wakimizufu/MC2/debugVCFSeparate/VCF_CV_antilog_1.png

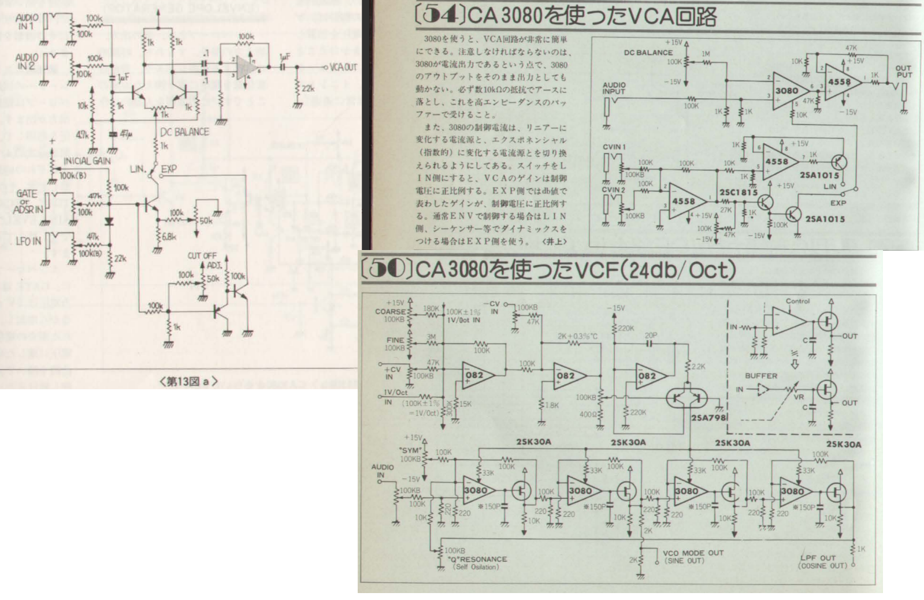
debugVCFSeparate/VCF_CV_antilog_1.png
