wakimizufu/MC2/EG_MC2.X/pinout.png

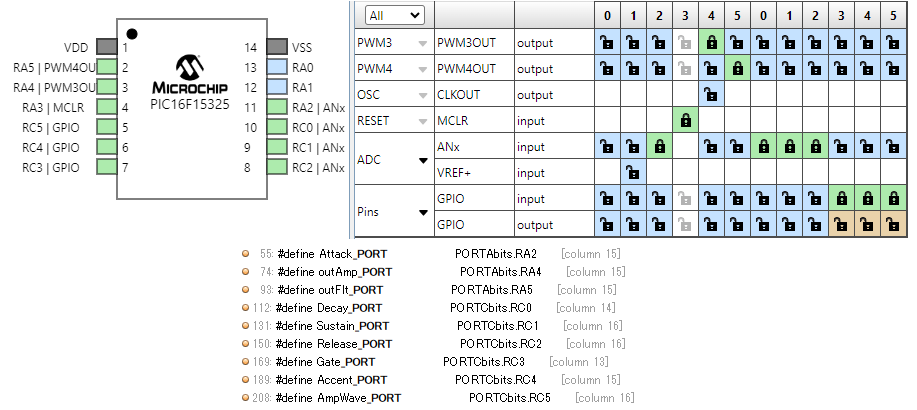
EG_MC2.X/pinout.png
