wakimizufu/MC2/LFO_MC2.X/pinout.png

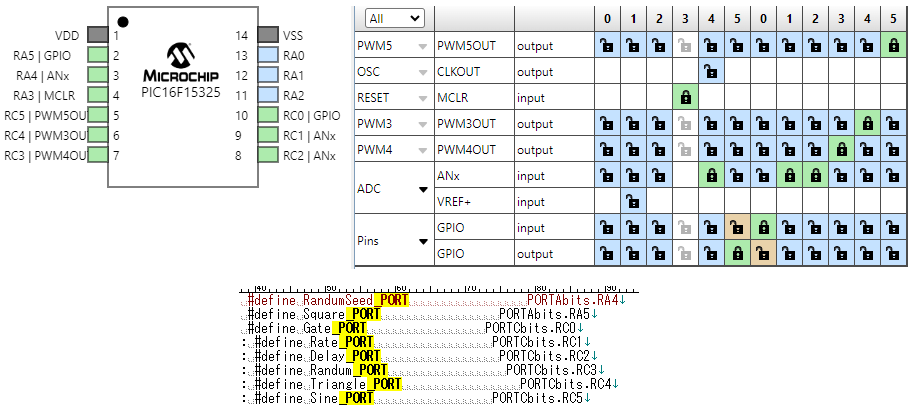
LFO_MC2.X/pinout.png
