wakimizufu/MC2/SynthBoard_Left/production/PCBAList.png

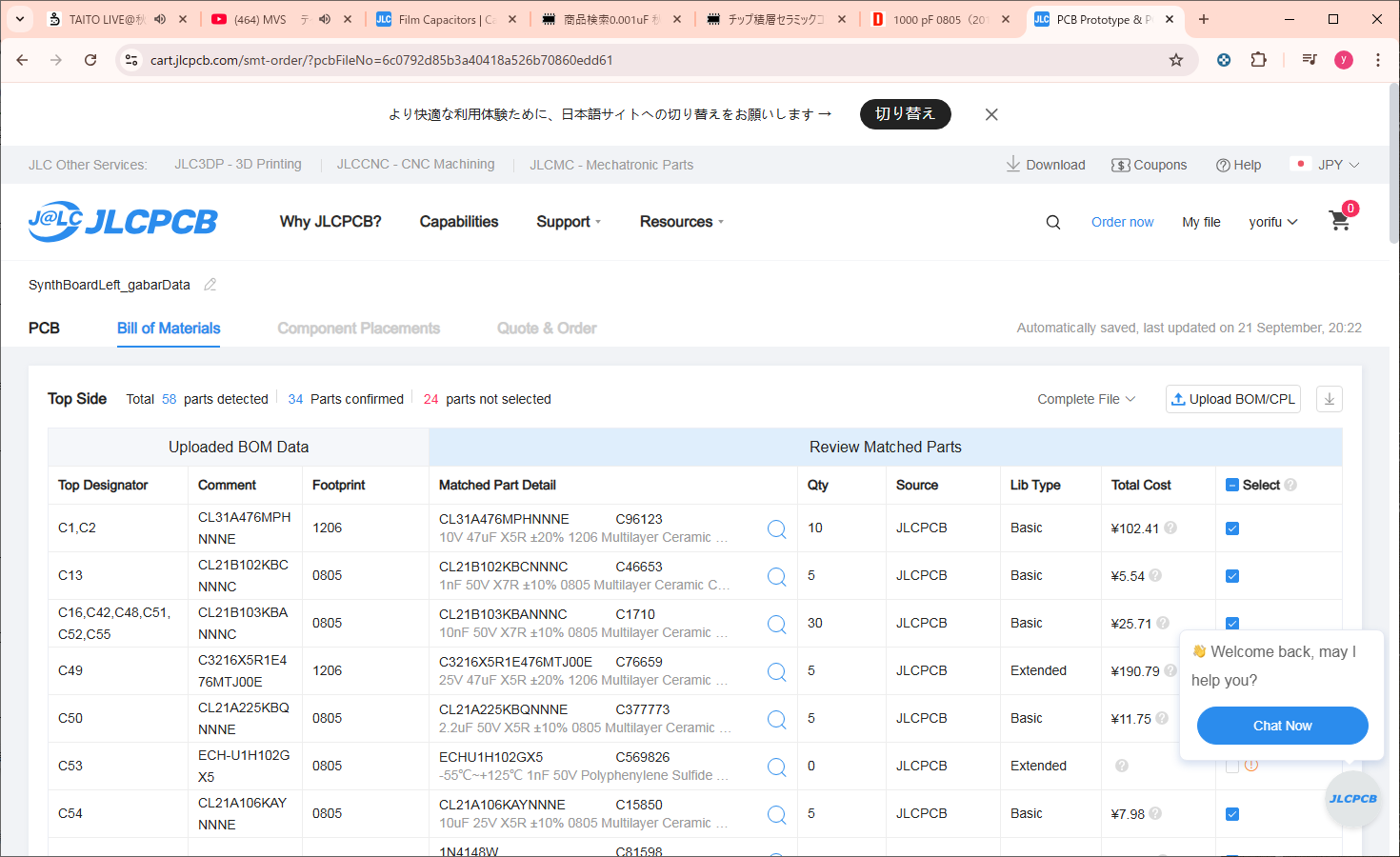
SynthBoard_Left/production/PCBAList.png
