wakimizufu/MC2/SynthBoard_Left/production/拡張部品リストアップ_20250921.txt

----------------------------------------------------------------------------
C49
C3216X5R1E476MTJ00E
1206
C3216X5R1E476MTJ00E
C76659
25V 47uF X5R ±20% 1206 Multilayer Ceramic Capacitors MLCC - SMD/SMT ROHS
5
JLCPCB
Extended
¥190.79 

----------------------------------------------------------------------------
C53
ECH-U1H102GX5
0805
ECHU1H102GX5
C569826
-55℃~+125℃ 1nF 50V Polyphenylene Sulfide (PPS) ±2% 0805 Film Capacitors ROHS
0
JLCPCB
Extended

----------------------------------------------------------------------------
C17,C18,C19
GRM21B5C2E103FWAA
0805
No Part Selected
Search 
Pre-order

----------------------------------------------------------------------------
IC4,IC6
AS321KTR-G1
SOT95P282X145-5N
AS321KTR-G1
C144156
-18V~-1.5V -40℃~+85℃ 1 20nA 2mV 30nA 350uA 36V 3V~36V 40mA 70dB 7uV/℃ SOT-23-5 Operational Amplifier ROHS
14
JLCPCB
拡張
$0.9268 

----------------------------------------------------------------------------
IC7
HEF4013BT,653
SOIC-14_3.9x8.7mm_P1.27mm
HEF4013BT,653
C6726
-40℃~+125℃ 1 2 3.4mA 3.4mA 3V~15V 4000B Series 40MHz 4uA 60ns@15V,50pF 7.5pF Asynchronous Complementary D-Type Rising Edge Set and Reset SOIC-14 Flip Flops ROHS
5
JLCPCB
拡張
$0.6625 

----------------------------------------------------------------------------
U1
TJM4558CDT
SOIC-8_3.9x4.9mm_P1.27mm
TJM4558CDT
C6955
-15V~15V 0℃~+70℃ 12nV/√Hz@1kHz 1mV 2 2.2V/us 2.3mA 20mA 20nA 30V 5.5MHz 50nA 90dB SOIC-8 Operational Amplifier ROHS
5
JLCPCB
拡張
¥53.65 

----------------------------------------------------------------------------
VR20,VR21
3362P-1-503LF
3362P_1
3362P-1-503LF
C81264
1 500mW 50kΩ ±10% ±100ppm/℃ Plugin-3P,7x6.6mm Potentiometers, Variable Resistors ROHS
10
JLCPCB
拡張
¥492.12 

----------------------------------------------------------------------------
VR27
3362P-1-501LF
3362P_1
3362P-1-501LF
C81262
1 500mW 500Ω ±10% ±100ppm/℃ Plugin-3P,7x6.6mm Potentiometers, Variable Resistors ROHS
5
JLCPCB
拡張
¥297.04 

----------------------------------------------------------------------------
D2
LED
LED_D5.0mm_FlatTop
部品選択なし
検索 
予約発注

----------------------------------------------------------------------------
IC5
V3340M
SOP-16_3.9x9.9mm_P1.27mm
部品選択なし
検索 
予約発注
J1
DigiInput
PinSocket_1x05_P2.54mm_Vertical
部品選択なし
検索 
予約発注

----------------------------------------------------------------------------
J2
ICSPLFO
PinHeader_1x05_P2.54mm_Vertical
部品選択なし
検索 
予約発注

----------------------------------------------------------------------------
J3
D_Power
PinSocket_1x02_P2.54mm_Vertical
部品選択なし
検索 
予約発注

----------------------------------------------------------------------------
J4
VCOOut
PinSocket_2x07_P2.54mm_Vertical
部品選択なし
検索 
予約発注

----------------------------------------------------------------------------
J6
A_Power
PinHeader_1x06_P2.54mm_Vertical
部品選択なし
検索 
予約発注

----------------------------------------------------------------------------
J7
LFO
PinSocket_2x03_P2.54mm_Vertical
部品選択なし
検索 
予約発注

----------------------------------------------------------------------------
R25
390K
R_Axial_DIN0207_L6.3mm_D2.5mm_P7.62mm_Horizontal
部品選択なし
検索 
予約発注

----------------------------------------------------------------------------
R186,R187
470K
R_Axial_DIN0207_L6.3mm_D2.5mm_P7.62mm_Horizontal
部品選択なし
検索 
予約発注

----------------------------------------------------------------------------
R188
1M
R_Axial_DIN0207_L6.3mm_D2.5mm_P7.62mm_Horizontal
部品選択なし
検索 
予約発注

----------------------------------------------------------------------------
S1,S2
MS2301L6
MS2301L6
部品選択なし
検索 
予約発注

----------------------------------------------------------------------------
SW1
MFP_2424
MFP2424
部品選択なし
検索 
予約発注

----------------------------------------------------------------------------
U7
MCP6234T-E/SL
SOIC-14_3.9x8.7mm_P1.27mm
部品選択なし
検索 
予約発注

----------------------------------------------------------------------------
VR1
Tune10KB
RK09D117000B
部品選択なし
検索 
予約発注

----------------------------------------------------------------------------
VR2
PWMDuty10KB
PTA20432010CIB104
部品選択なし
検索 
予約発注

----------------------------------------------------------------------------
VR3
Triangle100KB
PTA20432010CIB104
部品選択なし
検索 
予約発注

----------------------------------------------------------------------------
VR4
Rate100KB
PTA20432010CIB104
部品選択なし
検索 
予約発注

----------------------------------------------------------------------------
VR5
Delay100KB
PTA20432010CIB104
部品選択なし
検索 
予約発注

----------------------------------------------------------------------------
VR6
Saw100KB
PTA20432010CIB104
部品選択なし
検索 
予約発注

----------------------------------------------------------------------------
VR7
Mod100KA
PTA20432010CIB104
部品選択なし
検索 
予約発注

----------------------------------------------------------------------------
VR8
SubSquare10KB
PTA20432010CIB104
部品選択なし
検索 
予約発注

----------------------------------------------------------------------------
VR9
Square10KB
PTA20432010CIB104
部品選択なし
検索 
予約発注
