wakimizufu/MC2/SynthBoard_Right/production/拡張部品リストアップ_20250921.txt

--------------------------------------------------------------------------------
C10,C11,C4,C8
ECH-U1H221JX5
0805
ECHU1H221JX5
C178426
-55℃~+125℃ 220pF 50V Metallized PPS ±5% 0805 Film Capacitors ROHS
0
JLCPCB
拡張

--------------------------------------------------------------------------------
IC1,IC2
AS321KTR-G1
SOT95P282X145-5N
AS321KTR-G1
C144156
-18V~-1.5V -40℃~+85℃ 1 20nA 2mV 30nA 350uA 36V 3V~36V 40mA 70dB 7uV/℃ SOT-23-5 Operational Amplifier ROHS
14
JLCPCB
拡張
¥137.12

--------------------------------------------------------------------------------
U2,U5,U8
LM13700
SOIC-16_3.9x9.9mm_P1.27mm
LM13700MX/NOPB
C174050
0℃~+70℃ 100nA 110dB 2 20mA 300uA 36V 4.75V~16V 400nA 400uV 50V/us 9.5V~32V SOIC-16 Operational Amplifier ROHS
0
JLCPCB
拡張

--------------------------------------------------------------------------------
VR10
3362P-1-503LF
3362P_1
3362P-1-503LF
C81264
1 500mW 50kΩ ±10% ±100ppm/℃ Plugin-3P,7x6.6mm Potentiometers, Variable Resistors ROHS
5
JLCPCB
拡張
¥299.60 

--------------------------------------------------------------------------------
VR16,VR17
3362P-1-103LF
3362P_1
3362P-1-103LF
C58159
1 10kΩ 500mW ±10% ±100ppm/℃ Plugin-3P,7x6.6mm Potentiometers, Variable Resistors ROHS
10
JLCPCB
拡張
¥395.03 

--------------------------------------------------------------------------------
VR19
3362P-1-104LF
3362P_1
3362P-1-104LF
C81266
1 100kΩ 500mW ±10% ±100ppm/℃ Plugin-3P,7x6.6mm Potentiometers, Variable Resistors ROHS
5
JLCPCB
拡張
¥291.83 

--------------------------------------------------------------------------------
U9
MCP6232-E_P
SOIC-8_3.9x4.9mm_P1.27mm
MCP6232-E/P
C640423
-40℃~+125℃ 1.8V~6V 150V/ms 1pA 2 3uV/℃ 52nV/√Hz@1kHz 5mV 75dB 7V PDIP-8 Operational Amplifier ROHS
5
拡張

--------------------------------------------------------------------------------
Q2,Q3,Q4,Q5
2SA1162-GR_F_
1SS294LFT
部品選択なし
検索 
予約発注

--------------------------------------------------------------------------------
S3
MS2201L6
MS2201L6
部品選択なし
検索 
予約発注

--------------------------------------------------------------------------------
VR11
Mod100KA
PTA20432010CIB104
部品選択なし
検索 
予約発注

--------------------------------------------------------------------------------
VR12
KYBD100KB
PTA20432010CIB104
部品選択なし
検索 
予約発注

--------------------------------------------------------------------------------
VR13
Env100KB
PTA20432010CIB104
部品選択なし
検索 
予約発注

--------------------------------------------------------------------------------
VR14
Volume100KA
RK09D117000B
部品選択なし
検索 
予約発注

--------------------------------------------------------------------------------
VR15
Freq100KB
PTA20432010CIB104
部品選択なし
検索 
予約発注

--------------------------------------------------------------------------------
VR18
Resonance100KB
PTA20432010CIB104
部品選択なし
検索 
予約発注

--------------------------------------------------------------------------------
VR22
AccLevel10KB
RK09D117000B
部品選択なし
検索 
予約発注

--------------------------------------------------------------------------------
VR23
Attack100KA
PTA20432010CIB104
部品選択なし
検索 
予約発注

--------------------------------------------------------------------------------
VR24
Decay100KA
PTA20432010CIB104
部品選択なし
検索 
予約発注

--------------------------------------------------------------------------------
VR25
Sustain100KB
PTA20432010CIB104
部品選択なし
検索 
予約発注

--------------------------------------------------------------------------------
VR26
Release100KA
PTA20432010CIB104
部品選択なし
検索 
予約発注
