wakimizufu/MC2/SynthBoard_Left/production/拡張部品リストアップ_20250920.txt

----------------------------------------------------------------------------
C1,C2
EMK316BBJ476ML-T
1206
EMK316BBJ476ML-T
C385907
16V 47uF X5R �}20% 1206 Multilayer Ceramic Capacitors MLCC - SMD/SMT ROHS
12
JLCPCB
Šg’£
$1.5684 

----------------------------------------------------------------------------
C13,C53
CL21C102JBCNNNC
0805
CL21C102JBCNNNC
C1791
1nF 50V C0G �}5% 0805 Multilayer Ceramic Capacitors MLCC - SMD/SMT ROHS
20
JLCPCB
Šg’£
$0.1600 

----------------------------------------------------------------------------
C16,C17,C18,C19,C42,C48,C51,C52,C55
0805B103J500NT
0805
0805B103J500NT
C24666
10nF 50V X7R �}5% 0805 Multilayer Ceramic Capacitors MLCC - SMD/SMT ROHS
55
JLCPCB
Šg’£
$0.4235 
C49
C3216X5R1E476MTJ00E
1206
C3216X5R1E476MTJ00E
C76659
25V 47uF X5R �}20% 1206 Multilayer Ceramic Capacitors MLCC - SMD/SMT ROHS
5
JLCPCB
Šg’£
$1.2910 

----------------------------------------------------------------------------
C50
CL21B225KAFNNNE
0805
CL21B225KAFNNNE
C19110
2.2uF 25V X7R �}10% 0805 Multilayer Ceramic Capacitors MLCC - SMD/SMT ROHS
20
JLCPCB
Šg’£
$0.2440

----------------------------------------------------------------------------
IC4,IC6
AS321KTR-G1
SOT95P282X145-5N
AS321KTR-G1
C144156
-18V~-1.5V -40�Ž~+85�Ž 1 20nA 2mV 30nA 350uA 36V 3V~36V 40mA 70dB 7uV/�Ž SOT-23-5 Operational Amplifier ROHS
14
JLCPCB
Šg’£
$0.9268 

----------------------------------------------------------------------------
IC7
HEF4013BT,653
SOIC-14_3.9x8.7mm_P1.27mm
HEF4013BT,653
C6726
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
U1
TJM4558CDT
SOIC-8_3.9x4.9mm_P1.27mm
TJM4558CDT
C6955
-15V~15V 0�Ž~+70�Ž 12nV/�ãHz@1kHz 1mV 2 2.2V/us 2.3mA 20mA 20nA 30V 5.5MHz 50nA 90dB SOIC-8 Operational Amplifier ROHS
5
JLCPCB
Šg’£
$0.3630 
----------------------------------------------------------------------------
