wakimizufu/MC2/SynthBoard_Left/production/cart.jlcpcb.com_smt-order__pcbFileNo=6c0792d85b3a40418a526b70860edd61.png

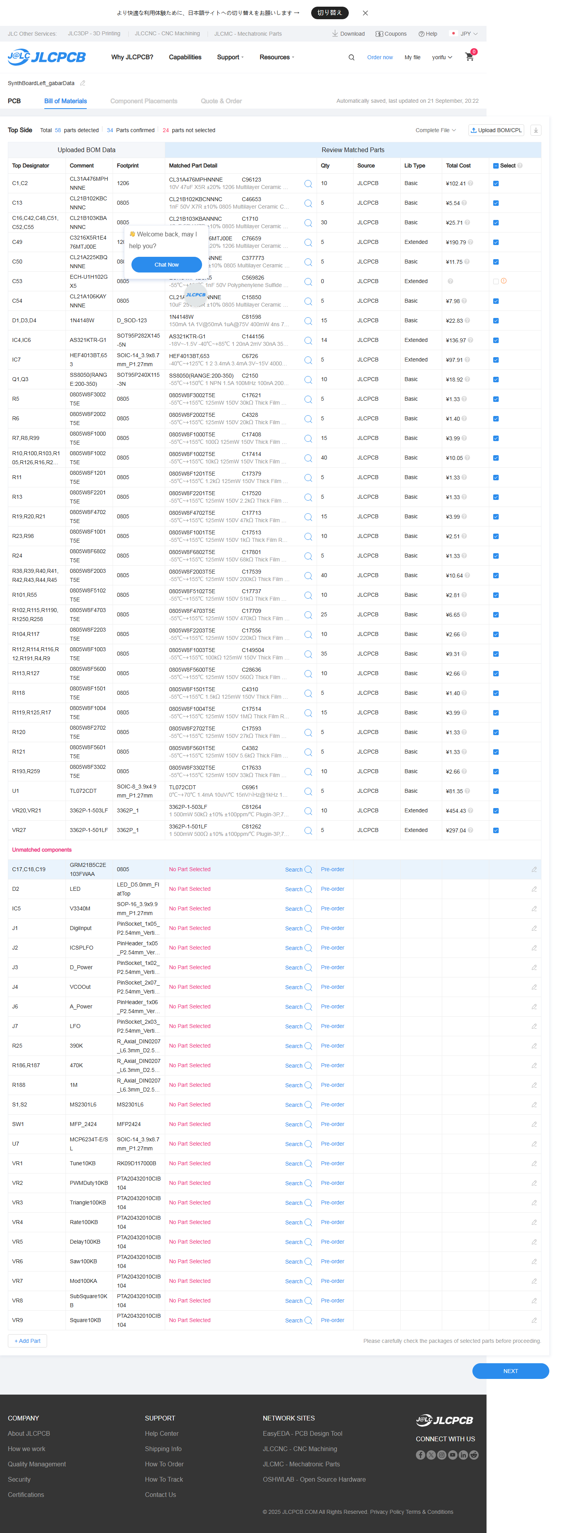
SynthBoard_Left/production/cart.jlcpcb.com_smt-order__pcbFileNo=6c0792d85b3a40418a526b70860edd61.png
