wakimizufu/MC2/SynthBoard_Right/production/cart.jlcpcb.com_jp_smt-order__pcbFileNo=1719c2208b6c4ed196fbf762d8c76614.png

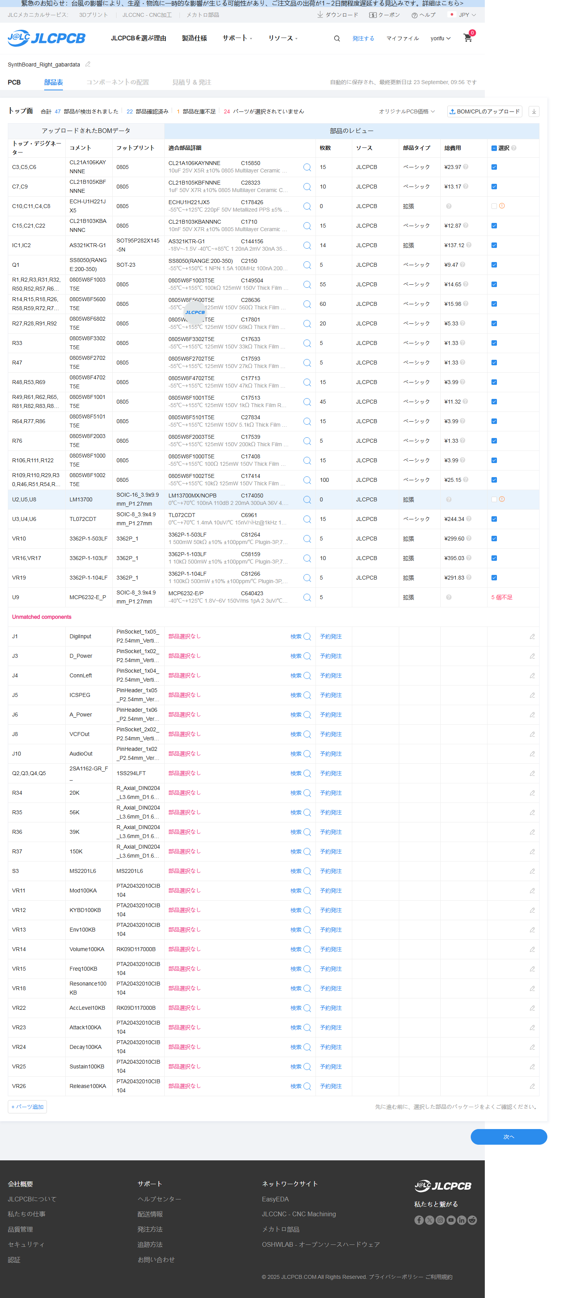
SynthBoard_Right/production/cart.jlcpcb.com_jp_smt-order__pcbFileNo=1719c2208b6c4ed196fbf762d8c76614.png
