wakimizufu/MC2/EGACC_MC2.X/queuelogs/debugtool.txt

2156 1759402637052 XXXX 1759402637052, Thread 2156: XXXX 1759402637052, Exiting Thread 2156: Commands::runScriptBasic  
2156 1759402637153 XXXX 1759402637153, Thread 2156: XXXX 1759402637153, Entering Thread 2156: Commands::runScriptBasic, script name = GetHaltStatus, timeOut = -1 ms  
2156 1759402637153 XXXX 1759402637153, Thread 2156: XXXX 1759402637153, Exiting Thread 2156: Commands::runScriptBasic  
2156 1759402637254 XXXX 1759402637254, Thread 2156: XXXX 1759402637254, Entering Thread 2156: Commands::runScriptBasic, script name = GetHaltStatus, timeOut = -1 ms  
2156 1759402637255 XXXX 1759402637255, Thread 2156: XXXX 1759402637255, Exiting Thread 2156: Commands::runScriptBasic  
2156 1759402637355 XXXX 1759402637355, Thread 2156: XXXX 1759402637355, Entering Thread 2156: Commands::runScriptBasic, script name = GetHaltStatus, timeOut = -1 ms  
2156 1759402637356 XXXX 1759402637356, Thread 2156: XXXX 1759402637356, Exiting Thread 2156: Commands::runScriptBasic  
2156 1759402637456 XXXX 1759402637456, Thread 2156: XXXX 1759402637456, Entering Thread 2156: Commands::runScriptBasic, script name = GetHaltStatus, timeOut = -1 ms  
2156 1759402637458 XXXX 1759402637458, Thread 2156: XXXX 1759402637458, Exiting Thread 2156: Commands::runScriptBasic  
2156 1759402637556 XXXX 1759402637556, Thread 2156: XXXX 1759402637556, Entering Thread 2156: Commands::runScriptBasic, script name = GetHaltStatus, timeOut = -1 ms  
2156 1759402637557 XXXX 1759402637557, Thread 2156: XXXX 1759402637557, Exiting Thread 2156: Commands::runScriptBasic  
2156 1759402637657 XXXX 1759402637657, Thread 2156: XXXX 1759402637657, Entering Thread 2156: Commands::runScriptBasic, script name = GetHaltStatus, timeOut = -1 ms  
2156 1759402637658 XXXX 1759402637658, Thread 2156: XXXX 1759402637658, Exiting Thread 2156: Commands::runScriptBasic  
2156 1759402637758 XXXX 1759402637758, Thread 2156: XXXX 1759402637758, Entering Thread 2156: Commands::runScriptBasic, script name = GetHaltStatus, timeOut = -1 ms  
2156 1759402637759 XXXX 1759402637759, Thread 2156: XXXX 1759402637759, Exiting Thread 2156: Commands::runScriptBasic  

2156 1759402637797 GEN4_TO_CONTROLLER_LOG:GEN4_DEBUG_INT_LOG_PIC16F13145 Pre:HaltTarget
2156 1759402637797 GEN4_TO_CONTROLLER_LOG:GEN4_DEBUG_INT_LOG_PIC16F13145 Payload
2156 1759402637797 GEN4_TO_CONTROLLER_LOG:GEN4_DEBUG_INT_LOG_PIC16F13145 null
2156 1759402637797 GEN4_TO_CONTROLLER_LOG:GEN4_DEBUG_INT_LOG_PIC16F13145 Payload End
2156 1759402637797 XXXX 1759402637797, Thread 2156: XXXX 1759402637797, Entering Thread 2156: Commands::runScriptBasic, script name = Halt, timeOut = -1 ms  
2156 1759402637898 XXXX 1759402637898, Thread 2156: XXXX 1759402637898, Exiting Thread 2156: Commands::runScriptBasic  
2156 1759402637898 GEN4_TO_CONTROLLER_LOG:GEN4_DEBUG_INT_LOG_PIC16F13145 Post:HaltTarget
2156 1759402637898 GEN4_TO_CONTROLLER_LOG:GEN4_DEBUG_INT_LOG_PIC16F13145 Return Value
2156 1759402637898 GEN4_TO_CONTROLLER_LOG:GEN4_DEBUG_INT_LOG_PIC16F13145 true
2156 1759402637898 GEN4_TO_CONTROLLER_LOG:GEN4_DEBUG_INT_LOG_PIC16F13145 Return End
2156 1759402637898 XXXX 1759402637898, Thread 2156: XXXX 1759402637898, Entering Thread 2156: Commands::runScriptBasic, script name = GetHaltStatus, timeOut = -1 ms  
2156 1759402637900 XXXX 1759402637900, Thread 2156: XXXX 1759402637900, Exiting Thread 2156: Commands::runScriptBasic  

2156 1759402637901 GEN4_TO_CONTROLLER_LOG:GEN4_DEBUG_INT_LOG_PIC16F13145 Pre:DebugReadTargetMemory
2156 1759402637901 GEN4_TO_CONTROLLER_LOG:GEN4_DEBUG_INT_LOG_PIC16F13145 Payload
2156 1759402637901 GEN4_TO_CONTROLLER_LOG:GEN4_DEBUG_INT_LOG_PIC16F13145 Emulation
2156 1759402637901 GEN4_TO_CONTROLLER_LOG:GEN4_DEBUG_INT_LOG_PIC16F13145 1f91
2156 1759402637901 GEN4_TO_CONTROLLER_LOG:GEN4_DEBUG_INT_LOG_PIC16F13145 1f91
2156 1759402637901 GEN4_TO_CONTROLLER_LOG:GEN4_DEBUG_INT_LOG_PIC16F13145 Length = 4
2156 1759402637901 GEN4_TO_CONTROLLER_LOG:GEN4_DEBUG_INT_LOG_PIC16F13145 Payload End
2156 1759402637902 XXXX 1759402637902, Thread 2156: XXXX 1759402637902, Entering Thread 2156: Commands::runScriptWithUpload, script name = ReadRAM  
2156 1759402637902 XXXX 1759402637902, Thread 2156: XXXX 1759402637902, Entering Thread 2156: ToolCommUsb::readTransfer, sideData is 0x25 bytes long, transferDataLength is 0x4 bytes long  
2156 1759402637905 XXXX 1759402637905, Thread 2156: XXXX 1759402637905, Exiting Thread 2156: ToolCommUsb::readTransfer,  cr.status = 0x0  
2156 1759402637905 XXXX 1759402637905, Thread 2156: XXXX 1759402637905, Exiting Thread 2156: Commands::runScriptWithUpload  
2156 1759402637905 GEN4_TO_CONTROLLER_LOG:GEN4_DEBUG_INT_LOG_PIC16F13145 Post:DebugReadTargetMemory
2156 1759402637905 GEN4_TO_CONTROLLER_LOG:GEN4_DEBUG_INT_LOG_PIC16F13145 Return Value
2156 1759402637905 GEN4_TO_CONTROLLER_LOG:GEN4_DEBUG_INT_LOG_PIC16F13145 true
2156 1759402637905 GEN4_TO_CONTROLLER_LOG:GEN4_DEBUG_INT_LOG_PIC16F13145 Return End

2156 1759402637906 GEN4_TO_CONTROLLER_LOG:GEN4_DEBUG_INT_LOG_PIC16F13145 Pre:GetPC
2156 1759402637906 GEN4_TO_CONTROLLER_LOG:GEN4_DEBUG_INT_LOG_PIC16F13145 Payload
2156 1759402637906 GEN4_TO_CONTROLLER_LOG:GEN4_DEBUG_INT_LOG_PIC16F13145 null
2156 1759402637906 GEN4_TO_CONTROLLER_LOG:GEN4_DEBUG_INT_LOG_PIC16F13145 Payload End
2156 1759402637906 XXXX 1759402637906, Thread 2156: XXXX 1759402637906, Entering Thread 2156: Commands::runScriptBasic, script name = GetPC, timeOut = -1 ms  
2156 1759402637907 XXXX 1759402637907, Thread 2156: XXXX 1759402637907, Exiting Thread 2156: Commands::runScriptBasic  
2156 1759402637907 GEN4_TO_CONTROLLER_LOG:GEN4_DEBUG_INT_LOG_PIC16F13145 Post:GetPC
2156 1759402637907 GEN4_TO_CONTROLLER_LOG:GEN4_DEBUG_INT_LOG_PIC16F13145 Return Value
2156 1759402637907 GEN4_TO_CONTROLLER_LOG:GEN4_DEBUG_INT_LOG_PIC16F13145 a8f
2156 1759402637907 GEN4_TO_CONTROLLER_LOG:GEN4_DEBUG_INT_LOG_PIC16F13145 Return End

3295 1759402637910 GEN4_TO_CONTROLLER_LOG:GEN4_DEBUG_INT_LOG_PIC16F13145 Pre:GetPC
3295 1759402637910 GEN4_TO_CONTROLLER_LOG:GEN4_DEBUG_INT_LOG_PIC16F13145 Payload
3295 1759402637910 GEN4_TO_CONTROLLER_LOG:GEN4_DEBUG_INT_LOG_PIC16F13145 null
3295 1759402637910 GEN4_TO_CONTROLLER_LOG:GEN4_DEBUG_INT_LOG_PIC16F13145 Payload End
3295 1759402637910 XXXX 1759402637910, Thread 3295: XXXX 1759402637910, Entering Thread 3295: Commands::runScriptBasic, script name = GetPC, timeOut = -1 ms  
3295 1759402637912 XXXX 1759402637912, Thread 3295: XXXX 1759402637912, Exiting Thread 3295: Commands::runScriptBasic  
3295 1759402637912 GEN4_TO_CONTROLLER_LOG:GEN4_DEBUG_INT_LOG_PIC16F13145 Post:GetPC
3295 1759402637912 GEN4_TO_CONTROLLER_LOG:GEN4_DEBUG_INT_LOG_PIC16F13145 Return Value
3295 1759402637912 GEN4_TO_CONTROLLER_LOG:GEN4_DEBUG_INT_LOG_PIC16F13145 a8f
3295 1759402637912 GEN4_TO_CONTROLLER_LOG:GEN4_DEBUG_INT_LOG_PIC16F13145 Return End

3295 1759402637928 GEN4_TO_CONTROLLER_LOG:GEN4_DEBUG_INT_LOG_PIC16F13145 Pre:DebugReadTargetMemory
3295 1759402637928 GEN4_TO_CONTROLLER_LOG:GEN4_DEBUG_INT_LOG_PIC16F13145 Payload
3295 1759402637928 GEN4_TO_CONTROLLER_LOG:GEN4_DEBUG_INT_LOG_PIC16F13145 FileRegs
3295 1759402637928 GEN4_TO_CONTROLLER_LOG:GEN4_DEBUG_INT_LOG_PIC16F13145 1fcb
3295 1759402637928 GEN4_TO_CONTROLLER_LOG:GEN4_DEBUG_INT_LOG_PIC16F13145 1fcb
3295 1759402637928 GEN4_TO_CONTROLLER_LOG:GEN4_DEBUG_INT_LOG_PIC16F13145 Length = 1
3295 1759402637928 GEN4_TO_CONTROLLER_LOG:GEN4_DEBUG_INT_LOG_PIC16F13145 Payload End
3295 1759402637928 XXXX 1759402637928, Thread 3295: XXXX 1759402637928, Entering Thread 3295: Commands::runScriptWithUpload, script name = ReadRAM  
3295 1759402637928 XXXX 1759402637928, Thread 3295: XXXX 1759402637928, Entering Thread 3295: ToolCommUsb::readTransfer, sideData is 0x25 bytes long, transferDataLength is 0x1 bytes long  
3295 1759402637933 XXXX 1759402637933, Thread 3295: XXXX 1759402637933, Exiting Thread 3295: ToolCommUsb::readTransfer,  cr.status = 0x0  
3295 1759402637933 XXXX 1759402637933, Thread 3295: XXXX 1759402637933, Exiting Thread 3295: Commands::runScriptWithUpload  
3295 1759402637933 GEN4_TO_CONTROLLER_LOG:GEN4_DEBUG_INT_LOG_PIC16F13145 Post:DebugReadTargetMemory
3295 1759402637933 GEN4_TO_CONTROLLER_LOG:GEN4_DEBUG_INT_LOG_PIC16F13145 Return Value
3295 1759402637933 GEN4_TO_CONTROLLER_LOG:GEN4_DEBUG_INT_LOG_PIC16F13145 true
3295 1759402637933 GEN4_TO_CONTROLLER_LOG:GEN4_DEBUG_INT_LOG_PIC16F13145 Return End

3295 1759402638001 GEN4_TO_CONTROLLER_LOG:GEN4_DEBUG_INT_LOG_PIC16F13145 Pre:DebugReadTargetMemory
3295 1759402638001 GEN4_TO_CONTROLLER_LOG:GEN4_DEBUG_INT_LOG_PIC16F13145 Payload
3295 1759402638001 GEN4_TO_CONTROLLER_LOG:GEN4_DEBUG_INT_LOG_PIC16F13145 FileRegs
3295 1759402638001 GEN4_TO_CONTROLLER_LOG:GEN4_DEBUG_INT_LOG_PIC16F13145 e6
3295 1759402638001 GEN4_TO_CONTROLLER_LOG:GEN4_DEBUG_INT_LOG_PIC16F13145 e7
3295 1759402638001 GEN4_TO_CONTROLLER_LOG:GEN4_DEBUG_INT_LOG_PIC16F13145 Length = 2
3295 1759402638001 GEN4_TO_CONTROLLER_LOG:GEN4_DEBUG_INT_LOG_PIC16F13145 Payload End
3295 1759402638001 XXXX 1759402638001, Thread 3295: XXXX 1759402638001, Entering Thread 3295: Commands::runScriptWithUpload, script name = ReadRAM  
3295 1759402638001 XXXX 1759402638001, Thread 3295: XXXX 1759402638001, Entering Thread 3295: ToolCommUsb::readTransfer, sideData is 0x25 bytes long, transferDataLength is 0x2 bytes long  
3295 1759402638004 XXXX 1759402638004, Thread 3295: XXXX 1759402638004, Exiting Thread 3295: ToolCommUsb::readTransfer,  cr.status = 0x0  
3295 1759402638004 XXXX 1759402638004, Thread 3295: XXXX 1759402638004, Exiting Thread 3295: Commands::runScriptWithUpload  
3295 1759402638004 GEN4_TO_CONTROLLER_LOG:GEN4_DEBUG_INT_LOG_PIC16F13145 Post:DebugReadTargetMemory
3295 1759402638004 GEN4_TO_CONTROLLER_LOG:GEN4_DEBUG_INT_LOG_PIC16F13145 Return Value
3295 1759402638004 GEN4_TO_CONTROLLER_LOG:GEN4_DEBUG_INT_LOG_PIC16F13145 true
3295 1759402638004 GEN4_TO_CONTROLLER_LOG:GEN4_DEBUG_INT_LOG_PIC16F13145 Return End

3295 1759402638005 GEN4_TO_CONTROLLER_LOG:GEN4_DEBUG_INT_LOG_PIC16F13145 Pre:DebugReadTargetMemory
3295 1759402638005 GEN4_TO_CONTROLLER_LOG:GEN4_DEBUG_INT_LOG_PIC16F13145 Payload
3295 1759402638005 GEN4_TO_CONTROLLER_LOG:GEN4_DEBUG_INT_LOG_PIC16F13145 FileRegs
3295 1759402638005 GEN4_TO_CONTROLLER_LOG:GEN4_DEBUG_INT_LOG_PIC16F13145 2096
3295 1759402638005 GEN4_TO_CONTROLLER_LOG:GEN4_DEBUG_INT_LOG_PIC16F13145 2097
3295 1759402638005 GEN4_TO_CONTROLLER_LOG:GEN4_DEBUG_INT_LOG_PIC16F13145 Length = 2
3295 1759402638005 GEN4_TO_CONTROLLER_LOG:GEN4_DEBUG_INT_LOG_PIC16F13145 Payload End
3295 1759402638005 XXXX 1759402638005, Thread 3295: XXXX 1759402638005, Entering Thread 3295: Commands::runScriptWithUpload, script name = ReadRAM  
3295 1759402638005 XXXX 1759402638005, Thread 3295: XXXX 1759402638005, Entering Thread 3295: ToolCommUsb::readTransfer, sideData is 0x25 bytes long, transferDataLength is 0x2 bytes long  
3295 1759402638008 XXXX 1759402638008, Thread 3295: XXXX 1759402638008, Exiting Thread 3295: ToolCommUsb::readTransfer,  cr.status = 0x0  
3295 1759402638008 XXXX 1759402638008, Thread 3295: XXXX 1759402638008, Exiting Thread 3295: Commands::runScriptWithUpload  
3295 1759402638008 GEN4_TO_CONTROLLER_LOG:GEN4_DEBUG_INT_LOG_PIC16F13145 Post:DebugReadTargetMemory
3295 1759402638008 GEN4_TO_CONTROLLER_LOG:GEN4_DEBUG_INT_LOG_PIC16F13145 Return Value
3295 1759402638008 GEN4_TO_CONTROLLER_LOG:GEN4_DEBUG_INT_LOG_PIC16F13145 true
3295 1759402638008 GEN4_TO_CONTROLLER_LOG:GEN4_DEBUG_INT_LOG_PIC16F13145 Return End

2888 1759402638913 GEN4_TO_CONTROLLER_LOG:GEN4_DEBUG_INT_LOG_PIC16F13145 Pre:DebugReadTargetMemory
2888 1759402638913 GEN4_TO_CONTROLLER_LOG:GEN4_DEBUG_INT_LOG_PIC16F13145 Payload
2888 1759402638913 GEN4_TO_CONTROLLER_LOG:GEN4_DEBUG_INT_LOG_PIC16F13145 FileRegs
2888 1759402638913 GEN4_TO_CONTROLLER_LOG:GEN4_DEBUG_INT_LOG_PIC16F13145 1fcf
2888 1759402638913 GEN4_TO_CONTROLLER_LOG:GEN4_DEBUG_INT_LOG_PIC16F13145 1fcf
2888 1759402638913 GEN4_TO_CONTROLLER_LOG:GEN4_DEBUG_INT_LOG_PIC16F13145 Length = 1
2888 1759402638913 GEN4_TO_CONTROLLER_LOG:GEN4_DEBUG_INT_LOG_PIC16F13145 Payload End
2888 1759402638913 XXXX 1759402638913, Thread 2888: XXXX 1759402638913, Entering Thread 2888: Commands::runScriptWithUpload, script name = ReadRAM  
2888 1759402638913 XXXX 1759402638913, Thread 2888: XXXX 1759402638913, Entering Thread 2888: ToolCommUsb::readTransfer, sideData is 0x25 bytes long, transferDataLength is 0x1 bytes long  
2888 1759402638915 XXXX 1759402638915, Thread 2888: XXXX 1759402638915, Exiting Thread 2888: ToolCommUsb::readTransfer,  cr.status = 0x0  
2888 1759402638915 XXXX 1759402638915, Thread 2888: XXXX 1759402638915, Exiting Thread 2888: Commands::runScriptWithUpload  
2888 1759402638915 GEN4_TO_CONTROLLER_LOG:GEN4_DEBUG_INT_LOG_PIC16F13145 Post:DebugReadTargetMemory
2888 1759402638915 GEN4_TO_CONTROLLER_LOG:GEN4_DEBUG_INT_LOG_PIC16F13145 Return Value
2888 1759402638915 GEN4_TO_CONTROLLER_LOG:GEN4_DEBUG_INT_LOG_PIC16F13145 true
2888 1759402638915 GEN4_TO_CONTROLLER_LOG:GEN4_DEBUG_INT_LOG_PIC16F13145 Return End

2888 1759402638916 GEN4_TO_CONTROLLER_LOG:GEN4_DEBUG_INT_LOG_PIC16F13145 Pre:DebugReadTargetMemory
2888 1759402638916 GEN4_TO_CONTROLLER_LOG:GEN4_DEBUG_INT_LOG_PIC16F13145 Payload
2888 1759402638916 GEN4_TO_CONTROLLER_LOG:GEN4_DEBUG_INT_LOG_PIC16F13145 FileRegs
2888 1759402638916 GEN4_TO_CONTROLLER_LOG:GEN4_DEBUG_INT_LOG_PIC16F13145 1fcf
2888 1759402638916 GEN4_TO_CONTROLLER_LOG:GEN4_DEBUG_INT_LOG_PIC16F13145 1fcf
2888 1759402638916 GEN4_TO_CONTROLLER_LOG:GEN4_DEBUG_INT_LOG_PIC16F13145 Length = 1
2888 1759402638916 GEN4_TO_CONTROLLER_LOG:GEN4_DEBUG_INT_LOG_PIC16F13145 Payload End
2888 1759402638916 XXXX 1759402638916, Thread 2888: XXXX 1759402638916, Entering Thread 2888: Commands::runScriptWithUpload, script name = ReadRAM  
2888 1759402638916 XXXX 1759402638916, Thread 2888: XXXX 1759402638916, Entering Thread 2888: ToolCommUsb::readTransfer, sideData is 0x25 bytes long, transferDataLength is 0x1 bytes long  
2888 1759402638918 XXXX 1759402638918, Thread 2888: XXXX 1759402638918, Exiting Thread 2888: ToolCommUsb::readTransfer,  cr.status = 0x0  
2888 1759402638918 XXXX 1759402638918, Thread 2888: XXXX 1759402638918, Exiting Thread 2888: Commands::runScriptWithUpload  
2888 1759402638918 GEN4_TO_CONTROLLER_LOG:GEN4_DEBUG_INT_LOG_PIC16F13145 Post:DebugReadTargetMemory
2888 1759402638918 GEN4_TO_CONTROLLER_LOG:GEN4_DEBUG_INT_LOG_PIC16F13145 Return Value
2888 1759402638918 GEN4_TO_CONTROLLER_LOG:GEN4_DEBUG_INT_LOG_PIC16F13145 true
2888 1759402638918 GEN4_TO_CONTROLLER_LOG:GEN4_DEBUG_INT_LOG_PIC16F13145 Return End

2888 1759402638918 GEN4_TO_CONTROLLER_LOG:GEN4_DEBUG_INT_LOG_PIC16F13145 Pre:DebugReadTargetMemory
2888 1759402638918 GEN4_TO_CONTROLLER_LOG:GEN4_DEBUG_INT_LOG_PIC16F13145 Payload
2888 1759402638918 GEN4_TO_CONTROLLER_LOG:GEN4_DEBUG_INT_LOG_PIC16F13145 FileRegs
2888 1759402638918 GEN4_TO_CONTROLLER_LOG:GEN4_DEBUG_INT_LOG_PIC16F13145 1fcb
2888 1759402638918 GEN4_TO_CONTROLLER_LOG:GEN4_DEBUG_INT_LOG_PIC16F13145 1fcb
2888 1759402638918 GEN4_TO_CONTROLLER_LOG:GEN4_DEBUG_INT_LOG_PIC16F13145 Length = 1
2888 1759402638918 GEN4_TO_CONTROLLER_LOG:GEN4_DEBUG_INT_LOG_PIC16F13145 Payload End
2888 1759402638918 XXXX 1759402638918, Thread 2888: XXXX 1759402638918, Entering Thread 2888: Commands::runScriptWithUpload, script name = ReadRAM  
2888 1759402638918 XXXX 1759402638918, Thread 2888: XXXX 1759402638918, Entering Thread 2888: ToolCommUsb::readTransfer, sideData is 0x25 bytes long, transferDataLength is 0x1 bytes long  
2888 1759402638920 XXXX 1759402638920, Thread 2888: XXXX 1759402638920, Exiting Thread 2888: ToolCommUsb::readTransfer,  cr.status = 0x0  
2888 1759402638920 XXXX 1759402638920, Thread 2888: XXXX 1759402638920, Exiting Thread 2888: Commands::runScriptWithUpload  
2888 1759402638920 GEN4_TO_CONTROLLER_LOG:GEN4_DEBUG_INT_LOG_PIC16F13145 Post:DebugReadTargetMemory
2888 1759402638920 GEN4_TO_CONTROLLER_LOG:GEN4_DEBUG_INT_LOG_PIC16F13145 Return Value
2888 1759402638920 GEN4_TO_CONTROLLER_LOG:GEN4_DEBUG_INT_LOG_PIC16F13145 true
2888 1759402638920 GEN4_TO_CONTROLLER_LOG:GEN4_DEBUG_INT_LOG_PIC16F13145 Return End

2888 1759402638920 GEN4_TO_CONTROLLER_LOG:GEN4_DEBUG_INT_LOG_PIC16F13145 Pre:DebugReadTargetMemory
2888 1759402638920 GEN4_TO_CONTROLLER_LOG:GEN4_DEBUG_INT_LOG_PIC16F13145 Payload
2888 1759402638920 GEN4_TO_CONTROLLER_LOG:GEN4_DEBUG_INT_LOG_PIC16F13145 FileRegs
2888 1759402638920 GEN4_TO_CONTROLLER_LOG:GEN4_DEBUG_INT_LOG_PIC16F13145 1fcb
2888 1759402638920 GEN4_TO_CONTROLLER_LOG:GEN4_DEBUG_INT_LOG_PIC16F13145 1fcb
2888 1759402638920 GEN4_TO_CONTROLLER_LOG:GEN4_DEBUG_INT_LOG_PIC16F13145 Length = 1
2888 1759402638920 GEN4_TO_CONTROLLER_LOG:GEN4_DEBUG_INT_LOG_PIC16F13145 Payload End
2888 1759402638921 XXXX 1759402638921, Thread 2888: XXXX 1759402638921, Entering Thread 2888: Commands::runScriptWithUpload, script name = ReadRAM  
2888 1759402638921 XXXX 1759402638921, Thread 2888: XXXX 1759402638921, Entering Thread 2888: ToolCommUsb::readTransfer, sideData is 0x25 bytes long, transferDataLength is 0x1 bytes long  
2888 1759402638924 XXXX 1759402638924, Thread 2888: XXXX 1759402638924, Exiting Thread 2888: ToolCommUsb::readTransfer,  cr.status = 0x0  
2888 1759402638924 XXXX 1759402638924, Thread 2888: XXXX 1759402638924, Exiting Thread 2888: Commands::runScriptWithUpload  
2888 1759402638924 GEN4_TO_CONTROLLER_LOG:GEN4_DEBUG_INT_LOG_PIC16F13145 Post:DebugReadTargetMemory
2888 1759402638924 GEN4_TO_CONTROLLER_LOG:GEN4_DEBUG_INT_LOG_PIC16F13145 Return Value
2888 1759402638924 GEN4_TO_CONTROLLER_LOG:GEN4_DEBUG_INT_LOG_PIC16F13145 true
2888 1759402638924 GEN4_TO_CONTROLLER_LOG:GEN4_DEBUG_INT_LOG_PIC16F13145 Return End

2888 1759402638925 GEN4_TO_CONTROLLER_LOG:GEN4_DEBUG_INT_LOG_PIC16F13145 Pre:DebugReadTargetMemory
2888 1759402638925 GEN4_TO_CONTROLLER_LOG:GEN4_DEBUG_INT_LOG_PIC16F13145 Payload
2888 1759402638925 GEN4_TO_CONTROLLER_LOG:GEN4_DEBUG_INT_LOG_PIC16F13145 FileRegs
2888 1759402638925 GEN4_TO_CONTROLLER_LOG:GEN4_DEBUG_INT_LOG_PIC16F13145 1fe3
2888 1759402638925 GEN4_TO_CONTROLLER_LOG:GEN4_DEBUG_INT_LOG_PIC16F13145 1fe3
2888 1759402638925 GEN4_TO_CONTROLLER_LOG:GEN4_DEBUG_INT_LOG_PIC16F13145 Length = 1
2888 1759402638925 GEN4_TO_CONTROLLER_LOG:GEN4_DEBUG_INT_LOG_PIC16F13145 Payload End
2888 1759402638925 XXXX 1759402638925, Thread 2888: XXXX 1759402638925, Entering Thread 2888: Commands::runScriptWithUpload, script name = ReadRAM  
2888 1759402638925 XXXX 1759402638925, Thread 2888: XXXX 1759402638925, Entering Thread 2888: ToolCommUsb::readTransfer, sideData is 0x25 bytes long, transferDataLength is 0x1 bytes long  
2888 1759402638927 XXXX 1759402638927, Thread 2888: XXXX 1759402638927, Exiting Thread 2888: ToolCommUsb::readTransfer,  cr.status = 0x0  
2888 1759402638927 XXXX 1759402638927, Thread 2888: XXXX 1759402638927, Exiting Thread 2888: Commands::runScriptWithUpload  
2888 1759402638927 GEN4_TO_CONTROLLER_LOG:GEN4_DEBUG_INT_LOG_PIC16F13145 Post:DebugReadTargetMemory
2888 1759402638927 GEN4_TO_CONTROLLER_LOG:GEN4_DEBUG_INT_LOG_PIC16F13145 Return Value
2888 1759402638927 GEN4_TO_CONTROLLER_LOG:GEN4_DEBUG_INT_LOG_PIC16F13145 true
2888 1759402638927 GEN4_TO_CONTROLLER_LOG:GEN4_DEBUG_INT_LOG_PIC16F13145 Return End

2888 1759402638928 GEN4_TO_CONTROLLER_LOG:GEN4_DEBUG_INT_LOG_PIC16F13145 Pre:DebugReadTargetMemory
2888 1759402638928 GEN4_TO_CONTROLLER_LOG:GEN4_DEBUG_INT_LOG_PIC16F13145 Payload
2888 1759402638928 GEN4_TO_CONTROLLER_LOG:GEN4_DEBUG_INT_LOG_PIC16F13145 FileRegs
2888 1759402638928 GEN4_TO_CONTROLLER_LOG:GEN4_DEBUG_INT_LOG_PIC16F13145 1fcb
2888 1759402638928 GEN4_TO_CONTROLLER_LOG:GEN4_DEBUG_INT_LOG_PIC16F13145 1fcb
2888 1759402638928 GEN4_TO_CONTROLLER_LOG:GEN4_DEBUG_INT_LOG_PIC16F13145 Length = 1
2888 1759402638928 GEN4_TO_CONTROLLER_LOG:GEN4_DEBUG_INT_LOG_PIC16F13145 Payload End
2888 1759402638928 XXXX 1759402638928, Thread 2888: XXXX 1759402638928, Entering Thread 2888: Commands::runScriptWithUpload, script name = ReadRAM  
2888 1759402638928 XXXX 1759402638928, Thread 2888: XXXX 1759402638928, Entering Thread 2888: ToolCommUsb::readTransfer, sideData is 0x25 bytes long, transferDataLength is 0x1 bytes long  
2888 1759402638930 XXXX 1759402638930, Thread 2888: XXXX 1759402638930, Exiting Thread 2888: ToolCommUsb::readTransfer,  cr.status = 0x0  
2888 1759402638930 XXXX 1759402638930, Thread 2888: XXXX 1759402638930, Exiting Thread 2888: Commands::runScriptWithUpload  
2888 1759402638930 GEN4_TO_CONTROLLER_LOG:GEN4_DEBUG_INT_LOG_PIC16F13145 Post:DebugReadTargetMemory
2888 1759402638930 GEN4_TO_CONTROLLER_LOG:GEN4_DEBUG_INT_LOG_PIC16F13145 Return Value
2888 1759402638930 GEN4_TO_CONTROLLER_LOG:GEN4_DEBUG_INT_LOG_PIC16F13145 true
2888 1759402638930 GEN4_TO_CONTROLLER_LOG:GEN4_DEBUG_INT_LOG_PIC16F13145 Return End

3531 1759402642491 GEN4_TO_CONTROLLER_LOG:GEN4_DEBUG_INT_LOG_PIC16F13145 Pre:setTraceDescriptor
3531 1759402642491 GEN4_TO_CONTROLLER_LOG:GEN4_DEBUG_INT_LOG_PIC16F13145 Payload
3531 1759402642491 GEN4_TO_CONTROLLER_LOG:GEN4_DEBUG_INT_LOG_PIC16F13145 com.microchip.mplab.libs.RI4ToolsController.DataClasses.TraceDescriptor@ad1423d
3531 1759402642491 GEN4_TO_CONTROLLER_LOG:GEN4_DEBUG_INT_LOG_PIC16F13145 Payload End
3531 1759402642491 GEN4_TO_CONTROLLER_LOG:GEN4_DEBUG_INT_LOG_PIC16F13145 Post:setTraceDescriptor
3531 1759402642491 GEN4_TO_CONTROLLER_LOG:GEN4_DEBUG_INT_LOG_PIC16F13145 Return Value
3531 1759402642491 GEN4_TO_CONTROLLER_LOG:GEN4_DEBUG_INT_LOG_PIC16F13145 none
3531 1759402642491 GEN4_TO_CONTROLLER_LOG:GEN4_DEBUG_INT_LOG_PIC16F13145 Return End

3531 1759402642491 GEN4_TO_CONTROLLER_LOG:GEN4_DEBUG_INT_LOG_PIC16F13145 Pre:DebugWriteTargetMemory
3531 1759402642491 GEN4_TO_CONTROLLER_LOG:GEN4_DEBUG_INT_LOG_PIC16F13145 Payload
3531 1759402642491 GEN4_TO_CONTROLLER_LOG:GEN4_DEBUG_INT_LOG_PIC16F13145 Emulation
3531 1759402642491 GEN4_TO_CONTROLLER_LOG:GEN4_DEBUG_INT_LOG_PIC16F13145 1f8c
3531 1759402642491 GEN4_TO_CONTROLLER_LOG:GEN4_DEBUG_INT_LOG_PIC16F13145 1fa9
3531 1759402642491 GEN4_TO_CONTROLLER_LOG:GEN4_DEBUG_INT_LOG_PIC16F13145 Length = 30
3531 1759402642491 GEN4_TO_CONTROLLER_LOG:GEN4_DEBUG_INT_LOG_PIC16F13145 Payload End
3531 1759402642491 XXXX 1759402642491, Thread 3531: XXXX 1759402642491, Entering Thread 3531: Commands::runScriptWithDownload, script name = WriteRAM  
3531 1759402642495 XXXX 1759402642495, Thread 3531: XXXX 1759402642495, Exiting Thread 3531: Commands::runScriptWithDownload(WriteRAM)  
3531 1759402642495 GEN4_TO_CONTROLLER_LOG:GEN4_DEBUG_INT_LOG_PIC16F13145 Post:DebugWriteTargetMemory
3531 1759402642495 GEN4_TO_CONTROLLER_LOG:GEN4_DEBUG_INT_LOG_PIC16F13145 Return Value
3531 1759402642495 GEN4_TO_CONTROLLER_LOG:GEN4_DEBUG_INT_LOG_PIC16F13145 true
3531 1759402642495 GEN4_TO_CONTROLLER_LOG:GEN4_DEBUG_INT_LOG_PIC16F13145 Return End

3531 1759402642495 GEN4_TO_CONTROLLER_LOG:GEN4_DEBUG_INT_LOG_PIC16F13145 Pre:SetFreezePerihperalInfo
3531 1759402642495 GEN4_TO_CONTROLLER_LOG:GEN4_DEBUG_INT_LOG_PIC16F13145 Payload
3531 1759402642495 GEN4_TO_CONTROLLER_LOG:GEN4_DEBUG_INT_LOG_PIC16F13145 BitSetInfo: Values:
3531 1759402642495 GEN4_TO_CONTROLLER_LOG:GEN4_DEBUG_INT_LOG_PIC16F13145 BitSetInfo: Address = 1f8d, Mask = 40, SetVal = 40, Type = Emulation
3531 1759402642495 GEN4_TO_CONTROLLER_LOG:GEN4_DEBUG_INT_LOG_PIC16F13145 Payload End
3531 1759402642495 XXXX 1759402642495, Thread 3531: XXXX 1759402642495, Entering Thread 3531: Commands::runScriptWithUpload, script name = ReadRAM  
3531 1759402642495 XXXX 1759402642495, Thread 3531: XXXX 1759402642495, Entering Thread 3531: ToolCommUsb::readTransfer, sideData is 0x25 bytes long, transferDataLength is 0x1 bytes long  
3531 1759402642498 XXXX 1759402642498, Thread 3531: XXXX 1759402642498, Exiting Thread 3531: ToolCommUsb::readTransfer,  cr.status = 0x0  
3531 1759402642498 XXXX 1759402642498, Thread 3531: XXXX 1759402642498, Exiting Thread 3531: Commands::runScriptWithUpload  
3531 1759402642498 XXXX 1759402642498, Thread 3531: XXXX 1759402642498, Entering Thread 3531: Commands::runScriptWithDownload, script name = WriteRAM  
3531 1759402642501 XXXX 1759402642501, Thread 3531: XXXX 1759402642501, Exiting Thread 3531: Commands::runScriptWithDownload(WriteRAM)  
3531 1759402642501 GEN4_TO_CONTROLLER_LOG:GEN4_DEBUG_INT_LOG_PIC16F13145 Post:SetFreezePerihperalInfo
3531 1759402642501 GEN4_TO_CONTROLLER_LOG:GEN4_DEBUG_INT_LOG_PIC16F13145 Return Value
3531 1759402642501 GEN4_TO_CONTROLLER_LOG:GEN4_DEBUG_INT_LOG_PIC16F13145 none
3531 1759402642501 GEN4_TO_CONTROLLER_LOG:GEN4_DEBUG_INT_LOG_PIC16F13145 Return End

3531 1759402642501 GEN4_TO_CONTROLLER_LOG:GEN4_DEBUG_INT_LOG_PIC16F13145 Pre:GetPC
3531 1759402642501 GEN4_TO_CONTROLLER_LOG:GEN4_DEBUG_INT_LOG_PIC16F13145 Payload
3531 1759402642501 GEN4_TO_CONTROLLER_LOG:GEN4_DEBUG_INT_LOG_PIC16F13145 null
3531 1759402642501 GEN4_TO_CONTROLLER_LOG:GEN4_DEBUG_INT_LOG_PIC16F13145 Payload End
3531 1759402642501 XXXX 1759402642501, Thread 3531: XXXX 1759402642501, Entering Thread 3531: Commands::runScriptBasic, script name = GetPC, timeOut = -1 ms  
3531 1759402642502 XXXX 1759402642502, Thread 3531: XXXX 1759402642502, Exiting Thread 3531: Commands::runScriptBasic  
3531 1759402642502 GEN4_TO_CONTROLLER_LOG:GEN4_DEBUG_INT_LOG_PIC16F13145 Post:GetPC
3531 1759402642502 GEN4_TO_CONTROLLER_LOG:GEN4_DEBUG_INT_LOG_PIC16F13145 Return Value
3531 1759402642502 GEN4_TO_CONTROLLER_LOG:GEN4_DEBUG_INT_LOG_PIC16F13145 a8f
3531 1759402642502 GEN4_TO_CONTROLLER_LOG:GEN4_DEBUG_INT_LOG_PIC16F13145 Return End

3531 1759402642503 GEN4_TO_CONTROLLER_LOG:GEN4_DEBUG_INT_LOG_PIC16F13145 Pre:RunTarget
3531 1759402642503 GEN4_TO_CONTROLLER_LOG:GEN4_DEBUG_INT_LOG_PIC16F13145 Payload
3531 1759402642503 GEN4_TO_CONTROLLER_LOG:GEN4_DEBUG_INT_LOG_PIC16F13145 com.microchip.mplab.mdbcore.RI4Tool.DebugHandler@7b980544
3531 1759402642503 GEN4_TO_CONTROLLER_LOG:GEN4_DEBUG_INT_LOG_PIC16F13145 Payload End
3531 1759402642503 XXXX 1759402642503, Thread 3531: XXXX 1759402642503, Entering Thread 3531: Commands::runScriptBasic, script name = Run, timeOut = -1 ms  
3531 1759402642504 XXXX 1759402642504, Thread 3531: XXXX 1759402642504, Exiting Thread 3531: Commands::runScriptBasic  
3531 1759402642504 GEN4_TO_CONTROLLER_LOG:GEN4_DEBUG_INT_LOG_PIC16F13145 Post:RunTarget
3531 1759402642504 GEN4_TO_CONTROLLER_LOG:GEN4_DEBUG_INT_LOG_PIC16F13145 Return Value
3531 1759402642504 GEN4_TO_CONTROLLER_LOG:GEN4_DEBUG_INT_LOG_PIC16F13145 true
3531 1759402642504 GEN4_TO_CONTROLLER_LOG:GEN4_DEBUG_INT_LOG_PIC16F13145 Return End
3531 1759402642760 XXXX 1759402642760, Thread 3531: XXXX 1759402642760, Entering Thread 3531: Commands::runScriptBasic, script name = GetHaltStatus, timeOut = -1 ms  
3531 1759402642760 XXXX 1759402642760, Thread 3531: XXXX 1759402642760, Exiting Thread 3531: Commands::runScriptBasic  
3531 1759402642860 XXXX 1759402642860, Thread 3531: XXXX 1759402642860, Entering Thread 3531: Commands::runScriptBasic, script name = GetHaltStatus, timeOut = -1 ms  
3531 1759402642860 XXXX 1759402642860, Thread 3531: XXXX 1759402642860, Exiting Thread 3531: Commands::runScriptBasic  
3531 1759402642961 XXXX 1759402642961, Thread 3531: XXXX 1759402642961, Entering Thread 3531: Commands::runScriptBasic, script name = GetHaltStatus, timeOut = -1 ms  
3531 1759402642961 XXXX 1759402642961, Thread 3531: XXXX 1759402642961, Exiting Thread 3531: Commands::runScriptBasic  
3531 1759402643061 XXXX 1759402643061, Thread 3531: XXXX 1759402643061, Entering Thread 3531: Commands::runScriptBasic, script name = GetHaltStatus, timeOut = -1 ms  
3531 1759402643062 XXXX 1759402643062, Thread 3531: XXXX 1759402643062, Exiting Thread 3531: Commands::runScriptBasic  
3531 1759402643163 XXXX 1759402643163, Thread 3531: XXXX 1759402643163, Entering Thread 3531: Commands::runScriptBasic, script name = GetHaltStatus, timeOut = -1 ms  
3531 1759402643164 XXXX 1759402643164, Thread 3531: XXXX 1759402643164, Exiting Thread 3531: Commands::runScriptBasic  
3531 1759402643263 XXXX 1759402643263, Thread 3531: XXXX 1759402643263, Entering Thread 3531: Commands::runScriptBasic, script name = GetHaltStatus, timeOut = -1 ms  
3531 1759402643265 XXXX 1759402643265, Thread 3531: XXXX 1759402643265, Exiting Thread 3531: Commands::runScriptBasic  
3531 1759402643363 XXXX 1759402643363, Thread 3531: XXXX 1759402643363, Entering Thread 3531: Commands::runScriptBasic, script name = GetHaltStatus, timeOut = -1 ms  
3531 1759402643364 XXXX 1759402643364, Thread 3531: XXXX 1759402643364, Exiting Thread 3531: Commands::runScriptBasic  
3531 1759402643463 XXXX 1759402643463, Thread 3531: XXXX 1759402643463, Entering Thread 3531: Commands::runScriptBasic, script name = GetHaltStatus, timeOut = -1 ms  
3531 1759402643464 XXXX 1759402643464, Thread 3531: XXXX 1759402643464, Exiting Thread 3531: Commands::runScriptBasic  
3531 1759402643563 XXXX 1759402643563, Thread 3531: XXXX 1759402643563, Entering Thread 3531: Commands::runScriptBasic, script name = GetHaltStatus, timeOut = -1 ms  
3531 1759402643565 XXXX 1759402643565, Thread 3531: XXXX 1759402643565, Exiting Thread 3531: Commands::runScriptBasic  
3531 1759402643663 XXXX 1759402643663, Thread 3531: XXXX 1759402643663, Entering Thread 3531: Commands::runScriptBasic, script name = GetHaltStatus, timeOut = -1 ms  
3531 1759402643664 XXXX 1759402643664, Thread 3531: XXXX 1759402643664, Exiting Thread 3531: Commands::runScriptBasic  
3531 1759402643764 XXXX 1759402643764, Thread 3531: XXXX 1759402643764, Entering Thread 3531: Commands::runScriptBasic, script name = GetHaltStatus, timeOut = -1 ms  
3531 1759402643766 XXXX 1759402643766, Thread 3531: XXXX 1759402643766, Exiting Thread 3531: Commands::runScriptBasic  
3531 1759402643864 XXXX 1759402643864, Thread 3531: XXXX 1759402643864, Entering Thread 3531: Commands::runScriptBasic, script name = GetHaltStatus, timeOut = -1 ms  
3531 1759402643865 XXXX 1759402643865, Thread 3531: XXXX 1759402643865, Exiting Thread 3531: Commands::runScriptBasic  
3531 1759402643964 XXXX 1759402643964, Thread 3531: XXXX 1759402643964, Entering Thread 3531: Commands::runScriptBasic, script name = GetHaltStatus, timeOut = -1 ms  
3531 1759402643965 XXXX 1759402643965, Thread 3531: XXXX 1759402643965, Exiting Thread 3531: Commands::runScriptBasic  
3531 1759402644065 XXXX 1759402644065, Thread 3531: XXXX 1759402644065, Entering Thread 3531: Commands::runScriptBasic, script name = GetHaltStatus, timeOut = -1 ms  
3531 1759402644067 XXXX 1759402644067, Thread 3531: XXXX 1759402644067, Exiting Thread 3531: Commands::runScriptBasic  
3531 1759402644165 XXXX 1759402644165, Thread 3531: XXXX 1759402644165, Entering Thread 3531: Commands::runScriptBasic, script name = GetHaltStatus, timeOut = -1 ms  
3531 1759402644166 XXXX 1759402644166, Thread 3531: XXXX 1759402644166, Exiting Thread 3531: Commands::runScriptBasic  
3531 1759402644266 XXXX 1759402644266, Thread 3531: XXXX 1759402644266, Entering Thread 3531: Commands::runScriptBasic, script name = GetHaltStatus, timeOut = -1 ms  
3531 1759402644266 XXXX 1759402644266, Thread 3531: XXXX 1759402644266, Exiting Thread 3531: Commands::runScriptBasic  

3531 1759402644278 GEN4_TO_CONTROLLER_LOG:GEN4_DEBUG_INT_LOG_PIC16F13145 Pre:HaltTarget
3531 1759402644278 GEN4_TO_CONTROLLER_LOG:GEN4_DEBUG_INT_LOG_PIC16F13145 Payload
3531 1759402644278 GEN4_TO_CONTROLLER_LOG:GEN4_DEBUG_INT_LOG_PIC16F13145 null
3531 1759402644278 GEN4_TO_CONTROLLER_LOG:GEN4_DEBUG_INT_LOG_PIC16F13145 Payload End
3531 1759402644278 XXXX 1759402644278, Thread 3531: XXXX 1759402644278, Entering Thread 3531: Commands::runScriptBasic, script name = Halt, timeOut = -1 ms  
3531 1759402644379 XXXX 1759402644379, Thread 3531: XXXX 1759402644379, Exiting Thread 3531: Commands::runScriptBasic  
3531 1759402644379 GEN4_TO_CONTROLLER_LOG:GEN4_DEBUG_INT_LOG_PIC16F13145 Post:HaltTarget
3531 1759402644379 GEN4_TO_CONTROLLER_LOG:GEN4_DEBUG_INT_LOG_PIC16F13145 Return Value
3531 1759402644379 GEN4_TO_CONTROLLER_LOG:GEN4_DEBUG_INT_LOG_PIC16F13145 true
3531 1759402644379 GEN4_TO_CONTROLLER_LOG:GEN4_DEBUG_INT_LOG_PIC16F13145 Return End
3531 1759402644379 XXXX 1759402644379, Thread 3531: XXXX 1759402644379, Entering Thread 3531: Commands::runScriptBasic, script name = GetHaltStatus, timeOut = -1 ms  
3531 1759402644379 XXXX 1759402644379, Thread 3531: XXXX 1759402644379, Exiting Thread 3531: Commands::runScriptBasic  

3531 1759402644381 GEN4_TO_CONTROLLER_LOG:GEN4_DEBUG_INT_LOG_PIC16F13145 Pre:DebugReadTargetMemory
3531 1759402644381 GEN4_TO_CONTROLLER_LOG:GEN4_DEBUG_INT_LOG_PIC16F13145 Payload
3531 1759402644381 GEN4_TO_CONTROLLER_LOG:GEN4_DEBUG_INT_LOG_PIC16F13145 Emulation
3531 1759402644381 GEN4_TO_CONTROLLER_LOG:GEN4_DEBUG_INT_LOG_PIC16F13145 1f91
3531 1759402644381 GEN4_TO_CONTROLLER_LOG:GEN4_DEBUG_INT_LOG_PIC16F13145 1f91
3531 1759402644381 GEN4_TO_CONTROLLER_LOG:GEN4_DEBUG_INT_LOG_PIC16F13145 Length = 4
3531 1759402644381 GEN4_TO_CONTROLLER_LOG:GEN4_DEBUG_INT_LOG_PIC16F13145 Payload End
3531 1759402644381 XXXX 1759402644381, Thread 3531: XXXX 1759402644381, Entering Thread 3531: Commands::runScriptWithUpload, script name = ReadRAM  
3531 1759402644381 XXXX 1759402644381, Thread 3531: XXXX 1759402644381, Entering Thread 3531: ToolCommUsb::readTransfer, sideData is 0x25 bytes long, transferDataLength is 0x4 bytes long  
3531 1759402644384 XXXX 1759402644384, Thread 3531: XXXX 1759402644384, Exiting Thread 3531: ToolCommUsb::readTransfer,  cr.status = 0x0  
3531 1759402644384 XXXX 1759402644384, Thread 3531: XXXX 1759402644384, Exiting Thread 3531: Commands::runScriptWithUpload  
3531 1759402644384 GEN4_TO_CONTROLLER_LOG:GEN4_DEBUG_INT_LOG_PIC16F13145 Post:DebugReadTargetMemory
3531 1759402644384 GEN4_TO_CONTROLLER_LOG:GEN4_DEBUG_INT_LOG_PIC16F13145 Return Value
3531 1759402644384 GEN4_TO_CONTROLLER_LOG:GEN4_DEBUG_INT_LOG_PIC16F13145 true
3531 1759402644384 GEN4_TO_CONTROLLER_LOG:GEN4_DEBUG_INT_LOG_PIC16F13145 Return End

3531 1759402644386 GEN4_TO_CONTROLLER_LOG:GEN4_DEBUG_INT_LOG_PIC16F13145 Pre:GetPC
3531 1759402644386 GEN4_TO_CONTROLLER_LOG:GEN4_DEBUG_INT_LOG_PIC16F13145 Payload
3531 1759402644386 GEN4_TO_CONTROLLER_LOG:GEN4_DEBUG_INT_LOG_PIC16F13145 null
3531 1759402644386 GEN4_TO_CONTROLLER_LOG:GEN4_DEBUG_INT_LOG_PIC16F13145 Payload End
3531 1759402644386 XXXX 1759402644386, Thread 3531: XXXX 1759402644386, Entering Thread 3531: Commands::runScriptBasic, script name = GetPC, timeOut = -1 ms  
3531 1759402644386 XXXX 1759402644386, Thread 3531: XXXX 1759402644386, Exiting Thread 3531: Commands::runScriptBasic  
3531 1759402644387 GEN4_TO_CONTROLLER_LOG:GEN4_DEBUG_INT_LOG_PIC16F13145 Post:GetPC
3531 1759402644387 GEN4_TO_CONTROLLER_LOG:GEN4_DEBUG_INT_LOG_PIC16F13145 Return Value
3531 1759402644387 GEN4_TO_CONTROLLER_LOG:GEN4_DEBUG_INT_LOG_PIC16F13145 a8f
3531 1759402644387 GEN4_TO_CONTROLLER_LOG:GEN4_DEBUG_INT_LOG_PIC16F13145 Return End

3295 1759402644387 GEN4_TO_CONTROLLER_LOG:GEN4_DEBUG_INT_LOG_PIC16F13145 Pre:GetPC
3295 1759402644387 GEN4_TO_CONTROLLER_LOG:GEN4_DEBUG_INT_LOG_PIC16F13145 Payload
3295 1759402644387 GEN4_TO_CONTROLLER_LOG:GEN4_DEBUG_INT_LOG_PIC16F13145 null
3295 1759402644387 GEN4_TO_CONTROLLER_LOG:GEN4_DEBUG_INT_LOG_PIC16F13145 Payload End
3295 1759402644387 XXXX 1759402644387, Thread 3295: XXXX 1759402644387, Entering Thread 3295: Commands::runScriptBasic, script name = GetPC, timeOut = -1 ms  
3295 1759402644388 XXXX 1759402644388, Thread 3295: XXXX 1759402644387, Exiting Thread 3295: Commands::runScriptBasic  
3295 1759402644388 GEN4_TO_CONTROLLER_LOG:GEN4_DEBUG_INT_LOG_PIC16F13145 Post:GetPC
3295 1759402644388 GEN4_TO_CONTROLLER_LOG:GEN4_DEBUG_INT_LOG_PIC16F13145 Return Value
3295 1759402644388 GEN4_TO_CONTROLLER_LOG:GEN4_DEBUG_INT_LOG_PIC16F13145 a8f
3295 1759402644388 GEN4_TO_CONTROLLER_LOG:GEN4_DEBUG_INT_LOG_PIC16F13145 Return End

2888 1759402644469 GEN4_TO_CONTROLLER_LOG:GEN4_DEBUG_INT_LOG_PIC16F13145 Pre:DebugReadTargetMemory
2888 1759402644469 GEN4_TO_CONTROLLER_LOG:GEN4_DEBUG_INT_LOG_PIC16F13145 Payload
2888 1759402644469 GEN4_TO_CONTROLLER_LOG:GEN4_DEBUG_INT_LOG_PIC16F13145 FileRegs
2888 1759402644469 GEN4_TO_CONTROLLER_LOG:GEN4_DEBUG_INT_LOG_PIC16F13145 e6
2888 1759402644469 GEN4_TO_CONTROLLER_LOG:GEN4_DEBUG_INT_LOG_PIC16F13145 e7
2888 1759402644469 GEN4_TO_CONTROLLER_LOG:GEN4_DEBUG_INT_LOG_PIC16F13145 Length = 2
2888 1759402644469 GEN4_TO_CONTROLLER_LOG:GEN4_DEBUG_INT_LOG_PIC16F13145 Payload End
2888 1759402644469 XXXX 1759402644469, Thread 2888: XXXX 1759402644469, Entering Thread 2888: Commands::runScriptWithUpload, script name = ReadRAM  
2888 1759402644469 XXXX 1759402644469, Thread 2888: XXXX 1759402644469, Entering Thread 2888: ToolCommUsb::readTransfer, sideData is 0x25 bytes long, transferDataLength is 0x2 bytes long  
2888 1759402644471 XXXX 1759402644471, Thread 2888: XXXX 1759402644471, Exiting Thread 2888: ToolCommUsb::readTransfer,  cr.status = 0x0  
2888 1759402644471 XXXX 1759402644471, Thread 2888: XXXX 1759402644471, Exiting Thread 2888: Commands::runScriptWithUpload  
2888 1759402644471 GEN4_TO_CONTROLLER_LOG:GEN4_DEBUG_INT_LOG_PIC16F13145 Post:DebugReadTargetMemory
2888 1759402644471 GEN4_TO_CONTROLLER_LOG:GEN4_DEBUG_INT_LOG_PIC16F13145 Return Value
2888 1759402644471 GEN4_TO_CONTROLLER_LOG:GEN4_DEBUG_INT_LOG_PIC16F13145 true
2888 1759402644471 GEN4_TO_CONTROLLER_LOG:GEN4_DEBUG_INT_LOG_PIC16F13145 Return End

2888 1759402644472 GEN4_TO_CONTROLLER_LOG:GEN4_DEBUG_INT_LOG_PIC16F13145 Pre:DebugReadTargetMemory
2888 1759402644472 GEN4_TO_CONTROLLER_LOG:GEN4_DEBUG_INT_LOG_PIC16F13145 Payload
2888 1759402644472 GEN4_TO_CONTROLLER_LOG:GEN4_DEBUG_INT_LOG_PIC16F13145 FileRegs
2888 1759402644472 GEN4_TO_CONTROLLER_LOG:GEN4_DEBUG_INT_LOG_PIC16F13145 2096
2888 1759402644472 GEN4_TO_CONTROLLER_LOG:GEN4_DEBUG_INT_LOG_PIC16F13145 2097
2888 1759402644472 GEN4_TO_CONTROLLER_LOG:GEN4_DEBUG_INT_LOG_PIC16F13145 Length = 2
2888 1759402644472 GEN4_TO_CONTROLLER_LOG:GEN4_DEBUG_INT_LOG_PIC16F13145 Payload End
2888 1759402644472 XXXX 1759402644472, Thread 2888: XXXX 1759402644472, Entering Thread 2888: Commands::runScriptWithUpload, script name = ReadRAM  
2888 1759402644472 XXXX 1759402644472, Thread 2888: XXXX 1759402644472, Entering Thread 2888: ToolCommUsb::readTransfer, sideData is 0x25 bytes long, transferDataLength is 0x2 bytes long  
2888 1759402644473 XXXX 1759402644473, Thread 2888: XXXX 1759402644473, Exiting Thread 2888: ToolCommUsb::readTransfer,  cr.status = 0x0  
2888 1759402644473 XXXX 1759402644473, Thread 2888: XXXX 1759402644473, Exiting Thread 2888: Commands::runScriptWithUpload  
2888 1759402644473 GEN4_TO_CONTROLLER_LOG:GEN4_DEBUG_INT_LOG_PIC16F13145 Post:DebugReadTargetMemory
2888 1759402644473 GEN4_TO_CONTROLLER_LOG:GEN4_DEBUG_INT_LOG_PIC16F13145 Return Value
2888 1759402644473 GEN4_TO_CONTROLLER_LOG:GEN4_DEBUG_INT_LOG_PIC16F13145 true
2888 1759402644473 GEN4_TO_CONTROLLER_LOG:GEN4_DEBUG_INT_LOG_PIC16F13145 Return End

2888 1759402645389 GEN4_TO_CONTROLLER_LOG:GEN4_DEBUG_INT_LOG_PIC16F13145 Pre:DebugReadTargetMemory
2888 1759402645389 GEN4_TO_CONTROLLER_LOG:GEN4_DEBUG_INT_LOG_PIC16F13145 Payload
2888 1759402645389 GEN4_TO_CONTROLLER_LOG:GEN4_DEBUG_INT_LOG_PIC16F13145 FileRegs
2888 1759402645389 GEN4_TO_CONTROLLER_LOG:GEN4_DEBUG_INT_LOG_PIC16F13145 1fcf
2888 1759402645389 GEN4_TO_CONTROLLER_LOG:GEN4_DEBUG_INT_LOG_PIC16F13145 1fcf
2888 1759402645389 GEN4_TO_CONTROLLER_LOG:GEN4_DEBUG_INT_LOG_PIC16F13145 Length = 1
2888 1759402645389 GEN4_TO_CONTROLLER_LOG:GEN4_DEBUG_INT_LOG_PIC16F13145 Payload End
2888 1759402645389 XXXX 1759402645389, Thread 2888: XXXX 1759402645389, Entering Thread 2888: Commands::runScriptWithUpload, script name = ReadRAM  
2888 1759402645389 XXXX 1759402645389, Thread 2888: XXXX 1759402645389, Entering Thread 2888: ToolCommUsb::readTransfer, sideData is 0x25 bytes long, transferDataLength is 0x1 bytes long  
2888 1759402645392 XXXX 1759402645392, Thread 2888: XXXX 1759402645392, Exiting Thread 2888: ToolCommUsb::readTransfer,  cr.status = 0x0  
2888 1759402645392 XXXX 1759402645392, Thread 2888: XXXX 1759402645392, Exiting Thread 2888: Commands::runScriptWithUpload  
2888 1759402645392 GEN4_TO_CONTROLLER_LOG:GEN4_DEBUG_INT_LOG_PIC16F13145 Post:DebugReadTargetMemory
2888 1759402645392 GEN4_TO_CONTROLLER_LOG:GEN4_DEBUG_INT_LOG_PIC16F13145 Return Value
2888 1759402645392 GEN4_TO_CONTROLLER_LOG:GEN4_DEBUG_INT_LOG_PIC16F13145 true
2888 1759402645392 GEN4_TO_CONTROLLER_LOG:GEN4_DEBUG_INT_LOG_PIC16F13145 Return End

2888 1759402645393 GEN4_TO_CONTROLLER_LOG:GEN4_DEBUG_INT_LOG_PIC16F13145 Pre:DebugReadTargetMemory
2888 1759402645393 GEN4_TO_CONTROLLER_LOG:GEN4_DEBUG_INT_LOG_PIC16F13145 Payload
2888 1759402645393 GEN4_TO_CONTROLLER_LOG:GEN4_DEBUG_INT_LOG_PIC16F13145 FileRegs
2888 1759402645393 GEN4_TO_CONTROLLER_LOG:GEN4_DEBUG_INT_LOG_PIC16F13145 1fcf
2888 1759402645393 GEN4_TO_CONTROLLER_LOG:GEN4_DEBUG_INT_LOG_PIC16F13145 1fcf
2888 1759402645393 GEN4_TO_CONTROLLER_LOG:GEN4_DEBUG_INT_LOG_PIC16F13145 Length = 1
2888 1759402645393 GEN4_TO_CONTROLLER_LOG:GEN4_DEBUG_INT_LOG_PIC16F13145 Payload End
2888 1759402645393 XXXX 1759402645393, Thread 2888: XXXX 1759402645393, Entering Thread 2888: Commands::runScriptWithUpload, script name = ReadRAM  
2888 1759402645393 XXXX 1759402645393, Thread 2888: XXXX 1759402645393, Entering Thread 2888: ToolCommUsb::readTransfer, sideData is 0x25 bytes long, transferDataLength is 0x1 bytes long  
2888 1759402645394 XXXX 1759402645394, Thread 2888: XXXX 1759402645394, Exiting Thread 2888: ToolCommUsb::readTransfer,  cr.status = 0x0  
2888 1759402645394 XXXX 1759402645394, Thread 2888: XXXX 1759402645394, Exiting Thread 2888: Commands::runScriptWithUpload  
2888 1759402645394 GEN4_TO_CONTROLLER_LOG:GEN4_DEBUG_INT_LOG_PIC16F13145 Post:DebugReadTargetMemory
2888 1759402645394 GEN4_TO_CONTROLLER_LOG:GEN4_DEBUG_INT_LOG_PIC16F13145 Return Value
2888 1759402645394 GEN4_TO_CONTROLLER_LOG:GEN4_DEBUG_INT_LOG_PIC16F13145 true
2888 1759402645394 GEN4_TO_CONTROLLER_LOG:GEN4_DEBUG_INT_LOG_PIC16F13145 Return End

2888 1759402645395 GEN4_TO_CONTROLLER_LOG:GEN4_DEBUG_INT_LOG_PIC16F13145 Pre:DebugReadTargetMemory
2888 1759402645395 GEN4_TO_CONTROLLER_LOG:GEN4_DEBUG_INT_LOG_PIC16F13145 Payload
2888 1759402645395 GEN4_TO_CONTROLLER_LOG:GEN4_DEBUG_INT_LOG_PIC16F13145 FileRegs
2888 1759402645395 GEN4_TO_CONTROLLER_LOG:GEN4_DEBUG_INT_LOG_PIC16F13145 1fcb
2888 1759402645395 GEN4_TO_CONTROLLER_LOG:GEN4_DEBUG_INT_LOG_PIC16F13145 1fcb
2888 1759402645395 GEN4_TO_CONTROLLER_LOG:GEN4_DEBUG_INT_LOG_PIC16F13145 Length = 1
2888 1759402645395 GEN4_TO_CONTROLLER_LOG:GEN4_DEBUG_INT_LOG_PIC16F13145 Payload End
2888 1759402645395 XXXX 1759402645395, Thread 2888: XXXX 1759402645395, Entering Thread 2888: Commands::runScriptWithUpload, script name = ReadRAM  
2888 1759402645395 XXXX 1759402645395, Thread 2888: XXXX 1759402645395, Entering Thread 2888: ToolCommUsb::readTransfer, sideData is 0x25 bytes long, transferDataLength is 0x1 bytes long  
2888 1759402645396 XXXX 1759402645396, Thread 2888: XXXX 1759402645396, Exiting Thread 2888: ToolCommUsb::readTransfer,  cr.status = 0x0  
2888 1759402645396 XXXX 1759402645396, Thread 2888: XXXX 1759402645396, Exiting Thread 2888: Commands::runScriptWithUpload  
2888 1759402645396 GEN4_TO_CONTROLLER_LOG:GEN4_DEBUG_INT_LOG_PIC16F13145 Post:DebugReadTargetMemory
2888 1759402645396 GEN4_TO_CONTROLLER_LOG:GEN4_DEBUG_INT_LOG_PIC16F13145 Return Value
2888 1759402645396 GEN4_TO_CONTROLLER_LOG:GEN4_DEBUG_INT_LOG_PIC16F13145 true
2888 1759402645396 GEN4_TO_CONTROLLER_LOG:GEN4_DEBUG_INT_LOG_PIC16F13145 Return End

2888 1759402645397 GEN4_TO_CONTROLLER_LOG:GEN4_DEBUG_INT_LOG_PIC16F13145 Pre:DebugReadTargetMemory
2888 1759402645397 GEN4_TO_CONTROLLER_LOG:GEN4_DEBUG_INT_LOG_PIC16F13145 Payload
2888 1759402645397 GEN4_TO_CONTROLLER_LOG:GEN4_DEBUG_INT_LOG_PIC16F13145 FileRegs
2888 1759402645397 GEN4_TO_CONTROLLER_LOG:GEN4_DEBUG_INT_LOG_PIC16F13145 1fcb
2888 1759402645397 GEN4_TO_CONTROLLER_LOG:GEN4_DEBUG_INT_LOG_PIC16F13145 1fcb
2888 1759402645397 GEN4_TO_CONTROLLER_LOG:GEN4_DEBUG_INT_LOG_PIC16F13145 Length = 1
2888 1759402645397 GEN4_TO_CONTROLLER_LOG:GEN4_DEBUG_INT_LOG_PIC16F13145 Payload End
2888 1759402645397 XXXX 1759402645397, Thread 2888: XXXX 1759402645397, Entering Thread 2888: Commands::runScriptWithUpload, script name = ReadRAM  
2888 1759402645397 XXXX 1759402645397, Thread 2888: XXXX 1759402645397, Entering Thread 2888: ToolCommUsb::readTransfer, sideData is 0x25 bytes long, transferDataLength is 0x1 bytes long  
2888 1759402645398 XXXX 1759402645398, Thread 2888: XXXX 1759402645398, Exiting Thread 2888: ToolCommUsb::readTransfer,  cr.status = 0x0  
2888 1759402645398 XXXX 1759402645398, Thread 2888: XXXX 1759402645398, Exiting Thread 2888: Commands::runScriptWithUpload  
2888 1759402645398 GEN4_TO_CONTROLLER_LOG:GEN4_DEBUG_INT_LOG_PIC16F13145 Post:DebugReadTargetMemory
2888 1759402645398 GEN4_TO_CONTROLLER_LOG:GEN4_DEBUG_INT_LOG_PIC16F13145 Return Value
2888 1759402645398 GEN4_TO_CONTROLLER_LOG:GEN4_DEBUG_INT_LOG_PIC16F13145 true
2888 1759402645398 GEN4_TO_CONTROLLER_LOG:GEN4_DEBUG_INT_LOG_PIC16F13145 Return End

2888 1759402645399 GEN4_TO_CONTROLLER_LOG:GEN4_DEBUG_INT_LOG_PIC16F13145 Pre:DebugReadTargetMemory
2888 1759402645399 GEN4_TO_CONTROLLER_LOG:GEN4_DEBUG_INT_LOG_PIC16F13145 Payload
2888 1759402645399 GEN4_TO_CONTROLLER_LOG:GEN4_DEBUG_INT_LOG_PIC16F13145 FileRegs
2888 1759402645399 GEN4_TO_CONTROLLER_LOG:GEN4_DEBUG_INT_LOG_PIC16F13145 1fe3
2888 1759402645399 GEN4_TO_CONTROLLER_LOG:GEN4_DEBUG_INT_LOG_PIC16F13145 1fe3
2888 1759402645399 GEN4_TO_CONTROLLER_LOG:GEN4_DEBUG_INT_LOG_PIC16F13145 Length = 1
2888 1759402645399 GEN4_TO_CONTROLLER_LOG:GEN4_DEBUG_INT_LOG_PIC16F13145 Payload End
2888 1759402645399 XXXX 1759402645399, Thread 2888: XXXX 1759402645399, Entering Thread 2888: Commands::runScriptWithUpload, script name = ReadRAM  
2888 1759402645399 XXXX 1759402645399, Thread 2888: XXXX 1759402645399, Entering Thread 2888: ToolCommUsb::readTransfer, sideData is 0x25 bytes long, transferDataLength is 0x1 bytes long  
2888 1759402645401 XXXX 1759402645401, Thread 2888: XXXX 1759402645401, Exiting Thread 2888: ToolCommUsb::readTransfer,  cr.status = 0x0  
2888 1759402645401 XXXX 1759402645401, Thread 2888: XXXX 1759402645401, Exiting Thread 2888: Commands::runScriptWithUpload  
2888 1759402645401 GEN4_TO_CONTROLLER_LOG:GEN4_DEBUG_INT_LOG_PIC16F13145 Post:DebugReadTargetMemory
2888 1759402645401 GEN4_TO_CONTROLLER_LOG:GEN4_DEBUG_INT_LOG_PIC16F13145 Return Value
2888 1759402645401 GEN4_TO_CONTROLLER_LOG:GEN4_DEBUG_INT_LOG_PIC16F13145 true
2888 1759402645401 GEN4_TO_CONTROLLER_LOG:GEN4_DEBUG_INT_LOG_PIC16F13145 Return End

2888 1759402645402 GEN4_TO_CONTROLLER_LOG:GEN4_DEBUG_INT_LOG_PIC16F13145 Pre:DebugReadTargetMemory
2888 1759402645402 GEN4_TO_CONTROLLER_LOG:GEN4_DEBUG_INT_LOG_PIC16F13145 Payload
2888 1759402645402 GEN4_TO_CONTROLLER_LOG:GEN4_DEBUG_INT_LOG_PIC16F13145 FileRegs
2888 1759402645402 GEN4_TO_CONTROLLER_LOG:GEN4_DEBUG_INT_LOG_PIC16F13145 1fcb
2888 1759402645402 GEN4_TO_CONTROLLER_LOG:GEN4_DEBUG_INT_LOG_PIC16F13145 1fcb
2888 1759402645402 GEN4_TO_CONTROLLER_LOG:GEN4_DEBUG_INT_LOG_PIC16F13145 Length = 1
2888 1759402645402 GEN4_TO_CONTROLLER_LOG:GEN4_DEBUG_INT_LOG_PIC16F13145 Payload End
2888 1759402645402 XXXX 1759402645402, Thread 2888: XXXX 1759402645402, Entering Thread 2888: Commands::runScriptWithUpload, script name = ReadRAM  
2888 1759402645402 XXXX 1759402645402, Thread 2888: XXXX 1759402645402, Entering Thread 2888: ToolCommUsb::readTransfer, sideData is 0x25 bytes long, transferDataLength is 0x1 bytes long  
2888 1759402645404 XXXX 1759402645404, Thread 2888: XXXX 1759402645404, Exiting Thread 2888: ToolCommUsb::readTransfer,  cr.status = 0x0  
2888 1759402645404 XXXX 1759402645404, Thread 2888: XXXX 1759402645404, Exiting Thread 2888: Commands::runScriptWithUpload  
2888 1759402645404 GEN4_TO_CONTROLLER_LOG:GEN4_DEBUG_INT_LOG_PIC16F13145 Post:DebugReadTargetMemory
2888 1759402645404 GEN4_TO_CONTROLLER_LOG:GEN4_DEBUG_INT_LOG_PIC16F13145 Return Value
2888 1759402645404 GEN4_TO_CONTROLLER_LOG:GEN4_DEBUG_INT_LOG_PIC16F13145 true
2888 1759402645404 GEN4_TO_CONTROLLER_LOG:GEN4_DEBUG_INT_LOG_PIC16F13145 Return End

3562 1759402645689 GEN4_TO_CONTROLLER_LOG:GEN4_DEBUG_INT_LOG_PIC16F13145 Pre:setTraceDescriptor
3562 1759402645689 GEN4_TO_CONTROLLER_LOG:GEN4_DEBUG_INT_LOG_PIC16F13145 Payload
3562 1759402645689 GEN4_TO_CONTROLLER_LOG:GEN4_DEBUG_INT_LOG_PIC16F13145 com.microchip.mplab.libs.RI4ToolsController.DataClasses.TraceDescriptor@35828786
3562 1759402645689 GEN4_TO_CONTROLLER_LOG:GEN4_DEBUG_INT_LOG_PIC16F13145 Payload End
3562 1759402645689 GEN4_TO_CONTROLLER_LOG:GEN4_DEBUG_INT_LOG_PIC16F13145 Post:setTraceDescriptor
3562 1759402645689 GEN4_TO_CONTROLLER_LOG:GEN4_DEBUG_INT_LOG_PIC16F13145 Return Value
3562 1759402645689 GEN4_TO_CONTROLLER_LOG:GEN4_DEBUG_INT_LOG_PIC16F13145 none
3562 1759402645689 GEN4_TO_CONTROLLER_LOG:GEN4_DEBUG_INT_LOG_PIC16F13145 Return End

3562 1759402645689 GEN4_TO_CONTROLLER_LOG:GEN4_DEBUG_INT_LOG_PIC16F13145 Pre:DebugWriteTargetMemory
3562 1759402645689 GEN4_TO_CONTROLLER_LOG:GEN4_DEBUG_INT_LOG_PIC16F13145 Payload
3562 1759402645689 GEN4_TO_CONTROLLER_LOG:GEN4_DEBUG_INT_LOG_PIC16F13145 Emulation
3562 1759402645689 GEN4_TO_CONTROLLER_LOG:GEN4_DEBUG_INT_LOG_PIC16F13145 1f8c
3562 1759402645689 GEN4_TO_CONTROLLER_LOG:GEN4_DEBUG_INT_LOG_PIC16F13145 1fa9
3562 1759402645689 GEN4_TO_CONTROLLER_LOG:GEN4_DEBUG_INT_LOG_PIC16F13145 Length = 30
3562 1759402645689 GEN4_TO_CONTROLLER_LOG:GEN4_DEBUG_INT_LOG_PIC16F13145 Payload End
3562 1759402645690 XXXX 1759402645690, Thread 3562: XXXX 1759402645690, Entering Thread 3562: Commands::runScriptWithDownload, script name = WriteRAM  
3562 1759402645694 XXXX 1759402645694, Thread 3562: XXXX 1759402645694, Exiting Thread 3562: Commands::runScriptWithDownload(WriteRAM)  
3562 1759402645694 GEN4_TO_CONTROLLER_LOG:GEN4_DEBUG_INT_LOG_PIC16F13145 Post:DebugWriteTargetMemory
3562 1759402645694 GEN4_TO_CONTROLLER_LOG:GEN4_DEBUG_INT_LOG_PIC16F13145 Return Value
3562 1759402645694 GEN4_TO_CONTROLLER_LOG:GEN4_DEBUG_INT_LOG_PIC16F13145 true
3562 1759402645694 GEN4_TO_CONTROLLER_LOG:GEN4_DEBUG_INT_LOG_PIC16F13145 Return End

3562 1759402645694 GEN4_TO_CONTROLLER_LOG:GEN4_DEBUG_INT_LOG_PIC16F13145 Pre:SetFreezePerihperalInfo
3562 1759402645694 GEN4_TO_CONTROLLER_LOG:GEN4_DEBUG_INT_LOG_PIC16F13145 Payload
3562 1759402645694 GEN4_TO_CONTROLLER_LOG:GEN4_DEBUG_INT_LOG_PIC16F13145 BitSetInfo: Values:
3562 1759402645694 GEN4_TO_CONTROLLER_LOG:GEN4_DEBUG_INT_LOG_PIC16F13145 BitSetInfo: Address = 1f8d, Mask = 40, SetVal = 40, Type = Emulation
3562 1759402645694 GEN4_TO_CONTROLLER_LOG:GEN4_DEBUG_INT_LOG_PIC16F13145 Payload End
3562 1759402645694 XXXX 1759402645694, Thread 3562: XXXX 1759402645694, Entering Thread 3562: Commands::runScriptWithUpload, script name = ReadRAM  
3562 1759402645694 XXXX 1759402645694, Thread 3562: XXXX 1759402645694, Entering Thread 3562: ToolCommUsb::readTransfer, sideData is 0x25 bytes long, transferDataLength is 0x1 bytes long  
3562 1759402645696 XXXX 1759402645696, Thread 3562: XXXX 1759402645696, Exiting Thread 3562: ToolCommUsb::readTransfer,  cr.status = 0x0  
3562 1759402645696 XXXX 1759402645696, Thread 3562: XXXX 1759402645696, Exiting Thread 3562: Commands::runScriptWithUpload  
3562 1759402645696 XXXX 1759402645696, Thread 3562: XXXX 1759402645696, Entering Thread 3562: Commands::runScriptWithDownload, script name = WriteRAM  
3562 1759402645699 XXXX 1759402645699, Thread 3562: XXXX 1759402645699, Exiting Thread 3562: Commands::runScriptWithDownload(WriteRAM)  
3562 1759402645699 GEN4_TO_CONTROLLER_LOG:GEN4_DEBUG_INT_LOG_PIC16F13145 Post:SetFreezePerihperalInfo
3562 1759402645699 GEN4_TO_CONTROLLER_LOG:GEN4_DEBUG_INT_LOG_PIC16F13145 Return Value
3562 1759402645699 GEN4_TO_CONTROLLER_LOG:GEN4_DEBUG_INT_LOG_PIC16F13145 none
3562 1759402645699 GEN4_TO_CONTROLLER_LOG:GEN4_DEBUG_INT_LOG_PIC16F13145 Return End

3562 1759402645699 GEN4_TO_CONTROLLER_LOG:GEN4_DEBUG_INT_LOG_PIC16F13145 Pre:GetPC
3562 1759402645699 GEN4_TO_CONTROLLER_LOG:GEN4_DEBUG_INT_LOG_PIC16F13145 Payload
3562 1759402645699 GEN4_TO_CONTROLLER_LOG:GEN4_DEBUG_INT_LOG_PIC16F13145 null
3562 1759402645699 GEN4_TO_CONTROLLER_LOG:GEN4_DEBUG_INT_LOG_PIC16F13145 Payload End
3562 1759402645699 XXXX 1759402645699, Thread 3562: XXXX 1759402645699, Entering Thread 3562: Commands::runScriptBasic, script name = GetPC, timeOut = -1 ms  
3562 1759402645700 XXXX 1759402645700, Thread 3562: XXXX 1759402645700, Exiting Thread 3562: Commands::runScriptBasic  
3562 1759402645700 GEN4_TO_CONTROLLER_LOG:GEN4_DEBUG_INT_LOG_PIC16F13145 Post:GetPC
3562 1759402645700 GEN4_TO_CONTROLLER_LOG:GEN4_DEBUG_INT_LOG_PIC16F13145 Return Value
3562 1759402645700 GEN4_TO_CONTROLLER_LOG:GEN4_DEBUG_INT_LOG_PIC16F13145 a8f
3562 1759402645700 GEN4_TO_CONTROLLER_LOG:GEN4_DEBUG_INT_LOG_PIC16F13145 Return End

3562 1759402645701 GEN4_TO_CONTROLLER_LOG:GEN4_DEBUG_INT_LOG_PIC16F13145 Pre:RunTarget
3562 1759402645701 GEN4_TO_CONTROLLER_LOG:GEN4_DEBUG_INT_LOG_PIC16F13145 Payload
3562 1759402645701 GEN4_TO_CONTROLLER_LOG:GEN4_DEBUG_INT_LOG_PIC16F13145 com.microchip.mplab.mdbcore.RI4Tool.DebugHandler@7b980544
3562 1759402645701 GEN4_TO_CONTROLLER_LOG:GEN4_DEBUG_INT_LOG_PIC16F13145 Payload End
3562 1759402645701 XXXX 1759402645701, Thread 3562: XXXX 1759402645701, Entering Thread 3562: Commands::runScriptBasic, script name = Run, timeOut = -1 ms  
3562 1759402645702 XXXX 1759402645702, Thread 3562: XXXX 1759402645702, Exiting Thread 3562: Commands::runScriptBasic  
3562 1759402645702 GEN4_TO_CONTROLLER_LOG:GEN4_DEBUG_INT_LOG_PIC16F13145 Post:RunTarget
3562 1759402645702 GEN4_TO_CONTROLLER_LOG:GEN4_DEBUG_INT_LOG_PIC16F13145 Return Value
3562 1759402645702 GEN4_TO_CONTROLLER_LOG:GEN4_DEBUG_INT_LOG_PIC16F13145 true
3562 1759402645702 GEN4_TO_CONTROLLER_LOG:GEN4_DEBUG_INT_LOG_PIC16F13145 Return End
3562 1759402645959 XXXX 1759402645959, Thread 3562: XXXX 1759402645959, Entering Thread 3562: Commands::runScriptBasic, script name = GetHaltStatus, timeOut = -1 ms  
3562 1759402645960 XXXX 1759402645960, Thread 3562: XXXX 1759402645960, Exiting Thread 3562: Commands::runScriptBasic  
3562 1759402646060 XXXX 1759402646060, Thread 3562: XXXX 1759402646060, Entering Thread 3562: Commands::runScriptBasic, script name = GetHaltStatus, timeOut = -1 ms  
3562 1759402646061 XXXX 1759402646061, Thread 3562: XXXX 1759402646061, Exiting Thread 3562: Commands::runScriptBasic  
3562 1759402646162 XXXX 1759402646162, Thread 3562: XXXX 1759402646162, Entering Thread 3562: Commands::runScriptBasic, script name = GetHaltStatus, timeOut = -1 ms  
3562 1759402646163 XXXX 1759402646163, Thread 3562: XXXX 1759402646163, Exiting Thread 3562: Commands::runScriptBasic  
3562 1759402646262 XXXX 1759402646262, Thread 3562: XXXX 1759402646262, Entering Thread 3562: Commands::runScriptBasic, script name = GetHaltStatus, timeOut = -1 ms  
3562 1759402646263 XXXX 1759402646263, Thread 3562: XXXX 1759402646263, Exiting Thread 3562: Commands::runScriptBasic  
3562 1759402646363 XXXX 1759402646363, Thread 3562: XXXX 1759402646363, Entering Thread 3562: Commands::runScriptBasic, script name = GetHaltStatus, timeOut = -1 ms  
3562 1759402646364 XXXX 1759402646364, Thread 3562: XXXX 1759402646364, Exiting Thread 3562: Commands::runScriptBasic  
3562 1759402646464 XXXX 1759402646464, Thread 3562: XXXX 1759402646464, Entering Thread 3562: Commands::runScriptBasic, script name = GetHaltStatus, timeOut = -1 ms  
3562 1759402646465 XXXX 1759402646465, Thread 3562: XXXX 1759402646465, Exiting Thread 3562: Commands::runScriptBasic  
3562 1759402646564 XXXX 1759402646564, Thread 3562: XXXX 1759402646564, Entering Thread 3562: Commands::runScriptBasic, script name = GetHaltStatus, timeOut = -1 ms  
3562 1759402646564 XXXX 1759402646564, Thread 3562: XXXX 1759402646564, Exiting Thread 3562: Commands::runScriptBasic  
3562 1759402646664 XXXX 1759402646664, Thread 3562: XXXX 1759402646664, Entering Thread 3562: Commands::runScriptBasic, script name = GetHaltStatus, timeOut = -1 ms  
3562 1759402646665 XXXX 1759402646665, Thread 3562: XXXX 1759402646665, Exiting Thread 3562: Commands::runScriptBasic  
3562 1759402646765 XXXX 1759402646765, Thread 3562: XXXX 1759402646765, Entering Thread 3562: Commands::runScriptBasic, script name = GetHaltStatus, timeOut = -1 ms  
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
3562 1759402651292 XXXX 1759402651292, Thread 3562: XXXX 1759402651292, Entering Thread 3562: Commands::runScriptBasic, script name = GetHaltStatus, timeOut = -1 ms  
3562 1759402651293 XXXX 1759402651293, Thread 3562: XXXX 1759402651293, Exiting Thread 3562: Commands::runScriptBasic  
3562 1759402651394 XXXX 1759402651394, Thread 3562: XXXX 1759402651394, Entering Thread 3562: Commands::runScriptBasic, script name = GetHaltStatus, timeOut = -1 ms  
3562 1759402651395 XXXX 1759402651395, Thread 3562: XXXX 1759402651395, Exiting Thread 3562: Commands::runScriptBasic  
3562 1759402651495 XXXX 1759402651495, Thread 3562: XXXX 1759402651495, Entering Thread 3562: Commands::runScriptBasic, script name = GetHaltStatus, timeOut = -1 ms  
3562 1759402651496 XXXX 1759402651496, Thread 3562: XXXX 1759402651496, Exiting Thread 3562: Commands::runScriptBasic  
3562 1759402651595 XXXX 1759402651595, Thread 3562: XXXX 1759402651595, Entering Thread 3562: Commands::runScriptBasic, script name = GetHaltStatus, timeOut = -1 ms  
3562 1759402651597 XXXX 1759402651597, Thread 3562: XXXX 1759402651597, Exiting Thread 3562: Commands::runScriptBasic  
3562 1759402651695 XXXX 1759402651695, Thread 3562: XXXX 1759402651695, Entering Thread 3562: Commands::runScriptBasic, script name = GetHaltStatus, timeOut = -1 ms  
3562 1759402651696 XXXX 1759402651696, Thread 3562: XXXX 1759402651696, Exiting Thread 3562: Commands::runScriptBasic  
3562 1759402651795 XXXX 1759402651795, Thread 3562: XXXX 1759402651795, Entering Thread 3562: Commands::runScriptBasic, script name = GetHaltStatus, timeOut = -1 ms  
3562 1759402651796 XXXX 1759402651796, Thread 3562: XXXX 1759402651796, Exiting Thread 3562: Commands::runScriptBasic  
3562 1759402651896 XXXX 1759402651896, Thread 3562: XXXX 1759402651896, Entering Thread 3562: Commands::runScriptBasic, script name = GetHaltStatus, timeOut = -1 ms  
3562 1759402651897 XXXX 1759402651897, Thread 3562: XXXX 1759402651897, Exiting Thread 3562: Commands::runScriptBasic  
3562 1759402651997 XXXX 1759402651997, Thread 3562: XXXX 1759402651997, Entering Thread 3562: Commands::runScriptBasic, script name = GetHaltStatus, timeOut = -1 ms  
3562 1759402651998 XXXX 1759402651998, Thread 3562: XXXX 1759402651998, Exiting Thread 3562: Commands::runScriptBasic  
3562 1759402652098 XXXX 1759402652098, Thread 3562: XXXX 1759402652098, Entering Thread 3562: Commands::runScriptBasic, script name = GetHaltStatus, timeOut = -1 ms  
3562 1759402652100 XXXX 1759402652100, Thread 3562: XXXX 1759402652100, Exiting Thread 3562: Commands::runScriptBasic  
3562 1759402652198 XXXX 1759402652198, Thread 3562: XXXX 1759402652198, Entering Thread 3562: Commands::runScriptBasic, script name = GetHaltStatus, timeOut = -1 ms  
3562 1759402652198 XXXX 1759402652198, Thread 3562: XXXX 1759402652198, Exiting Thread 3562: Commands::runScriptBasic  
3562 1759402652299 XXXX 1759402652299, Thread 3562: XXXX 1759402652299, Entering Thread 3562: Commands::runScriptBasic, script name = GetHaltStatus, timeOut = -1 ms  
3562 1759402652300 XXXX 1759402652300, Thread 3562: XXXX 1759402652300, Exiting Thread 3562: Commands::runScriptBasic  
3562 1759402652400 XXXX 1759402652400, Thread 3562: XXXX 1759402652400, Entering Thread 3562: Commands::runScriptBasic, script name = GetHaltStatus, timeOut = -1 ms  
3562 1759402652401 XXXX 1759402652401, Thread 3562: XXXX 1759402652401, Exiting Thread 3562: Commands::runScriptBasic  
3562 1759402652500 XXXX 1759402652500, Thread 3562: XXXX 1759402652500, Entering Thread 3562: Commands::runScriptBasic, script name = GetHaltStatus, timeOut = -1 ms  
3562 1759402652502 XXXX 1759402652502, Thread 3562: XXXX 1759402652502, Exiting Thread 3562: Commands::runScriptBasic  
3562 1759402652600 XXXX 1759402652600, Thread 3562: XXXX 1759402652600, Entering Thread 3562: Commands::runScriptBasic, script name = GetHaltStatus, timeOut = -1 ms  
3562 1759402652602 XXXX 1759402652602, Thread 3562: XXXX 1759402652602, Exiting Thread 3562: Commands::runScriptBasic  
3562 1759402652701 XXXX 1759402652701, Thread 3562: XXXX 1759402652701, Entering Thread 3562: Commands::runScriptBasic, script name = GetHaltStatus, timeOut = -1 ms  
3562 1759402652702 XXXX 1759402652702, Thread 3562: XXXX 1759402652702, Exiting Thread 3562: Commands::runScriptBasic  
3562 1759402652801 XXXX 1759402652801, Thread 3562: XXXX 1759402652801, Entering Thread 3562: Commands::runScriptBasic, script name = GetHaltStatus, timeOut = -1 ms  
3562 1759402652802 XXXX 1759402652802, Thread 3562: XXXX 1759402652802, Exiting Thread 3562: Commands::runScriptBasic  
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
3562 1759402655315 XXXX 1759402655315, Thread 3562: XXXX 1759402655315, Entering Thread 3562: Commands::runScriptBasic, script name = GetHaltStatus, timeOut = -1 ms  
3562 1759402655316 XXXX 1759402655316, Thread 3562: XXXX 1759402655316, Exiting Thread 3562: Commands::runScriptBasic  
3562 1759402655417 XXXX 1759402655417, Thread 3562: XXXX 1759402655417, Entering Thread 3562: Commands::runScriptBasic, script name = GetHaltStatus, timeOut = -1 ms  
3562 1759402655419 XXXX 1759402655419, Thread 3562: XXXX 1759402655419, Exiting Thread 3562: Commands::runScriptBasic  
3562 1759402655518 XXXX 1759402655518, Thread 3562: XXXX 1759402655518, Entering Thread 3562: Commands::runScriptBasic, script name = GetHaltStatus, timeOut = -1 ms  
3562 1759402655519 XXXX 1759402655519, Thread 3562: XXXX 1759402655519, Exiting Thread 3562: Commands::runScriptBasic  
3562 1759402655618 XXXX 1759402655618, Thread 3562: XXXX 1759402655618, Entering Thread 3562: Commands::runScriptBasic, script name = GetHaltStatus, timeOut = -1 ms  
3562 1759402655619 XXXX 1759402655619, Thread 3562: XXXX 1759402655619, Exiting Thread 3562: Commands::runScriptBasic  
3562 1759402655719 XXXX 1759402655719, Thread 3562: XXXX 1759402655719, Entering Thread 3562: Commands::runScriptBasic, script name = GetHaltStatus, timeOut = -1 ms  
3562 1759402655720 XXXX 1759402655720, Thread 3562: XXXX 1759402655720, Exiting Thread 3562: Commands::runScriptBasic  
3562 1759402655821 XXXX 1759402655821, Thread 3562: XXXX 1759402655821, Entering Thread 3562: Commands::runScriptBasic, script name = GetHaltStatus, timeOut = -1 ms  
3562 1759402655823 XXXX 1759402655823, Thread 3562: XXXX 1759402655823, Exiting Thread 3562: Commands::runScriptBasic  
3562 1759402655921 XXXX 1759402655921, Thread 3562: XXXX 1759402655921, Entering Thread 3562: Commands::runScriptBasic, script name = GetHaltStatus, timeOut = -1 ms  
3562 1759402655922 XXXX 1759402655922, Thread 3562: XXXX 1759402655922, Exiting Thread 3562: Commands::runScriptBasic  
3562 1759402656021 XXXX 1759402656021, Thread 3562: XXXX 1759402656021, Entering Thread 3562: Commands::runScriptBasic, script name = GetHaltStatus, timeOut = -1 ms  
3562 1759402656023 XXXX 1759402656023, Thread 3562: XXXX 1759402656023, Exiting Thread 3562: Commands::runScriptBasic  
3562 1759402656121 XXXX 1759402656121, Thread 3562: XXXX 1759402656121, Entering Thread 3562: Commands::runScriptBasic, script name = GetHaltStatus, timeOut = -1 ms  
3562 1759402656122 XXXX 1759402656122, Thread 3562: XXXX 1759402656122, Exiting Thread 3562: Commands::runScriptBasic  
3562 1759402656221 XXXX 1759402656221, Thread 3562: XXXX 1759402656221, Entering Thread 3562: Commands::runScriptBasic, script name = GetHaltStatus, timeOut = -1 ms  
3562 1759402656222 XXXX 1759402656222, Thread 3562: XXXX 1759402656222, Exiting Thread 3562: Commands::runScriptBasic  
3562 1759402656323 XXXX 1759402656323, Thread 3562: XXXX 1759402656323, Entering Thread 3562: Commands::runScriptBasic, script name = GetHaltStatus, timeOut = -1 ms  
3562 1759402656324 XXXX 1759402656324, Thread 3562: XXXX 1759402656324, Exiting Thread 3562: Commands::runScriptBasic  
3562 1759402656423 XXXX 1759402656423, Thread 3562: XXXX 1759402656423, Entering Thread 3562: Commands::runScriptBasic, script name = GetHaltStatus, timeOut = -1 ms  
3562 1759402656424 XXXX 1759402656424, Thread 3562: XXXX 1759402656424, Exiting Thread 3562: Commands::runScriptBasic  
3562 1759402656523 XXXX 1759402656523, Thread 3562: XXXX 1759402656523, Entering Thread 3562: Commands::runScriptBasic, script name = GetHaltStatus, timeOut = -1 ms  
3562 1759402656524 XXXX 1759402656524, Thread 3562: XXXX 1759402656524, Exiting Thread 3562: Commands::runScriptBasic  
3562 1759402656623 XXXX 1759402656623, Thread 3562: XXXX 1759402656623, Entering Thread 3562: Commands::runScriptBasic, script name = GetHaltStatus, timeOut = -1 ms  
3562 1759402656624 XXXX 1759402656624, Thread 3562: XXXX 1759402656624, Exiting Thread 3562: Commands::runScriptBasic  
3562 1759402656724 XXXX 1759402656724, Thread 3562: XXXX 1759402656724, Entering Thread 3562: Commands::runScriptBasic, script name = GetHaltStatus, timeOut = -1 ms  
3562 1759402656725 XXXX 1759402656725, Thread 3562: XXXX 1759402656725, Exiting Thread 3562: Commands::runScriptBasic  
3562 1759402656824 XXXX 1759402656824, Thread 3562: XXXX 1759402656824, Entering Thread 3562: Commands::runScriptBasic, script name = GetHaltStatus, timeOut = -1 ms  
3562 1759402656825 XXXX 1759402656825, Thread 3562: XXXX 1759402656825, Exiting Thread 3562: Commands::runScriptBasic  
3562 1759402656925 XXXX 1759402656925, Thread 3562: XXXX 1759402656925, Entering Thread 3562: Commands::runScriptBasic, script name = GetHaltStatus, timeOut = -1 ms  
3562 1759402656926 XXXX 1759402656926, Thread 3562: XXXX 1759402656926, Exiting Thread 3562: Commands::runScriptBasic  
3562 1759402657026 XXXX 1759402657026, Thread 3562: XXXX 1759402657026, Entering Thread 3562: Commands::runScriptBasic, script name = GetHaltStatus, timeOut = -1 ms  
3562 1759402657027 XXXX 1759402657027, Thread 3562: XXXX 1759402657027, Exiting Thread 3562: Commands::runScriptBasic  
3562 1759402657126 XXXX 1759402657126, Thread 3562: XXXX 1759402657126, Entering Thread 3562: Commands::runScriptBasic, script name = GetHaltStatus, timeOut = -1 ms  
3562 1759402657128 XXXX 1759402657128, Thread 3562: XXXX 1759402657128, Exiting Thread 3562: Commands::runScriptBasic  
3562 1759402657227 XXXX 1759402657227, Thread 3562: XXXX 1759402657227, Entering Thread 3562: Commands::runScriptBasic, script name = GetHaltStatus, timeOut = -1 ms  
3562 1759402657228 XXXX 1759402657228, Thread 3562: XXXX 1759402657228, Exiting Thread 3562: Commands::runScriptBasic  
3562 1759402657327 XXXX 1759402657327, Thread 3562: XXXX 1759402657327, Entering Thread 3562: Commands::runScriptBasic, script name = GetHaltStatus, timeOut = -1 ms  
3562 1759402657328 XXXX 1759402657328, Thread 3562: XXXX 1759402657328, Exiting Thread 3562: Commands::runScriptBasic  
3562 1759402657427 XXXX 1759402657427, Thread 3562: XXXX 1759402657427, Entering Thread 3562: Commands::runScriptBasic, script name = GetHaltStatus, timeOut = -1 ms  
3562 1759402657428 XXXX 1759402657428, Thread 3562: XXXX 1759402657428, Exiting Thread 3562: Commands::runScriptBasic  
3562 1759402657527 XXXX 1759402657527, Thread 3562: XXXX 1759402657527, Entering Thread 3562: Commands::runScriptBasic, script name = GetHaltStatus, timeOut = -1 ms  
3562 1759402657528 XXXX 1759402657528, Thread 3562: XXXX 1759402657528, Exiting Thread 3562: Commands::runScriptBasic  
3562 1759402657629 XXXX 1759402657629, Thread 3562: XXXX 1759402657629, Entering Thread 3562: Commands::runScriptBasic, script name = GetHaltStatus, timeOut = -1 ms  
3562 1759402657630 XXXX 1759402657630, Thread 3562: XXXX 1759402657630, Exiting Thread 3562: Commands::runScriptBasic  
3562 1759402657729 XXXX 1759402657729, Thread 3562: XXXX 1759402657729, Entering Thread 3562: Commands::runScriptBasic, script name = GetHaltStatus, timeOut = -1 ms  
3562 1759402657730 XXXX 1759402657730, Thread 3562: XXXX 1759402657730, Exiting Thread 3562: Commands::runScriptBasic  
3562 1759402657830 XXXX 1759402657830, Thread 3562: XXXX 1759402657830, Entering Thread 3562: Commands::runScriptBasic, script name = GetHaltStatus, timeOut = -1 ms  
3562 1759402657831 XXXX 1759402657831, Thread 3562: XXXX 1759402657831, Exiting Thread 3562: Commands::runScriptBasic  
3562 1759402657930 XXXX 1759402657930, Thread 3562: XXXX 1759402657930, Entering Thread 3562: Commands::runScriptBasic, script name = GetHaltStatus, timeOut = -1 ms  
3562 1759402657932 XXXX 1759402657932, Thread 3562: XXXX 1759402657932, Exiting Thread 3562: Commands::runScriptBasic  
3562 1759402658030 XXXX 1759402658030, Thread 3562: XXXX 1759402658030, Entering Thread 3562: Commands::runScriptBasic, script name = GetHaltStatus, timeOut = -1 ms  
3562 1759402658031 XXXX 1759402658031, Thread 3562: XXXX 1759402658031, Exiting Thread 3562: Commands::runScriptBasic  
3562 1759402658132 XXXX 1759402658132, Thread 3562: XXXX 1759402658132, Entering Thread 3562: Commands::runScriptBasic, script name = GetHaltStatus, timeOut = -1 ms  
3562 1759402658133 XXXX 1759402658133, Thread 3562: XXXX 1759402658133, Exiting Thread 3562: Commands::runScriptBasic  
3562 1759402658232 XXXX 1759402658232, Thread 3562: XXXX 1759402658232, Entering Thread 3562: Commands::runScriptBasic, script name = GetHaltStatus, timeOut = -1 ms  
3562 1759402658233 XXXX 1759402658233, Thread 3562: XXXX 1759402658233, Exiting Thread 3562: Commands::runScriptBasic  
3562 1759402658334 XXXX 1759402658334, Thread 3562: XXXX 1759402658334, Entering Thread 3562: Commands::runScriptBasic, script name = GetHaltStatus, timeOut = -1 ms  
3562 1759402658334 XXXX 1759402658334, Thread 3562: XXXX 1759402658334, Exiting Thread 3562: Commands::runScriptBasic  
3562 1759402658434 XXXX 1759402658434, Thread 3562: XXXX 1759402658434, Entering Thread 3562: Commands::runScriptBasic, script name = GetHaltStatus, timeOut = -1 ms  
3562 1759402658436 XXXX 1759402658436, Thread 3562: XXXX 1759402658436, Exiting Thread 3562: Commands::runScriptBasic  
3562 1759402658535 XXXX 1759402658535, Thread 3562: XXXX 1759402658535, Entering Thread 3562: Commands::runScriptBasic, script name = GetHaltStatus, timeOut = -1 ms  
3562 1759402658537 XXXX 1759402658537, Thread 3562: XXXX 1759402658537, Exiting Thread 3562: Commands::runScriptBasic  
3562 1759402658636 XXXX 1759402658636, Thread 3562: XXXX 1759402658636, Entering Thread 3562: Commands::runScriptBasic, script name = GetHaltStatus, timeOut = -1 ms  
3562 1759402658637 XXXX 1759402658637, Thread 3562: XXXX 1759402658637, Exiting Thread 3562: Commands::runScriptBasic  
3562 1759402658736 XXXX 1759402658736, Thread 3562: XXXX 1759402658736, Entering Thread 3562: Commands::runScriptBasic, script name = GetHaltStatus, timeOut = -1 ms  
3562 1759402658737 XXXX 1759402658737, Thread 3562: XXXX 1759402658737, Exiting Thread 3562: Commands::runScriptBasic  
3562 1759402658837 XXXX 1759402658837, Thread 3562: XXXX 1759402658837, Entering Thread 3562: Commands::runScriptBasic, script name = GetHaltStatus, timeOut = -1 ms  
3562 1759402658838 XXXX 1759402658838, Thread 3562: XXXX 1759402658838, Exiting Thread 3562: Commands::runScriptBasic  
3562 1759402658937 XXXX 1759402658937, Thread 3562: XXXX 1759402658937, Entering Thread 3562: Commands::runScriptBasic, script name = GetHaltStatus, timeOut = -1 ms  
3562 1759402658938 XXXX 1759402658938, Thread 3562: XXXX 1759402658938, Exiting Thread 3562: Commands::runScriptBasic  
3562 1759402659037 XXXX 1759402659037, Thread 3562: XXXX 1759402659037, Entering Thread 3562: Commands::runScriptBasic, script name = GetHaltStatus, timeOut = -1 ms  
3562 1759402659038 XXXX 1759402659038, Thread 3562: XXXX 1759402659038, Exiting Thread 3562: Commands::runScriptBasic  
3562 1759402659138 XXXX 1759402659138, Thread 3562: XXXX 1759402659138, Entering Thread 3562: Commands::runScriptBasic, script name = GetHaltStatus, timeOut = -1 ms  
3562 1759402659139 XXXX 1759402659139, Thread 3562: XXXX 1759402659139, Exiting Thread 3562: Commands::runScriptBasic  
3562 1759402659239 XXXX 1759402659239, Thread 3562: XXXX 1759402659239, Entering Thread 3562: Commands::runScriptBasic, script name = GetHaltStatus, timeOut = -1 ms  
3562 1759402659240 XXXX 1759402659240, Thread 3562: XXXX 1759402659240, Exiting Thread 3562: Commands::runScriptBasic  
3562 1759402659340 XXXX 1759402659340, Thread 3562: XXXX 1759402659340, Entering Thread 3562: Commands::runScriptBasic, script name = GetHaltStatus, timeOut = -1 ms  
3562 1759402659341 XXXX 1759402659341, Thread 3562: XXXX 1759402659341, Exiting Thread 3562: Commands::runScriptBasic  
3562 1759402659440 XXXX 1759402659440, Thread 3562: XXXX 1759402659440, Entering Thread 3562: Commands::runScriptBasic, script name = GetHaltStatus, timeOut = -1 ms  
3562 1759402659441 XXXX 1759402659441, Thread 3562: XXXX 1759402659441, Exiting Thread 3562: Commands::runScriptBasic  
3562 1759402659542 XXXX 1759402659542, Thread 3562: XXXX 1759402659542, Entering Thread 3562: Commands::runScriptBasic, script name = GetHaltStatus, timeOut = -1 ms  
3562 1759402659543 XXXX 1759402659543, Thread 3562: XXXX 1759402659543, Exiting Thread 3562: Commands::runScriptBasic  
3562 1759402659642 XXXX 1759402659642, Thread 3562: XXXX 1759402659642, Entering Thread 3562: Commands::runScriptBasic, script name = GetHaltStatus, timeOut = -1 ms  
3562 1759402659644 XXXX 1759402659644, Thread 3562: XXXX 1759402659644, Exiting Thread 3562: Commands::runScriptBasic  
3562 1759402659744 XXXX 1759402659744, Thread 3562: XXXX 1759402659744, Entering Thread 3562: Commands::runScriptBasic, script name = GetHaltStatus, timeOut = -1 ms  
3562 1759402659745 XXXX 1759402659745, Thread 3562: XXXX 1759402659745, Exiting Thread 3562: Commands::runScriptBasic  
3562 1759402659844 XXXX 1759402659844, Thread 3562: XXXX 1759402659844, Entering Thread 3562: Commands::runScriptBasic, script name = GetHaltStatus, timeOut = -1 ms  
3562 1759402659845 XXXX 1759402659845, Thread 3562: XXXX 1759402659845, Exiting Thread 3562: Commands::runScriptBasic  
3562 1759402659946 XXXX 1759402659946, Thread 3562: XXXX 1759402659946, Entering Thread 3562: Commands::runScriptBasic, script name = GetHaltStatus, timeOut = -1 ms  
3562 1759402659947 XXXX 1759402659947, Thread 3562: XXXX 1759402659947, Exiting Thread 3562: Commands::runScriptBasic  
3562 1759402660048 XXXX 1759402660048, Thread 3562: XXXX 1759402660048, Entering Thread 3562: Commands::runScriptBasic, script name = GetHaltStatus, timeOut = -1 ms  
3562 1759402660049 XXXX 1759402660049, Thread 3562: XXXX 1759402660049, Exiting Thread 3562: Commands::runScriptBasic  
3562 1759402660148 XXXX 1759402660148, Thread 3562: XXXX 1759402660148, Entering Thread 3562: Commands::runScriptBasic, script name = GetHaltStatus, timeOut = -1 ms  
3562 1759402660149 XXXX 1759402660149, Thread 3562: XXXX 1759402660149, Exiting Thread 3562: Commands::runScriptBasic  
3562 1759402660248 XXXX 1759402660248, Thread 3562: XXXX 1759402660248, Entering Thread 3562: Commands::runScriptBasic, script name = GetHaltStatus, timeOut = -1 ms  
3562 1759402660250 XXXX 1759402660250, Thread 3562: XXXX 1759402660250, Exiting Thread 3562: Commands::runScriptBasic  
3562 1759402660349 XXXX 1759402660349, Thread 3562: XXXX 1759402660349, Entering Thread 3562: Commands::runScriptBasic, script name = GetHaltStatus, timeOut = -1 ms  
3562 1759402660350 XXXX 1759402660350, Thread 3562: XXXX 1759402660350, Exiting Thread 3562: Commands::runScriptBasic  
3562 1759402660449 XXXX 1759402660449, Thread 3562: XXXX 1759402660449, Entering Thread 3562: Commands::runScriptBasic, script name = GetHaltStatus, timeOut = -1 ms  
3562 1759402660450 XXXX 1759402660450, Thread 3562: XXXX 1759402660450, Exiting Thread 3562: Commands::runScriptBasic  
3562 1759402660550 XXXX 1759402660550, Thread 3562: XXXX 1759402660550, Entering Thread 3562: Commands::runScriptBasic, script name = GetHaltStatus, timeOut = -1 ms  
3562 1759402660551 XXXX 1759402660551, Thread 3562: XXXX 1759402660551, Exiting Thread 3562: Commands::runScriptBasic  
3562 1759402660652 XXXX 1759402660652, Thread 3562: XXXX 1759402660652, Entering Thread 3562: Commands::runScriptBasic, script name = GetHaltStatus, timeOut = -1 ms  
3562 1759402660653 XXXX 1759402660653, Thread 3562: XXXX 1759402660653, Exiting Thread 3562: Commands::runScriptBasic  
3562 1759402660753 XXXX 1759402660753, Thread 3562: XXXX 1759402660753, Entering Thread 3562: Commands::runScriptBasic, script name = GetHaltStatus, timeOut = -1 ms  
3562 1759402660754 XXXX 1759402660754, Thread 3562: XXXX 1759402660754, Exiting Thread 3562: Commands::runScriptBasic  
3562 1759402660853 XXXX 1759402660853, Thread 3562: XXXX 1759402660853, Entering Thread 3562: Commands::runScriptBasic, script name = GetHaltStatus, timeOut = -1 ms  
3562 1759402660854 XXXX 1759402660854, Thread 3562: XXXX 1759402660854, Exiting Thread 3562: Commands::runScriptBasic  
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
3562 1759402663366 XXXX 1759402663366, Thread 3562: XXXX 1759402663366, Entering Thread 3562: Commands::runScriptBasic, script name = GetHaltStatus, timeOut = -1 ms  
3562 1759402663367 XXXX 1759402663367, Thread 3562: XXXX 1759402663367, Exiting Thread 3562: Commands::runScriptBasic  
3562 1759402663466 XXXX 1759402663466, Thread 3562: XXXX 1759402663466, Entering Thread 3562: Commands::runScriptBasic, script name = GetHaltStatus, timeOut = -1 ms  
3562 1759402663467 XXXX 1759402663467, Thread 3562: XXXX 1759402663467, Exiting Thread 3562: Commands::runScriptBasic  
3562 1759402663568 XXXX 1759402663568, Thread 3562: XXXX 1759402663568, Entering Thread 3562: Commands::runScriptBasic, script name = GetHaltStatus, timeOut = -1 ms  
3562 1759402663569 XXXX 1759402663569, Thread 3562: XXXX 1759402663569, Exiting Thread 3562: Commands::runScriptBasic  
3562 1759402663668 XXXX 1759402663668, Thread 3562: XXXX 1759402663668, Entering Thread 3562: Commands::runScriptBasic, script name = GetHaltStatus, timeOut = -1 ms  
3562 1759402663669 XXXX 1759402663669, Thread 3562: XXXX 1759402663669, Exiting Thread 3562: Commands::runScriptBasic  
3562 1759402663769 XXXX 1759402663769, Thread 3562: XXXX 1759402663769, Entering Thread 3562: Commands::runScriptBasic, script name = GetHaltStatus, timeOut = -1 ms  
3562 1759402663770 XXXX 1759402663770, Thread 3562: XXXX 1759402663770, Exiting Thread 3562: Commands::runScriptBasic  
3562 1759402663870 XXXX 1759402663870, Thread 3562: XXXX 1759402663870, Entering Thread 3562: Commands::runScriptBasic, script name = GetHaltStatus, timeOut = -1 ms  
3562 1759402663871 XXXX 1759402663871, Thread 3562: XXXX 1759402663871, Exiting Thread 3562: Commands::runScriptBasic  
3562 1759402663971 XXXX 1759402663971, Thread 3562: XXXX 1759402663971, Entering Thread 3562: Commands::runScriptBasic, script name = GetHaltStatus, timeOut = -1 ms  
3562 1759402663972 XXXX 1759402663972, Thread 3562: XXXX 1759402663972, Exiting Thread 3562: Commands::runScriptBasic  
3562 1759402664071 XXXX 1759402664071, Thread 3562: XXXX 1759402664071, Entering Thread 3562: Commands::runScriptBasic, script name = GetHaltStatus, timeOut = -1 ms  
3562 1759402664072 XXXX 1759402664072, Thread 3562: XXXX 1759402664072, Exiting Thread 3562: Commands::runScriptBasic  
3562 1759402664173 XXXX 1759402664173, Thread 3562: XXXX 1759402664173, Entering Thread 3562: Commands::runScriptBasic, script name = GetHaltStatus, timeOut = -1 ms  
3562 1759402664173 XXXX 1759402664173, Thread 3562: XXXX 1759402664173, Exiting Thread 3562: Commands::runScriptBasic  
3562 1759402664274 XXXX 1759402664274, Thread 3562: XXXX 1759402664274, Entering Thread 3562: Commands::runScriptBasic, script name = GetHaltStatus, timeOut = -1 ms  
3562 1759402664275 XXXX 1759402664275, Thread 3562: XXXX 1759402664275, Exiting Thread 3562: Commands::runScriptBasic  
3562 1759402664376 XXXX 1759402664376, Thread 3562: XXXX 1759402664376, Entering Thread 3562: Commands::runScriptBasic, script name = GetHaltStatus, timeOut = -1 ms  
3562 1759402664377 XXXX 1759402664377, Thread 3562: XXXX 1759402664377, Exiting Thread 3562: Commands::runScriptBasic  
3562 1759402664477 XXXX 1759402664477, Thread 3562: XXXX 1759402664477, Entering Thread 3562: Commands::runScriptBasic, script name = GetHaltStatus, timeOut = -1 ms  
3562 1759402664478 XXXX 1759402664478, Thread 3562: XXXX 1759402664478, Exiting Thread 3562: Commands::runScriptBasic  
3562 1759402664578 XXXX 1759402664578, Thread 3562: XXXX 1759402664578, Entering Thread 3562: Commands::runScriptBasic, script name = GetHaltStatus, timeOut = -1 ms  
3562 1759402664579 XXXX 1759402664579, Thread 3562: XXXX 1759402664579, Exiting Thread 3562: Commands::runScriptBasic  
3562 1759402664679 XXXX 1759402664679, Thread 3562: XXXX 1759402664679, Entering Thread 3562: Commands::runScriptBasic, script name = GetHaltStatus, timeOut = -1 ms  
3562 1759402664680 XXXX 1759402664680, Thread 3562: XXXX 1759402664680, Exiting Thread 3562: Commands::runScriptBasic  
3562 1759402664779 XXXX 1759402664779, Thread 3562: XXXX 1759402664779, Entering Thread 3562: Commands::runScriptBasic, script name = GetHaltStatus, timeOut = -1 ms  
3562 1759402664780 XXXX 1759402664780, Thread 3562: XXXX 1759402664780, Exiting Thread 3562: Commands::runScriptBasic  
3562 1759402664881 XXXX 1759402664881, Thread 3562: XXXX 1759402664881, Entering Thread 3562: Commands::runScriptBasic, script name = GetHaltStatus, timeOut = -1 ms  
3562 1759402664883 XXXX 1759402664883, Thread 3562: XXXX 1759402664883, Exiting Thread 3562: Commands::runScriptBasic  
3562 1759402664981 XXXX 1759402664981, Thread 3562: XXXX 1759402664981, Entering Thread 3562: Commands::runScriptBasic, script name = GetHaltStatus, timeOut = -1 ms  
3562 1759402664982 XXXX 1759402664982, Thread 3562: XXXX 1759402664982, Exiting Thread 3562: Commands::runScriptBasic  
3562 1759402665081 XXXX 1759402665081, Thread 3562: XXXX 1759402665081, Entering Thread 3562: Commands::runScriptBasic, script name = GetHaltStatus, timeOut = -1 ms  
3562 1759402665082 XXXX 1759402665082, Thread 3562: XXXX 1759402665082, Exiting Thread 3562: Commands::runScriptBasic  
3562 1759402665181 XXXX 1759402665181, Thread 3562: XXXX 1759402665181, Entering Thread 3562: Commands::runScriptBasic, script name = GetHaltStatus, timeOut = -1 ms  
3562 1759402665182 XXXX 1759402665182, Thread 3562: XXXX 1759402665182, Exiting Thread 3562: Commands::runScriptBasic  
3562 1759402665282 XXXX 1759402665282, Thread 3562: XXXX 1759402665282, Entering Thread 3562: Commands::runScriptBasic, script name = GetHaltStatus, timeOut = -1 ms  
3562 1759402665283 XXXX 1759402665283, Thread 3562: XXXX 1759402665283, Exiting Thread 3562: Commands::runScriptBasic  
3562 1759402665382 XXXX 1759402665382, Thread 3562: XXXX 1759402665382, Entering Thread 3562: Commands::runScriptBasic, script name = GetHaltStatus, timeOut = -1 ms  
3562 1759402665383 XXXX 1759402665383, Thread 3562: XXXX 1759402665383, Exiting Thread 3562: Commands::runScriptBasic  
3562 1759402665483 XXXX 1759402665483, Thread 3562: XXXX 1759402665483, Entering Thread 3562: Commands::runScriptBasic, script name = GetHaltStatus, timeOut = -1 ms  
3562 1759402665485 XXXX 1759402665485, Thread 3562: XXXX 1759402665485, Exiting Thread 3562: Commands::runScriptBasic  
3562 1759402665584 XXXX 1759402665584, Thread 3562: XXXX 1759402665584, Entering Thread 3562: Commands::runScriptBasic, script name = GetHaltStatus, timeOut = -1 ms  
3562 1759402665585 XXXX 1759402665585, Thread 3562: XXXX 1759402665585, Exiting Thread 3562: Commands::runScriptBasic  
3562 1759402665684 XXXX 1759402665684, Thread 3562: XXXX 1759402665684, Entering Thread 3562: Commands::runScriptBasic, script name = GetHaltStatus, timeOut = -1 ms  
3562 1759402665684 XXXX 1759402665684, Thread 3562: XXXX 1759402665684, Exiting Thread 3562: Commands::runScriptBasic  
3562 1759402665785 XXXX 1759402665785, Thread 3562: XXXX 1759402665785, Entering Thread 3562: Commands::runScriptBasic, script name = GetHaltStatus, timeOut = -1 ms  
3562 1759402665786 XXXX 1759402665786, Thread 3562: XXXX 1759402665786, Exiting Thread 3562: Commands::runScriptBasic  
3562 1759402665885 XXXX 1759402665885, Thread 3562: XXXX 1759402665885, Entering Thread 3562: Commands::runScriptBasic, script name = GetHaltStatus, timeOut = -1 ms  
3562 1759402665887 XXXX 1759402665887, Thread 3562: XXXX 1759402665887, Exiting Thread 3562: Commands::runScriptBasic  
3562 1759402665986 XXXX 1759402665986, Thread 3562: XXXX 1759402665986, Entering Thread 3562: Commands::runScriptBasic, script name = GetHaltStatus, timeOut = -1 ms  
3562 1759402665987 XXXX 1759402665987, Thread 3562: XXXX 1759402665987, Exiting Thread 3562: Commands::runScriptBasic  
3562 1759402666086 XXXX 1759402666086, Thread 3562: XXXX 1759402666086, Entering Thread 3562: Commands::runScriptBasic, script name = GetHaltStatus, timeOut = -1 ms  
3562 1759402666087 XXXX 1759402666087, Thread 3562: XXXX 1759402666087, Exiting Thread 3562: Commands::runScriptBasic  
3562 1759402666187 XXXX 1759402666187, Thread 3562: XXXX 1759402666187, Entering Thread 3562: Commands::runScriptBasic, script name = GetHaltStatus, timeOut = -1 ms  
3562 1759402666188 XXXX 1759402666188, Thread 3562: XXXX 1759402666188, Exiting Thread 3562: Commands::runScriptBasic  
3562 1759402666289 XXXX 1759402666289, Thread 3562: XXXX 1759402666289, Entering Thread 3562: Commands::runScriptBasic, script name = GetHaltStatus, timeOut = -1 ms  
3562 1759402666290 XXXX 1759402666290, Thread 3562: XXXX 1759402666290, Exiting Thread 3562: Commands::runScriptBasic  
3562 1759402666391 XXXX 1759402666391, Thread 3562: XXXX 1759402666391, Entering Thread 3562: Commands::runScriptBasic, script name = GetHaltStatus, timeOut = -1 ms  
3562 1759402666391 XXXX 1759402666391, Thread 3562: XXXX 1759402666391, Exiting Thread 3562: Commands::runScriptBasic  
3562 1759402666491 XXXX 1759402666491, Thread 3562: XXXX 1759402666491, Entering Thread 3562: Commands::runScriptBasic, script name = GetHaltStatus, timeOut = -1 ms  
3562 1759402666493 XXXX 1759402666493, Thread 3562: XXXX 1759402666493, Exiting Thread 3562: Commands::runScriptBasic  
3562 1759402666591 XXXX 1759402666591, Thread 3562: XXXX 1759402666591, Entering Thread 3562: Commands::runScriptBasic, script name = GetHaltStatus, timeOut = -1 ms  
3562 1759402666592 XXXX 1759402666592, Thread 3562: XXXX 1759402666592, Exiting Thread 3562: Commands::runScriptBasic  
3562 1759402666691 XXXX 1759402666691, Thread 3562: XXXX 1759402666691, Entering Thread 3562: Commands::runScriptBasic, script name = GetHaltStatus, timeOut = -1 ms  
3562 1759402666692 XXXX 1759402666692, Thread 3562: XXXX 1759402666692, Exiting Thread 3562: Commands::runScriptBasic  
3562 1759402666791 XXXX 1759402666791, Thread 3562: XXXX 1759402666791, Entering Thread 3562: Commands::runScriptBasic, script name = GetHaltStatus, timeOut = -1 ms  
3562 1759402666792 XXXX 1759402666792, Thread 3562: XXXX 1759402666792, Exiting Thread 3562: Commands::runScriptBasic  
3562 1759402666893 XXXX 1759402666893, Thread 3562: XXXX 1759402666893, Entering Thread 3562: Commands::runScriptBasic, script name = GetHaltStatus, timeOut = -1 ms  
3562 1759402666894 XXXX 1759402666894, Thread 3562: XXXX 1759402666894, Exiting Thread 3562: Commands::runScriptBasic  
3562 1759402666994 XXXX 1759402666994, Thread 3562: XXXX 1759402666994, Entering Thread 3562: Commands::runScriptBasic, script name = GetHaltStatus, timeOut = -1 ms  
3562 1759402666995 XXXX 1759402666995, Thread 3562: XXXX 1759402666995, Exiting Thread 3562: Commands::runScriptBasic  
3562 1759402667094 XXXX 1759402667094, Thread 3562: XXXX 1759402667094, Entering Thread 3562: Commands::runScriptBasic, script name = GetHaltStatus, timeOut = -1 ms  
3562 1759402667096 XXXX 1759402667096, Thread 3562: XXXX 1759402667096, Exiting Thread 3562: Commands::runScriptBasic  
3562 1759402667194 XXXX 1759402667194, Thread 3562: XXXX 1759402667194, Entering Thread 3562: Commands::runScriptBasic, script name = GetHaltStatus, timeOut = -1 ms  
3562 1759402667195 XXXX 1759402667195, Thread 3562: XXXX 1759402667195, Exiting Thread 3562: Commands::runScriptBasic  
3562 1759402667295 XXXX 1759402667295, Thread 3562: XXXX 1759402667295, Entering Thread 3562: Commands::runScriptBasic, script name = GetHaltStatus, timeOut = -1 ms  
3562 1759402667296 XXXX 1759402667296, Thread 3562: XXXX 1759402667296, Exiting Thread 3562: Commands::runScriptBasic  
3562 1759402667398 XXXX 1759402667398, Thread 3562: XXXX 1759402667397, Entering Thread 3562: Commands::runScriptBasic, script name = GetHaltStatus, timeOut = -1 ms  
3562 1759402667399 XXXX 1759402667399, Thread 3562: XXXX 1759402667399, Exiting Thread 3562: Commands::runScriptBasic  
3562 1759402667498 XXXX 1759402667498, Thread 3562: XXXX 1759402667498, Entering Thread 3562: Commands::runScriptBasic, script name = GetHaltStatus, timeOut = -1 ms  
3562 1759402667499 XXXX 1759402667499, Thread 3562: XXXX 1759402667499, Exiting Thread 3562: Commands::runScriptBasic  
3562 1759402667600 XXXX 1759402667600, Thread 3562: XXXX 1759402667600, Entering Thread 3562: Commands::runScriptBasic, script name = GetHaltStatus, timeOut = -1 ms  
3562 1759402667601 XXXX 1759402667601, Thread 3562: XXXX 1759402667601, Exiting Thread 3562: Commands::runScriptBasic  
3562 1759402667700 XXXX 1759402667700, Thread 3562: XXXX 1759402667700, Entering Thread 3562: Commands::runScriptBasic, script name = GetHaltStatus, timeOut = -1 ms  
3562 1759402667701 XXXX 1759402667701, Thread 3562: XXXX 1759402667701, Exiting Thread 3562: Commands::runScriptBasic  
3562 1759402667801 XXXX 1759402667801, Thread 3562: XXXX 1759402667801, Entering Thread 3562: Commands::runScriptBasic, script name = GetHaltStatus, timeOut = -1 ms  
3562 1759402667802 XXXX 1759402667802, Thread 3562: XXXX 1759402667802, Exiting Thread 3562: Commands::runScriptBasic  
3562 1759402667901 XXXX 1759402667901, Thread 3562: XXXX 1759402667901, Entering Thread 3562: Commands::runScriptBasic, script name = GetHaltStatus, timeOut = -1 ms  
3562 1759402667903 XXXX 1759402667903, Thread 3562: XXXX 1759402667903, Exiting Thread 3562: Commands::runScriptBasic  
3562 1759402668002 XXXX 1759402668002, Thread 3562: XXXX 1759402668002, Entering Thread 3562: Commands::runScriptBasic, script name = GetHaltStatus, timeOut = -1 ms  
3562 1759402668003 XXXX 1759402668003, Thread 3562: XXXX 1759402668003, Exiting Thread 3562: Commands::runScriptBasic  
3562 1759402668102 XXXX 1759402668102, Thread 3562: XXXX 1759402668102, Entering Thread 3562: Commands::runScriptBasic, script name = GetHaltStatus, timeOut = -1 ms  
3562 1759402668104 XXXX 1759402668104, Thread 3562: XXXX 1759402668104, Exiting Thread 3562: Commands::runScriptBasic  
3562 1759402668203 XXXX 1759402668203, Thread 3562: XXXX 1759402668203, Entering Thread 3562: Commands::runScriptBasic, script name = GetHaltStatus, timeOut = -1 ms  
3562 1759402668204 XXXX 1759402668204, Thread 3562: XXXX 1759402668204, Exiting Thread 3562: Commands::runScriptBasic  
3562 1759402668304 XXXX 1759402668304, Thread 3562: XXXX 1759402668304, Entering Thread 3562: Commands::runScriptBasic, script name = GetHaltStatus, timeOut = -1 ms  
3562 1759402668306 XXXX 1759402668306, Thread 3562: XXXX 1759402668306, Exiting Thread 3562: Commands::runScriptBasic  
3562 1759402668404 XXXX 1759402668404, Thread 3562: XXXX 1759402668404, Entering Thread 3562: Commands::runScriptBasic, script name = GetHaltStatus, timeOut = -1 ms  
3562 1759402668405 XXXX 1759402668405, Thread 3562: XXXX 1759402668405, Exiting Thread 3562: Commands::runScriptBasic  
3562 1759402668505 XXXX 1759402668505, Thread 3562: XXXX 1759402668505, Entering Thread 3562: Commands::runScriptBasic, script name = GetHaltStatus, timeOut = -1 ms  
3562 1759402668507 XXXX 1759402668507, Thread 3562: XXXX 1759402668507, Exiting Thread 3562: Commands::runScriptBasic  
3562 1759402668606 XXXX 1759402668606, Thread 3562: XXXX 1759402668606, Entering Thread 3562: Commands::runScriptBasic, script name = GetHaltStatus, timeOut = -1 ms  
3562 1759402668607 XXXX 1759402668607, Thread 3562: XXXX 1759402668607, Exiting Thread 3562: Commands::runScriptBasic  
3562 1759402668707 XXXX 1759402668707, Thread 3562: XXXX 1759402668707, Entering Thread 3562: Commands::runScriptBasic, script name = GetHaltStatus, timeOut = -1 ms  
3562 1759402668708 XXXX 1759402668708, Thread 3562: XXXX 1759402668708, Exiting Thread 3562: Commands::runScriptBasic  
3562 1759402668807 XXXX 1759402668807, Thread 3562: XXXX 1759402668807, Entering Thread 3562: Commands::runScriptBasic, script name = GetHaltStatus, timeOut = -1 ms  
3562 1759402668808 XXXX 1759402668808, Thread 3562: XXXX 1759402668808, Exiting Thread 3562: Commands::runScriptBasic  
3562 1759402668907 XXXX 1759402668907, Thread 3562: XXXX 1759402668907, Entering Thread 3562: Commands::runScriptBasic, script name = GetHaltStatus, timeOut = -1 ms  
3562 1759402668908 XXXX 1759402668908, Thread 3562: XXXX 1759402668908, Exiting Thread 3562: Commands::runScriptBasic  
3562 1759402669007 XXXX 1759402669007, Thread 3562: XXXX 1759402669007, Entering Thread 3562: Commands::runScriptBasic, script name = GetHaltStatus, timeOut = -1 ms  
3562 1759402669009 XXXX 1759402669009, Thread 3562: XXXX 1759402669009, Exiting Thread 3562: Commands::runScriptBasic  
3562 1759402669107 XXXX 1759402669107, Thread 3562: XXXX 1759402669107, Entering Thread 3562: Commands::runScriptBasic, script name = GetHaltStatus, timeOut = -1 ms  
3562 1759402669108 XXXX 1759402669108, Thread 3562: XXXX 1759402669108, Exiting Thread 3562: Commands::runScriptBasic  
3562 1759402669209 XXXX 1759402669209, Thread 3562: XXXX 1759402669209, Entering Thread 3562: Commands::runScriptBasic, script name = GetHaltStatus, timeOut = -1 ms  
3562 1759402669209 XXXX 1759402669209, Thread 3562: XXXX 1759402669209, Exiting Thread 3562: Commands::runScriptBasic  
3562 1759402669311 XXXX 1759402669311, Thread 3562: XXXX 1759402669311, Entering Thread 3562: Commands::runScriptBasic, script name = GetHaltStatus, timeOut = -1 ms  
3562 1759402669312 XXXX 1759402669312, Thread 3562: XXXX 1759402669312, Exiting Thread 3562: Commands::runScriptBasic  
3562 1759402669412 XXXX 1759402669412, Thread 3562: XXXX 1759402669412, Entering Thread 3562: Commands::runScriptBasic, script name = GetHaltStatus, timeOut = -1 ms  
3562 1759402669413 XXXX 1759402669413, Thread 3562: XXXX 1759402669413, Exiting Thread 3562: Commands::runScriptBasic  
3562 1759402669512 XXXX 1759402669512, Thread 3562: XXXX 1759402669512, Entering Thread 3562: Commands::runScriptBasic, script name = GetHaltStatus, timeOut = -1 ms  
3562 1759402669513 XXXX 1759402669513, Thread 3562: XXXX 1759402669513, Exiting Thread 3562: Commands::runScriptBasic  
3562 1759402669612 XXXX 1759402669612, Thread 3562: XXXX 1759402669612, Entering Thread 3562: Commands::runScriptBasic, script name = GetHaltStatus, timeOut = -1 ms  
3562 1759402669613 XXXX 1759402669613, Thread 3562: XXXX 1759402669613, Exiting Thread 3562: Commands::runScriptBasic  
3562 1759402669714 XXXX 1759402669714, Thread 3562: XXXX 1759402669714, Entering Thread 3562: Commands::runScriptBasic, script name = GetHaltStatus, timeOut = -1 ms  
3562 1759402669715 XXXX 1759402669715, Thread 3562: XXXX 1759402669715, Exiting Thread 3562: Commands::runScriptBasic  
3562 1759402669814 XXXX 1759402669814, Thread 3562: XXXX 1759402669814, Entering Thread 3562: Commands::runScriptBasic, script name = GetHaltStatus, timeOut = -1 ms  
3562 1759402669815 XXXX 1759402669815, Thread 3562: XXXX 1759402669815, Exiting Thread 3562: Commands::runScriptBasic  
3562 1759402669915 XXXX 1759402669915, Thread 3562: XXXX 1759402669915, Entering Thread 3562: Commands::runScriptBasic, script name = GetHaltStatus, timeOut = -1 ms  
3562 1759402669917 XXXX 1759402669917, Thread 3562: XXXX 1759402669917, Exiting Thread 3562: Commands::runScriptBasic  
3562 1759402670016 XXXX 1759402670016, Thread 3562: XXXX 1759402670016, Entering Thread 3562: Commands::runScriptBasic, script name = GetHaltStatus, timeOut = -1 ms  
3562 1759402670017 XXXX 1759402670017, Thread 3562: XXXX 1759402670017, Exiting Thread 3562: Commands::runScriptBasic  
3562 1759402670117 XXXX 1759402670117, Thread 3562: XXXX 1759402670117, Entering Thread 3562: Commands::runScriptBasic, script name = GetHaltStatus, timeOut = -1 ms  
3562 1759402670117 XXXX 1759402670117, Thread 3562: XXXX 1759402670117, Exiting Thread 3562: Commands::runScriptBasic  

3562 1759402670119 GEN4_TO_CONTROLLER_LOG:GEN4_DEBUG_INT_LOG_PIC16F13145 Pre:DebugReadTargetMemory
3562 1759402670119 GEN4_TO_CONTROLLER_LOG:GEN4_DEBUG_INT_LOG_PIC16F13145 Payload
3562 1759402670119 GEN4_TO_CONTROLLER_LOG:GEN4_DEBUG_INT_LOG_PIC16F13145 Emulation
3562 1759402670119 GEN4_TO_CONTROLLER_LOG:GEN4_DEBUG_INT_LOG_PIC16F13145 1f91
3562 1759402670119 GEN4_TO_CONTROLLER_LOG:GEN4_DEBUG_INT_LOG_PIC16F13145 1f91
3562 1759402670119 GEN4_TO_CONTROLLER_LOG:GEN4_DEBUG_INT_LOG_PIC16F13145 Length = 4
3562 1759402670119 GEN4_TO_CONTROLLER_LOG:GEN4_DEBUG_INT_LOG_PIC16F13145 Payload End
3562 1759402670119 XXXX 1759402670119, Thread 3562: XXXX 1759402670119, Entering Thread 3562: Commands::runScriptWithUpload, script name = ReadRAM  
3562 1759402670120 XXXX 1759402670120, Thread 3562: XXXX 1759402670120, Entering Thread 3562: ToolCommUsb::readTransfer, sideData is 0x25 bytes long, transferDataLength is 0x4 bytes long  
3562 1759402752156 XXXX 1759402752156, Thread 3562: com.Send returned false
