wakimizufu/MC2/debugVCFSeparate/VCF_CV_antilog_2.png

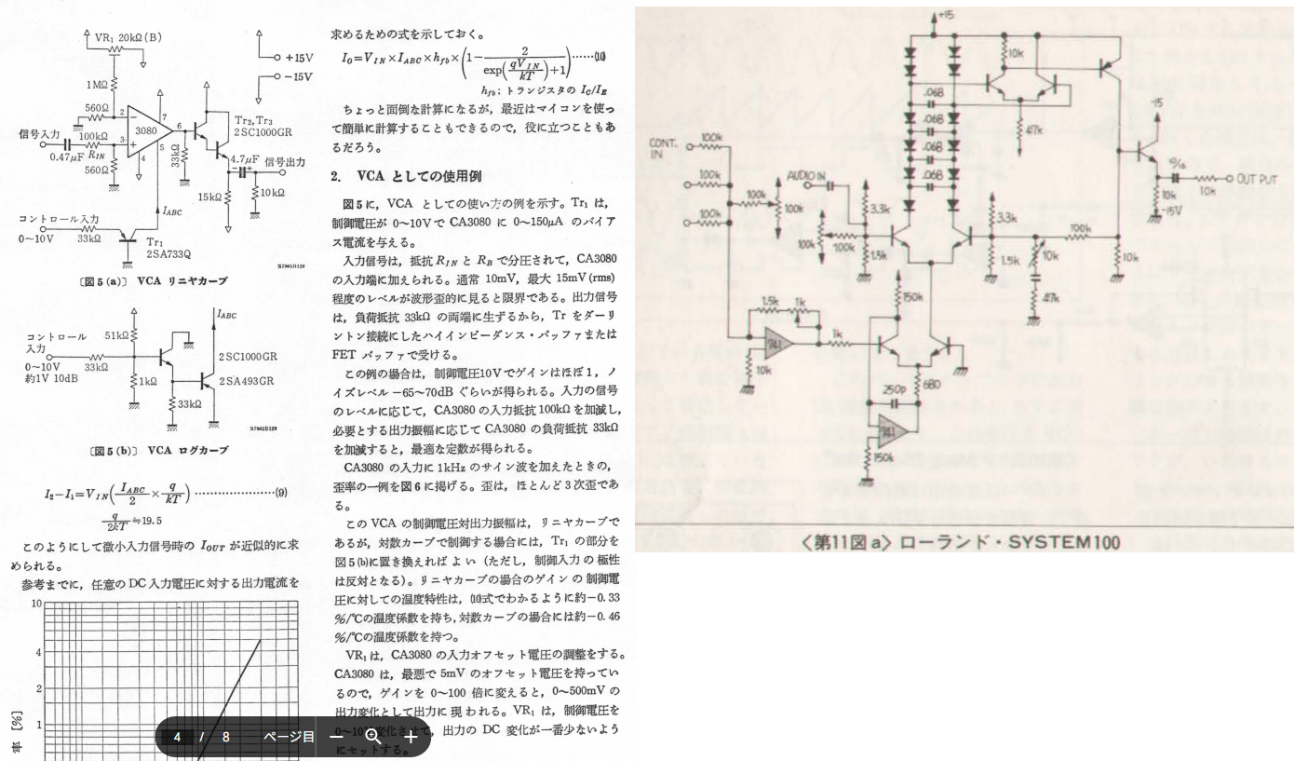
debugVCFSeparate/VCF_CV_antilog_2.png
