wakimizufu/MC2/debugVCFSeparate/debugVCFSeparateRev1.pdf

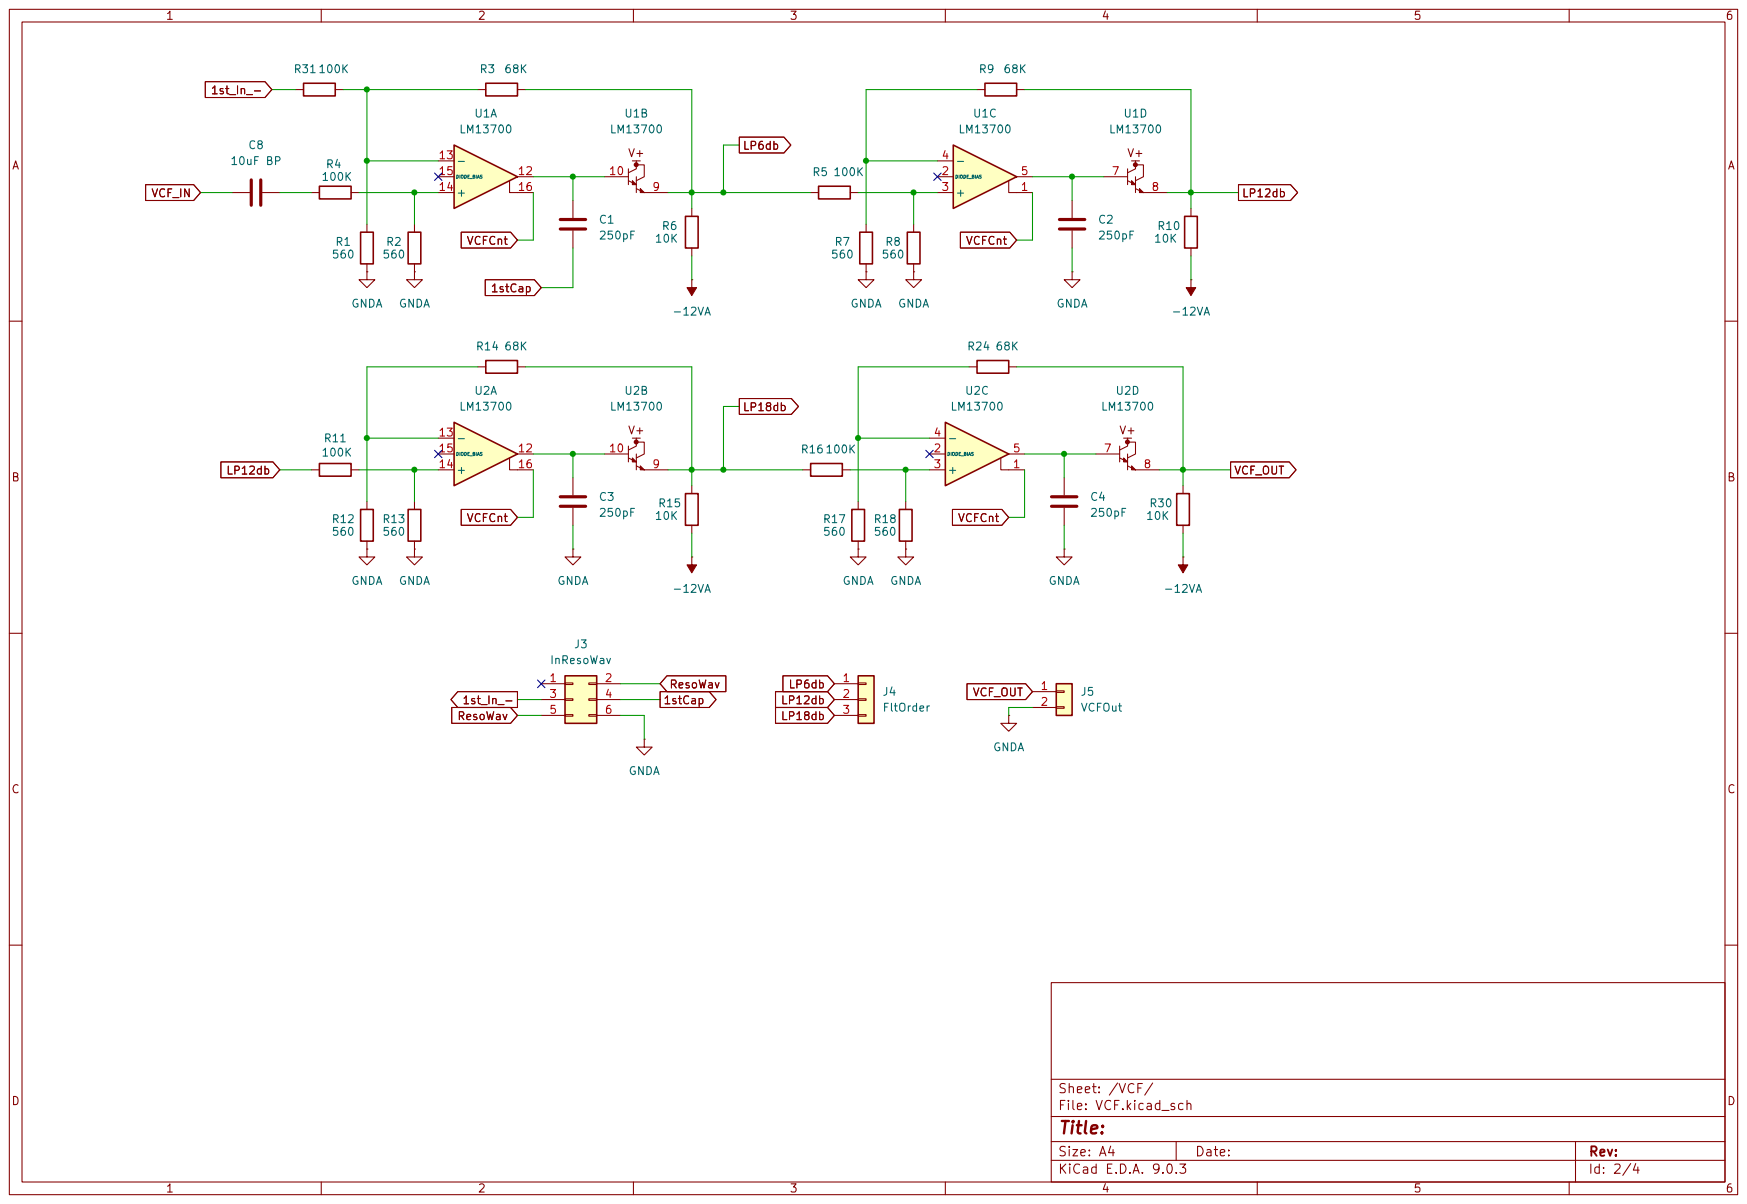
[picture p12: page 1]

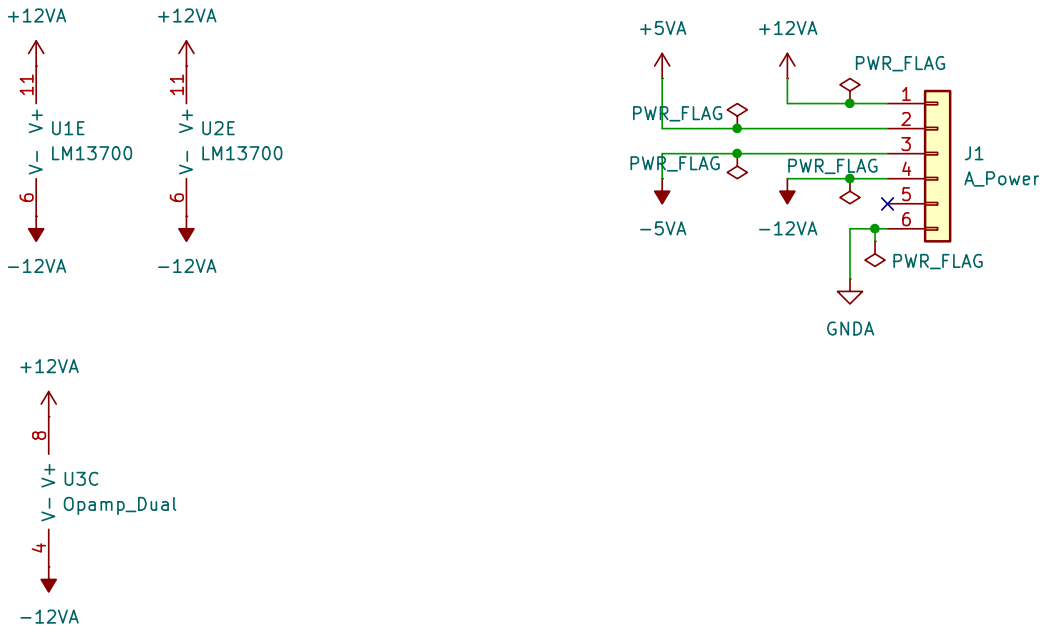
[picture p13: page 2]

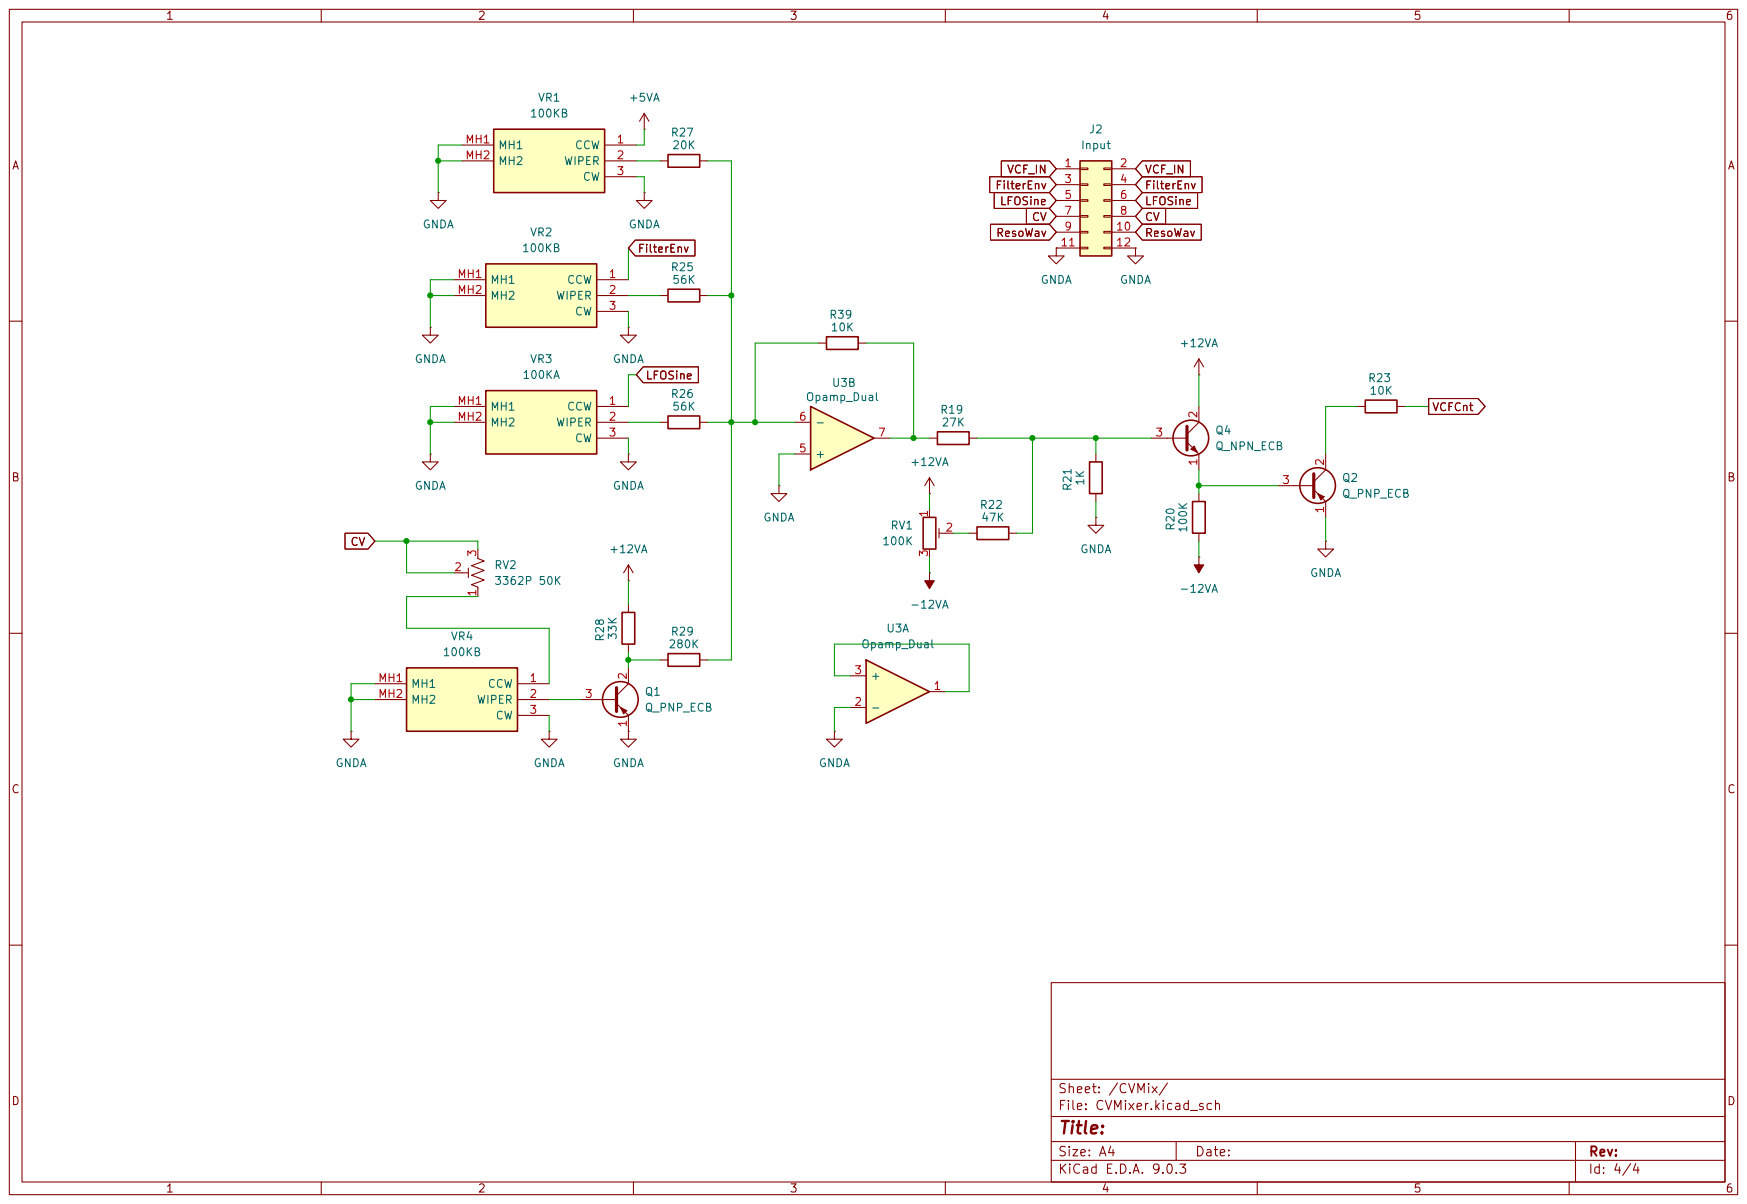
[picture p14: page 3]
