wakimizufu/MC2/SynthBoard_Rotary/SynthBoard_Rotary_部品配置アイデア_20251015.pdf

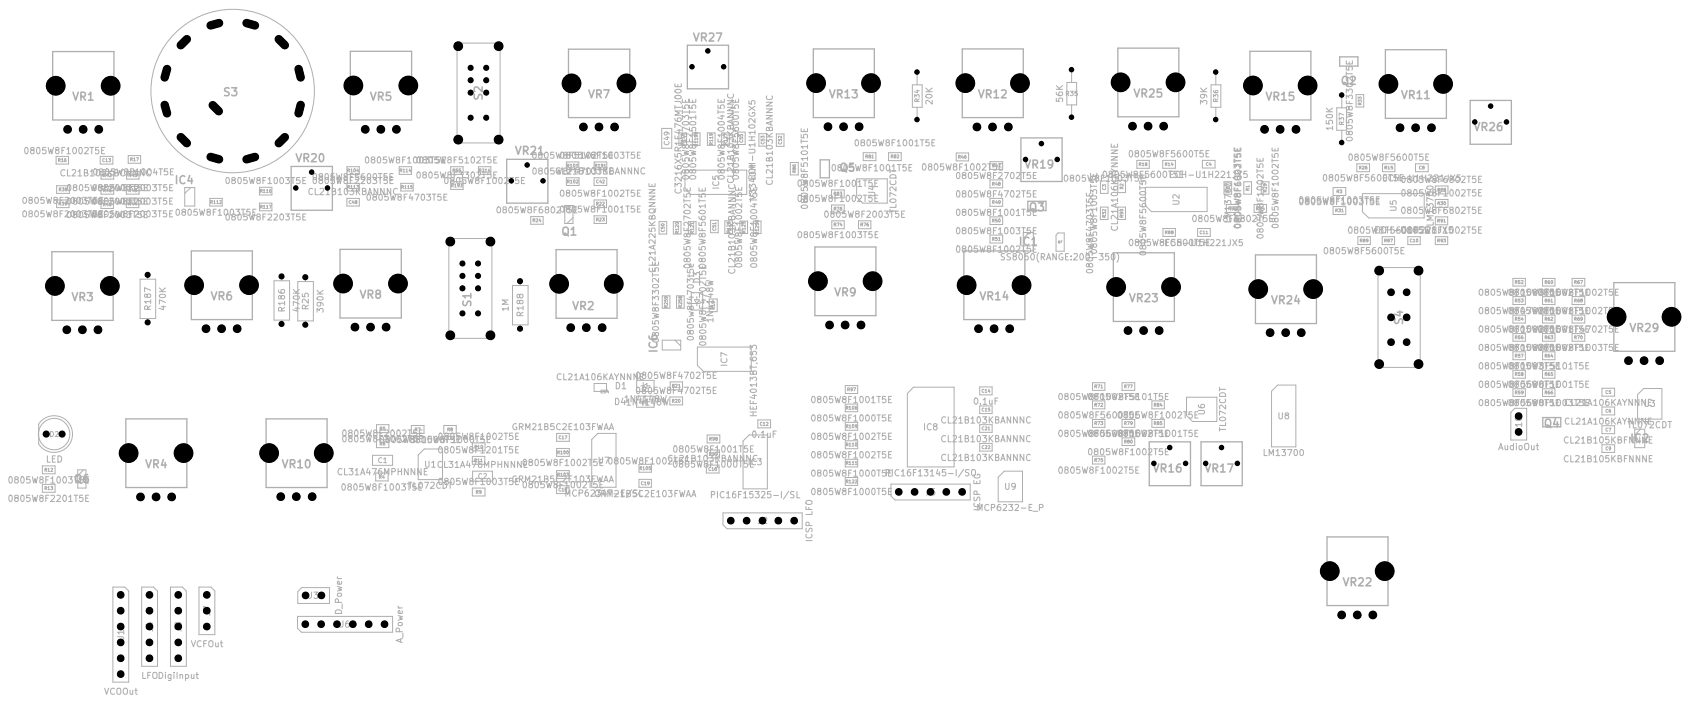
[picture p15: page 1]
