wakimizufu/MC2/VCFSeparate/VCFSeparate_schmatic_Rev1.pdf

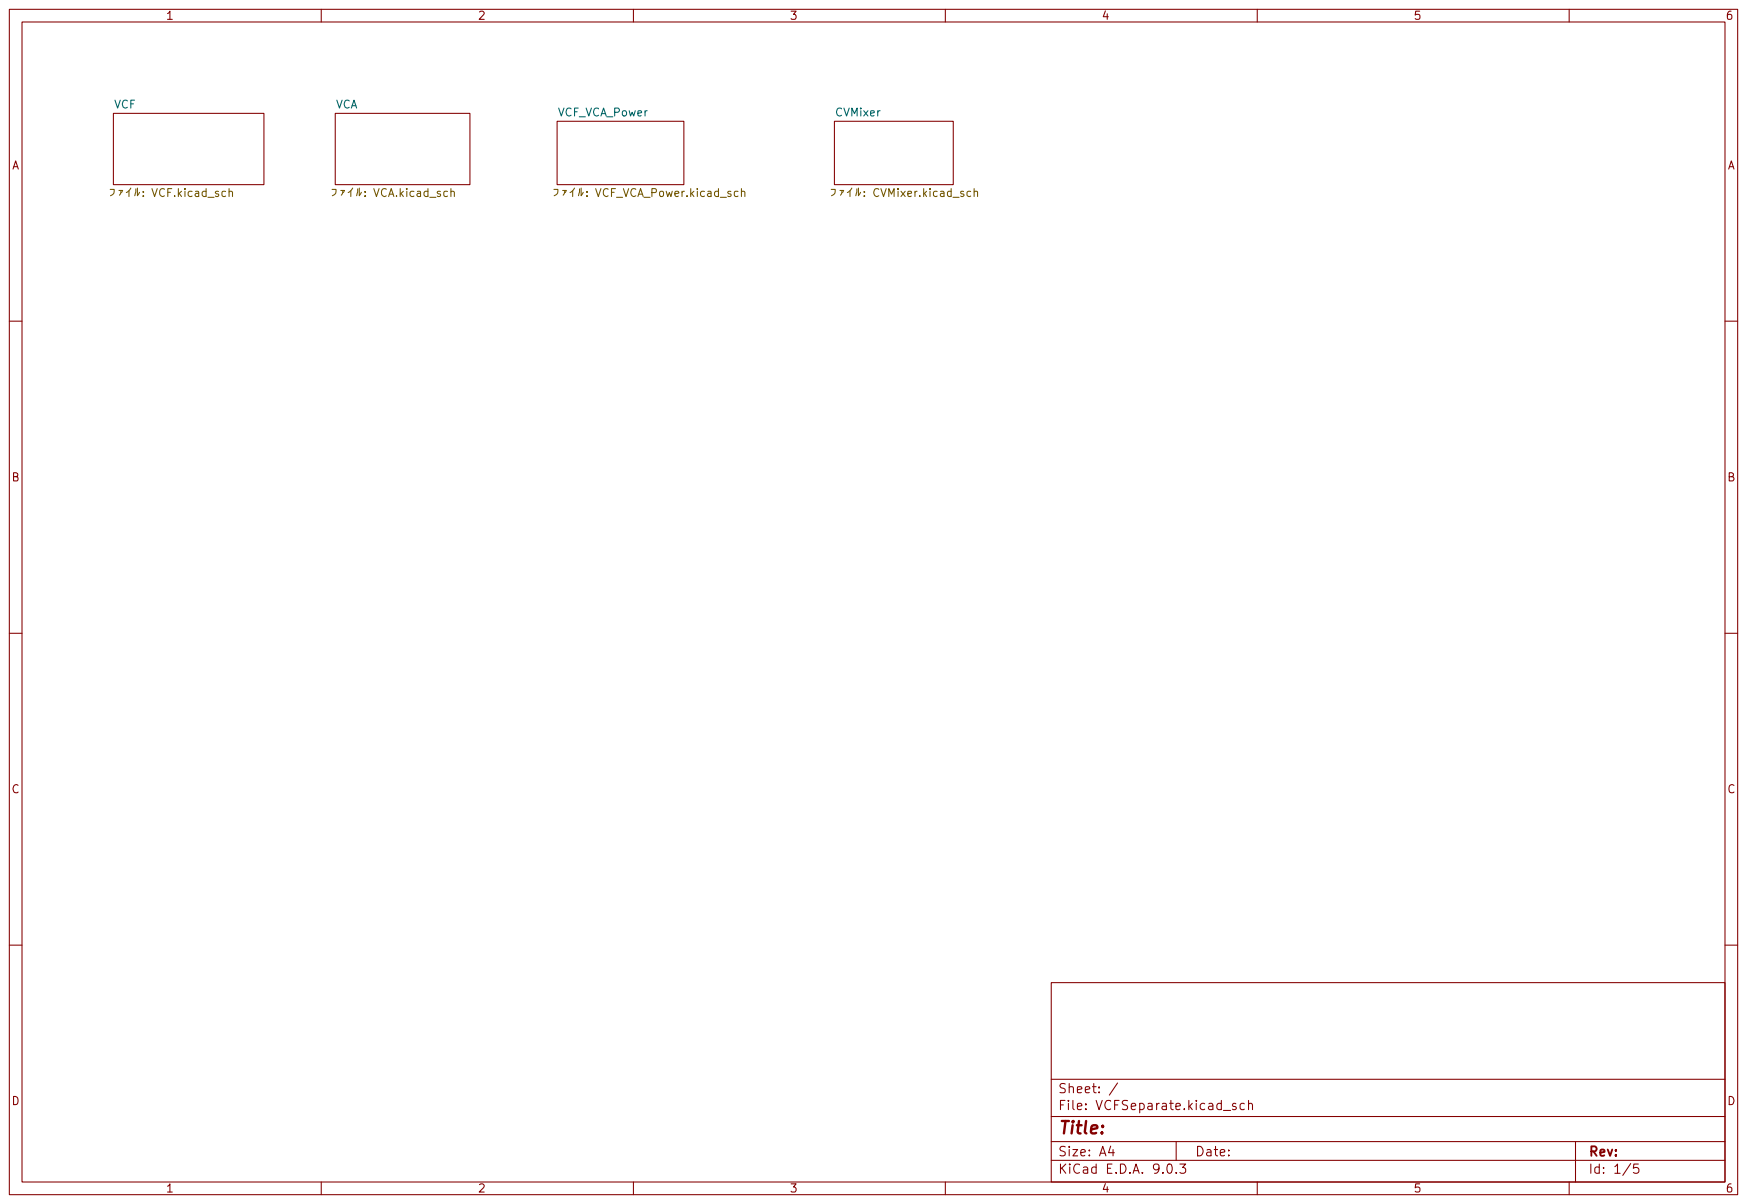
[picture p16: page 1]

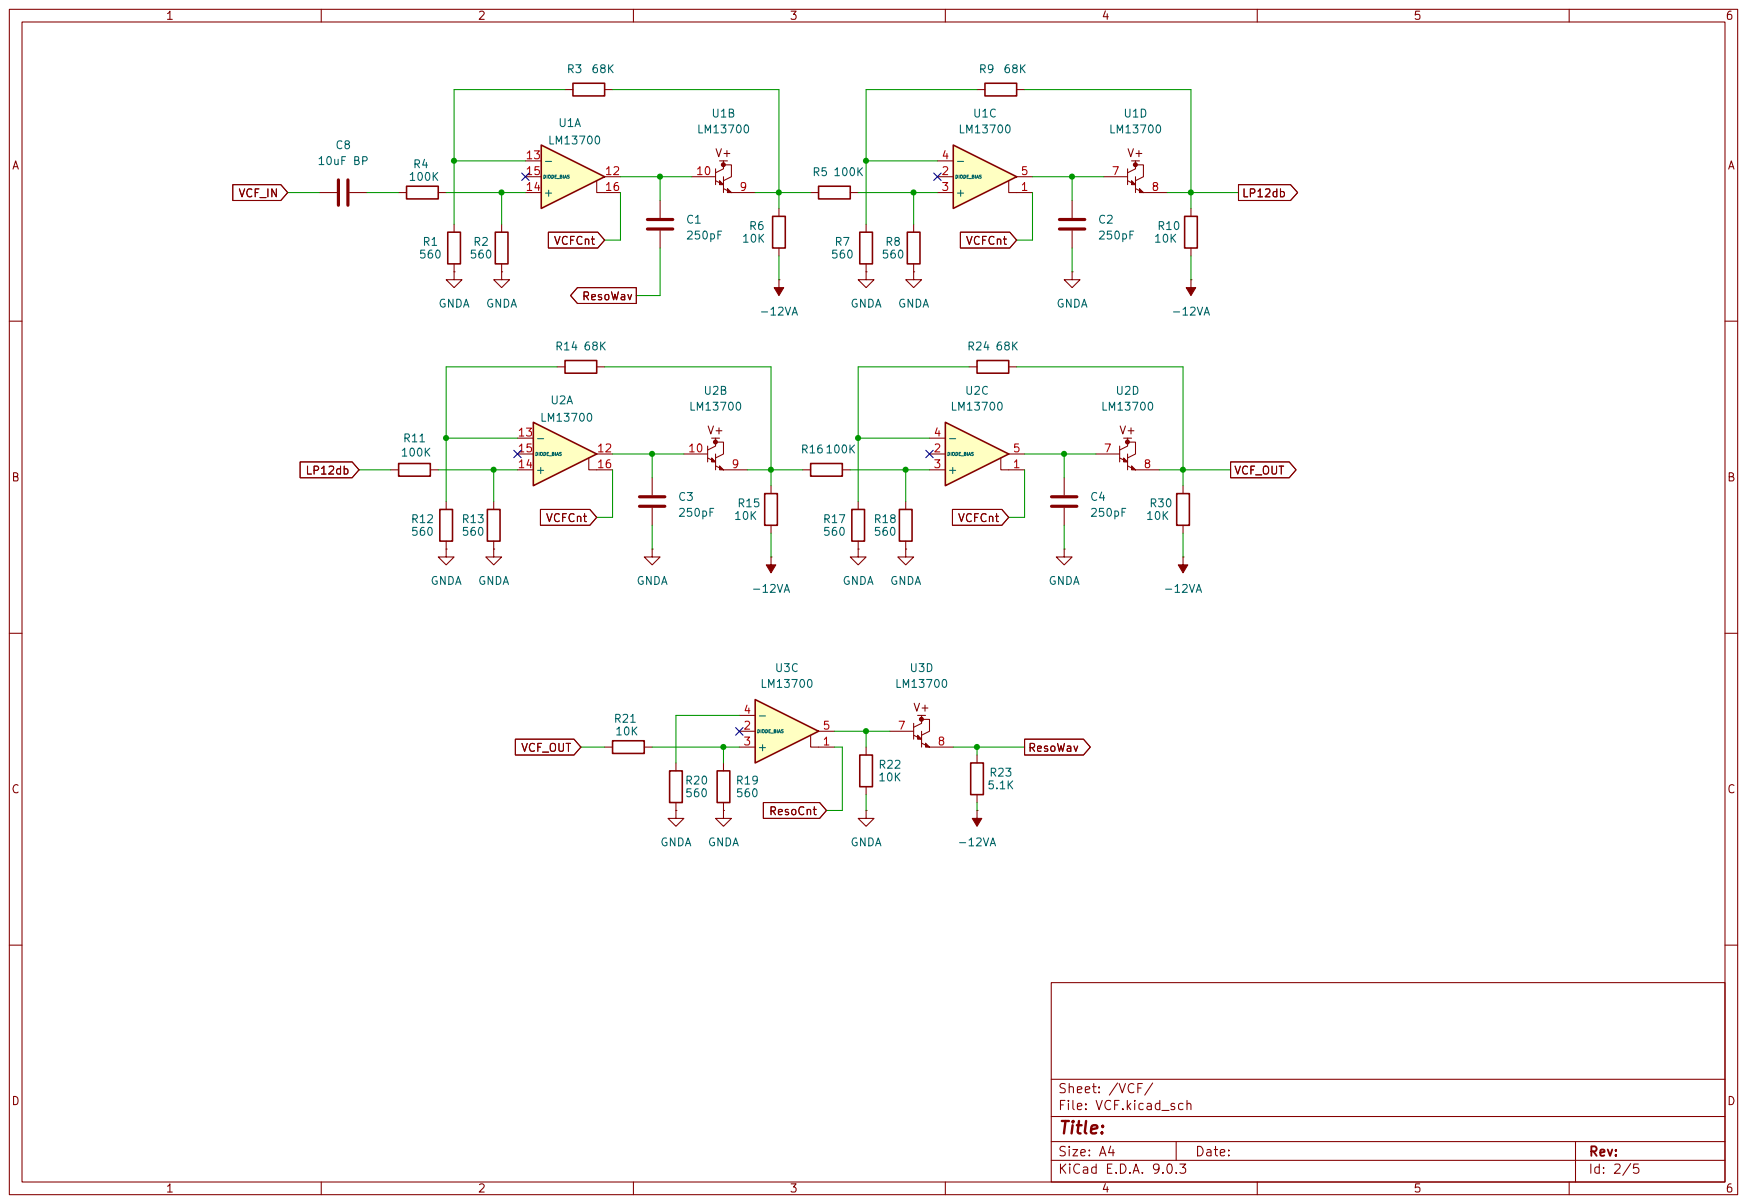
[picture p17: page 2]

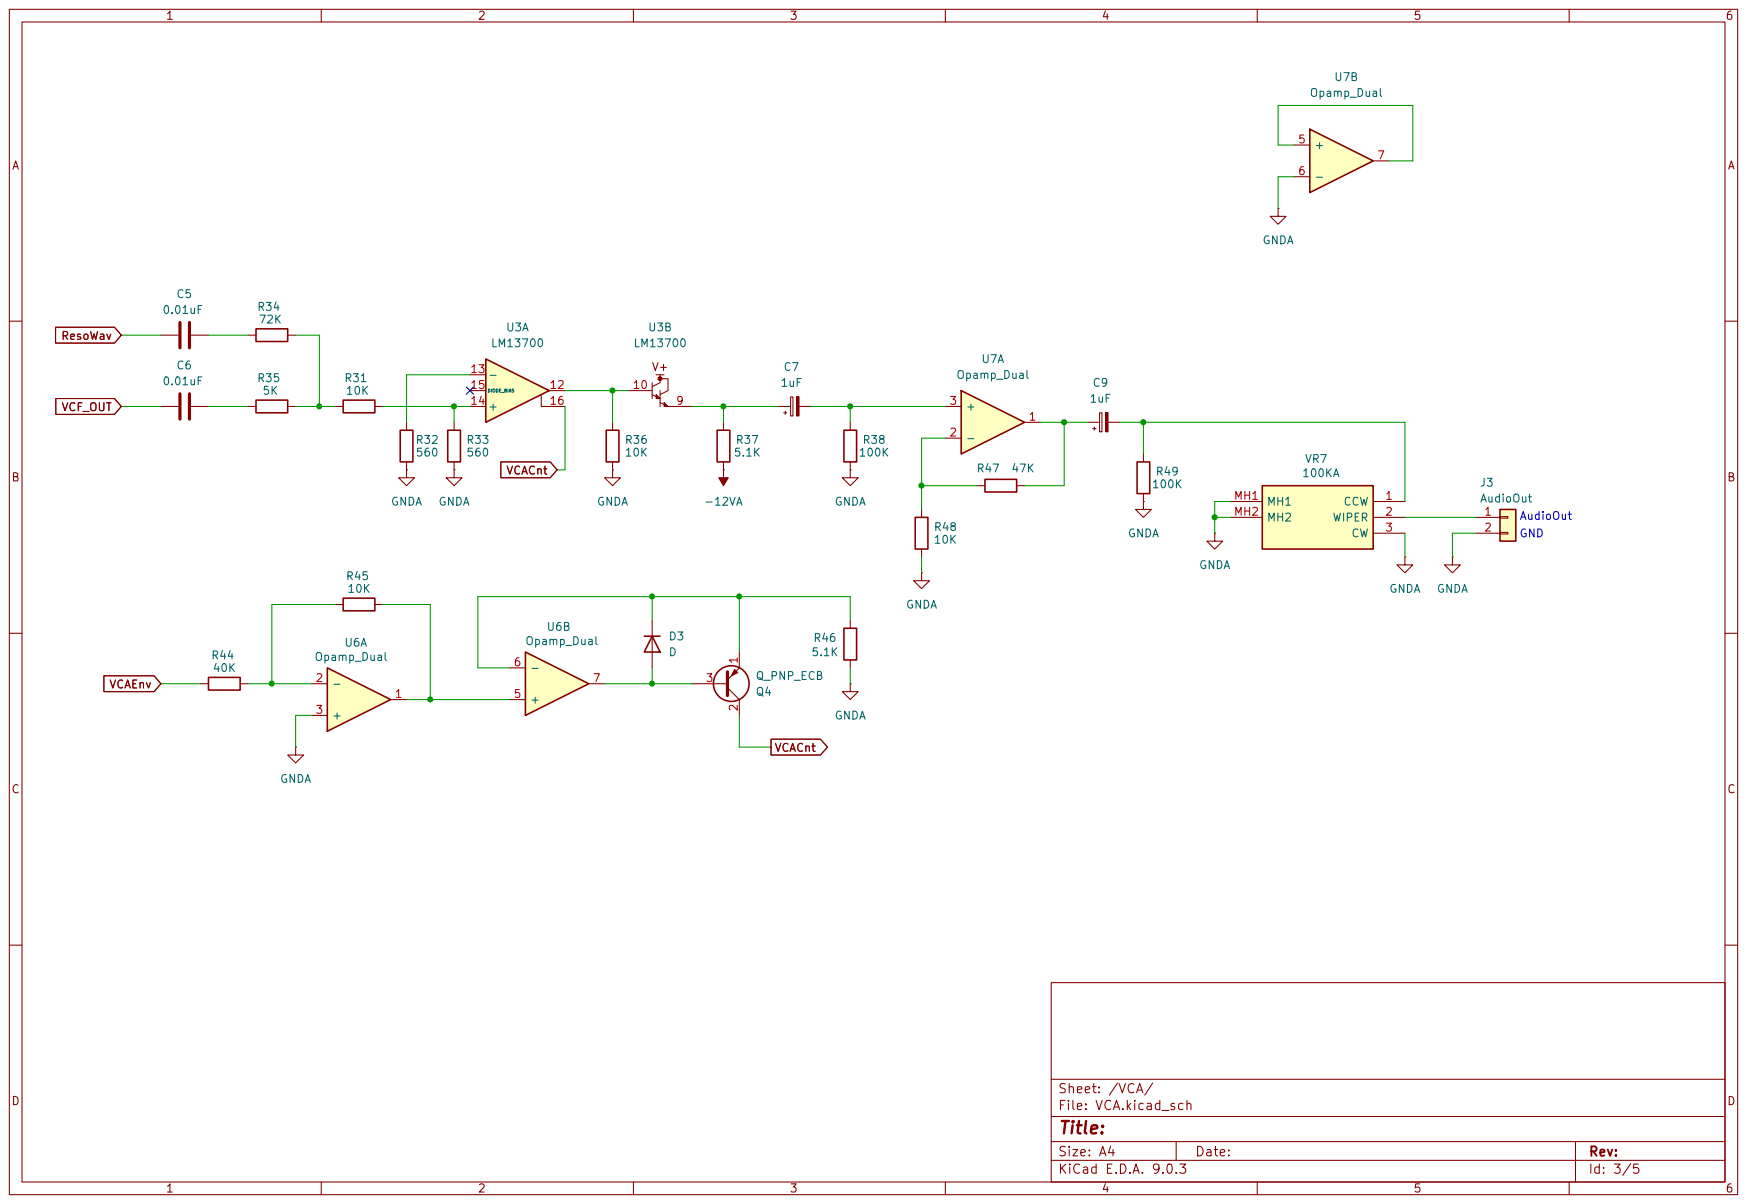
[picture p18: page 3]

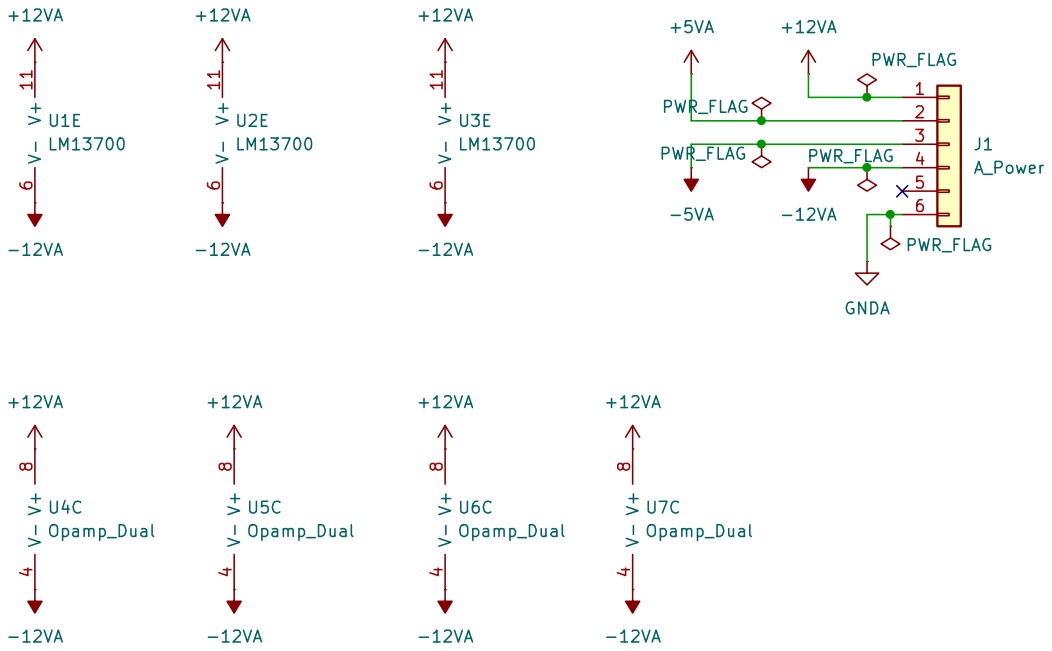
[picture p19: page 4]

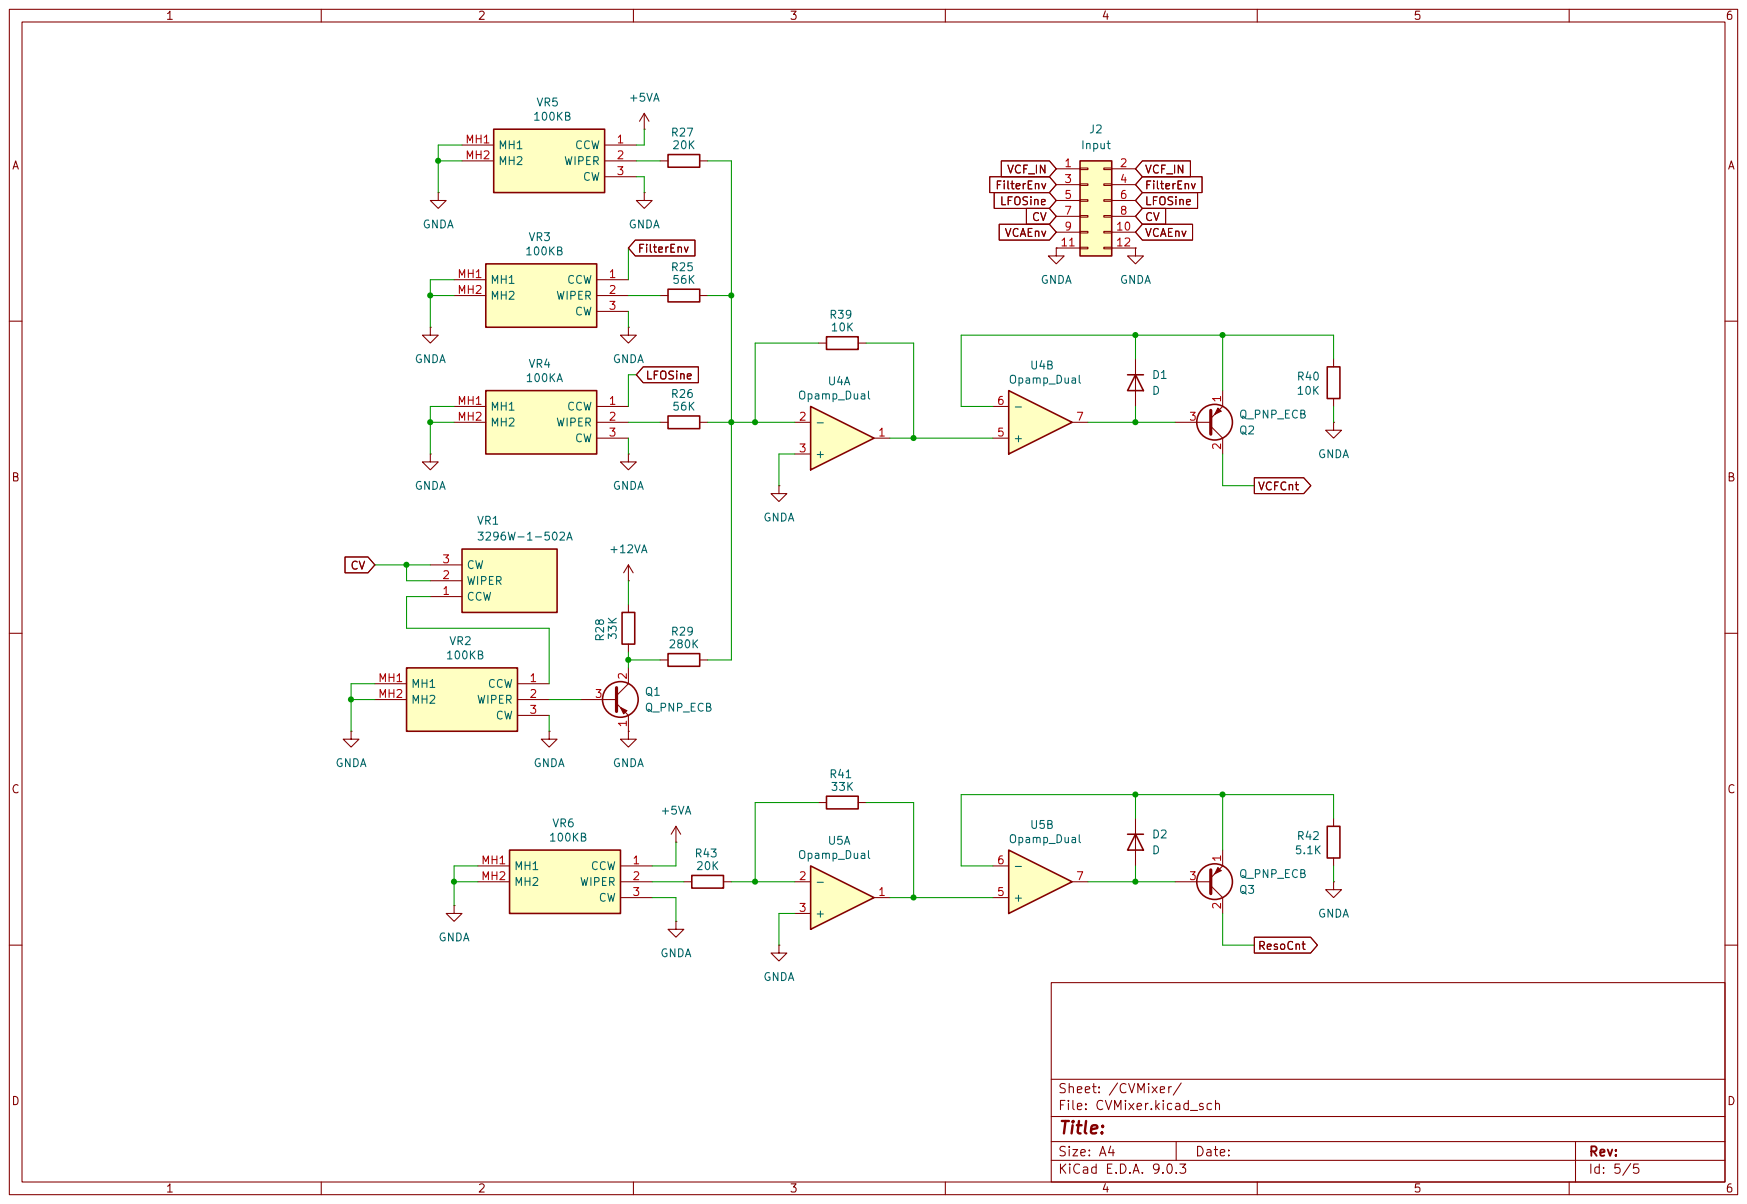
[picture p20: page 5]
