wakimizufu/MC2/SynthBoard_Rotary/VCOBoardRev2/VCOSeparate_shcimaticsRev1.pdf

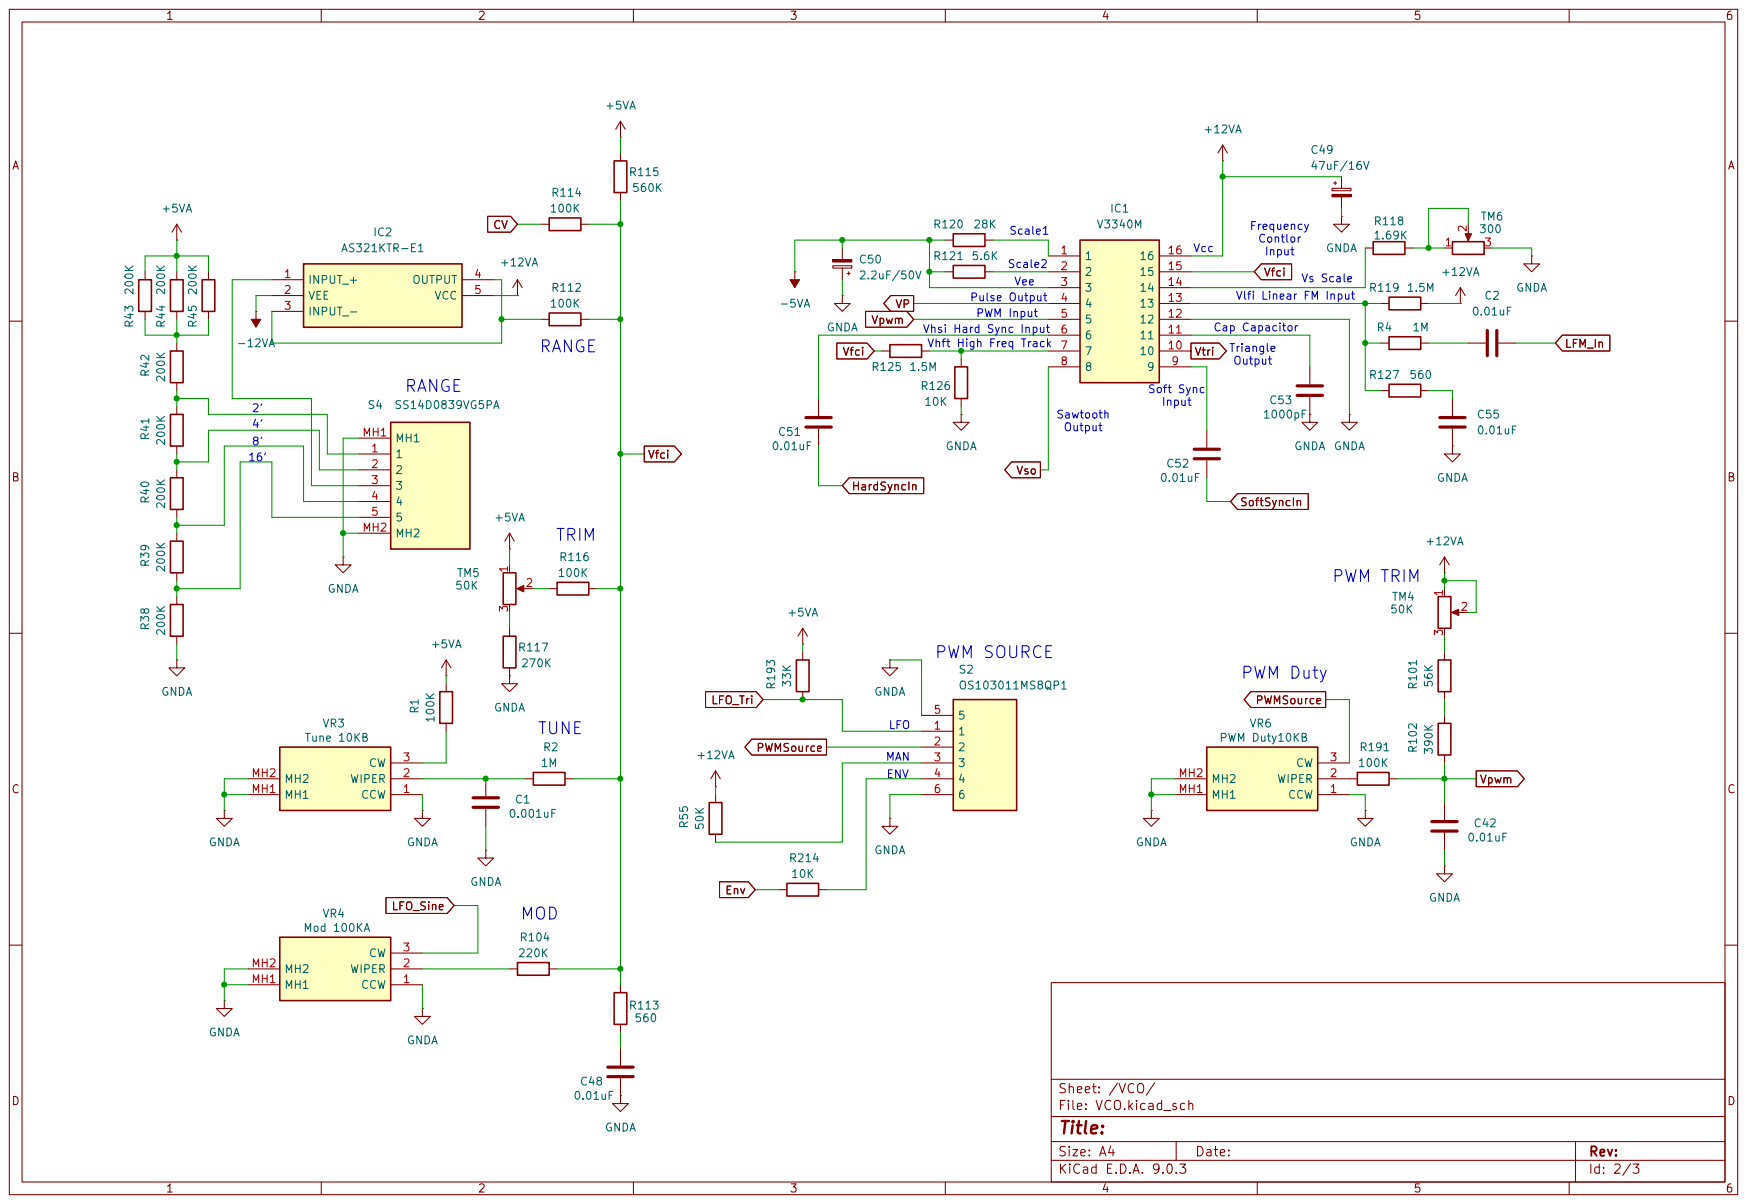
[picture p21: page 1]

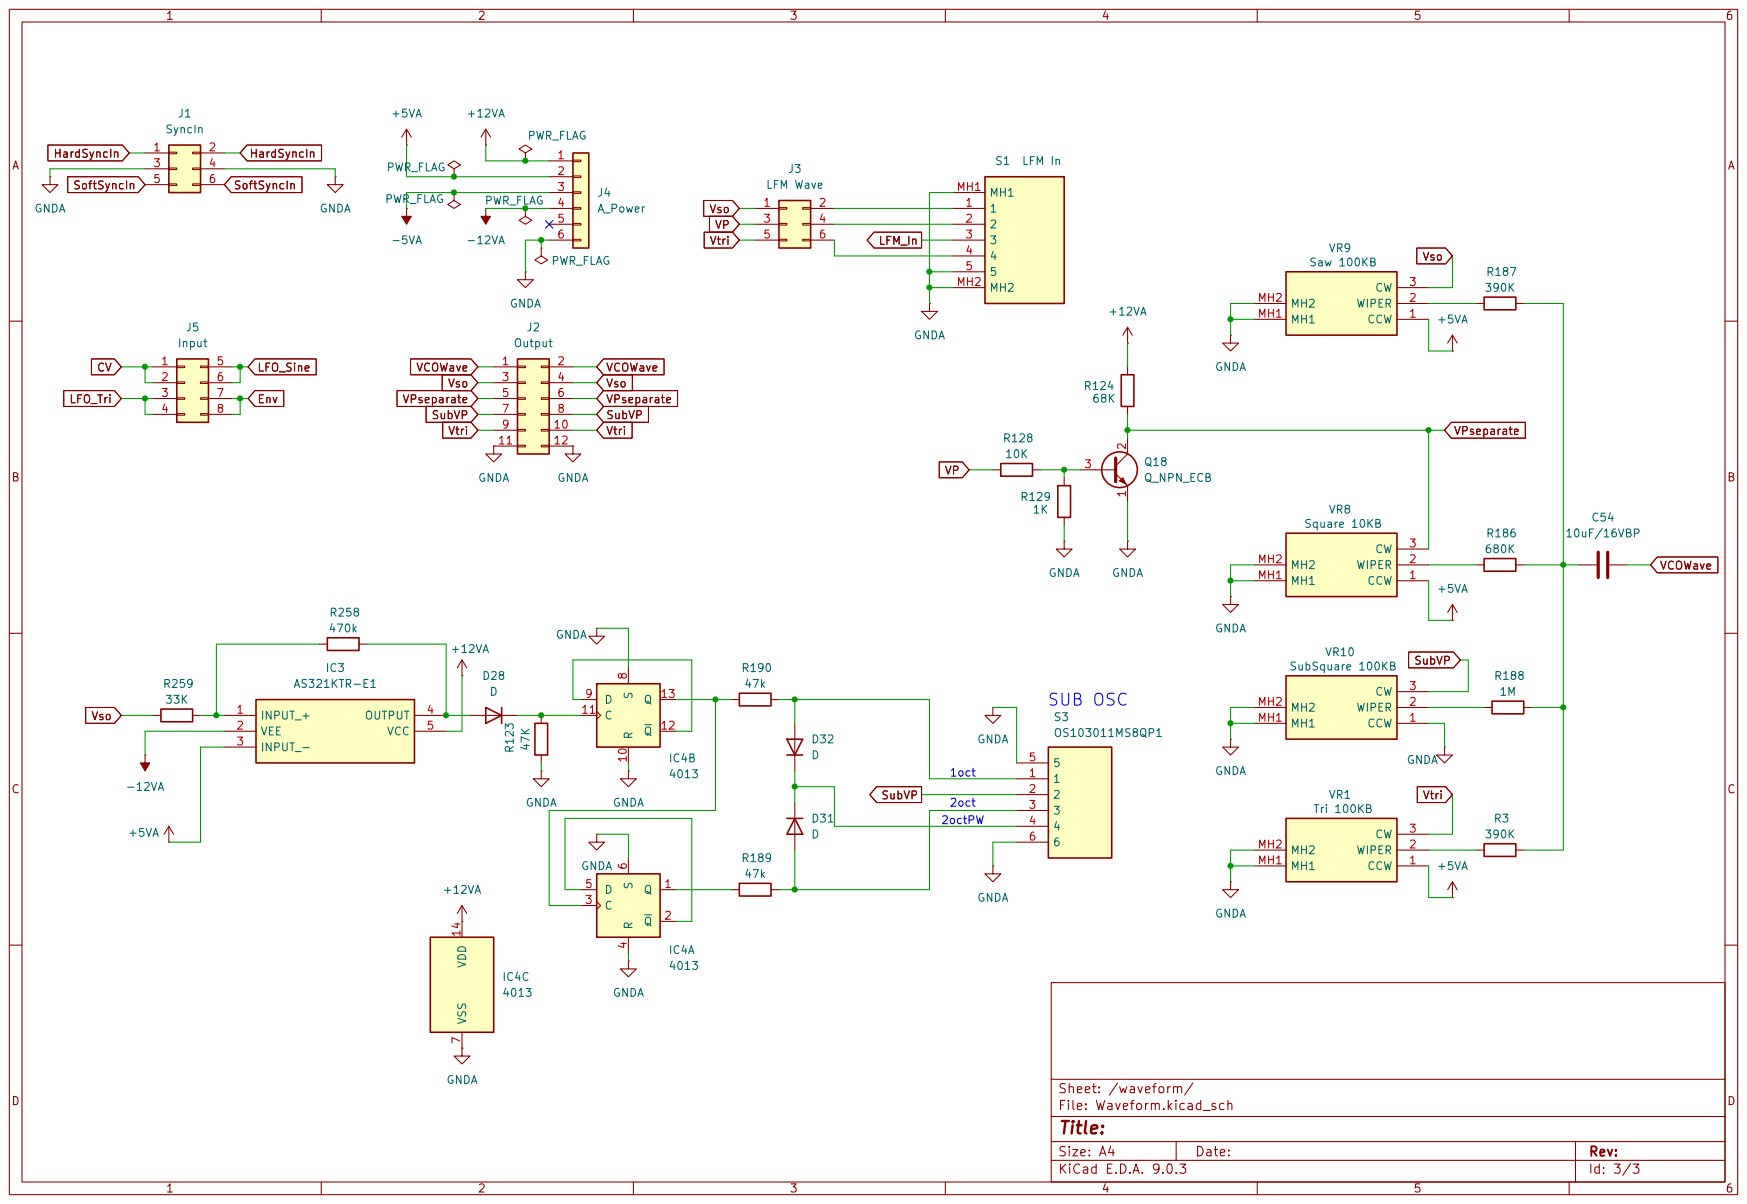
[picture p22: page 2]
