wakimizufu/MC2/SynthBoard_Rotary/VCOBoardRev2/VCOSeparate_shcimatics.pdf

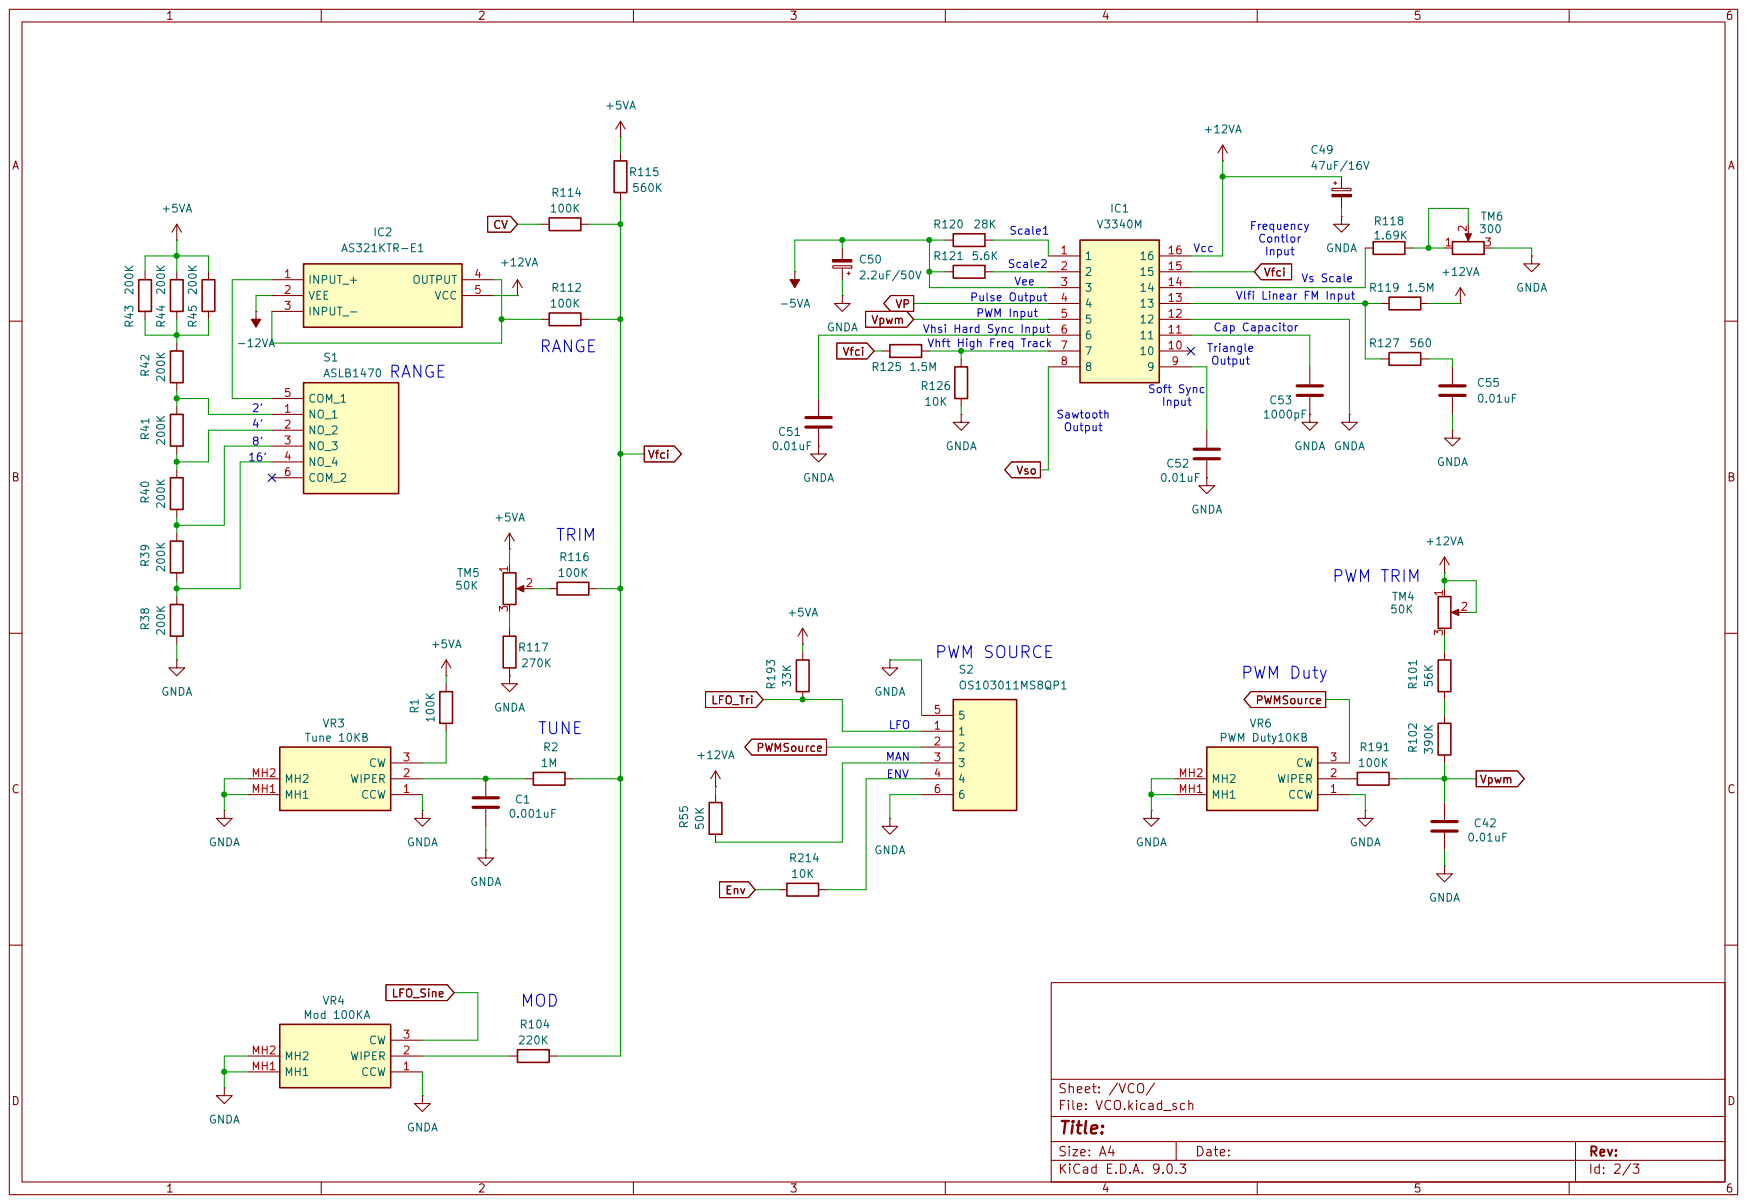
[picture p23: page 1]

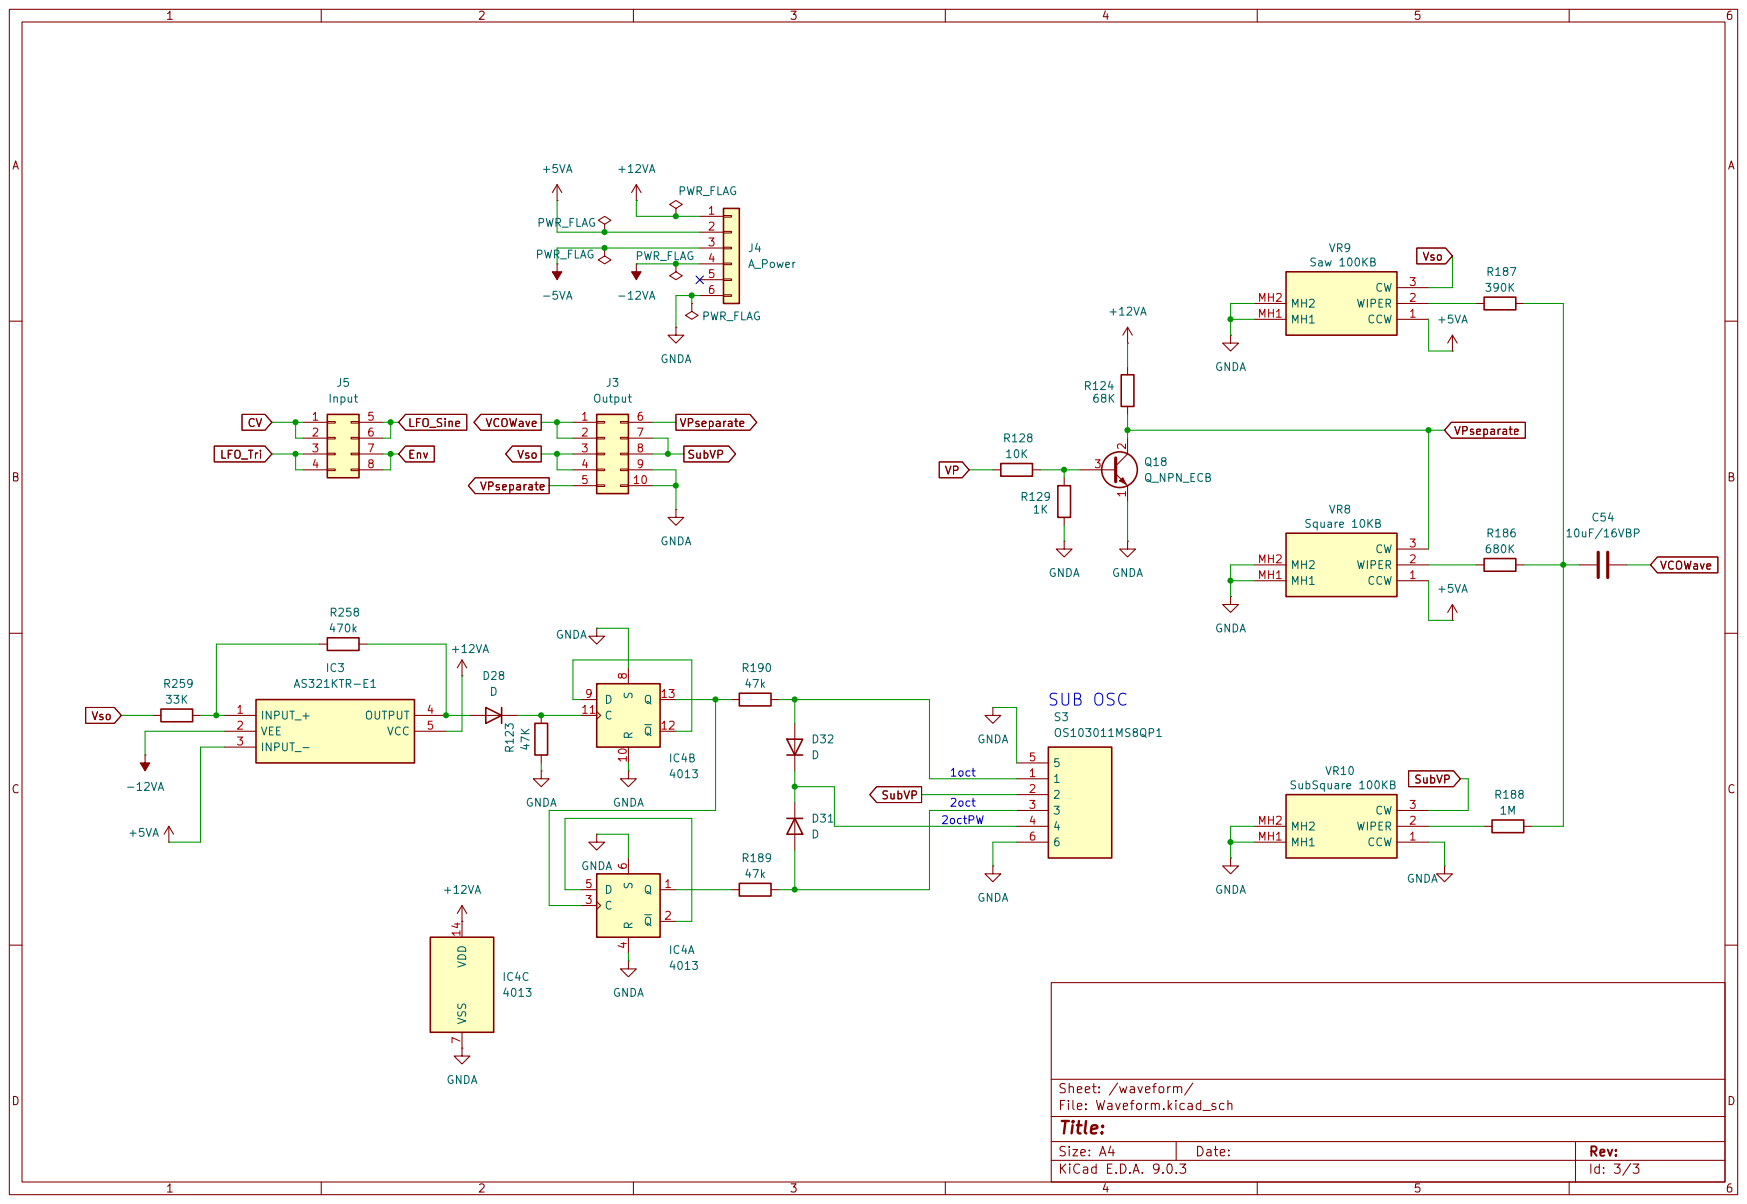
[picture p24: page 2]
