wakimizufu/MC2/(list of files, drawings)

Other design files:
VCOSeparate/freerouting.dsn
VCOSeparate/temp-freerouting.dsn
