wakimizufu/MC2/powerAndJack/powerAndJack.kicad_pcb

## KiCad design powerAndJack/powerAndJack.kicad_pcb (2026-03-14)

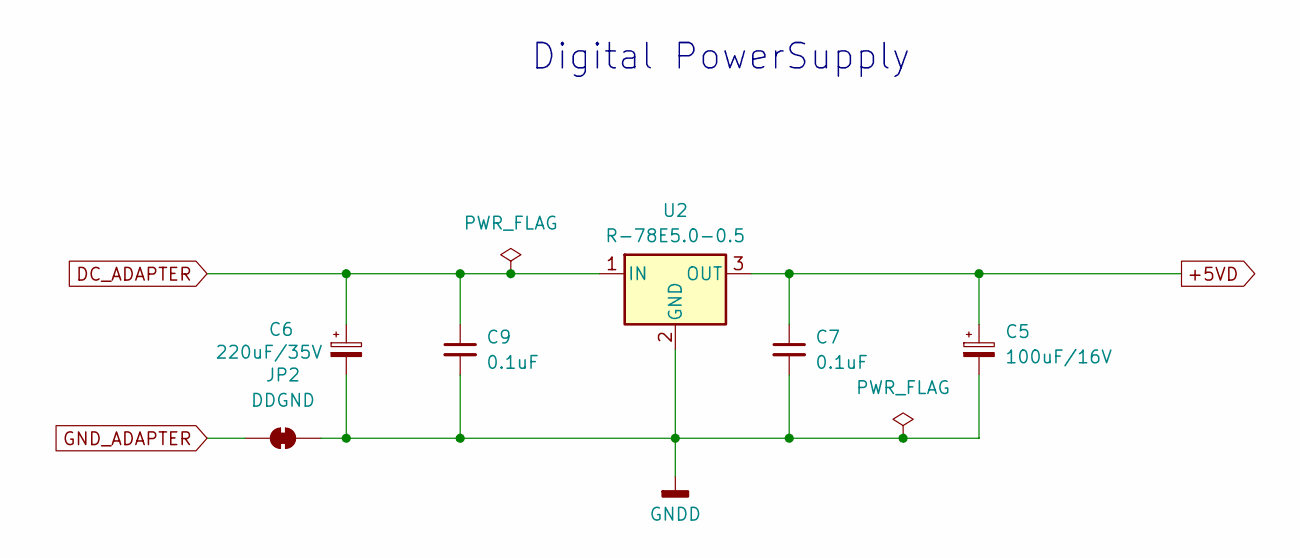
[picture p25: schematic DigitalPower.kicad_sch]

Parts:
C5: 100uF/16V; CP_Radial_D5.0mm_P2.00mm
C6: 220uF/35V; CP_Radial_D8.0mm_P3.50mm
C7, C9: 0.1uF; C_0805_2012Metric_Pad1.18x1.45mm_HandSolder
JP2: DDGND; SolderJumper-2_P1.3mm_Bridged2Bar_RoundedPad1.0x1.5mm
U2: R-78E5.0-0.5; Converter_DCDC_RECOM_R-78E-0.5_THT

Connections:
+5VD: C5.1, C7.1, U2.3 (OUT); also elsewhere on the board
DC_ADAPTER: C6.1, C9.1, U2.1 (IN); also elsewhere on the board
GNDD: C5.2, C6.2, C7.2, C9.2, JP2.2 (B), U2.2 (GND); also elsewhere on the board
GND_ADAPTER: JP2.1 (A); also elsewhere on the board

Notes on the sheet:
Digital PowerSupply

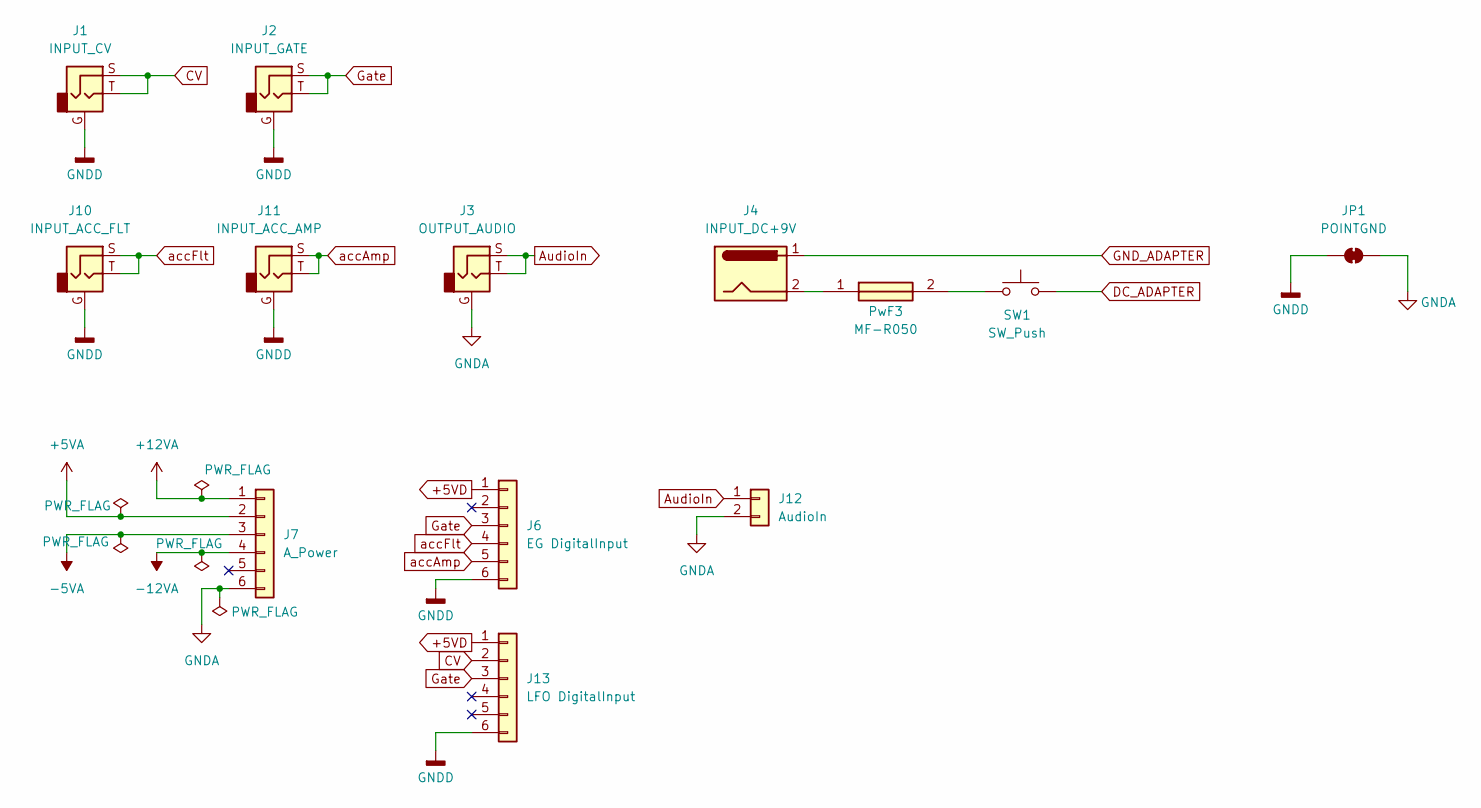
[picture p26: schematic Jack.kicad_sch]

Parts:
J1: INPUT_CV; MJ-355W
J2: INPUT_GATE; MJ-355W
J3: OUTPUT_AUDIO; MJ-355W
J4: INPUT_DC+9V; MJ-14
J6: EG DigitalInput; PinHeader_1x06_P2.54mm_Horizontal
J7: A_Power; PinHeader_1x06_P2.54mm_Horizontal
J10: INPUT_ACC_FLT; MJ-355W
J11: INPUT_ACC_AMP; MJ-355W
J12: AudioIn; PinHeader_1x02_P2.54mm_Horizontal
J13: LFO DigitalInput; PinHeader_1x06_P2.54mm_Horizontal
JP1: POINTGND; SolderJumper-2_P1.3mm_Bridged2Bar_RoundedPad1.0x1.5mm
PwF3: MF-R050; MFR050; Manufacturer_Part_Number MF-R050; Mouser Part Number 652-MFR050
SW1: SW_Push; mitumi DS660RC

Connections:
+5VA: J7.2; also elsewhere on the board
+5VD: J6.1, J13.1; also elsewhere on the board
+12VA: J7.1; also elsewhere on the board
-5VA: J7.3; also elsewhere on the board
-12VA: J7.4; also elsewhere on the board
AudioIn: J3.S, J3.T, J12.1
CV: J1.S, J1.T, J13.2
DC_ADAPTER: SW1.2; also elsewhere on the board
GNDA: J3.G, J7.6, J12.2, JP1.2 (B); also elsewhere on the board
GNDD: J1.G, J2.G, J6.6, J10.G, J11.G, J13.6, JP1.1 (A); also elsewhere on the board
GND_ADAPTER: J4.1; also elsewhere on the board
Gate: J2.S, J2.T, J6.3, J13.3
unnamed: J4.2, PwF3.1
unnamed: PwF3.2, SW1.1
accAmp: J6.5, J11.S, J11.T
accFlt: J6.4, J10.S, J10.T

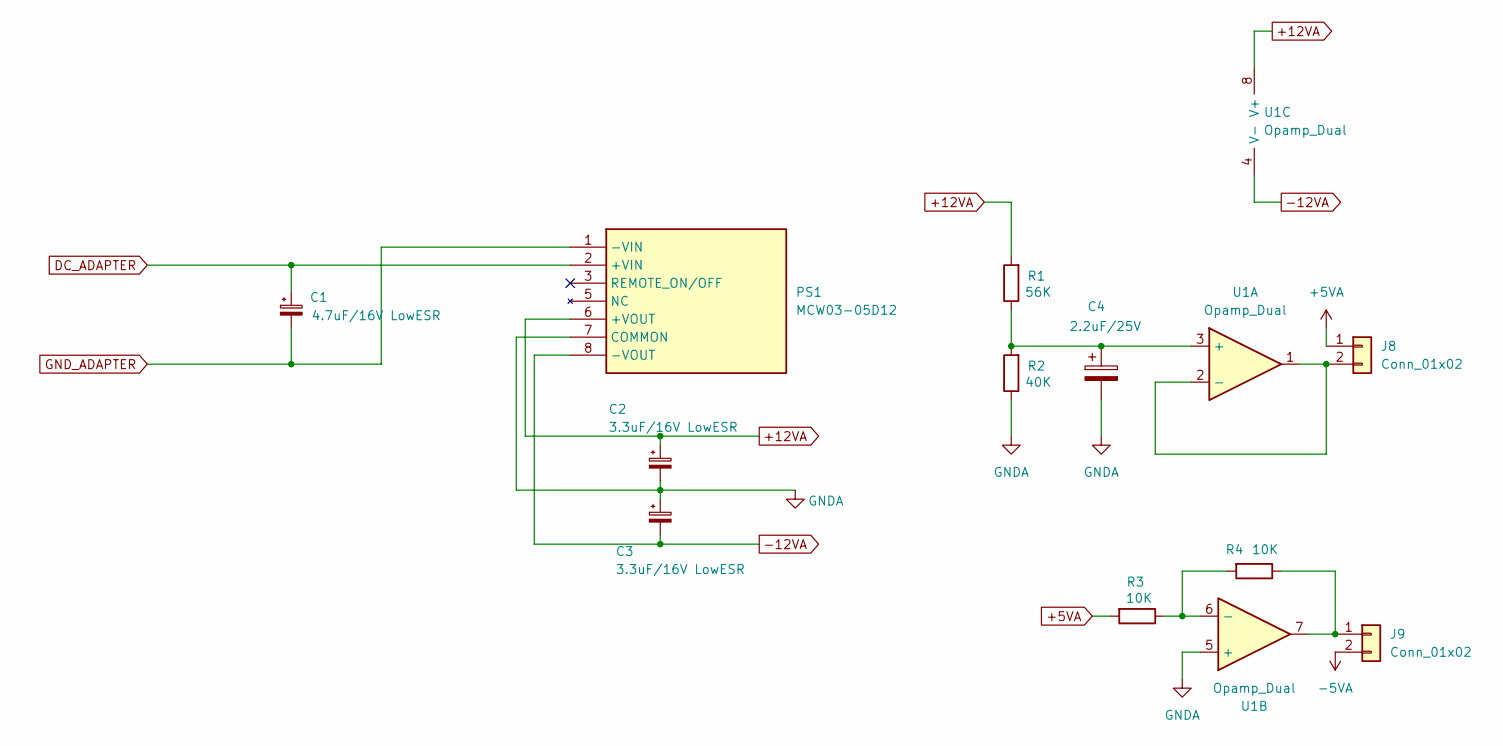
[picture p27: schematic Power.kicad_sch]

Parts:
C1: 4.7uF/16V LowESR; CP_Radial_D5.0mm_P2.50mm
C2, C3: 3.3uF/16V LowESR; CP_Radial_D5.0mm_P2.50mm
C4: 2.2uF/25V; CP_Radial_D5.0mm_P2.50mm
J8, J9: Conn_01x02; PinHeader_1x02_P2.54mm_Vertical
PS1: MCW03-05D12; MCW0305D12; Manufacturer_Part_Number MCW03-05D12
R1: 56K; R_Axial_DIN0207_L6.3mm_D2.5mm_P2.54mm_Vertical
R2: 40K; R_Axial_DIN0207_L6.3mm_D2.5mm_P2.54mm_Vertical
R3, R4: 10K; R_Axial_DIN0207_L6.3mm_D2.5mm_P2.54mm_Vertical
U1: Opamp_Dual; SOIC-8_3.9x4.9mm_P1.27mm

Connections:
+5VA: J8.1, R3.2; also elsewhere on the board
+12VA: C2.1, PS1.6 (+VOUT), R1.2, U1.8 (V+); also elsewhere on the board
-5VA: J9.2; also elsewhere on the board
-12VA: C3.2, PS1.8 (-VOUT), U1.4 (V-); also elsewhere on the board
DC_ADAPTER: C1.1, PS1.2 (+VIN); also elsewhere on the board
GNDA: C2.2, C3.1, C4.2, PS1.7 (COMMON), R2.1, U1.5 (+); also elsewhere on the board
GND_ADAPTER: C1.2, PS1.1 (-VIN); also elsewhere on the board
unnamed: J8.2, U1.1, U1.2 (-)
unnamed: J9.1, R4.1, U1.7
unnamed: C4.1, R1.1, R2.2, U1.3 (+)
unnamed: R3.1, R4.2, U1.6 (-)

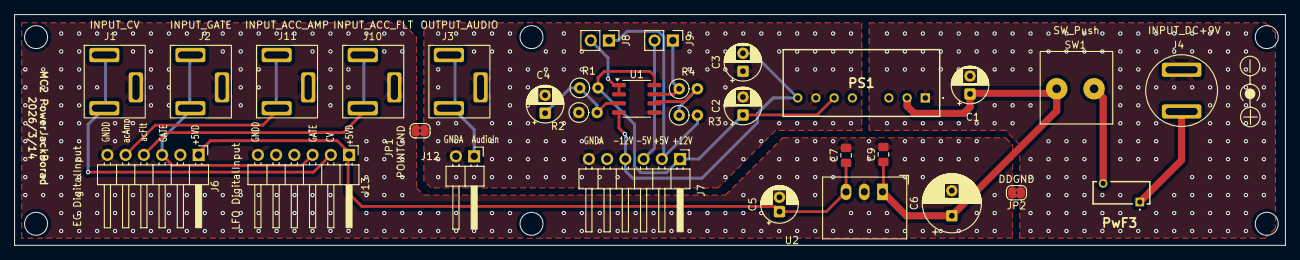
[picture p28: board powerAndJack.kicad_pcb from above]

Board: 2 copper layers, 177.0 x 32.1 mm, 31 parts (0 on the bottom side), 20 nets.
