wakimizufu/MC2/SynthBoard_Rotary/VCOBoardRev2/VCOSeparate.kicad_pcb

## KiCad design SynthBoard_Rotary/VCOBoardRev2/VCOSeparate.kicad_pcb (2026-02-22)

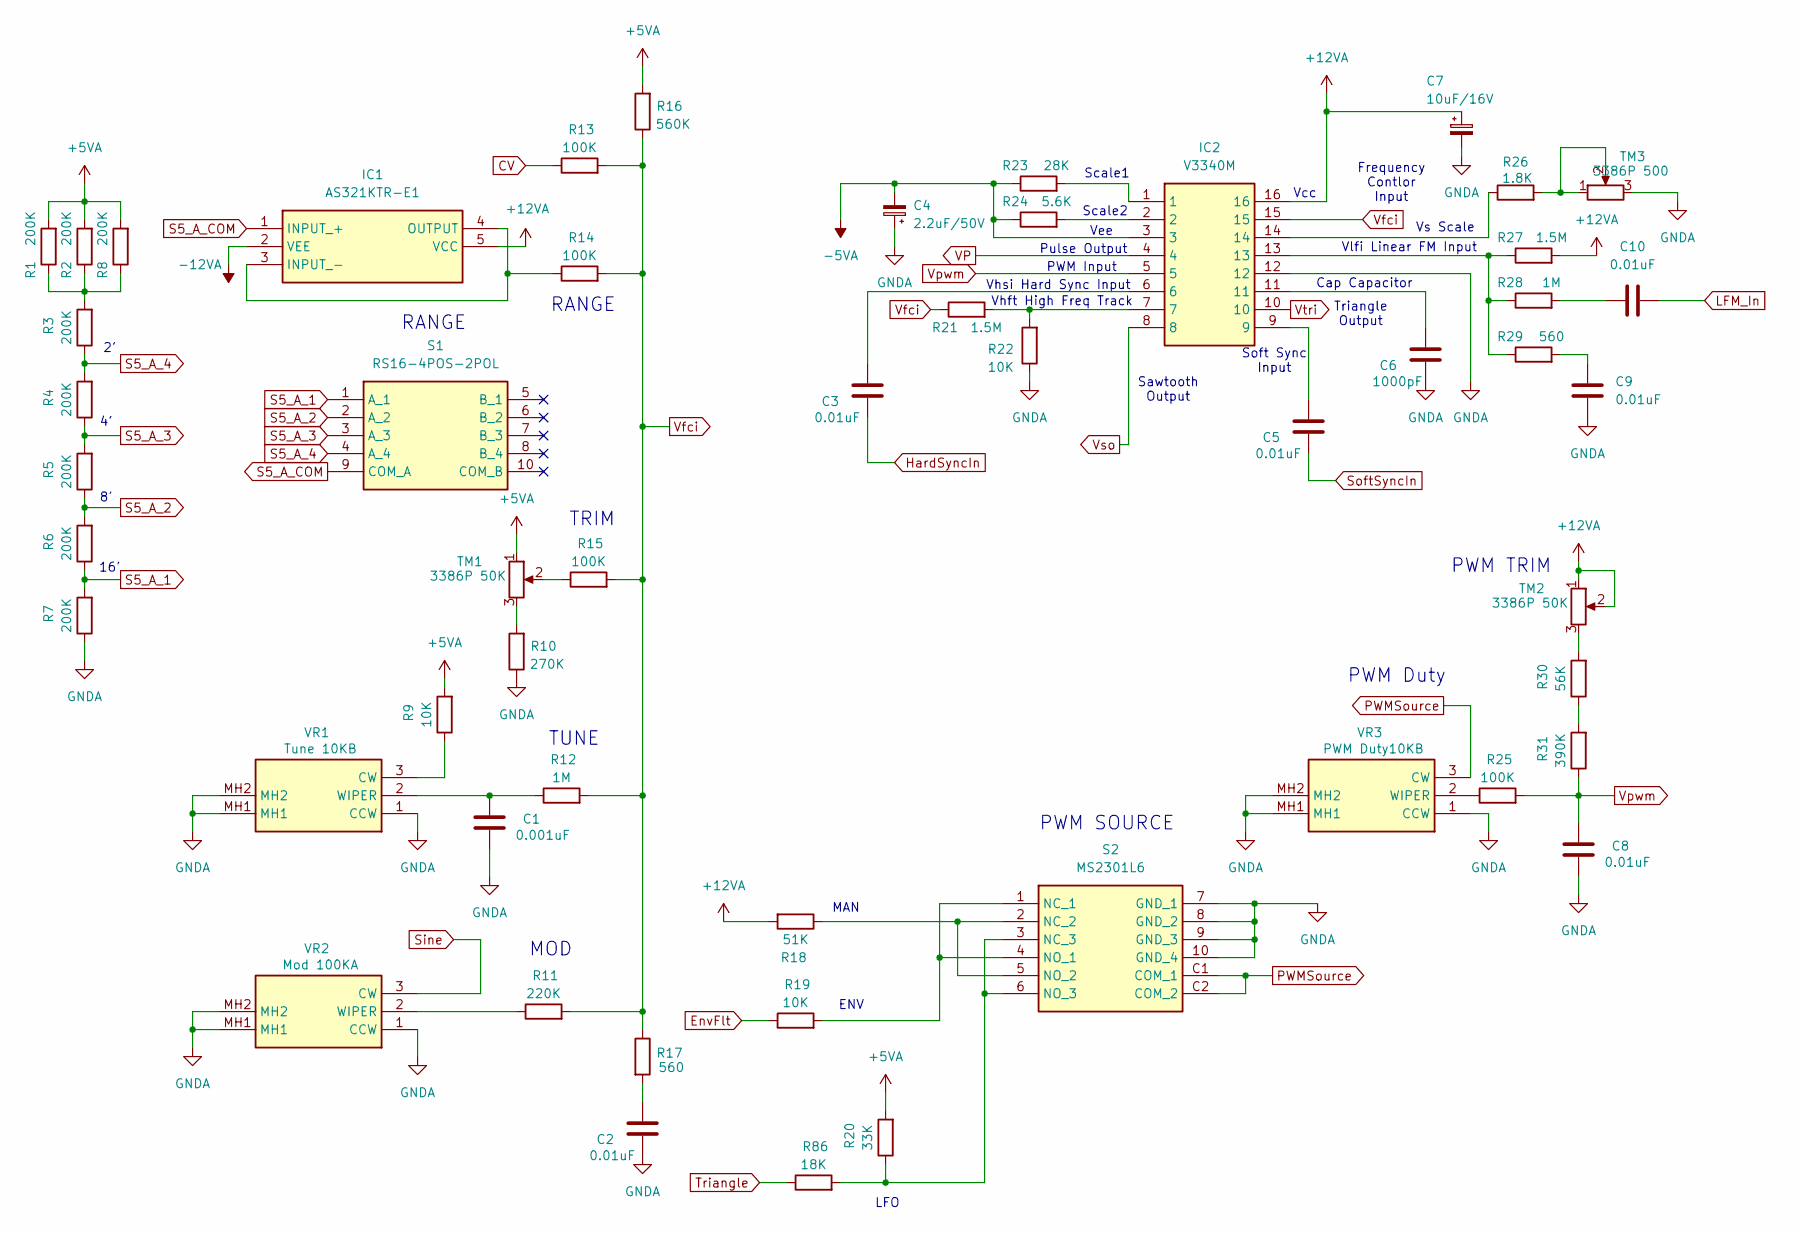
[picture p29: schematic VCO.kicad_sch]

Parts:
C1: 0.001uF; C_Disc_D5.0mm_W2.5mm_P2.50mm
C2, C3, C5, C8, C9, C10: 0.01uF; C_Disc_D5.0mm_W2.5mm_P2.50mm
C4: 2.2uF/50V; CP_Radial_D5.0mm_P2.50mm
C6: 1000pF; C_Disc_D5.0mm_W2.5mm_P2.50mm
C7: 10uF/16V; CP_Radial_D5.0mm_P2.50mm
IC1: AS321KTR-E1; SOT95P282X145-5N; Manufacturer_Part_Number AS321KTR-E1; Mouser Part Number 621-AS321KTR-E1
IC2: V3340M; SOP-16_3.9x9.9mm_P1.27mm; Manufacturer_Part_Number V3340M
R1, R2, R3, R4, R5, R6, R7, R8: 200K; R_Axial_DIN0207_L6.3mm_D2.5mm_P2.54mm_Vertical
R9, R19, R22: 10K; R_Axial_DIN0207_L6.3mm_D2.5mm_P2.54mm_Vertical
R10: 270K; R_Axial_DIN0207_L6.3mm_D2.5mm_P2.54mm_Vertical
R11: 220K; R_Axial_DIN0207_L6.3mm_D2.5mm_P2.54mm_Vertical
R12, R28: 1M; R_Axial_DIN0207_L6.3mm_D2.5mm_P2.54mm_Vertical
R13, R14, R15, R25: 100K; R_Axial_DIN0207_L6.3mm_D2.5mm_P2.54mm_Vertical
R16: 560K; R_Axial_DIN0207_L6.3mm_D2.5mm_P2.54mm_Vertical
R17, R29: 560; R_Axial_DIN0207_L6.3mm_D2.5mm_P2.54mm_Vertical
R18: 51K; R_Axial_DIN0207_L6.3mm_D2.5mm_P2.54mm_Vertical
R20: 33K; R_Axial_DIN0207_L6.3mm_D2.5mm_P2.54mm_Vertical
R21, R27: 1.5M; R_Axial_DIN0207_L6.3mm_D2.5mm_P2.54mm_Vertical
R23: 28K; R_Axial_DIN0207_L6.3mm_D2.5mm_P2.54mm_Vertical
R24: 5.6K; R_Axial_DIN0207_L6.3mm_D2.5mm_P2.54mm_Vertical
R26: 1.8K; R_Axial_DIN0207_L6.3mm_D2.5mm_P2.54mm_Vertical
R30: 56K; R_Axial_DIN0207_L6.3mm_D2.5mm_P2.54mm_Vertical
R31: 390K; R_Axial_DIN0207_L6.3mm_D2.5mm_P2.54mm_Vertical
R86: 18K; R_Axial_DIN0207_L6.3mm_D2.5mm_P2.54mm_Vertical
S1: RS16-4POS-2POL; RS164POS2POL; Manufacturer_Part_Number RS16-4POS-2POL
S2: MS2301L6; Manufacturer_Part_Number MS2301L6
TM1, TM2: 3386P 50K; Potentiometer_Bourns_3386P_Vertical
TM3: 3386P 500; Potentiometer_Bourns_3386P_Vertical
VR1: Tune 10KB; RK09D117000B; Manufacturer_Part_Number RK09D117000B; Mouser Part Number 688-RK09D117000B
VR2: Mod 100KA; RK09D117000B; Manufacturer_Part_Number RK09D117000B; Mouser Part Number 688-RK09D117000B
VR3: PWM Duty10KB; RK09D117000B; Manufacturer_Part_Number RK09D117000B; Mouser Part Number 688-RK09D117000B

Connections:
+5VA: R1.2, R2.2, R8.2, R9.2, R16.2, R20.2, TM1.1; also elsewhere on the board
+12VA: C7.1, IC1.5 (VCC), IC2.16, R18.2, R27.2, TM2.1, TM2.2; also elsewhere on the board
-5VA: C4.2, IC2.3, R23.1, R24.1; also elsewhere on the board
-12VA: IC1.2 (VEE); also elsewhere on the board
CV: R13.1; also elsewhere on the board
EnvFlt: R19.1; also elsewhere on the board
GNDA: C1.1, C2.1, C4.1, C6.1, C7.2, C8.1, C9.1, IC2.12, R7.1, R10.1, R22.1, S2.7 (GND_1), S2.8 (GND_2), S2.9 (GND_3), S2.10 (GND_4), TM3.3, VR1.1 (CCW), VR1.MH1, VR1.MH2, VR2.1 (CCW), VR2.MH1, VR2.MH2, VR3.1 (CCW), VR3.MH1, VR3.MH2; also elsewhere on the board
HardSyncIn: C3.1; also elsewhere on the board
LFM_In: C10.1; also elsewhere on the board
unnamed: C2.2, R17.2
unnamed: C3.2, IC2.6
unnamed: C5.2, IC2.9
unnamed: C6.2, IC2.11
unnamed: C9.2, R29.2
unnamed: C10.2, R28.2
unnamed: IC1.3 (INPUT_-), IC1.4 (OUTPUT), R14.1
unnamed: IC2.1, R23.2
unnamed: IC2.2, R24.2
unnamed: IC2.7, R21.2, R22.2
unnamed: IC2.13, R27.1, R28.1, R29.1
unnamed: IC2.14, R26.1
unnamed: R1.1, R2.1, R3.2, R8.1
unnamed: R10.2, TM1.3
unnamed: R15.1, TM1.2
unnamed: R26.2, TM3.1, TM3.2
unnamed: R30.1, R31.2
unnamed: R30.2, TM2.3
unnamed: R19.2, S2.1 (NC_1), S2.4 (NO_1)
unnamed: R18.1, S2.2 (NC_2), S2.5 (NO_2)
unnamed: R20.1, R86.2, S2.3 (NC_3), S2.6 (NO_3)
unnamed: R9.1, VR1.3 (CW)
unnamed: C1.2, R12.1, VR1.2 (WIPER)
unnamed: R11.1, VR2.2 (WIPER)
unnamed: R25.1, VR3.2 (WIPER)
PWMSource: S2.C1 (COM_1), S2.C2 (COM_2), VR3.3 (CW)
S5_A_1: R6.1, R7.2, S1.1 (A_1)
S5_A_2: R5.1, R6.2, S1.2 (A_2)
S5_A_3: R4.1, R5.2, S1.3 (A_3)
S5_A_4: R3.1, R4.2, S1.4 (A_4)
S5_A_COM: IC1.1 (INPUT_+), S1.9 (COM_A)
Sine: VR2.3 (CW); also elsewhere on the board
SoftSyncIn: C5.1; also elsewhere on the board
Triangle: R86.1; also elsewhere on the board
VP: IC2.4; also elsewhere on the board
Vfci: IC2.15, R11.2, R12.2, R13.2, R14.2, R15.2, R16.1, R17.1, R21.1
Vpwm: C8.2, IC2.5, R25.2, R31.1
Vso: IC2.8; also elsewhere on the board
Vtri: IC2.10; also elsewhere on the board

Notes on the sheet:
Vhft High Freq Track
LFO
TRIM
MOD
Vee
MAN
Sawtooth Output
PWM Input
RANGE
Vcc
PWM SOURCE
Vhsi Hard Sync Input
PWM TRIM
Vlfi Linear FM Input
16'
Pulse Output
Vs Scale
Scale1
Scale2
Triangle Output
Cap Capacitor
PWM Duty
Frequency Contlor Input
Soft Sync Input
TUNE
ENV

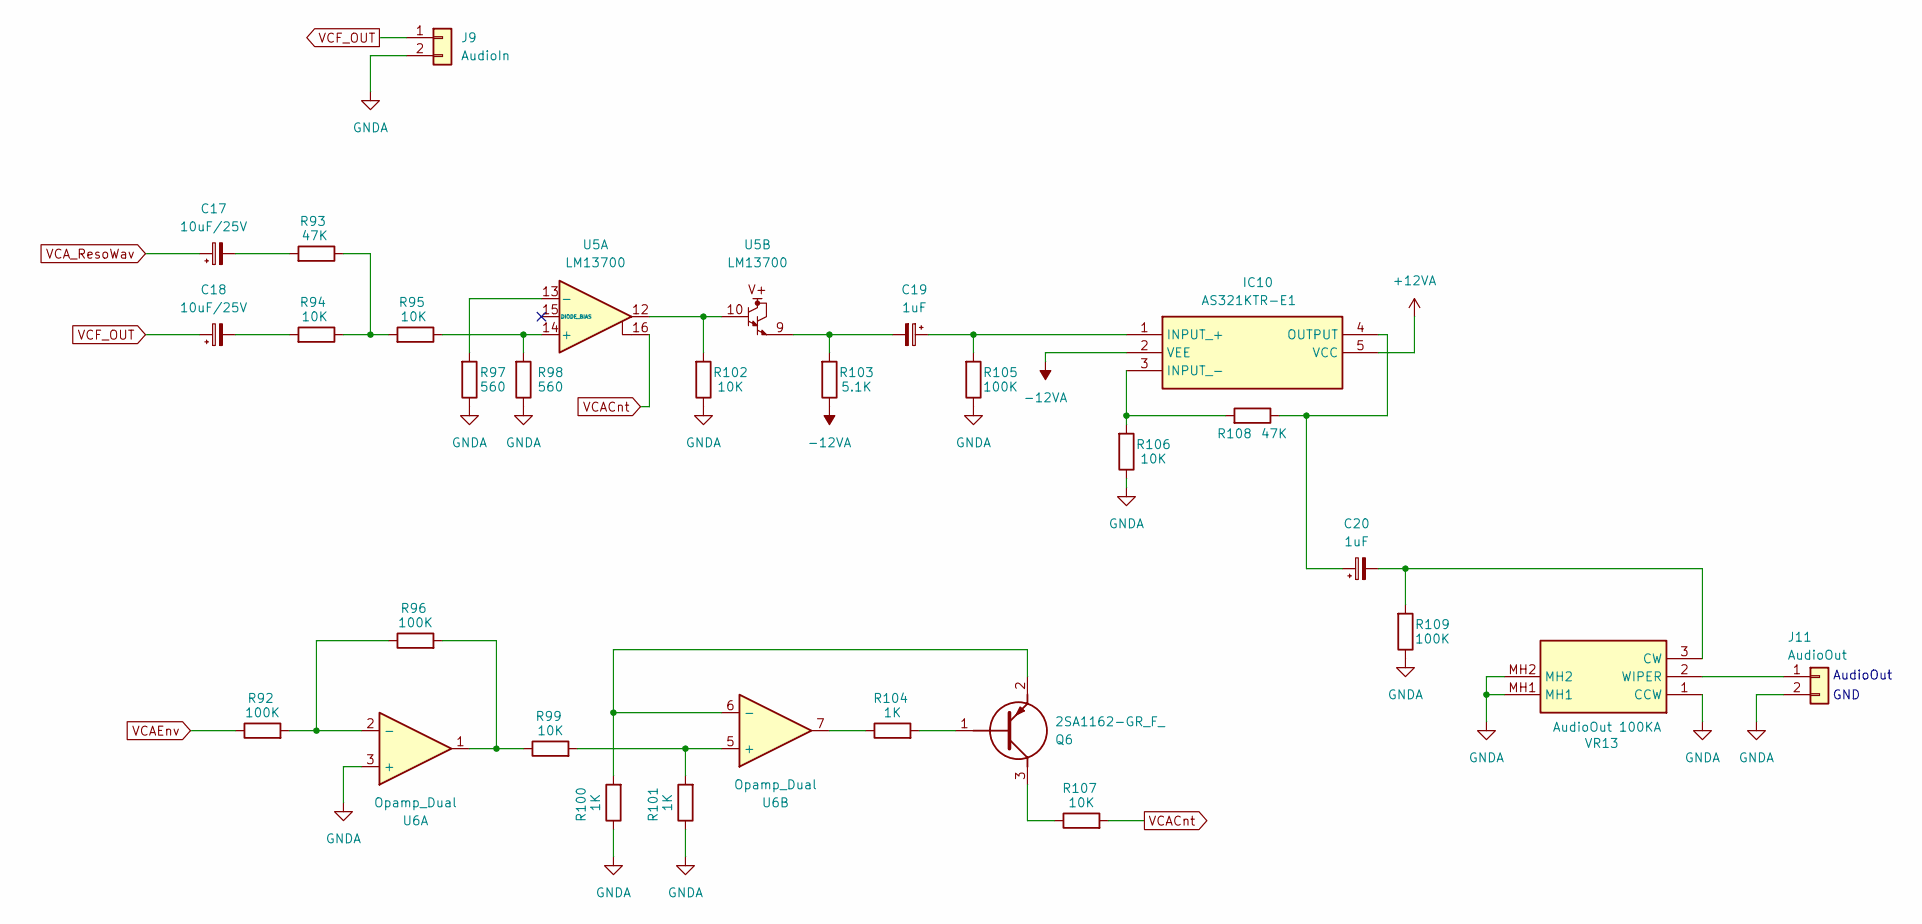
[picture p30: schematic VCA.kicad_sch]

Parts:
C17, C18: 10uF/25V; CP_Radial_D5.0mm_P2.50mm
C19, C20: 1uF; CP_Radial_D5.0mm_P2.50mm
IC10: AS321KTR-E1; SOT95P282X145-5N; Manufacturer_Part_Number AS321KTR-E1; Mouser Part Number 621-AS321KTR-E1
J9: AudioIn; PinSocket_1x02_P2.54mm_Vertical
J11: AudioOut; PinHeader_1x02_P2.54mm_Vertical
Q6: 2SA1162-GR_F_; 1SS294LFT; Manufacturer_Part_Number 2SA1162-GR(F)
R92, R96, R105, R109: 100K; R_Axial_DIN0207_L6.3mm_D2.5mm_P2.54mm_Vertical
R93, R108: 47K; R_Axial_DIN0207_L6.3mm_D2.5mm_P2.54mm_Vertical
R94, R95, R99, R102, R106, R107: 10K; R_Axial_DIN0207_L6.3mm_D2.5mm_P2.54mm_Vertical
R97, R98: 560; R_Axial_DIN0207_L6.3mm_D2.5mm_P2.54mm_Vertical
R100, R101, R104: 1K; R_Axial_DIN0207_L6.3mm_D2.5mm_P2.54mm_Vertical
R103: 5.1K; R_Axial_DIN0207_L6.3mm_D2.5mm_P2.54mm_Vertical
U5: LM13700; SOIC-16_3.9x9.9mm_P1.27mm
U6: Opamp_Dual; SOIC-8_3.9x4.9mm_P1.27mm
VR13: AudioOut 100KA; RK09D117000B; Manufacturer_Part_Number RK09D117000B; Mouser Part Number 688-RK09D117000B

Connections:
+12VA: IC10.5 (VCC); also elsewhere on the board
-12VA: IC10.2 (VEE), R103.1; also elsewhere on the board
GNDA: J9.2, J11.2, R97.1, R98.1, R100.1, R101.1, R102.1, R105.1, R106.1, R109.1, U6.3 (+), VR13.1 (CCW), VR13.MH1, VR13.MH2; also elsewhere on the board
unnamed: C17.2, R93.2
unnamed: C18.2, R94.2
unnamed: C19.2, R103.2, U5.9
unnamed: C19.1, IC10.1 (INPUT_+), R105.2
unnamed: IC10.3 (INPUT_-), R106.2, R108.2
unnamed: C20.1, IC10.4 (OUTPUT), R108.1
unnamed: J11.1, VR13.2 (WIPER)
unnamed: Q6.1 (B), R104.2
unnamed: Q6.3 (C), R107.1
unnamed: Q6.2 (E), R100.2, U6.6 (-)
unnamed: R93.1, R94.1, R95.2
unnamed: R96.2, R99.1, U6.1
unnamed: R102.2, U5.10, U5.12
unnamed: R104.1, U6.7
unnamed: R95.1, R98.2, U5.14 (+)
unnamed: R97.2, U5.13 (-)
unnamed: R92.2, R96.1, U6.2 (-)
unnamed: R99.2, R101.2, U6.5 (+)
unnamed: C20.2, R109.2, VR13.3 (CW)
VCACnt: R107.2, U5.16
VCAEnv: R92.1; also elsewhere on the board
VCA_ResoWav: C17.1; also elsewhere on the board
VCF_OUT: C18.1, J9.1; also elsewhere on the board

Notes on the sheet:
AudioOut
GND

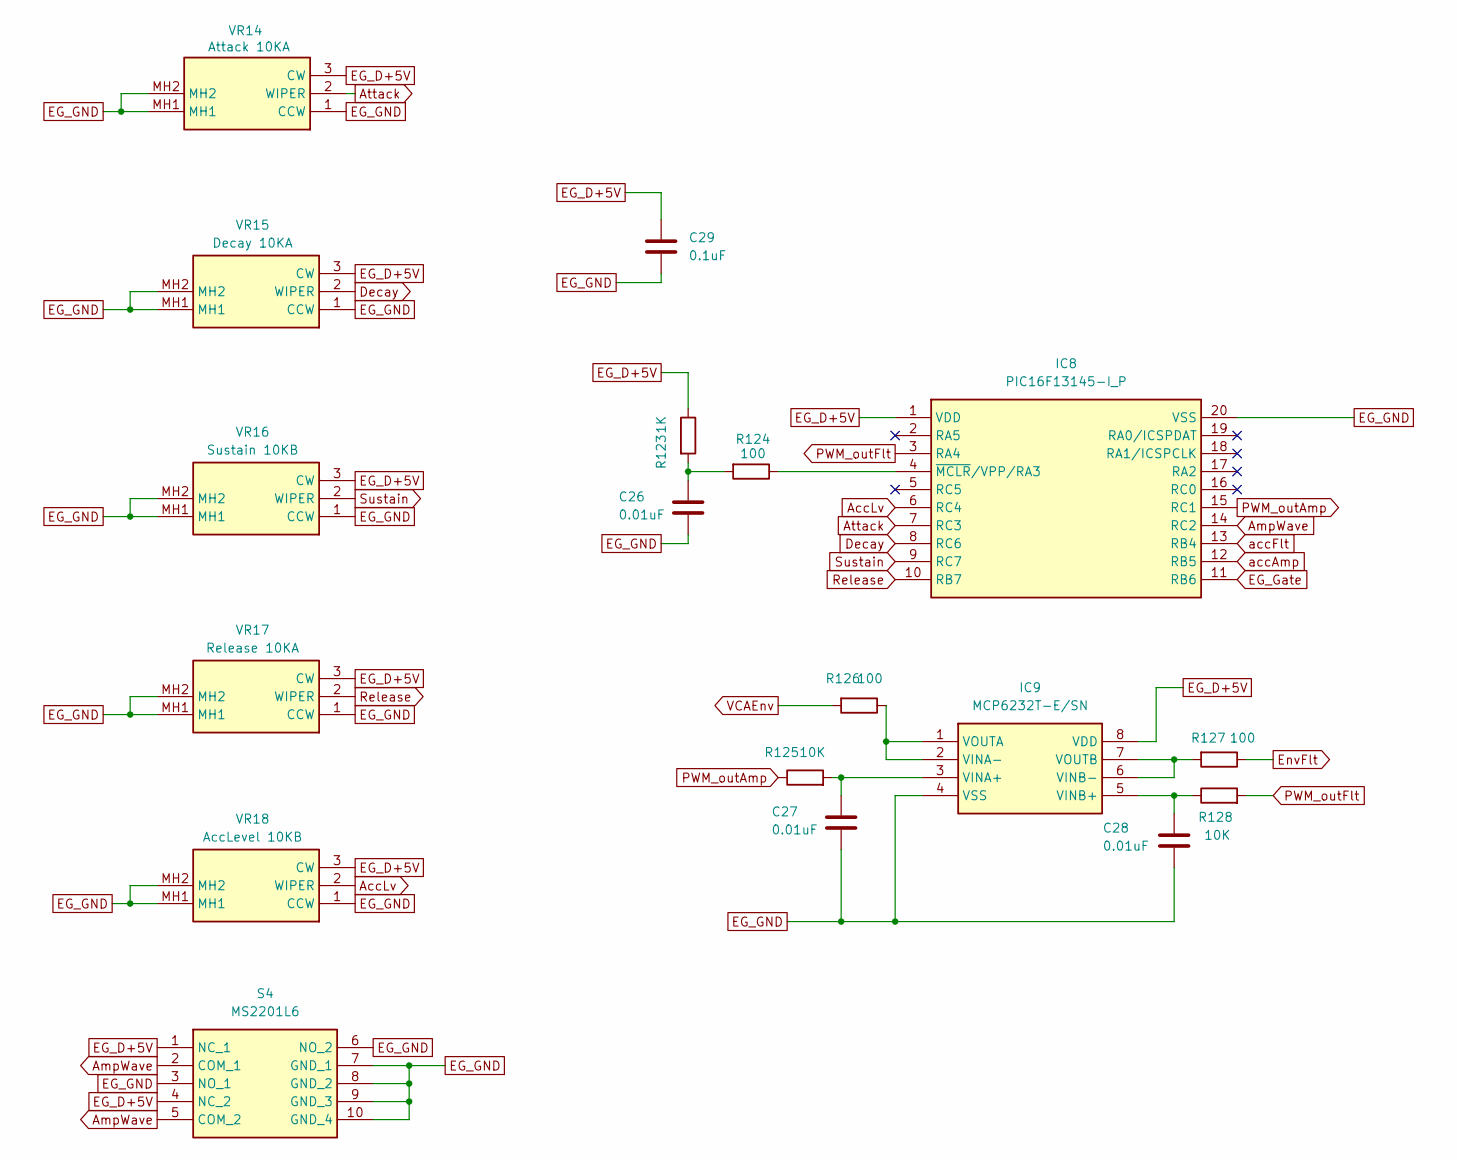
[picture p31: schematic EG_POT.kicad_sch]

Parts:
C26, C27, C28: 0.01uF; C_Disc_D4.3mm_W1.9mm_P5.00mm
C29: 0.1uF; C_0805_2012Metric_Pad1.18x1.45mm_HandSolder
IC8: PIC16F13145-I_P; DIP794W56P254L2591H533Q20N; Manufacturer_Part_Number PIC16F13145-I/P; Mouser Part Number 579-PIC16F13145-I/P
IC9: MCP6232T-E/SN; SOIC-8_3.9x4.9mm_P1.27mm; Manufacturer_Part_Number MCP6232-E/P; Mouser Part Number 579-MCP6232-E/P
R123: 1K; R_Axial_DIN0204_L3.6mm_D1.6mm_P2.54mm_Vertical
R124, R126, R127: 100; R_Axial_DIN0204_L3.6mm_D1.6mm_P2.54mm_Vertical
R125, R128: 10K; R_Axial_DIN0204_L3.6mm_D1.6mm_P2.54mm_Vertical
S4: MS2201L6; Manufacturer_Part_Number MS2201L6
VR14: Attack 10KA; RK09D117000B; Manufacturer_Part_Number RK09D117000B; Mouser Part Number 688-RK09D117000B
VR15: Decay 10KA; RK09D117000B; Manufacturer_Part_Number RK09D117000B; Mouser Part Number 688-RK09D117000B
VR16: Sustain 10KB; RK09D117000B; Manufacturer_Part_Number RK09D117000B; Mouser Part Number 688-RK09D117000B
VR17: Release 10KA; RK09D117000B; Manufacturer_Part_Number RK09D117000B; Mouser Part Number 688-RK09D117000B
VR18: AccLevel 10KB; RK09D117000B; Manufacturer_Part_Number RK09D117000B; Mouser Part Number 688-RK09D117000B

Connections:
AccLv: IC8.6 (RC4), VR18.2 (WIPER)
AmpWave: IC8.14 (RC2), S4.2 (COM_1), S4.5 (COM_2)
Attack: IC8.7 (RC3), VR14.2 (WIPER)
Decay: IC8.8 (RC6), VR15.2 (WIPER)
EG_D+5V: C29.1, IC8.1 (VDD), IC9.8 (VDD), R123.1, S4.1 (NC_1), S4.4 (NC_2), VR14.3 (CW), VR15.3 (CW), VR16.3 (CW), VR17.3 (CW), VR18.3 (CW); also elsewhere on the board
EG_GND: C26.2, C27.2, C28.2, C29.2, IC8.20 (VSS), IC9.4 (VSS), S4.3 (NO_1), S4.6 (NO_2), S4.7 (GND_1), S4.8 (GND_2), S4.9 (GND_3), S4.10 (GND_4), VR14.1 (CCW), VR14.MH1, VR14.MH2, VR15.1 (CCW), VR15.MH1, VR15.MH2, VR16.1 (CCW), VR16.MH1, VR16.MH2, VR17.1 (CCW), VR17.MH1, VR17.MH2, VR18.1 (CCW), VR18.MH1, VR18.MH2; also elsewhere on the board
EG_Gate: IC8.11 (RB6); also elsewhere on the board
EnvFlt: R127.1; also elsewhere on the board
unnamed: C26.1, R123.2, R124.2
unnamed: IC8.4 (~MCLR/VPP/RA3), R124.1
unnamed: C27.1, IC9.3 (VINA+), R125.2
unnamed: IC9.1 (VOUTA), IC9.2 (VINA-), R126.1
unnamed: C28.1, IC9.5 (VINB+), R128.1
unnamed: IC9.6 (VINB-), IC9.7 (VOUTB), R127.2
PWM_outAmp: IC8.15 (RC1), R125.1
PWM_outFlt: IC8.3 (RA4), R128.2
Release: IC8.10 (RB7), VR17.2 (WIPER)
Sustain: IC8.9 (RC7), VR16.2 (WIPER)
VCAEnv: R126.2; also elsewhere on the board
accAmp: IC8.12 (RB5); also elsewhere on the board
accFlt: IC8.13 (RB4); also elsewhere on the board

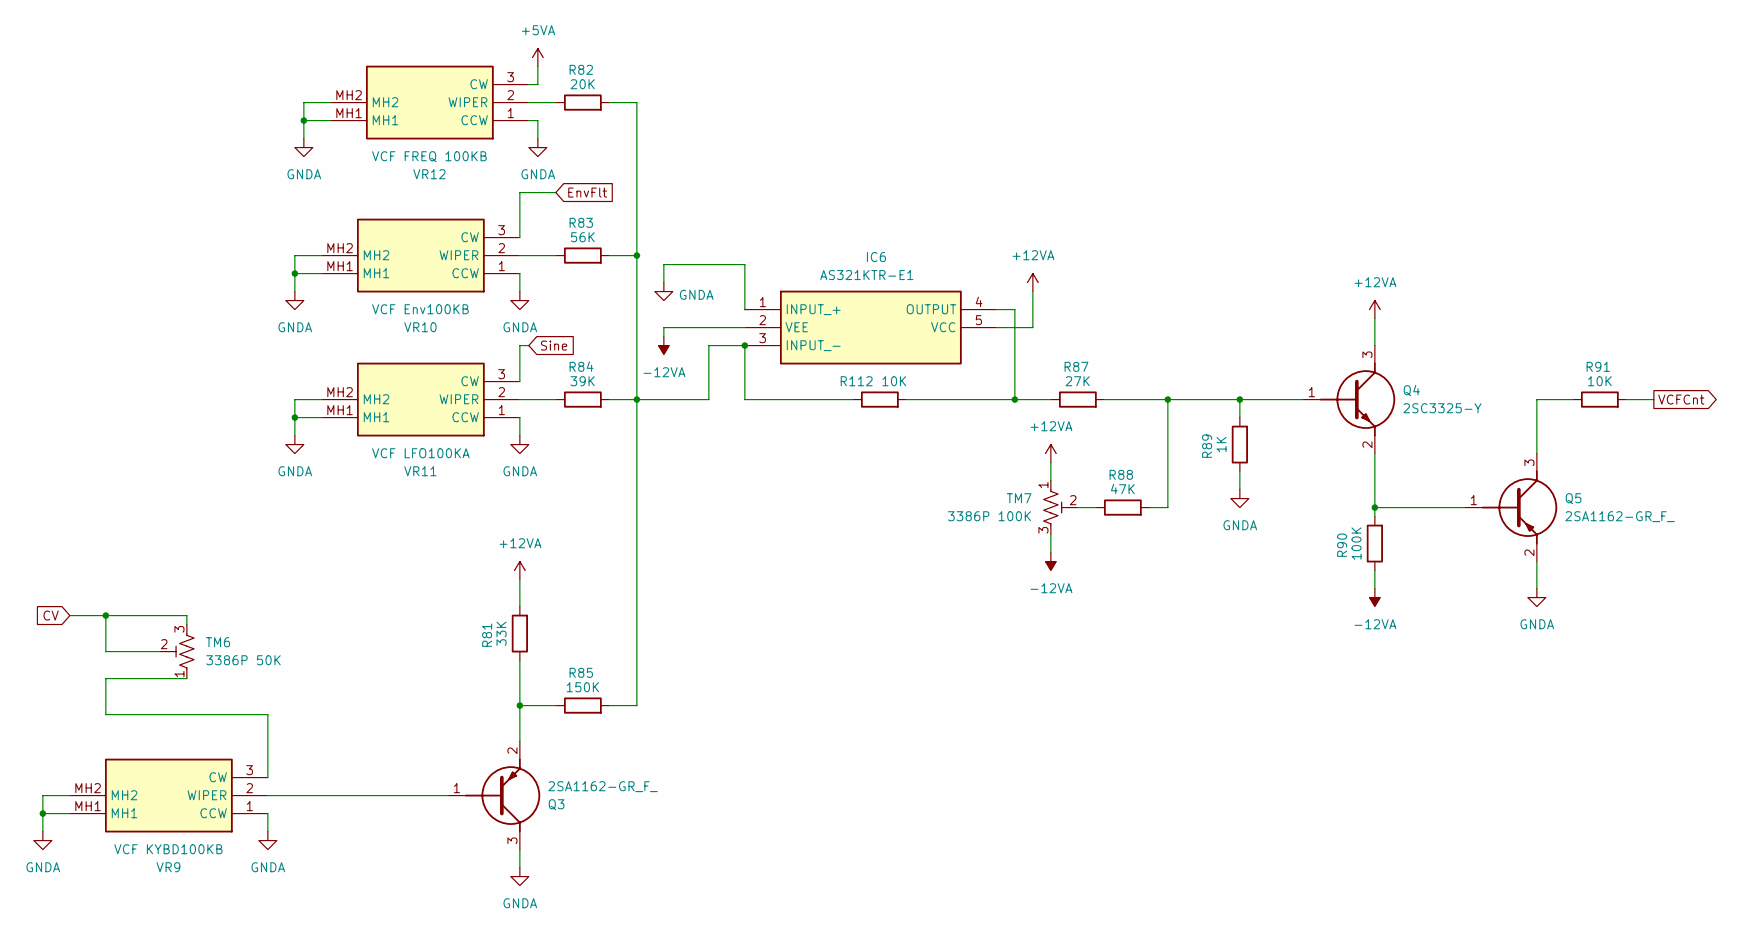
[picture p32: schematic VCF_CVMix.kicad_sch]

Parts:
IC6: AS321KTR-E1; SOT95P282X145-5N; Manufacturer_Part_Number AS321KTR-E1; Mouser Part Number 621-AS321KTR-E1
Q3, Q5: 2SA1162-GR_F_; 1SS294LFT; Manufacturer_Part_Number 2SA1162-GR(F)
Q4: 2SC3325-Y; 2SC3325YLF; Manufacturer_Part_Number 2SC3325-Y
R81: 33K; R_Axial_DIN0207_L6.3mm_D2.5mm_P2.54mm_Vertical
R82: 20K; R_Axial_DIN0207_L6.3mm_D2.5mm_P2.54mm_Vertical
R83: 56K; R_Axial_DIN0207_L6.3mm_D2.5mm_P2.54mm_Vertical
R84: 39K; R_Axial_DIN0207_L6.3mm_D2.5mm_P2.54mm_Vertical
R85: 150K; R_Axial_DIN0207_L6.3mm_D2.5mm_P2.54mm_Vertical
R87: 27K; R_Axial_DIN0207_L6.3mm_D2.5mm_P2.54mm_Vertical
R88: 47K; R_Axial_DIN0207_L6.3mm_D2.5mm_P2.54mm_Vertical
R89: 1K; R_Axial_DIN0207_L6.3mm_D2.5mm_P2.54mm_Vertical
R90: 100K; R_Axial_DIN0207_L6.3mm_D2.5mm_P2.54mm_Vertical
R91, R112: 10K; R_Axial_DIN0207_L6.3mm_D2.5mm_P2.54mm_Vertical
TM6: 3386P 50K; Potentiometer_Bourns_3386P_Vertical
TM7: 3386P 100K; Potentiometer_Bourns_3386P_Vertical
VR9: VCF KYBD100KB; RK09D117000B; Manufacturer_Part_Number RK09D117000B; Mouser Part Number 688-RK09D117000B
VR10: VCF Env100KB; RK09D117000B; Manufacturer_Part_Number RK09D117000B; Mouser Part Number 688-RK09D117000B
VR11: VCF LFO100KA; RK09D117000B; Manufacturer_Part_Number RK09D117000B; Mouser Part Number 688-RK09D117000B
VR12: VCF FREQ 100KB; RK09D117000B; Manufacturer_Part_Number RK09D117000B; Mouser Part Number 688-RK09D117000B

Connections:
+5VA: VR12.3 (CW); also elsewhere on the board
+12VA: IC6.5 (VCC), Q4.3 (C), R81.2, TM7.1; also elsewhere on the board
-12VA: IC6.2 (VEE), R90.1, TM7.3; also elsewhere on the board
CV: TM6.2, TM6.3; also elsewhere on the board
EnvFlt: VR10.3 (CW); also elsewhere on the board
GNDA: IC6.1 (INPUT_+), Q3.3 (C), Q5.2 (E), R89.1, VR9.1 (CCW), VR9.MH1, VR9.MH2, VR10.1 (CCW), VR10.MH1, VR10.MH2, VR11.1 (CCW), VR11.MH1, VR11.MH2, VR12.1 (CCW), VR12.MH1, VR12.MH2; also elsewhere on the board
unnamed: IC6.3 (INPUT_-), R82.2, R83.2, R84.2, R85.2, R112.1
unnamed: IC6.4 (OUTPUT), R87.1, R112.2
unnamed: Q3.1 (B), VR9.2 (WIPER)
unnamed: Q3.2 (E), R81.1, R85.1
unnamed: Q4.1 (B), R87.2, R88.2, R89.2
unnamed: Q4.2 (E), Q5.1 (B), R90.2
unnamed: Q5.3 (C), R91.1
unnamed: R88.1, TM7.2
unnamed: TM6.1, VR9.3 (CW)
unnamed: R83.1, VR10.2 (WIPER)
unnamed: R84.1, VR11.2 (WIPER)
unnamed: R82.1, VR12.2 (WIPER)
Sine: VR11.3 (CW); also elsewhere on the board
VCFCnt: R91.2; also elsewhere on the board

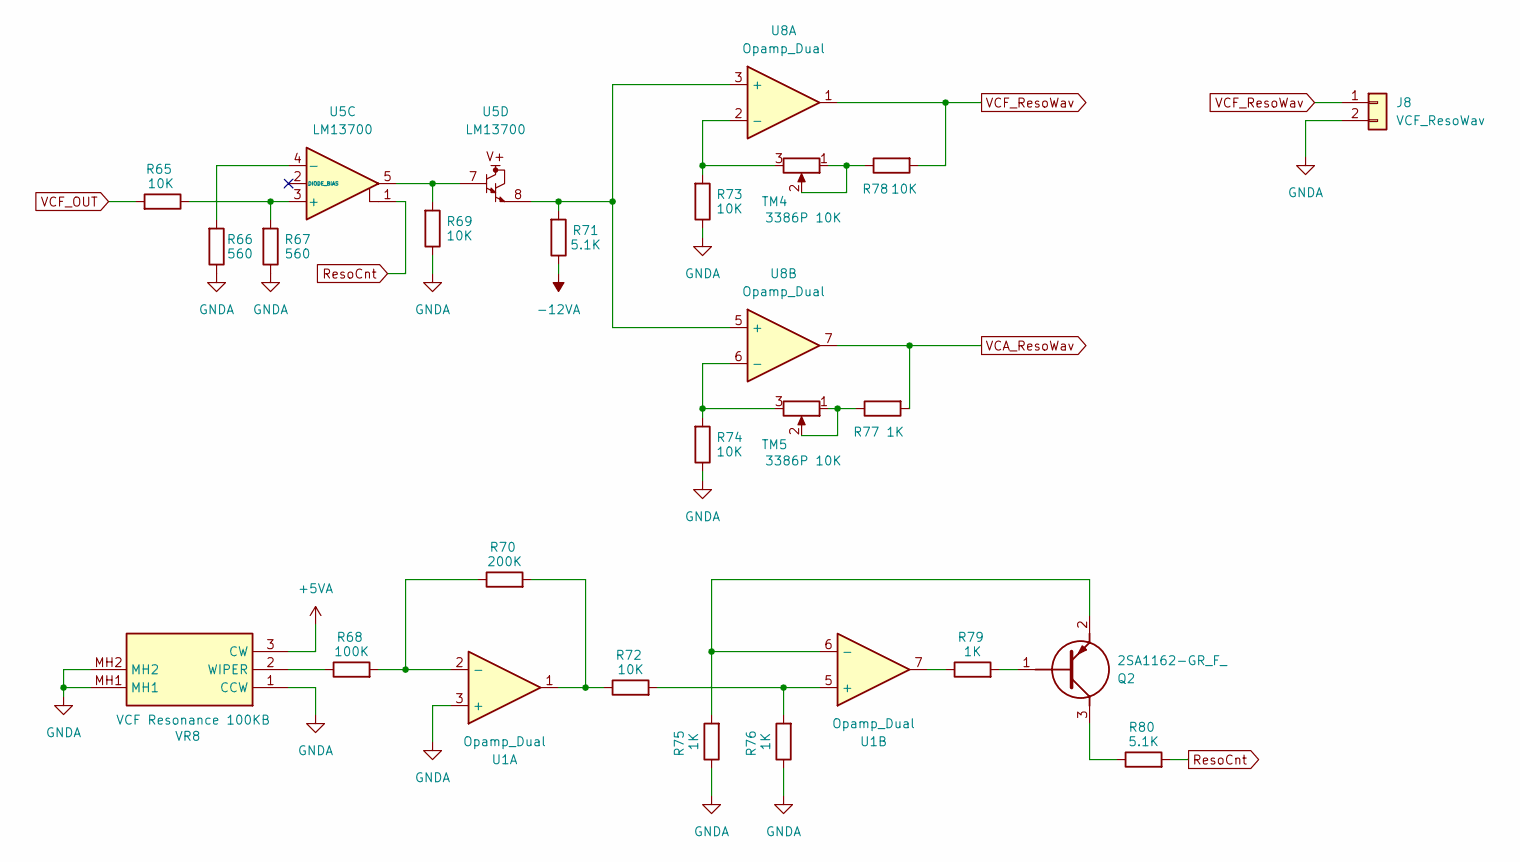
[picture p33: schematic VCFResonance.kicad_sch]

Parts:
J8: VCF_ResoWav; PinSocket_1x02_P2.54mm_Vertical
Q2: 2SA1162-GR_F_; 1SS294LFT; Manufacturer_Part_Number 2SA1162-GR(F)
R65, R69, R72, R73, R74, R78: 10K; R_Axial_DIN0207_L6.3mm_D2.5mm_P2.54mm_Vertical
R66, R67: 560; R_Axial_DIN0207_L6.3mm_D2.5mm_P2.54mm_Vertical
R68: 100K; R_Axial_DIN0207_L6.3mm_D2.5mm_P2.54mm_Vertical
R70: 200K; R_Axial_DIN0207_L6.3mm_D2.5mm_P2.54mm_Vertical
R71, R80: 5.1K; R_Axial_DIN0207_L6.3mm_D2.5mm_P2.54mm_Vertical
R75, R76, R77, R79: 1K; R_Axial_DIN0207_L6.3mm_D2.5mm_P2.54mm_Vertical
TM4, TM5: 3386P 10K; Potentiometer_Bourns_3386P_Vertical
U1, U8: Opamp_Dual; SOIC-8_3.9x4.9mm_P1.27mm
U5: LM13700; SOIC-16_3.9x9.9mm_P1.27mm
VR8: VCF Resonance 100KB; RK09D117000B; Manufacturer_Part_Number RK09D117000B; Mouser Part Number 688-RK09D117000B

Connections:
+5VA: VR8.3 (CW); also elsewhere on the board
-12VA: R71.1; also elsewhere on the board
GNDA: J8.2, R66.1, R67.1, R69.1, R73.1, R74.1, R75.1, R76.1, U1.3 (+), VR8.1 (CCW), VR8.MH1, VR8.MH2; also elsewhere on the board
unnamed: Q2.1 (B), R79.2
unnamed: Q2.3 (C), R80.1
unnamed: Q2.2 (E), R75.2, U1.6 (-)
unnamed: R69.2, U5.5, U5.7
unnamed: R70.2, R72.1, U1.1
unnamed: R77.1, TM5.1, TM5.2
unnamed: R78.1, TM4.1, TM4.2
unnamed: R79.1, U1.7
unnamed: R68.2, R70.1, U1.2 (-)
unnamed: R72.2, R76.2, U1.5 (+)
unnamed: R65.1, R67.2, U5.3 (+)
unnamed: R66.2, U5.4 (-)
unnamed: R71.2, U5.8, U8.3 (+), U8.5 (+)
unnamed: R73.2, TM4.3, U8.2 (-)
unnamed: R74.2, TM5.3, U8.6 (-)
unnamed: R68.1, VR8.2 (WIPER)
ResoCnt: R80.2, U5.1
VCA_ResoWav: R77.2, U8.7; also elsewhere on the board
VCF_OUT: R65.2; also elsewhere on the board
VCF_ResoWav: J8.1, R78.2, U8.1; also elsewhere on the board
