wakimizufu/MC2/SynthBoard_Rotary/VCOBoardRev2/VCOSeparate.kicad_pcb

## KiCad design SynthBoard_Rotary/VCOBoardRev2/VCOSeparate.kicad_pcb (continued)

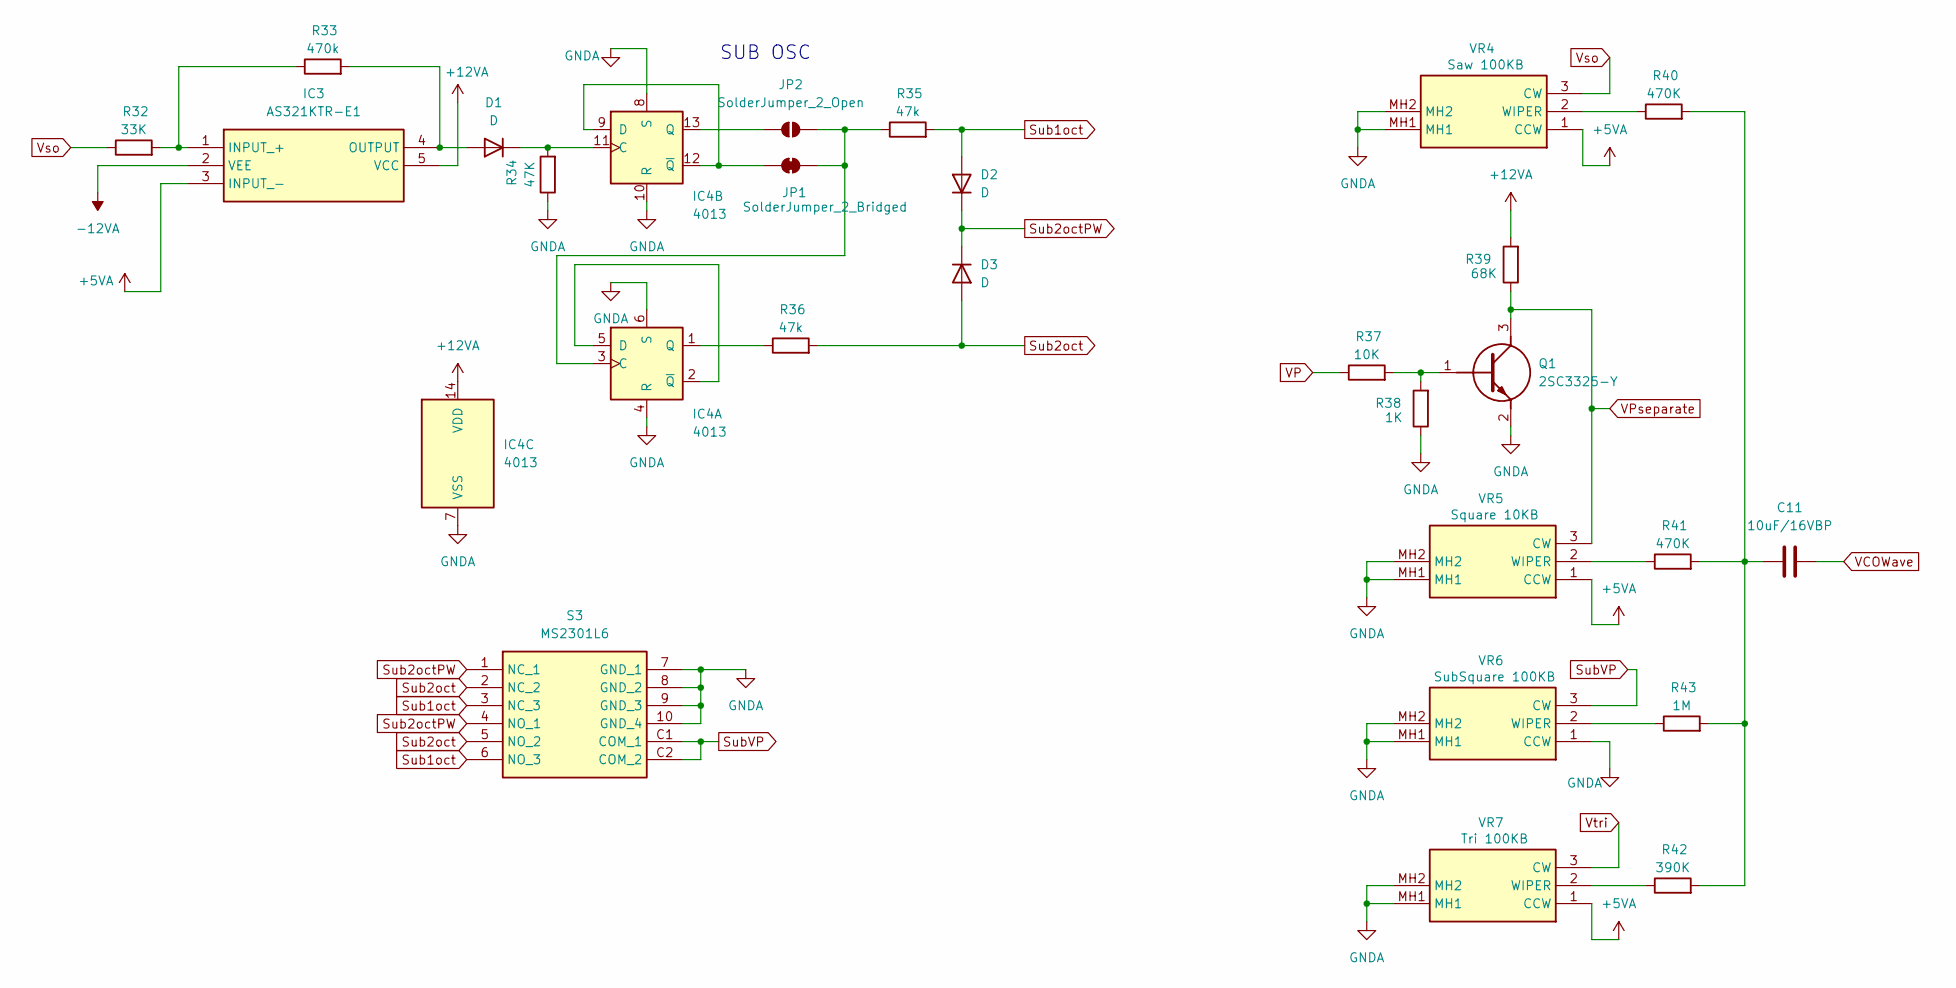
[picture p34: schematic Waveform.kicad_sch]

Parts:
C11: 10uF/16VBP; CP_Radial_D5.0mm_P2.50mm
D1, D2, D3: D; D_DO-15_P2.54mm_Vertical_AnodeUp
IC3: AS321KTR-E1; SOT95P282X145-5N; Manufacturer_Part_Number AS321KTR-E1; Mouser Part Number 621-AS321KTR-E1
IC4: 4013; SOIC-14_3.9x8.7mm_P1.27mm
JP1: SolderJumper_2_Bridged; SolderJumper-2_P1.3mm_Bridged2Bar_RoundedPad1.0x1.5mm
JP2: SolderJumper_2_Open; SolderJumper-2_P1.3mm_Open_RoundedPad1.0x1.5mm
Q1: 2SC3325-Y; 2SC3325YLF; Manufacturer_Part_Number 2SC3325-Y
R32: 33K; R_Axial_DIN0207_L6.3mm_D2.5mm_P2.54mm_Vertical
R33: 470k; R_Axial_DIN0207_L6.3mm_D2.5mm_P2.54mm_Vertical
R34: 47K; R_Axial_DIN0207_L6.3mm_D2.5mm_P2.54mm_Vertical
R35, R36: 47k; R_Axial_DIN0207_L6.3mm_D2.5mm_P2.54mm_Vertical
R37: 10K; R_Axial_DIN0207_L6.3mm_D2.5mm_P2.54mm_Vertical
R38: 1K; R_Axial_DIN0207_L6.3mm_D2.5mm_P2.54mm_Vertical
R39: 68K; R_Axial_DIN0207_L6.3mm_D2.5mm_P2.54mm_Vertical
R40, R41: 470K; R_Axial_DIN0207_L6.3mm_D2.5mm_P2.54mm_Vertical
R42: 390K; R_Axial_DIN0207_L6.3mm_D2.5mm_P2.54mm_Vertical
R43: 1M; R_Axial_DIN0207_L6.3mm_D2.5mm_P2.54mm_Vertical
S3: MS2301L6; Manufacturer_Part_Number MS2301L6
VR4: Saw 100KB; RK09D117000B; Manufacturer_Part_Number RK09D117000B; Mouser Part Number 688-RK09D117000B
VR5: Square 10KB; RK09D117000B; Manufacturer_Part_Number RK09D117000B; Mouser Part Number 688-RK09D117000B
VR6: SubSquare 100KB; RK09D117000B; Manufacturer_Part_Number RK09D117000B; Mouser Part Number 688-RK09D117000B
VR7: Tri 100KB; RK09D117000B; Manufacturer_Part_Number RK09D117000B; Mouser Part Number 688-RK09D117000B

Connections:
+5VA: IC3.3 (INPUT_-), VR4.1 (CCW), VR5.1 (CCW), VR7.1 (CCW); also elsewhere on the board
+12VA: IC3.5 (VCC), IC4.14 (VDD), R39.2; also elsewhere on the board
-12VA: IC3.2 (VEE); also elsewhere on the board
GNDA: IC4.4 (R), IC4.6 (S), IC4.7 (VSS), IC4.8 (S), IC4.10 (R), Q1.2 (E), R34.1, R38.1, S3.7 (GND_1), S3.8 (GND_2), S3.9 (GND_3), S3.10 (GND_4), VR4.MH1, VR4.MH2, VR5.MH1, VR5.MH2, VR6.1 (CCW), VR6.MH1, VR6.MH2, VR7.MH1, VR7.MH2; also elsewhere on the board
unnamed: C11.1, R40.2, R41.2, R42.2, R43.2
unnamed: D1.2 (A), IC3.4 (OUTPUT), R33.2
unnamed: D1.1 (K), IC4.11 (C), R34.2
unnamed: IC3.1 (INPUT_+), R32.2, R33.1
unnamed: IC4.3 (C), JP1.2 (B), JP2.2 (B), R35.1
unnamed: IC4.2 (~Q), IC4.5 (D)
unnamed: IC4.1 (Q), R36.1
unnamed: IC4.9 (D), IC4.12 (~Q), JP1.1 (A)
unnamed: IC4.13 (Q), JP2.1 (A)
unnamed: Q1.1 (B), R37.2, R38.2
unnamed: R40.1, VR4.2 (WIPER)
unnamed: R41.1, VR5.2 (WIPER)
unnamed: R43.1, VR6.2 (WIPER)
unnamed: R42.1, VR7.2 (WIPER)
Sub1oct: D2.2 (A), R35.2, S3.3 (NC_3), S3.6 (NO_3)
Sub2oct: D3.2 (A), R36.2, S3.2 (NC_2), S3.5 (NO_2)
Sub2octPW: D2.1 (K), D3.1 (K), S3.1 (NC_1), S3.4 (NO_1)
SubVP: S3.C1 (COM_1), S3.C2 (COM_2), VR6.3 (CW); also elsewhere on the board
VCOWave: C11.2; also elsewhere on the board
VP: R37.1; also elsewhere on the board
VPseparate: Q1.3 (C), R39.1, VR5.3 (CW); also elsewhere on the board
Vso: R32.1, VR4.3 (CW); also elsewhere on the board
Vtri: VR7.3 (CW); also elsewhere on the board

Notes on the sheet:
SUB OSC

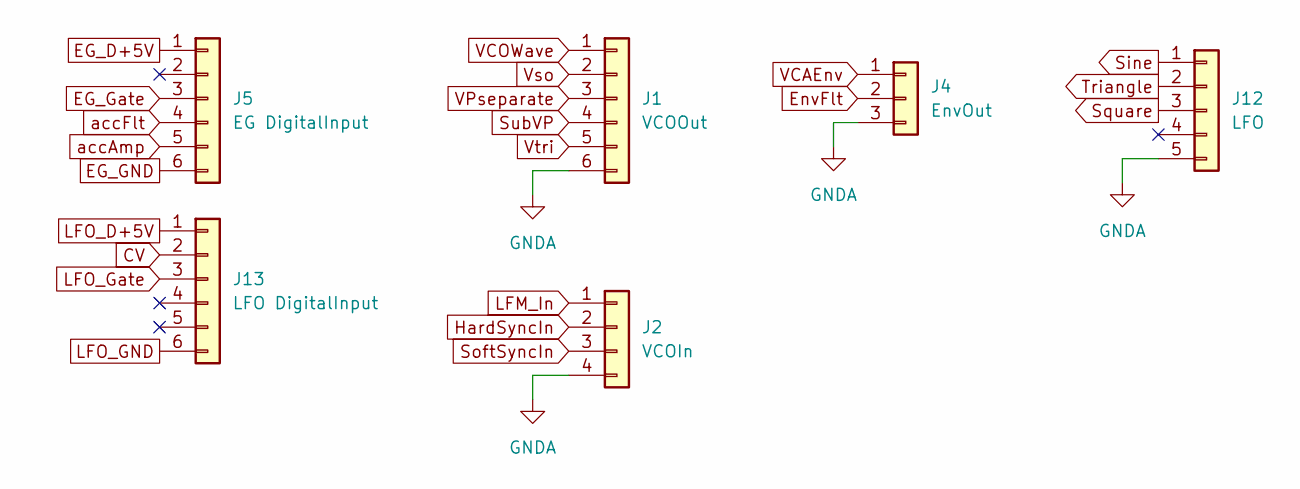
[picture p35: schematic connect.kicad_sch]

Parts:
J1: VCOOut; PinSocket_1x06_P2.54mm_Vertical
J2: VCOIn; PinSocket_1x04_P2.54mm_Vertical
J4: EnvOut; PinSocket_1x03_P2.54mm_Vertical
J5: EG DigitalInput; PinSocket_1x06_P2.54mm_Vertical
J12: LFO; PinSocket_1x05_P2.54mm_Vertical
J13: LFO DigitalInput; PinSocket_1x06_P2.54mm_Vertical

Connections:
CV: J13.2; also elsewhere on the board
EG_D+5V: J5.1; also elsewhere on the board
EG_GND: J5.6; also elsewhere on the board
EG_Gate: J5.3; also elsewhere on the board
EnvFlt: J4.2; also elsewhere on the board
GNDA: J1.6, J2.4, J4.3, J12.5; also elsewhere on the board
HardSyncIn: J2.2; also elsewhere on the board
LFM_In: J2.1; also elsewhere on the board
LFO_D+5V: J13.1; also elsewhere on the board
LFO_GND: J13.6; also elsewhere on the board
LFO_Gate: J13.3; also elsewhere on the board
Sine: J12.1; also elsewhere on the board
SoftSyncIn: J2.3; also elsewhere on the board
Square: J12.3; also elsewhere on the board
SubVP: J1.4; also elsewhere on the board
Triangle: J12.2; also elsewhere on the board
VCAEnv: J4.1; also elsewhere on the board
VCOWave: J1.1; also elsewhere on the board
VPseparate: J1.3; also elsewhere on the board
Vso: J1.2; also elsewhere on the board
Vtri: J1.5; also elsewhere on the board
accAmp: J5.5; also elsewhere on the board
accFlt: J5.4; also elsewhere on the board

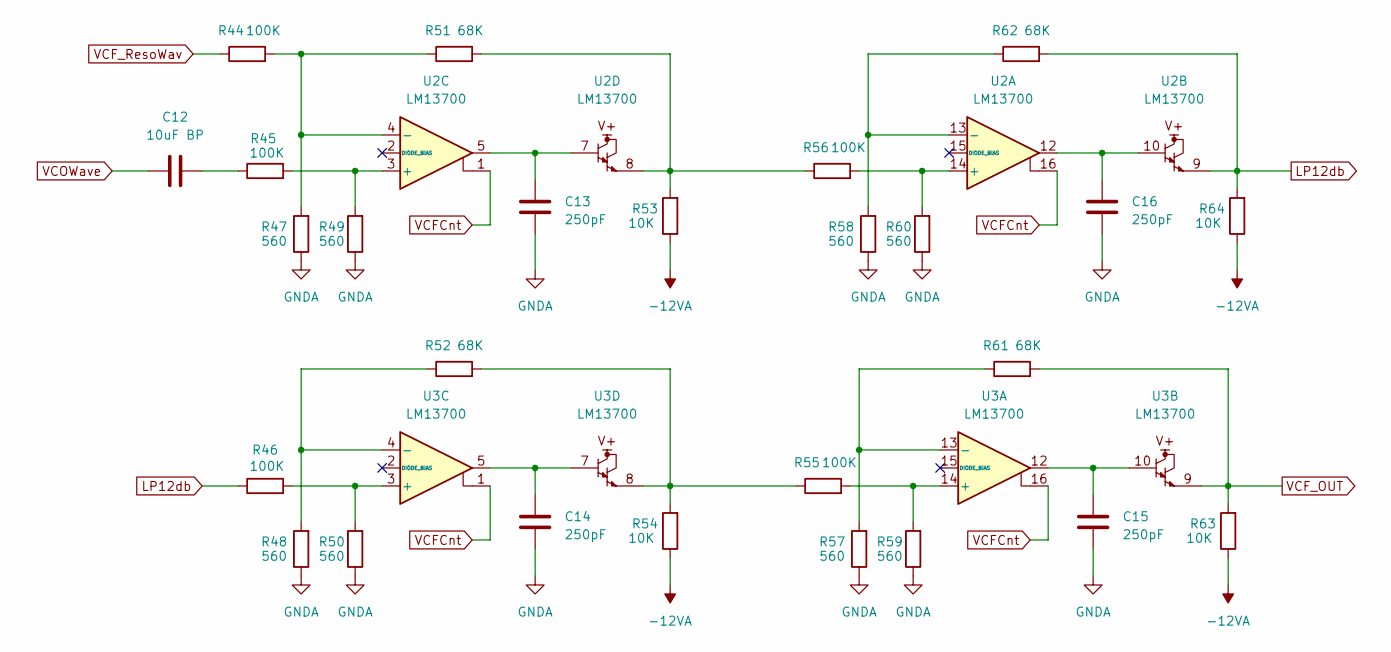
[picture p36: schematic VCF.kicad_sch]

Parts:
C12: 10uF BP; CP_Radial_D5.0mm_P2.50mm
C13, C14, C15, C16: 250pF; C_Disc_D5.0mm_W2.5mm_P5.00mm
R44, R45, R46, R55, R56: 100K; R_Axial_DIN0207_L6.3mm_D2.5mm_P2.54mm_Vertical
R47, R48, R49, R50, R57, R58, R59, R60: 560; R_Axial_DIN0207_L6.3mm_D2.5mm_P2.54mm_Vertical
R51, R52, R61, R62: 68K; R_Axial_DIN0207_L6.3mm_D2.5mm_P2.54mm_Vertical
R53, R54, R63, R64: 10K; R_Axial_DIN0207_L6.3mm_D2.5mm_P2.54mm_Vertical
U2, U3: LM13700; SOIC-16_3.9x9.9mm_P1.27mm

Connections:
-12VA: R53.1, R54.1, R63.1, R64.1; also elsewhere on the board
GNDA: C13.2, C14.2, C15.2, C16.2, R47.1, R48.1, R49.1, R50.1, R57.1, R58.1, R59.1, R60.1; also elsewhere on the board
LP12db: R46.1, R62.2, R64.2, U2.9
unnamed: C12.2, R45.1
unnamed: C13.1, U2.5, U2.7
unnamed: C14.1, U3.5, U3.7
unnamed: C15.1, U3.10, U3.12
unnamed: C16.1, U2.10, U2.12
unnamed: R51.2, R53.2, R56.1, U2.8
unnamed: R52.2, R54.2, R55.1, U3.8
unnamed: R56.2, R60.2, U2.14 (+)
unnamed: R58.2, R62.1, U2.13 (-)
unnamed: R45.2, R49.2, U2.3 (+)
unnamed: R44.2, R47.2, R51.1, U2.4 (-)
unnamed: R55.2, R59.2, U3.14 (+)
unnamed: R57.2, R61.1, U3.13 (-)
unnamed: R46.2, R50.2, U3.3 (+)
unnamed: R48.2, R52.1, U3.4 (-)
VCFCnt: U2.1, U2.16, U3.1, U3.16; also elsewhere on the board
VCF_OUT: R61.2, R63.2, U3.9; also elsewhere on the board
VCF_ResoWav: R44.1; also elsewhere on the board
VCOWave: C12.1; also elsewhere on the board

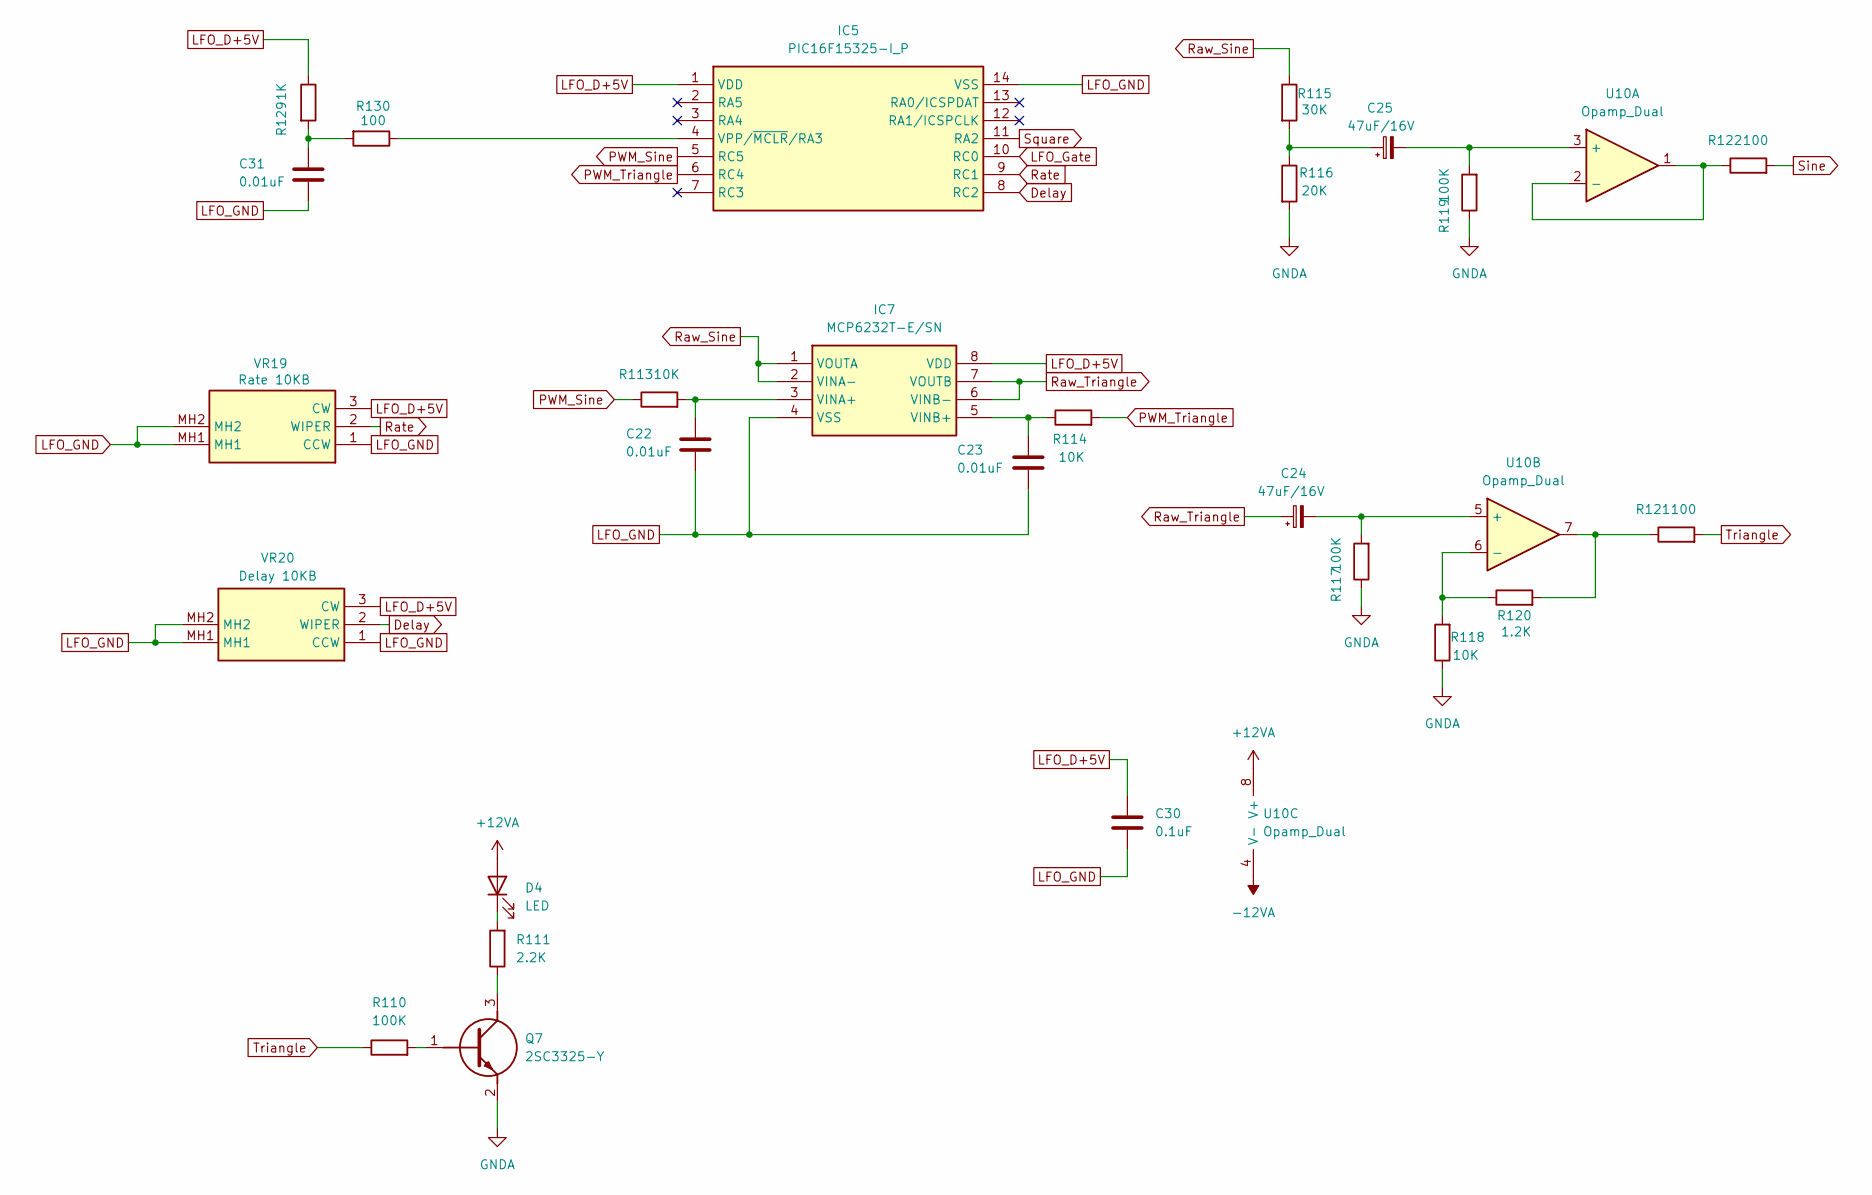
[picture p37: schematic LFO_POT.kicad_sch]

Parts:
C22, C23, C31: 0.01uF; C_Disc_D4.3mm_W1.9mm_P5.00mm
C24, C25: 47uF/16V; CP_Radial_D5.0mm_P2.50mm
C30: 0.1uF; C_0805_2012Metric_Pad1.18x1.45mm_HandSolder
D4: LED; LED_D5.0mm
IC5: PIC16F15325-I_P; DIP-14_W7.62mm_LongPads; Manufacturer_Part_Number PIC16F15325-I/P; Mouser Part Number 579-PIC16F15325-I/P
IC7: MCP6232T-E/SN; SOIC-8_3.9x4.9mm_P1.27mm; Manufacturer_Part_Number MCP6232-E/P; Mouser Part Number 579-MCP6232-E/P
Q7: 2SC3325-Y; 2SC3325YLF; Manufacturer_Part_Number 2SC3325-Y
R110: 100K; R_Axial_DIN0207_L6.3mm_D2.5mm_P2.54mm_Vertical
R111: 2.2K; R_Axial_DIN0204_L3.6mm_D1.6mm_P2.54mm_Vertical
R113, R114, R118: 10K; R_Axial_DIN0204_L3.6mm_D1.6mm_P2.54mm_Vertical
R115: 30K; R_Axial_DIN0204_L3.6mm_D1.6mm_P2.54mm_Vertical
R116: 20K; R_Axial_DIN0204_L3.6mm_D1.6mm_P2.54mm_Vertical
R117, R119: 100K; R_Axial_DIN0204_L3.6mm_D1.6mm_P2.54mm_Vertical
R120: 1.2K; R_Axial_DIN0204_L3.6mm_D1.6mm_P2.54mm_Vertical
R121, R122, R130: 100; R_Axial_DIN0204_L3.6mm_D1.6mm_P2.54mm_Vertical
R129: 1K; R_Axial_DIN0204_L3.6mm_D1.6mm_P2.54mm_Vertical
U10: Opamp_Dual; SOIC-8_3.9x4.9mm_P1.27mm
VR19: Rate 10KB; RK09D117000B; Manufacturer_Part_Number RK09D117000B; Mouser Part Number 688-RK09D117000B
VR20: Delay 10KB; RK09D117000B; Manufacturer_Part_Number RK09D117000B; Mouser Part Number 688-RK09D117000B

Connections:
+12VA: D4.2 (A), U10.8 (V+); also elsewhere on the board
-12VA: U10.4 (V-); also elsewhere on the board
Delay: IC5.8 (RC2), VR20.2 (WIPER)
GNDA: Q7.2 (E), R116.2, R117.1, R118.1, R119.1; also elsewhere on the board
LFO_D+5V: C30.1, IC5.1 (VDD), IC7.8 (VDD), R129.1, VR19.3 (CW), VR20.3 (CW); also elsewhere on the board
LFO_GND: C22.2, C23.2, C30.2, C31.2, IC5.14 (VSS), IC7.4 (VSS), VR19.1 (CCW), VR19.MH1, VR19.MH2, VR20.1 (CCW), VR20.MH1, VR20.MH2; also elsewhere on the board
LFO_Gate: IC5.10 (RC0); also elsewhere on the board
unnamed: C25.1, R115.2, R116.1
unnamed: C31.1, R129.2, R130.2
unnamed: D4.1 (K), R111.2
unnamed: IC5.4 (VPP/~MCLR/RA3), R130.1
unnamed: C22.1, IC7.3 (VINA+), R113.2
unnamed: C23.1, IC7.5 (VINB+), R114.1
unnamed: Q7.1 (B), R110.2
unnamed: Q7.3 (C), R111.1
unnamed: R120.2, R121.1, U10.7
unnamed: C25.2, R119.2, U10.3 (+)
unnamed: R122.1, U10.1, U10.2 (-)
unnamed: C24.2, R117.2, U10.5 (+)
unnamed: R118.2, R120.1, U10.6 (-)
PWM_Sine: IC5.5 (RC5), R113.1
PWM_Triangle: IC5.6 (RC4), R114.2
Rate: IC5.9 (RC1), VR19.2 (WIPER)
Raw_Sine: IC7.1 (VOUTA), IC7.2 (VINA-), R115.1
Raw_Triangle: C24.1, IC7.6 (VINB-), IC7.7 (VOUTB)
Sine: R122.2; also elsewhere on the board
Square: IC5.11 (RA2); also elsewhere on the board
Triangle: R110.1, R121.2; also elsewhere on the board

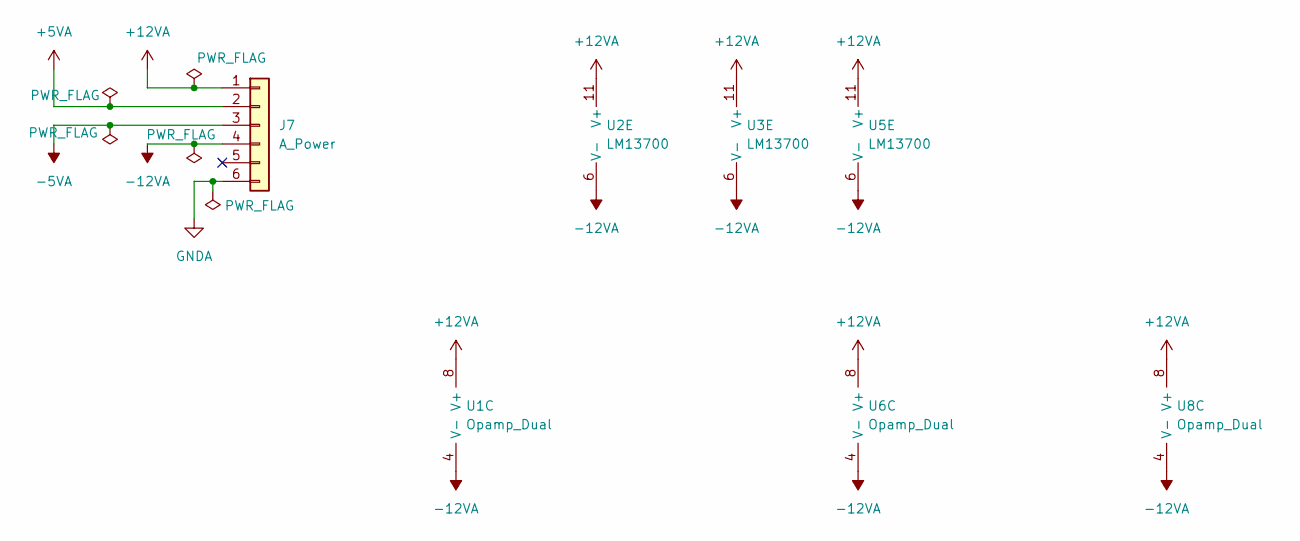
[picture p38: schematic Power.kicad_sch]

Parts:
J7: A_Power; PinHeader_1x06_P2.54mm_Vertical
U1, U6, U8: Opamp_Dual; SOIC-8_3.9x4.9mm_P1.27mm
U2, U3, U5: LM13700; SOIC-16_3.9x9.9mm_P1.27mm

Connections:
+5VA: J7.2; also elsewhere on the board
+12VA: J7.1, U1.8 (V+), U2.11 (V+), U3.11 (V+), U5.11 (V+), U6.8 (V+), U8.8 (V+); also elsewhere on the board
-5VA: J7.3; also elsewhere on the board
-12VA: J7.4, U1.4 (V-), U2.6 (V-), U3.6 (V-), U5.6 (V-), U6.4 (V-), U8.4 (V-); also elsewhere on the board
GNDA: J7.6; also elsewhere on the board

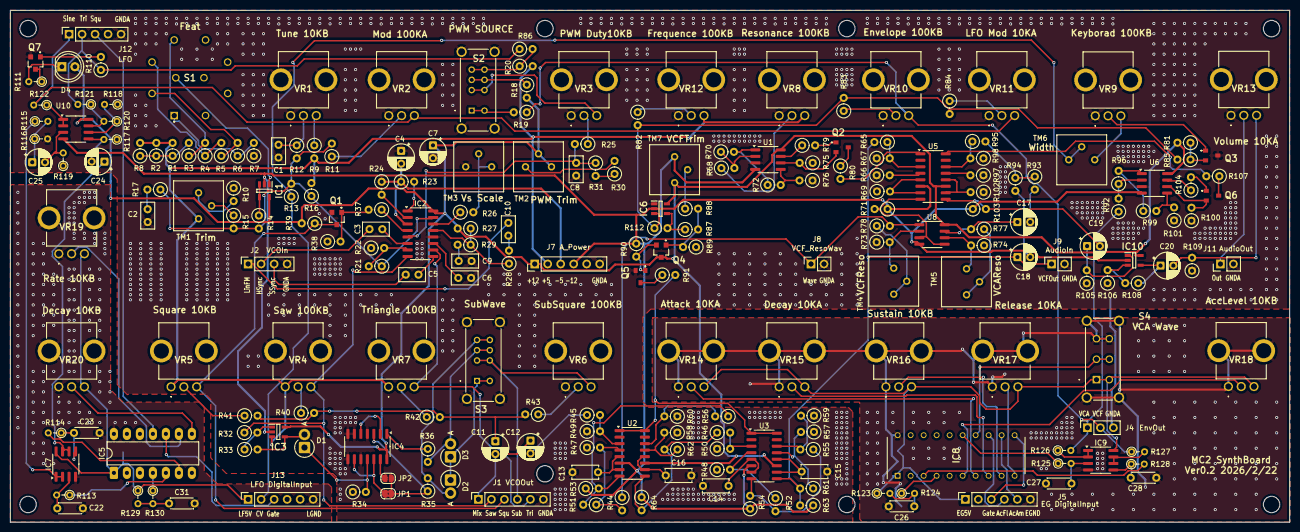
[picture p39: board SynthBoard_Rotary/VCOBoardRev2/VCOSeparate.kicad_pcb from above]

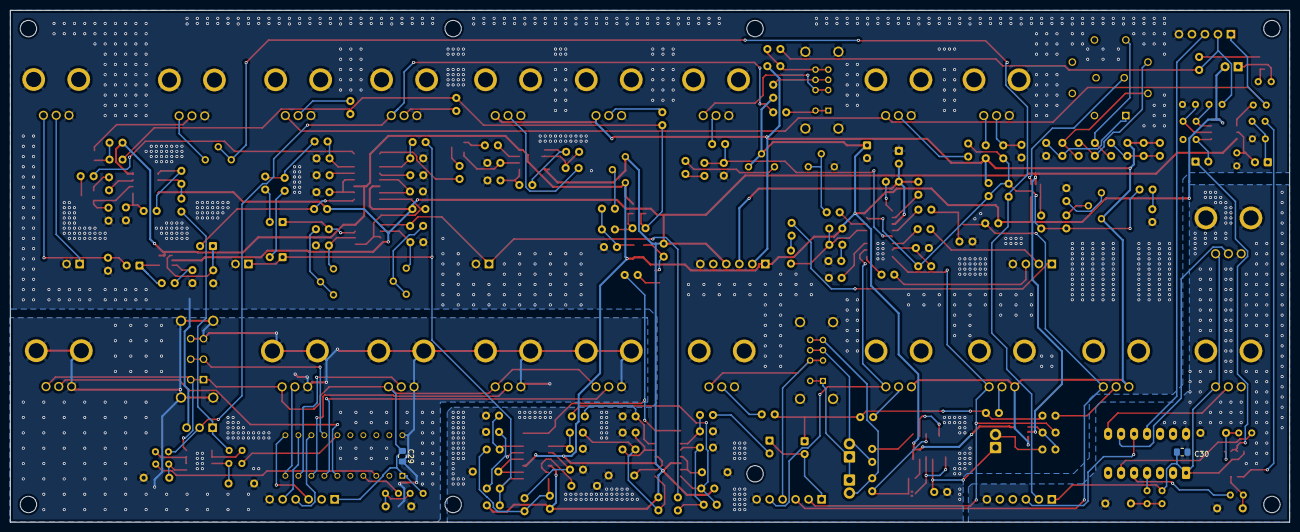
[picture p40: board SynthBoard_Rotary/VCOBoardRev2/VCOSeparate.kicad_pcb from below]

Board: 2 copper layers, 250.0 x 100.0 mm, 231 parts (2 on the bottom side), 180 nets.
