wakimizufu/MC2/SynthBoard_Rotary/VCOBoard/VCOBoard.kicad_pcb

## KiCad design SynthBoard_Rotary/VCOBoard/VCOBoard.kicad_pcb (2026-02-22, an earlier design)

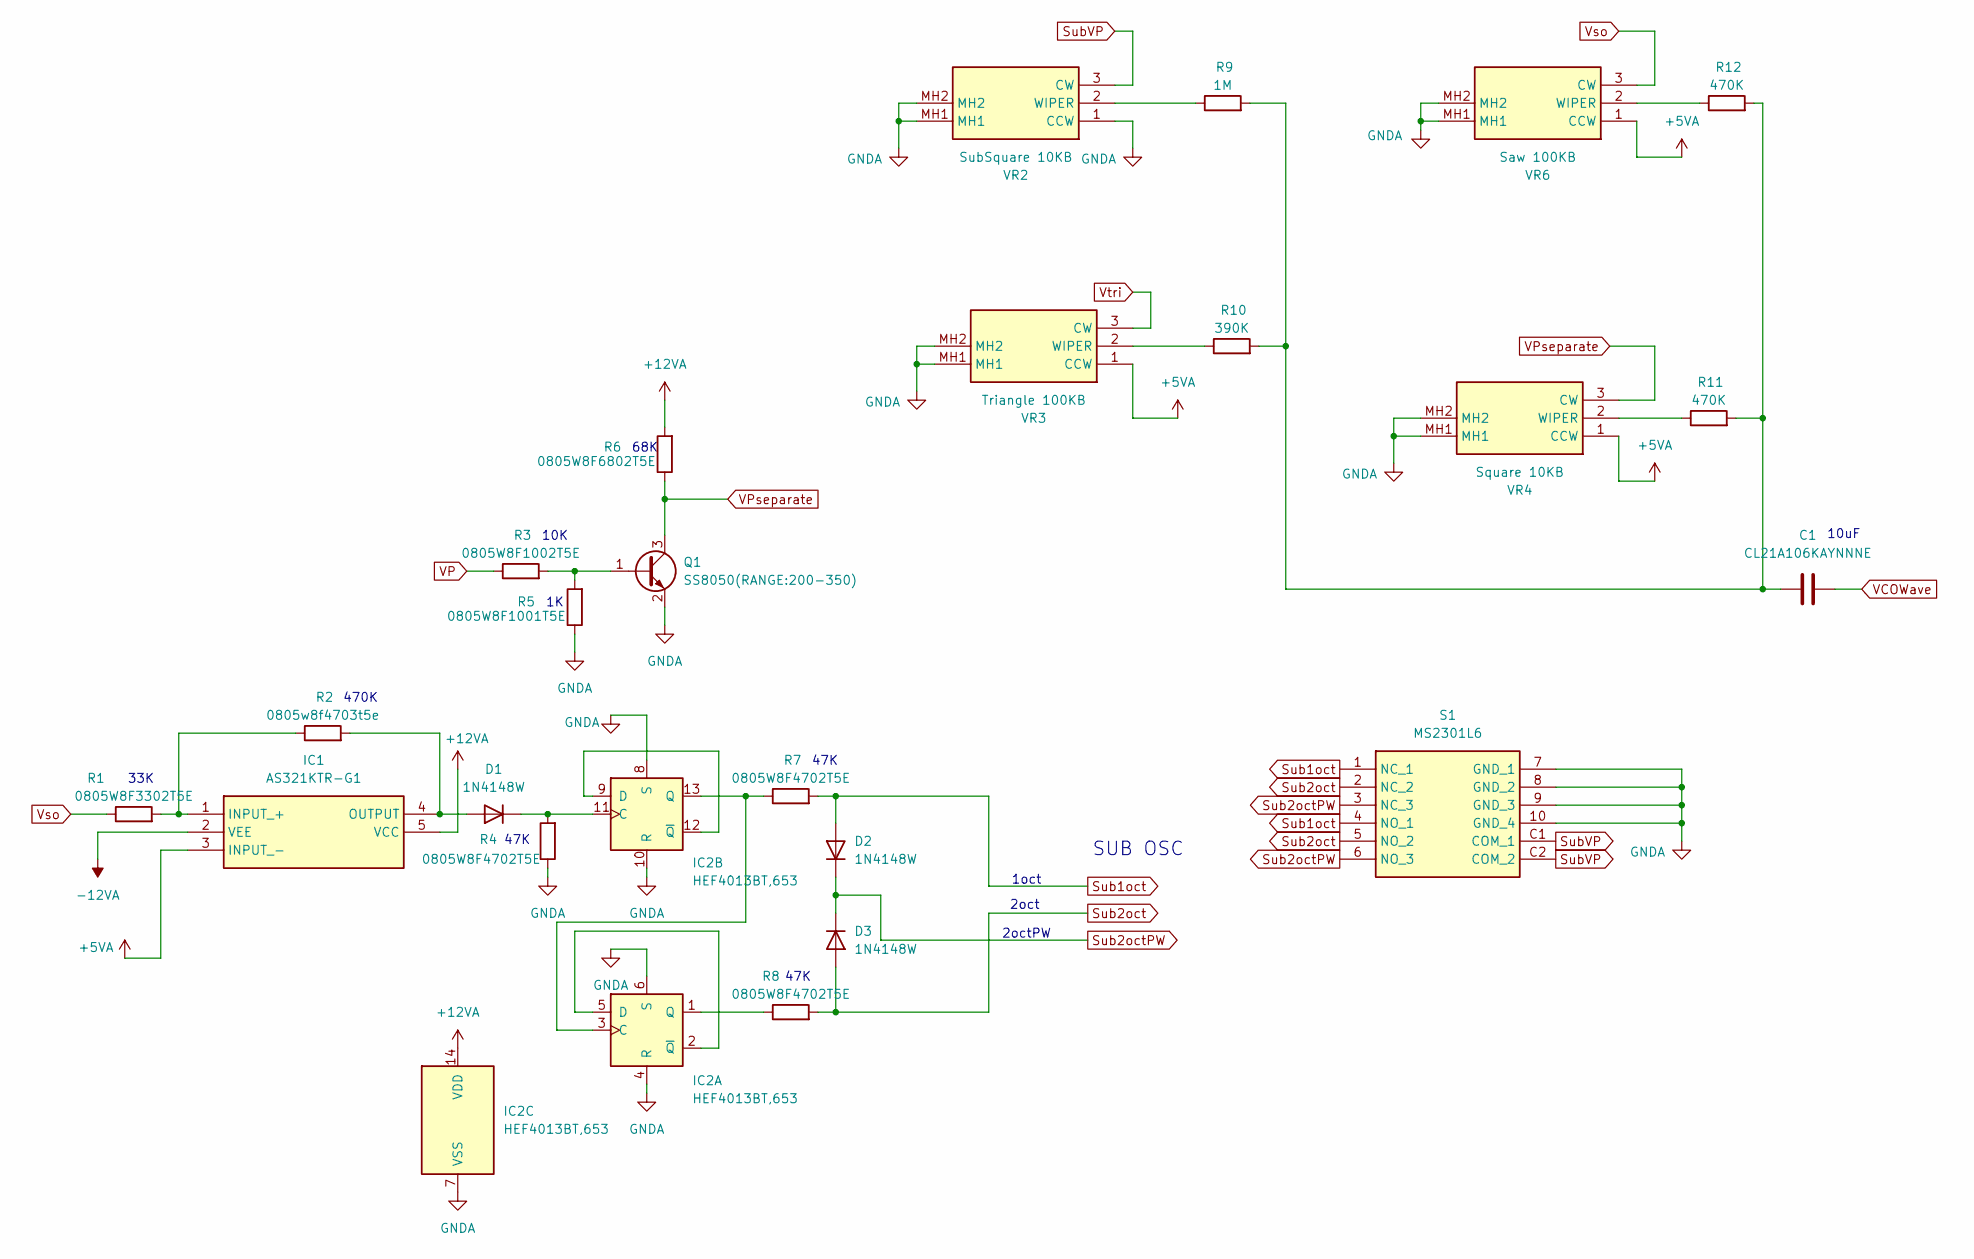
[picture p41: schematic VCO_waveform.kicad_sch]

Parts:
C1: CL21A106KAYNNNE; C_0805_2012Metric_Pad1.18x1.45mm_HandSolder
D1, D2, D3: 1N4148W; D_SOD-123
IC1: AS321KTR-G1; SOT95P282X145-5N; Manufacturer_Part_Number AS321KTR-E1; Mouser Part Number 621-AS321KTR-E1
IC2: HEF4013BT,653; SOIC-14_3.9x8.7mm_P1.27mm
Q1: SS8050(RANGE:200-350); SOT95P240X115-3N
R1: 0805W8F3302T5E; R_0805_2012Metric_Pad1.20x1.40mm_HandSolder
R2: 0805w8f4703t5e; R_0805_2012Metric_Pad1.20x1.40mm_HandSolder
R3: 0805W8F1002T5E; R_0805_2012Metric_Pad1.20x1.40mm_HandSolder
R4, R7, R8: 0805W8F4702T5E; R_0805_2012Metric_Pad1.20x1.40mm_HandSolder
R5: 0805W8F1001T5E; R_0805_2012Metric_Pad1.20x1.40mm_HandSolder
R6: 0805W8F6802T5E; R_0805_2012Metric_Pad1.20x1.40mm_HandSolder
R9: 1M; R_Axial_DIN0207_L6.3mm_D2.5mm_P7.62mm_Horizontal
R10: 390K; R_Axial_DIN0207_L6.3mm_D2.5mm_P7.62mm_Horizontal
R11, R12: 470K; R_Axial_DIN0207_L6.3mm_D2.5mm_P7.62mm_Horizontal
S1: MS2301L6; Manufacturer_Part_Number MS2301L6
VR2: SubSquare 10KB; RK09D117000B; Manufacturer_Part_Number RK09D117000B; Mouser Part Number 688-RK09D117000B
VR3: Triangle 100KB; RK09D117000B; Manufacturer_Part_Number RK09D117000B; Mouser Part Number 688-RK09D117000B
VR4: Square 10KB; RK09D117000B; Manufacturer_Part_Number RK09D117000B; Mouser Part Number 688-RK09D117000B
VR6: Saw 100KB; RK09D117000B; Manufacturer_Part_Number RK09D117000B; Mouser Part Number 688-RK09D117000B

Connections:
+5VA: IC1.3 (INPUT_-), VR3.1 (CCW), VR4.1 (CCW), VR6.1 (CCW); also elsewhere on the board
+12VA: IC1.5 (VCC), IC2.14 (VDD), R6.2; also elsewhere on the board
-12VA: IC1.2 (VEE); also elsewhere on the board
GNDA: IC2.4 (R), IC2.6 (S), IC2.7 (VSS), IC2.8 (S), IC2.10 (R), Q1.2 (E), R4.1, R5.1, S1.7 (GND_1), S1.8 (GND_2), S1.9 (GND_3), S1.10 (GND_4), VR2.1 (CCW), VR2.MH1, VR2.MH2, VR3.MH1, VR3.MH2, VR4.MH1, VR4.MH2, VR6.MH1, VR6.MH2; also elsewhere on the board
unnamed: C1.1, R9.2, R10.2, R11.2, R12.2
unnamed: D1.2 (A), IC1.4 (OUTPUT), R2.2
unnamed: D1.1 (K), IC2.11 (C), R4.2
unnamed: IC1.1 (INPUT_+), R1.2, R2.1
unnamed: IC2.3 (C), IC2.13 (Q), R7.1
unnamed: IC2.2 (~Q), IC2.5 (D)
unnamed: IC2.1 (Q), R8.1
unnamed: IC2.9 (D), IC2.12 (~Q)
unnamed: Q1.1 (B), R3.2, R5.2
unnamed: R9.1, VR2.2 (WIPER)
unnamed: R10.1, VR3.2 (WIPER)
unnamed: R11.1, VR4.2 (WIPER)
unnamed: R12.1, VR6.2 (WIPER)
Sub1oct: D2.2 (A), R7.2, S1.1 (NC_1), S1.4 (NO_1)
Sub2oct: D3.2 (A), R8.2, S1.2 (NC_2), S1.5 (NO_2)
Sub2octPW: D2.1 (K), D3.1 (K), S1.3 (NC_3), S1.6 (NO_3)
SubVP: S1.C1 (COM_1), S1.C2 (COM_2), VR2.3 (CW); also elsewhere on the board
VCOWave: C1.2; also elsewhere on the board
VP: R3.1; also elsewhere on the board
VPseparate: Q1.3 (C), R6.1, VR4.3 (CW); also elsewhere on the board
Vso: R1.1, VR6.3 (CW); also elsewhere on the board
Vtri: VR3.3 (CW); also elsewhere on the board

Notes on the sheet:
47K
1oct
33K
SUB OSC
10K
2octPW
2oct
10uF
470K
68K

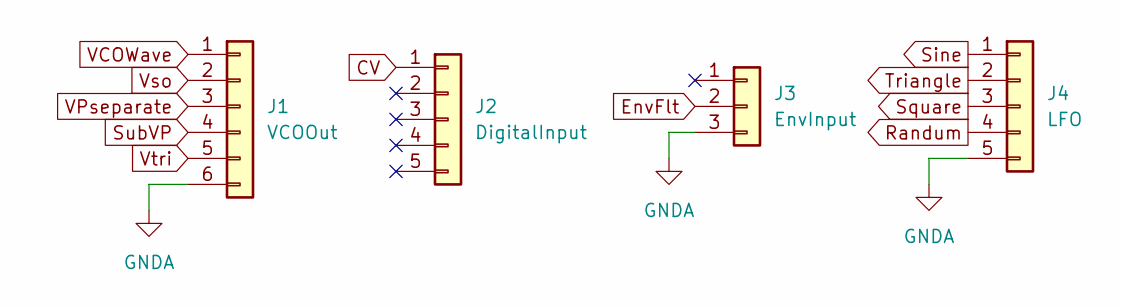
[picture p42: schematic Connect.kicad_sch]

Parts:
J1: VCOOut; PinSocket_1x06_P2.54mm_Vertical
J2: DigitalInput; PinHeader_1x05_P2.54mm_Vertical
J3: EnvInput; PinSocket_1x03_P2.54mm_Vertical
J4: LFO; PinSocket_1x05_P2.54mm_Vertical

Connections:
CV: J2.1; also elsewhere on the board
EnvFlt: J3.2; also elsewhere on the board
GNDA: J1.6, J3.3, J4.5; also elsewhere on the board
Randum: J4.4
Sine: J4.1; also elsewhere on the board
Square: J4.3
SubVP: J1.4; also elsewhere on the board
Triangle: J4.2; also elsewhere on the board
VCOWave: J1.1; also elsewhere on the board
VPseparate: J1.3; also elsewhere on the board
Vso: J1.2; also elsewhere on the board
Vtri: J1.5; also elsewhere on the board
