wakimizufu/MC2/SynthBoard_Rotary/VCOBoard/VCOBoard.kicad_pcb

## KiCad design SynthBoard_Rotary/VCOBoard/VCOBoard.kicad_pcb (continued)

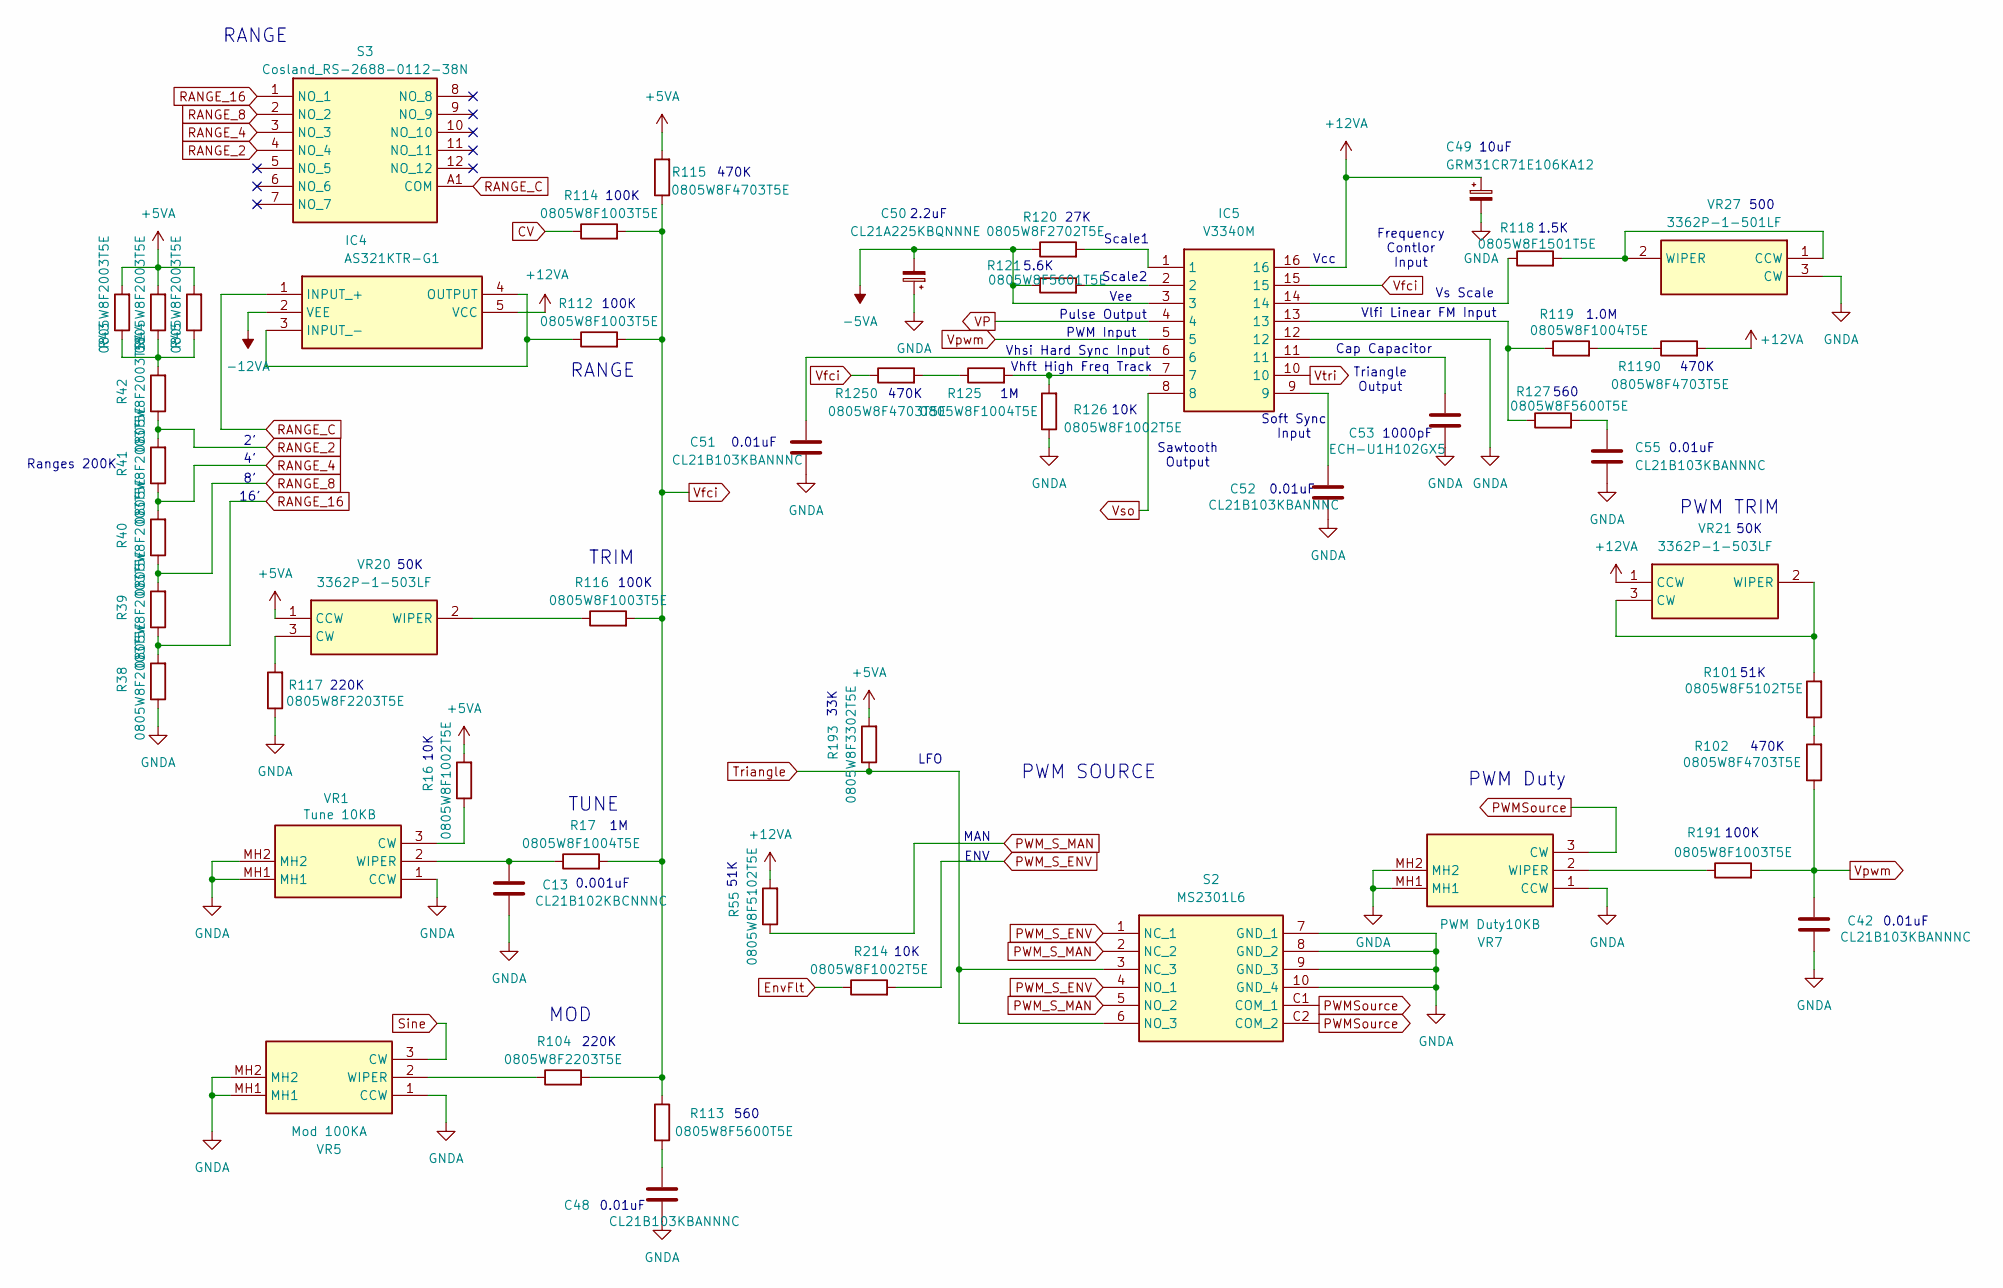
[picture p43: schematic VCO_3340.kicad_sch]

Parts:
C13: CL21B102KBCNNNC; C_0805_2012Metric_Pad1.18x1.45mm_HandSolder
C42, C48, C51, C52, C55: CL21B103KBANNNC; C_0805_2012Metric_Pad1.18x1.45mm_HandSolder
C49: GRM31CR71E106KA12; C_1206_3216Metric_Pad1.33x1.80mm_HandSolder
C50: CL21A225KBQNNNE; C_0805_2012Metric_Pad1.18x1.45mm_HandSolder
C53: ECH-U1H102GX5; C_0805_2012Metric_Pad1.18x1.45mm_HandSolder
IC4: AS321KTR-G1; SOT95P282X145-5N; Manufacturer_Part_Number AS321KTR-E1; Mouser Part Number 621-AS321KTR-E1
IC5: V3340M; SOP-16_3.9x9.9mm_P1.27mm; Manufacturer_Part_Number V3340M
R16, R126, R214: 0805W8F1002T5E; R_0805_2012Metric_Pad1.20x1.40mm_HandSolder
R17, R119, R125: 0805W8F1004T5E; R_0805_2012Metric_Pad1.20x1.40mm_HandSolder
R38, R39, R40, R41, R42, R43, R44, R45: 0805W8F2003T5E; R_0805_2012Metric_Pad1.20x1.40mm_HandSolder
R55, R101: 0805W8F5102T5E; R_0805_2012Metric_Pad1.20x1.40mm_HandSolder
R102, R115, R1190, R1250: 0805W8F4703T5E; R_0805_2012Metric_Pad1.20x1.40mm_HandSolder
R104, R117: 0805W8F2203T5E; R_0805_2012Metric_Pad1.20x1.40mm_HandSolder
R112, R114, R116, R191: 0805W8F1003T5E; R_0805_2012Metric_Pad1.20x1.40mm_HandSolder
R113, R127: 0805W8F5600T5E; R_0805_2012Metric_Pad1.20x1.40mm_HandSolder
R118: 0805W8F1501T5E; R_0805_2012Metric_Pad1.20x1.40mm_HandSolder
R120: 0805W8F2702T5E; R_0805_2012Metric_Pad1.20x1.40mm_HandSolder
R121: 0805W8F5601T5E; R_0805_2012Metric_Pad1.20x1.40mm_HandSolder
R193: 0805W8F3302T5E; R_0805_2012Metric_Pad1.20x1.40mm_HandSolder
S2: MS2301L6; Manufacturer_Part_Number MS2301L6
S3: Cosland_RS-2688-0112-38N; Manufacturer_Part_Number CK1054; Mouser Part Number 10WA344
VR1: Tune 10KB; RK09D117000B; Manufacturer_Part_Number RK09D117000B; Mouser Part Number 688-RK09D117000B
VR5: Mod 100KA; RK09D117000B; Manufacturer_Part_Number RK09D117000B; Mouser Part Number 688-RK09D117000B
VR7: PWM Duty10KB; RK09D117000B; Manufacturer_Part_Number RK09D117000B; Mouser Part Number 688-RK09D117000B
VR20, VR21: 3362P-1-503LF; 3362P_1; Manufacturer_Part_Number 3362P-1-103LF; Mouser Part Number 652-3362P-1-103LF
VR27: 3362P-1-501LF; 3362P_1; Manufacturer_Part_Number 3362P-1-103LF; Mouser Part Number 652-3362P-1-103LF

Connections:
+5VA: R16.2, R43.2, R44.2, R45.2, R115.2, R193.2, VR20.1 (CCW); also elsewhere on the board
+12VA: C49.1, IC4.5 (VCC), IC5.16, R55.2, R1190.2, VR21.1 (CCW); also elsewhere on the board
-5VA: C50.2, IC5.3, R120.1, R121.1; also elsewhere on the board
-12VA: IC4.2 (VEE); also elsewhere on the board
CV: R114.1; also elsewhere on the board
EnvFlt: R214.1; also elsewhere on the board
GNDA: C13.1, C42.1, C48.1, C49.2, C50.1, C51.1, C52.1, C53.1, C55.1, IC5.12, R38.1, R117.1, R126.1, S2.7 (GND_1), S2.8 (GND_2), S2.9 (GND_3), S2.10 (GND_4), VR1.1 (CCW), VR1.MH1, VR1.MH2, VR5.1 (CCW), VR5.MH1, VR5.MH2, VR7.1 (CCW), VR7.MH1, VR7.MH2, VR27.3 (CW); also elsewhere on the board
unnamed: C48.2, R113.2
unnamed: C51.2, IC5.6
unnamed: C52.2, IC5.9
unnamed: C53.2, IC5.11
unnamed: C55.2, R127.2
unnamed: IC4.3 (INPUT_-), IC4.4 (OUTPUT), R112.1
unnamed: IC5.1, R120.2
unnamed: IC5.2, R121.2
unnamed: IC5.7, R125.2, R126.2
unnamed: IC5.13, R119.1, R127.1
unnamed: IC5.14, R118.1
unnamed: R42.2, R43.1, R44.1, R45.1
unnamed: R101.1, R102.2
unnamed: R119.2, R1190.1
unnamed: R125.1, R1250.2
unnamed: R16.1, VR1.3 (CW)
unnamed: C13.2, R17.1, VR1.2 (WIPER)
unnamed: R104.1, VR5.2 (WIPER)
unnamed: R191.1, VR7.2 (WIPER)
unnamed: R117.2, VR20.3 (CW)
unnamed: R116.1, VR20.2 (WIPER)
unnamed: R101.2, VR21.2 (WIPER), VR21.3 (CW)
unnamed: R118.2, VR27.1 (CCW), VR27.2 (WIPER)
PWMSource: S2.C1 (COM_1), S2.C2 (COM_2), VR7.3 (CW)
PWM_S_ENV: R214.2, S2.1 (NC_1), S2.4 (NO_1)
PWM_S_MAN: R55.1, S2.2 (NC_2), S2.5 (NO_2)
RANGE_2: R41.2, R42.1, S3.4 (NO_4)
RANGE_4: R40.2, R41.1, S3.3 (NO_3)
RANGE_8: R39.2, R40.1, S3.2 (NO_2)
RANGE_16: R38.2, R39.1, S3.1 (NO_1)
RANGE_C: IC4.1 (INPUT_+), S3.A1 (COM)
Sine: VR5.3 (CW); also elsewhere on the board
Triangle: R193.1, S2.3 (NC_3), S2.6 (NO_3); also elsewhere on the board
VP: IC5.4; also elsewhere on the board
Vfci: IC5.15, R17.2, R104.2, R112.2, R113.1, R114.2, R115.1, R116.2, R1250.1
Vpwm: C42.2, IC5.5, R102.1, R191.2
Vso: IC5.8; also elsewhere on the board
Vtri: IC5.10; also elsewhere on the board

Notes on the sheet:
LFO
Scale2
Vcc
TRIM
0.01uF
560
Frequency Contlor Input
220K
10K
33K
RANGE
Pulse Output
10uF
27K
100K
PWM SOURCE
500
Vhsi Hard Sync Input
470K
Triangle Output
0.001uF
TUNE
PWM Input
51K
PWM Duty
1.5K
Sawtooth Output
PWM TRIM
1000pF
Vlfi Linear FM Input
MAN
16'
Vee
Soft Sync Input
Scale1
Ranges 200K
2.2uF
Vs Scale
ENV
50K
1.0M
Cap Capacitor
MOD
Vhft High Freq Track
5.6K

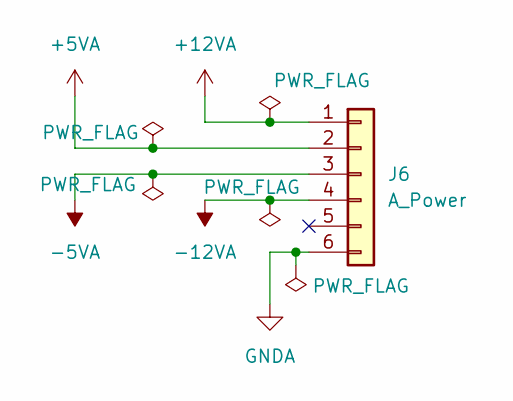
[picture p44: schematic Power.kicad_sch]

Parts:
J6: A_Power; PinHeader_1x06_P2.54mm_Vertical

Connections:
+5VA: J6.2; also elsewhere on the board
+12VA: J6.1; also elsewhere on the board
-5VA: J6.3; also elsewhere on the board
-12VA: J6.4; also elsewhere on the board
GNDA: J6.6; also elsewhere on the board

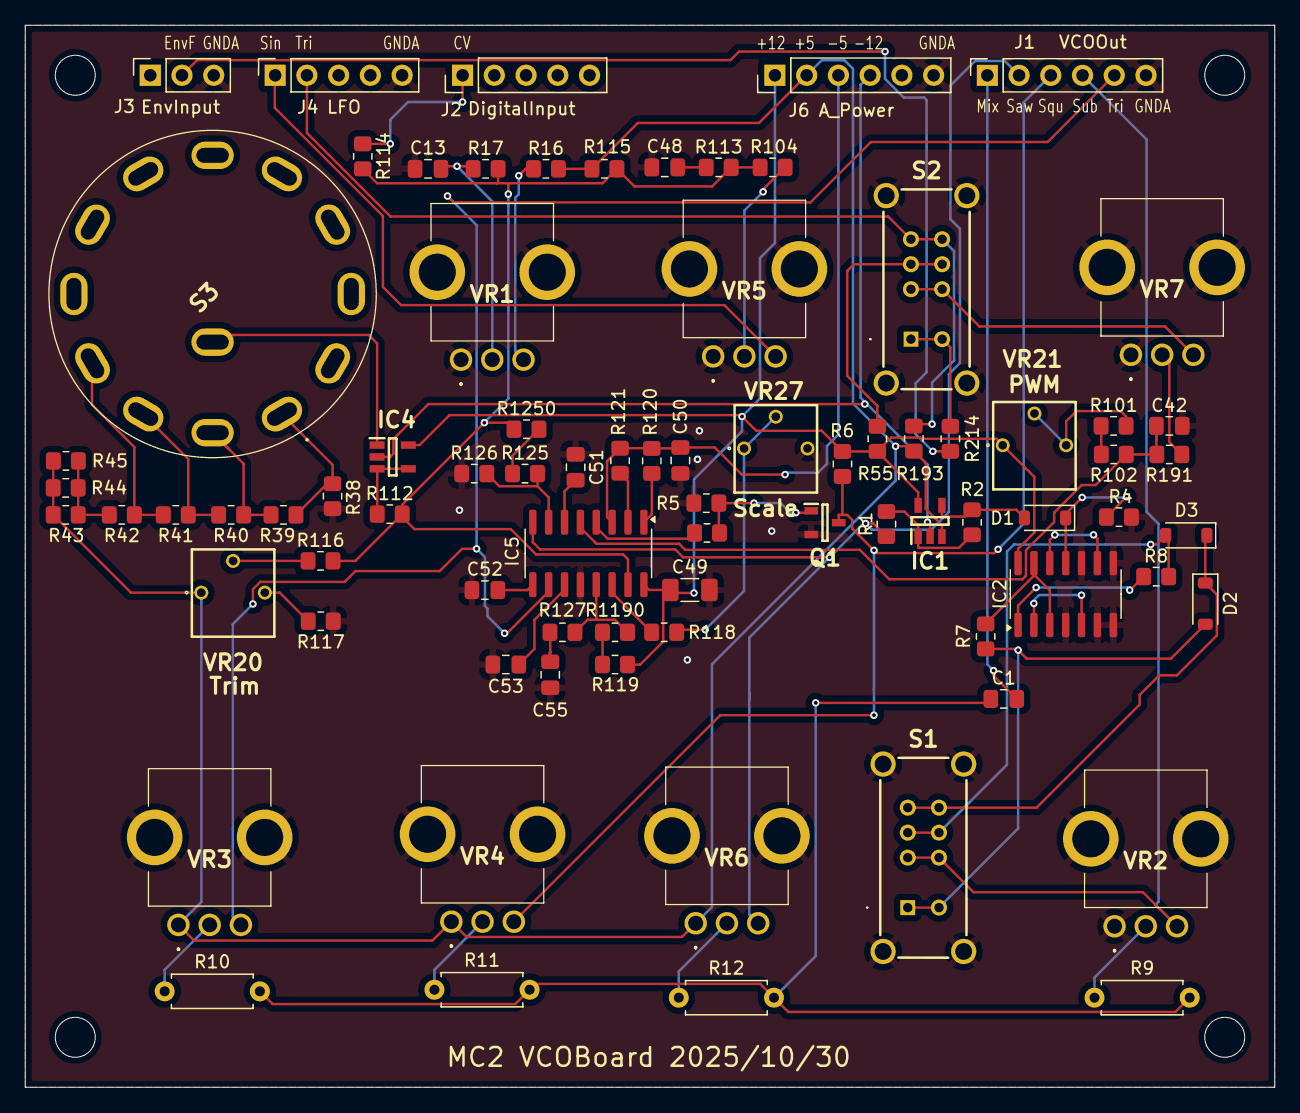
[picture p45: board VCOBoard.kicad_pcb from above]

Board: 2 copper layers, 100.0 x 85.0 mm, 80 parts (0 on the bottom side), 64 nets.
