wakimizufu/MC2/SynthBoard_Right/SynthBoard.kicad_pcb

## KiCad design SynthBoard_Right/SynthBoard.kicad_pcb (2026-02-22)

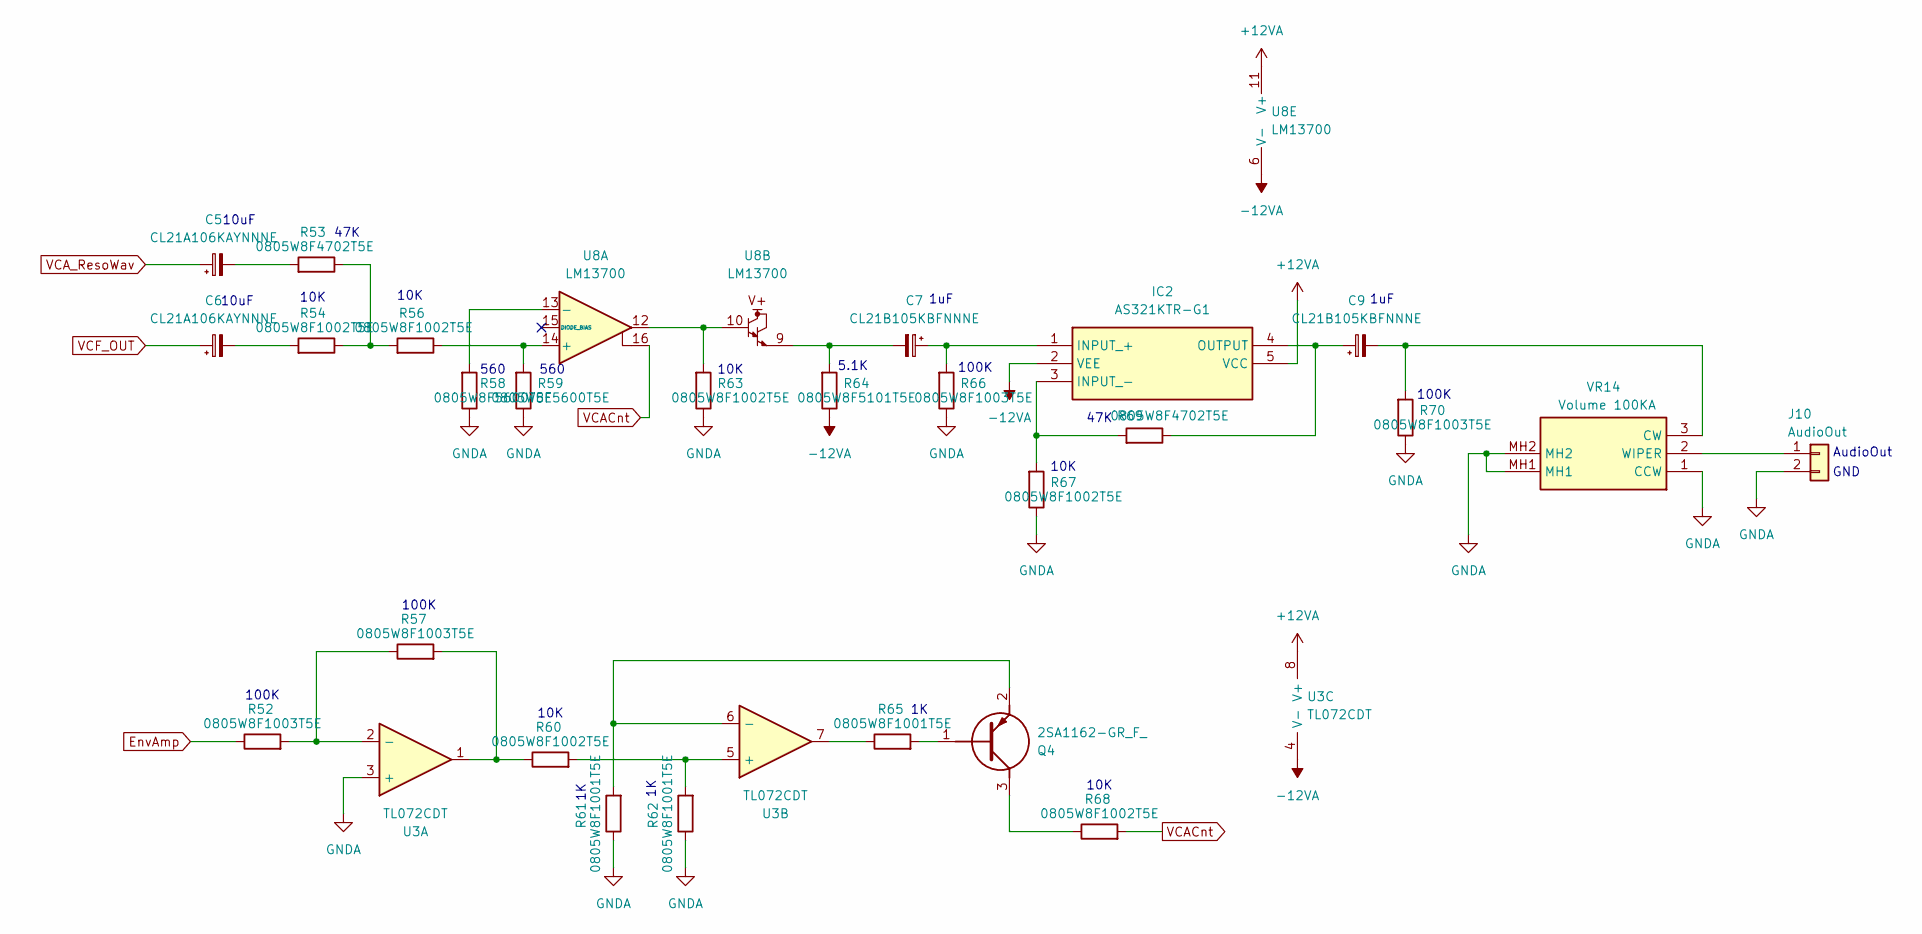
[picture p46: schematic VCA.kicad_sch]

Parts:
C5, C6: CL21A106KAYNNNE; C_0805_2012Metric_Pad1.18x1.45mm_HandSolder
C7, C9: CL21B105KBFNNNE; C_0805_2012Metric_Pad1.18x1.45mm_HandSolder
IC2: AS321KTR-G1; SOT95P282X145-5N; Manufacturer_Part_Number AS321KTR-E1; Mouser Part Number 621-AS321KTR-E1
J10: AudioOut; PinHeader_1x02_P2.54mm_Vertical
Q4: 2SA1162-GR_F_; 1SS294LFT; Manufacturer_Part_Number 2SA1162-GR(F)
R52, R57, R66, R70: 0805W8F1003T5E; R_0805_2012Metric_Pad1.20x1.40mm_HandSolder
R53, R69: 0805W8F4702T5E; R_0805_2012Metric_Pad1.20x1.40mm_HandSolder
R54, R56, R60, R63, R67, R68: 0805W8F1002T5E; R_0805_2012Metric_Pad1.20x1.40mm_HandSolder
R58, R59: 0805W8F5600T5E; R_0805_2012Metric_Pad1.20x1.40mm_HandSolder
R61, R62, R65: 0805W8F1001T5E; R_0805_2012Metric_Pad1.20x1.40mm_HandSolder
R64: 0805W8F5101T5E; R_0805_2012Metric_Pad1.20x1.40mm_HandSolder
U3: TL072CDT; SOIC-8_3.9x4.9mm_P1.27mm
U8: LM13700; SOIC-16_3.9x9.9mm_P1.27mm
VR14: Volume 100KA; RK09D117000B; Manufacturer_Part_Number RK09D117000B; Mouser Part Number 688-RK09D117000B

Connections:
+12VA: IC2.5 (VCC), U3.8 (V+), U8.11 (V+); also elsewhere on the board
-12VA: IC2.2 (VEE), R64.1, U3.4 (V-), U8.6 (V-); also elsewhere on the board
EnvAmp: R52.1; also elsewhere on the board
GNDA: J10.2, R58.1, R59.1, R61.1, R62.1, R63.1, R66.1, R67.1, R70.1, U3.3 (+), VR14.1 (CCW), VR14.MH1, VR14.MH2; also elsewhere on the board
unnamed: C5.2, R53.2
unnamed: C6.2, R54.2
unnamed: C7.2, R64.2, U8.9
unnamed: C7.1, IC2.1 (INPUT_+), R66.2
unnamed: IC2.3 (INPUT_-), R67.2, R69.2
unnamed: C9.1, IC2.4 (OUTPUT), R69.1
unnamed: J10.1, VR14.2 (WIPER)
unnamed: Q4.1 (B), R65.2
unnamed: Q4.3 (C), R68.1
unnamed: Q4.2 (E), R61.2, U3.6 (-)
unnamed: R53.1, R54.1, R56.2
unnamed: R57.2, R60.1, U3.1
unnamed: R63.2, U8.10, U8.12
unnamed: R65.1, U3.7
unnamed: R52.2, R57.1, U3.2 (-)
unnamed: R60.2, R62.2, U3.5 (+)
unnamed: R56.1, R59.2, U8.14 (+)
unnamed: R58.2, U8.13 (-)
unnamed: C9.2, R70.2, VR14.3 (CW)
VCACnt: R68.2, U8.16
VCA_ResoWav: C5.1; also elsewhere on the board
VCF_OUT: C6.1; also elsewhere on the board

Notes on the sheet:
10K
100K
47K
1uF
10uF
5.1K
560
GND
AudioOut

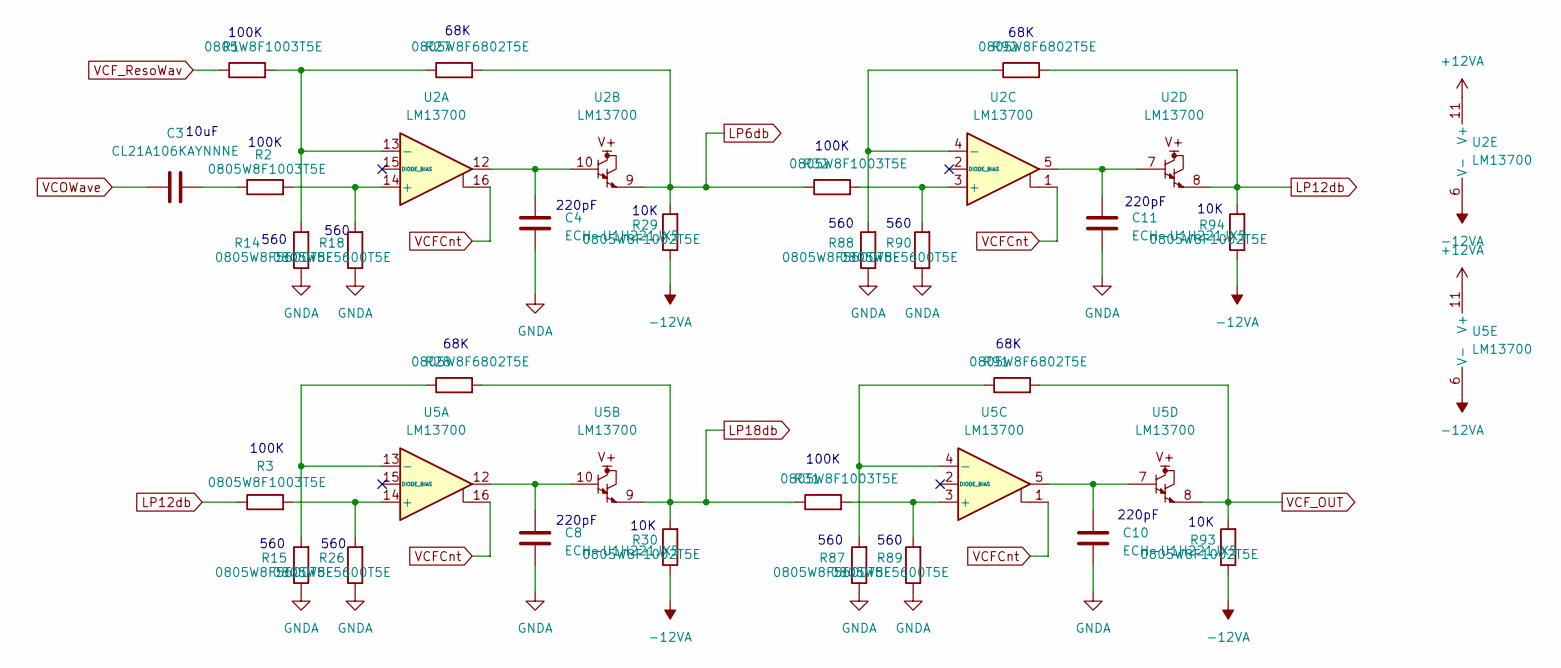
[picture p47: schematic VCF.kicad_sch]

Parts:
C3: CL21A106KAYNNNE; C_0805_2012Metric_Pad1.18x1.45mm_HandSolder
C4, C8, C10, C11: ECH-U1H221JX5; C_0805_2012Metric_Pad1.18x1.45mm_HandSolder
R1, R2, R3, R31, R32: 0805W8F1003T5E; R_0805_2012Metric_Pad1.20x1.40mm_HandSolder
R14, R15, R18, R26, R87, R88, R89, R90: 0805W8F5600T5E; R_0805_2012Metric_Pad1.20x1.40mm_HandSolder
R27, R28, R91, R92: 0805W8F6802T5E; R_0805_2012Metric_Pad1.20x1.40mm_HandSolder
R29, R30, R93, R94: 0805W8F1002T5E; R_0805_2012Metric_Pad1.20x1.40mm_HandSolder
U2, U5: LM13700; SOIC-16_3.9x9.9mm_P1.27mm

Connections:
+12VA: U2.11 (V+), U5.11 (V+); also elsewhere on the board
-12VA: R29.1, R30.1, R93.1, R94.1, U2.6 (V-), U5.6 (V-); also elsewhere on the board
GNDA: C4.2, C8.2, C10.2, C11.2, R14.1, R15.1, R18.1, R26.1, R87.1, R88.1, R89.1, R90.1; also elsewhere on the board
LP6db: R27.2, R29.2, R32.1, U2.9
LP12db: R3.1, R92.2, R94.2, U2.8
LP18db: R28.2, R30.2, R31.1, U5.9
unnamed: C3.2, R2.1
unnamed: C4.1, U2.10, U2.12
unnamed: C8.1, U5.10, U5.12
unnamed: C10.1, U5.5, U5.7
unnamed: C11.1, U2.5, U2.7
unnamed: R2.2, R18.2, U2.14 (+)
unnamed: R1.2, R14.2, R27.1, U2.13 (-)
unnamed: R32.2, R90.2, U2.3 (+)
unnamed: R88.2, R92.1, U2.4 (-)
unnamed: R3.2, R26.2, U5.14 (+)
unnamed: R15.2, R28.1, U5.13 (-)
unnamed: R31.2, R89.2, U5.3 (+)
unnamed: R87.2, R91.1, U5.4 (-)
VCFCnt: U2.1, U2.16, U5.1, U5.16; also elsewhere on the board
VCF_OUT: R91.2, R93.2, U5.8; also elsewhere on the board
VCF_ResoWav: R1.1; also elsewhere on the board
VCOWave: C3.1; also elsewhere on the board

Notes on the sheet:
560
10K
220pF
68K
100K
10uF

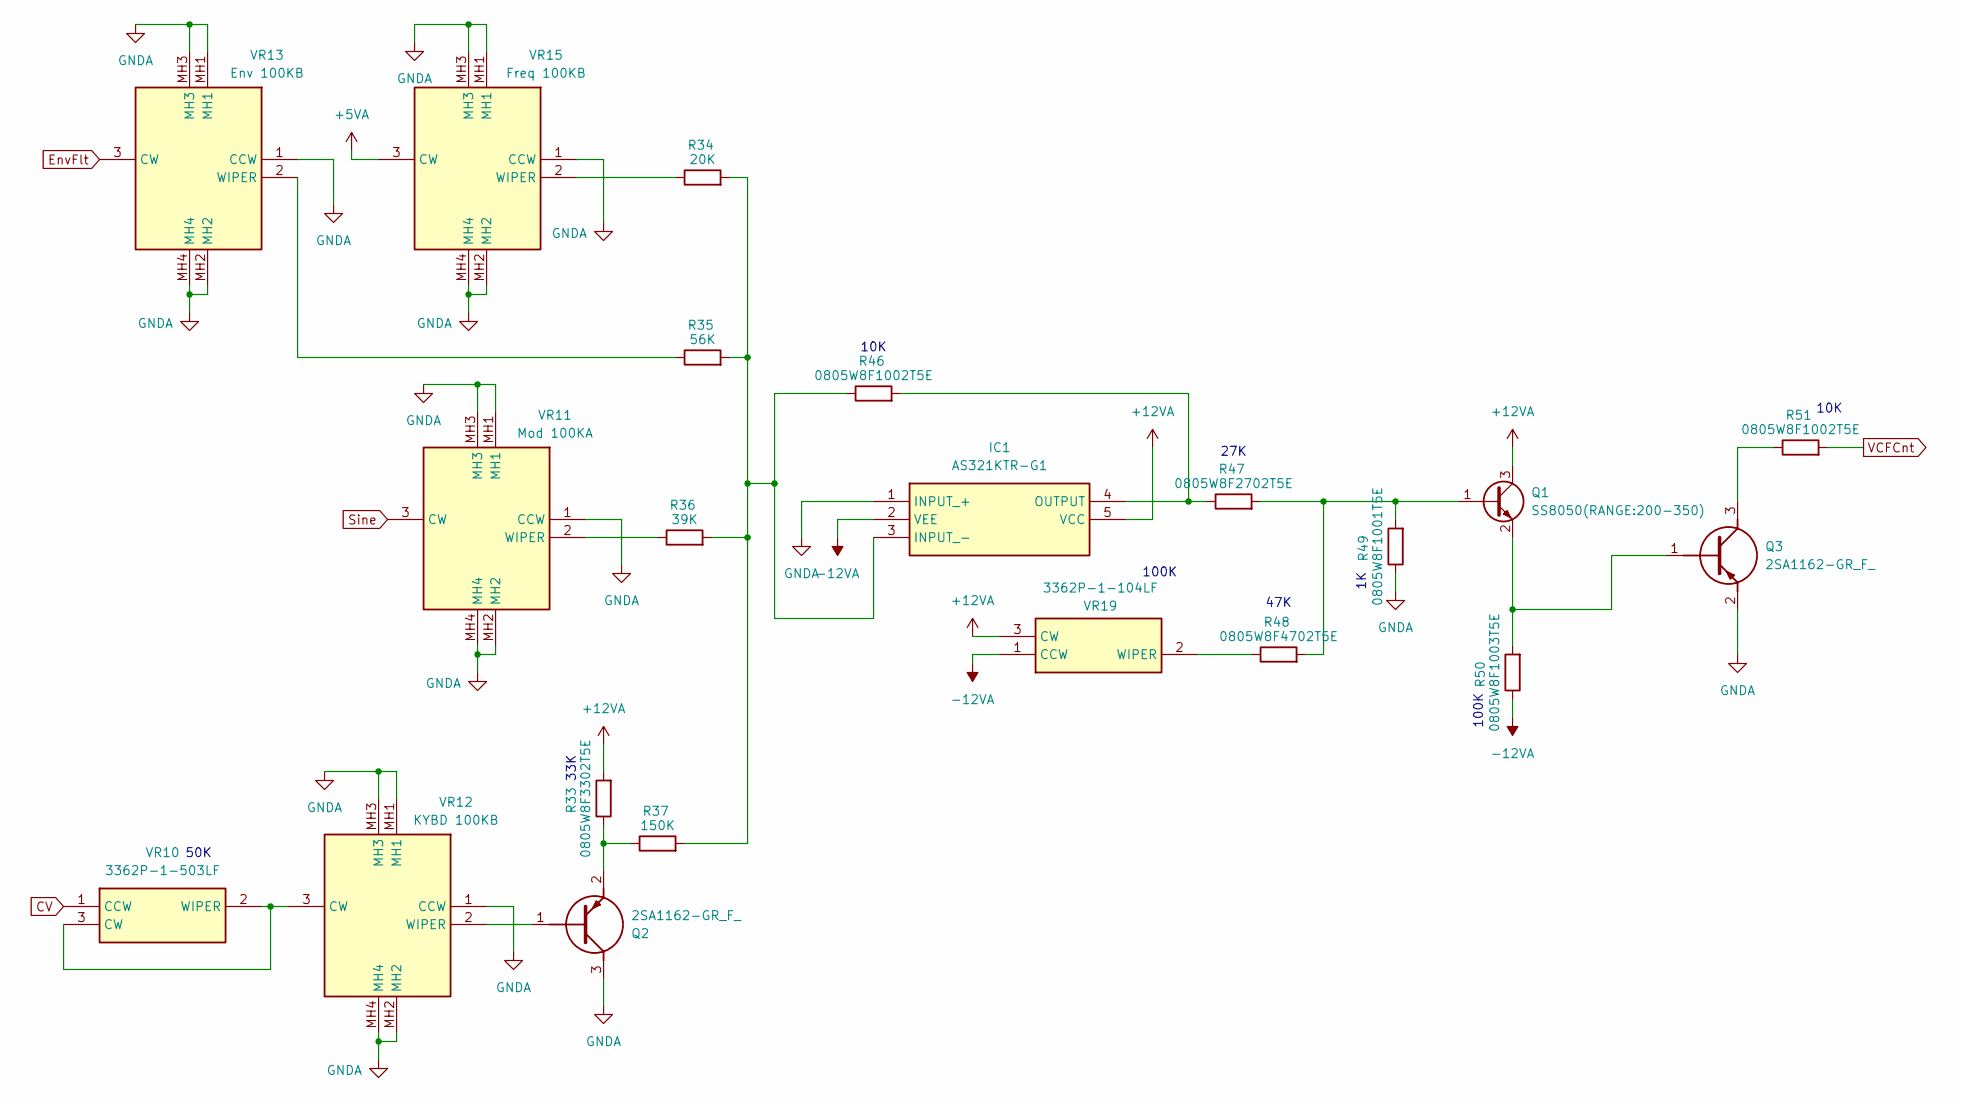
[picture p48: schematic VCF_CVMix.kicad_sch]

Parts:
IC1: AS321KTR-G1; SOT95P282X145-5N; Manufacturer_Part_Number AS321KTR-E1; Mouser Part Number 621-AS321KTR-E1
Q1: SS8050(RANGE:200-350); SOT-23
Q2, Q3: 2SA1162-GR_F_; 1SS294LFT; Manufacturer_Part_Number 2SA1162-GR(F)
R33: 0805W8F3302T5E; R_0805_2012Metric_Pad1.20x1.40mm_HandSolder
R34: 20K; R_Axial_DIN0204_L3.6mm_D1.6mm_P7.62mm_Horizontal
R35: 56K; R_Axial_DIN0204_L3.6mm_D1.6mm_P7.62mm_Horizontal
R36: 39K; R_Axial_DIN0204_L3.6mm_D1.6mm_P7.62mm_Horizontal
R37: 150K; R_Axial_DIN0204_L3.6mm_D1.6mm_P7.62mm_Horizontal
R46, R51: 0805W8F1002T5E; R_0805_2012Metric_Pad1.20x1.40mm_HandSolder
R47: 0805W8F2702T5E; R_0805_2012Metric_Pad1.20x1.40mm_HandSolder
R48: 0805W8F4702T5E; R_0805_2012Metric_Pad1.20x1.40mm_HandSolder
R49: 0805W8F1001T5E; R_0805_2012Metric_Pad1.20x1.40mm_HandSolder
R50: 0805W8F1003T5E; R_0805_2012Metric_Pad1.20x1.40mm_HandSolder
VR10: 3362P-1-503LF; 3362P_1; Manufacturer_Part_Number 3362P-1-103LF; Mouser Part Number 652-3362P-1-103LF
VR11: Mod 100KA; PTA20432010CIB104; Manufacturer_Part_Number PTA2043-2010CIB104; Mouser Part Number 652-PTA2432010CIB104
VR12: KYBD 100KB; PTA20432010CIB104; Manufacturer_Part_Number PTA2043-2010CIB104; Mouser Part Number 652-PTA2432010CIB104
VR13: Env 100KB; PTA20432010CIB104; Manufacturer_Part_Number PTA2043-2010CIB104; Mouser Part Number 652-PTA2432010CIB104
VR15: Freq 100KB; PTA20432010CIB104; Manufacturer_Part_Number PTA2043-2010CIB104; Mouser Part Number 652-PTA2432010CIB104
VR19: 3362P-1-104LF; 3362P_1; Manufacturer_Part_Number 3362P-1-103LF; Mouser Part Number 652-3362P-1-103LF

Connections:
+5VA: VR15.3 (CW); also elsewhere on the board
+12VA: IC1.5 (VCC), Q1.3 (C), R33.2, VR19.3 (CW); also elsewhere on the board
-12VA: IC1.2 (VEE), R50.1, VR19.1 (CCW); also elsewhere on the board
CV: VR10.1 (CCW); also elsewhere on the board
EnvFlt: VR13.3 (CW); also elsewhere on the board
GNDA: IC1.1 (INPUT_+), Q2.3 (C), Q3.2 (E), R49.1, VR11.1 (CCW), VR11.MH1, VR11.MH2, VR11.MH3, VR11.MH4, VR12.1 (CCW), VR12.MH1, VR12.MH2, VR12.MH3, VR12.MH4, VR13.1 (CCW), VR13.MH1, VR13.MH2, VR13.MH3, VR13.MH4, VR15.1 (CCW), VR15.MH1, VR15.MH2, VR15.MH3, VR15.MH4; also elsewhere on the board
unnamed: IC1.3 (INPUT_-), R34.2, R35.2, R36.2, R37.2, R46.1
unnamed: IC1.4 (OUTPUT), R46.2, R47.1
unnamed: Q1.1 (B), R47.2, R48.2, R49.2
unnamed: Q1.2 (E), Q3.1 (B), R50.2
unnamed: Q2.1 (B), VR12.2 (WIPER)
unnamed: Q2.2 (E), R33.1, R37.1
unnamed: Q3.3 (C), R51.1
unnamed: VR10.2 (WIPER), VR10.3 (CW), VR12.3 (CW)
unnamed: R36.1, VR11.2 (WIPER)
unnamed: R35.1, VR13.2 (WIPER)
unnamed: R34.1, VR15.2 (WIPER)
unnamed: R48.1, VR19.2 (WIPER)
Sine: VR11.3 (CW); also elsewhere on the board
VCFCnt: R51.2; also elsewhere on the board

Notes on the sheet:
100K
47K
10K
27K
50K
33K

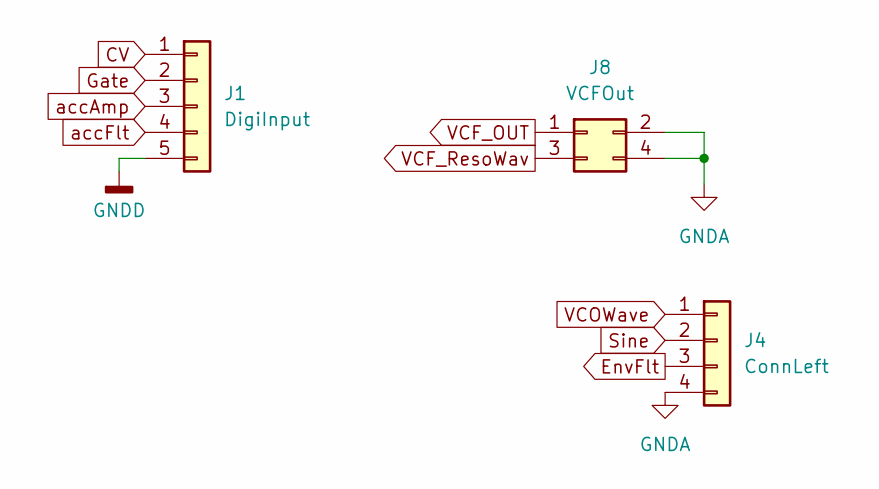
[picture p49: schematic Connect.kicad_sch]

Parts:
J1: DigiInput; PinSocket_1x05_P2.54mm_Vertical
J4: ConnLeft; PinSocket_1x04_P2.54mm_Vertical
J8: VCFOut; PinSocket_2x02_P2.54mm_Vertical

Connections:
CV: J1.1; also elsewhere on the board
EnvFlt: J4.3; also elsewhere on the board
GNDA: J4.4, J8.2, J8.4; also elsewhere on the board
GNDD: J1.5; also elsewhere on the board
Gate: J1.2; also elsewhere on the board
Sine: J4.2; also elsewhere on the board
VCF_OUT: J8.1; also elsewhere on the board
VCF_ResoWav: J8.3; also elsewhere on the board
VCOWave: J4.1; also elsewhere on the board
accAmp: J1.3; also elsewhere on the board
accFlt: J1.4; also elsewhere on the board

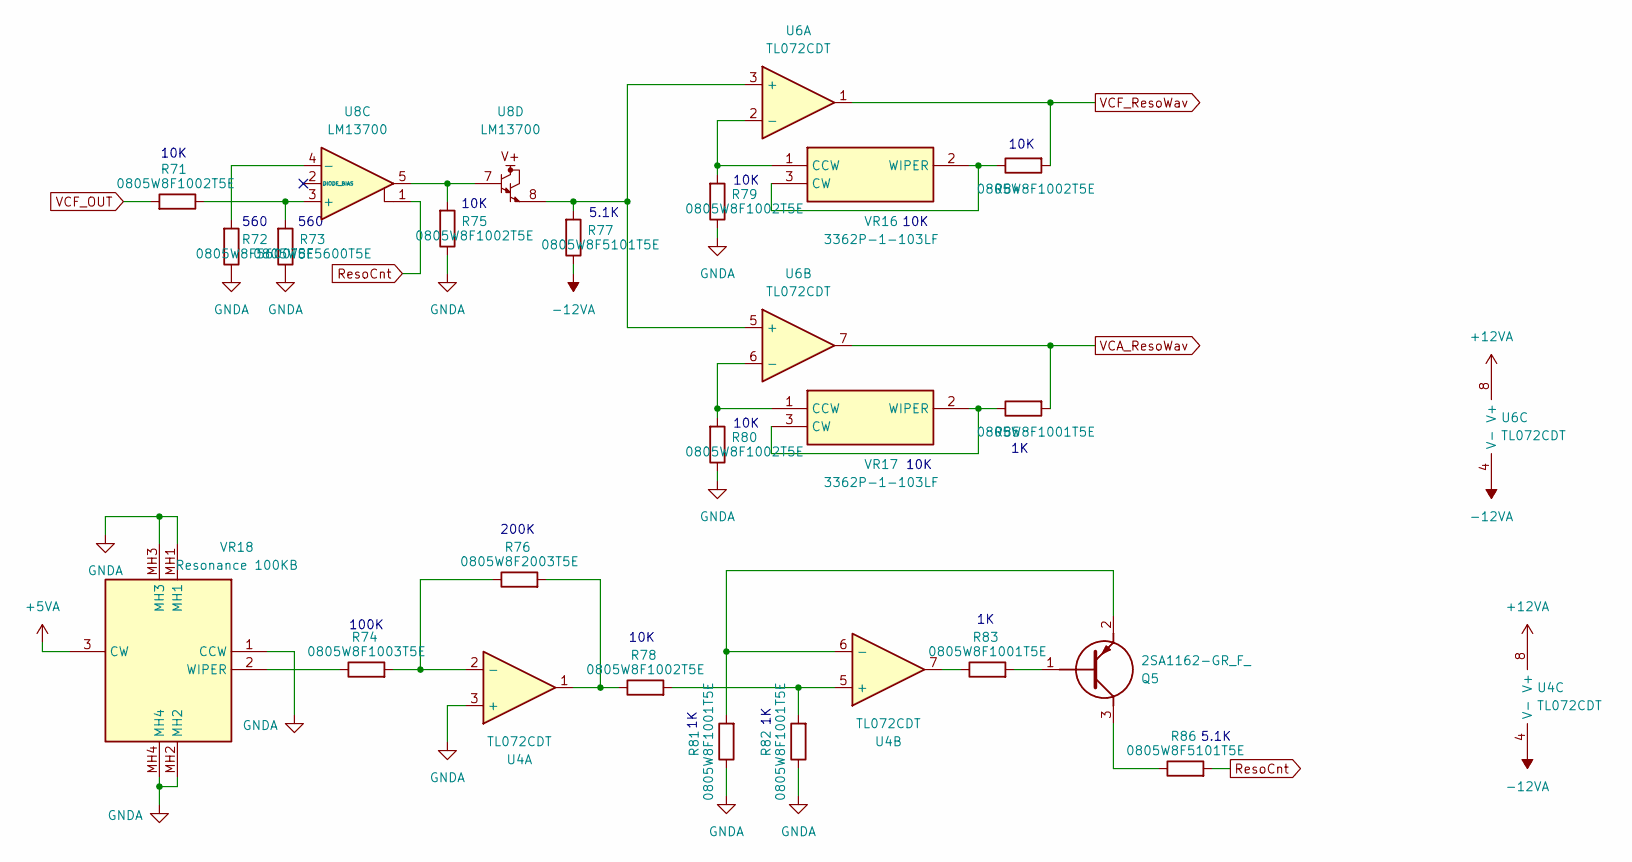
[picture p50: schematic ResoVCA.kicad_sch]

Parts:
Q5: 2SA1162-GR_F_; 1SS294LFT; Manufacturer_Part_Number 2SA1162-GR(F)
R71, R75, R78, R79, R80, R84: 0805W8F1002T5E; R_0805_2012Metric_Pad1.20x1.40mm_HandSolder
R72, R73: 0805W8F5600T5E; R_0805_2012Metric_Pad1.20x1.40mm_HandSolder
R74: 0805W8F1003T5E; R_0805_2012Metric_Pad1.20x1.40mm_HandSolder
R76: 0805W8F2003T5E; R_0805_2012Metric_Pad1.20x1.40mm_HandSolder
R77, R86: 0805W8F5101T5E; R_0805_2012Metric_Pad1.20x1.40mm_HandSolder
R81, R82, R83, R85: 0805W8F1001T5E; R_0805_2012Metric_Pad1.20x1.40mm_HandSolder
U4, U6: TL072CDT; SOIC-8_3.9x4.9mm_P1.27mm
U8: LM13700; SOIC-16_3.9x9.9mm_P1.27mm
VR16, VR17: 3362P-1-103LF; 3362P_1; Manufacturer_Part_Number 3362P-1-103LF; Mouser Part Number 652-3362P-1-103LF
VR18: Resonance 100KB; PTA20432010CIB104; Manufacturer_Part_Number PTA2043-2010CIB104; Mouser Part Number 652-PTA2432010CIB104

Connections:
+5VA: VR18.3 (CW); also elsewhere on the board
+12VA: U4.8 (V+), U6.8 (V+); also elsewhere on the board
-12VA: R77.1, U4.4 (V-), U6.4 (V-); also elsewhere on the board
GNDA: R72.1, R73.1, R75.1, R79.1, R80.1, R81.1, R82.1, U4.3 (+), VR18.1 (CCW), VR18.MH1, VR18.MH2, VR18.MH3, VR18.MH4; also elsewhere on the board
unnamed: Q5.1 (B), R83.2
unnamed: Q5.3 (C), R86.1
unnamed: Q5.2 (E), R81.2, U4.6 (-)
unnamed: R75.2, U8.5, U8.7
unnamed: R76.2, R78.1, U4.1
unnamed: R83.1, U4.7
unnamed: R74.2, R76.1, U4.2 (-)
unnamed: R78.2, R82.2, U4.5 (+)
unnamed: R77.2, U6.3 (+), U6.5 (+), U8.8
unnamed: R79.2, U6.2 (-), VR16.1 (CCW)
unnamed: R80.2, U6.6 (-), VR17.1 (CCW)
unnamed: R71.1, R73.2, U8.3 (+)
unnamed: R72.2, U8.4 (-)
unnamed: R84.1, VR16.2 (WIPER), VR16.3 (CW)
unnamed: R85.1, VR17.2 (WIPER), VR17.3 (CW)
unnamed: R74.1, VR18.2 (WIPER)
ResoCnt: R86.2, U8.1
VCA_ResoWav: R85.2, U6.7; also elsewhere on the board
VCF_OUT: R71.2; also elsewhere on the board
VCF_ResoWav: R84.2, U6.1; also elsewhere on the board

Notes on the sheet:
10K
560
100K
5.1K
200K

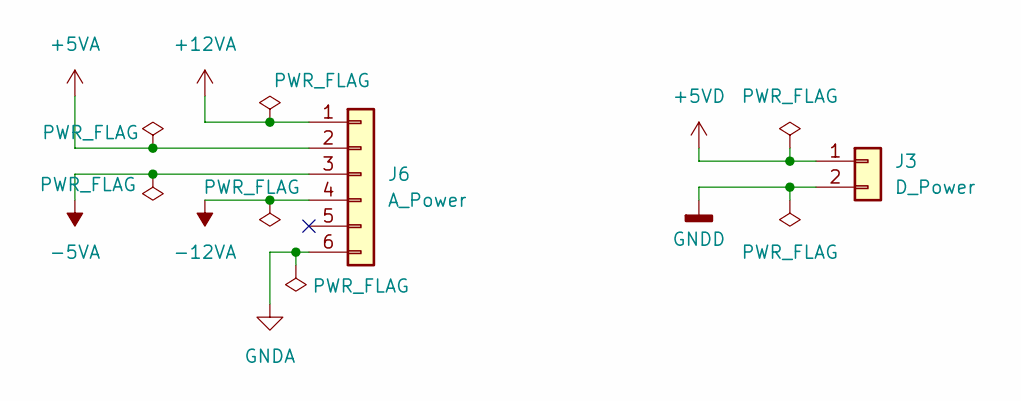
[picture p51: schematic Power.kicad_sch]

Parts:
J3: D_Power; PinSocket_1x02_P2.54mm_Vertical
J6: A_Power; PinHeader_1x06_P2.54mm_Vertical

Connections:
+5VA: J6.2; also elsewhere on the board
+5VD: J3.1; also elsewhere on the board
+12VA: J6.1; also elsewhere on the board
-5VA: J6.3
-12VA: J6.4; also elsewhere on the board
GNDA: J6.6; also elsewhere on the board
GNDD: J3.2; also elsewhere on the board
