wakimizufu/MC2/SynthBoard_Right/SynthBoard.kicad_pcb

## KiCad design SynthBoard_Right/SynthBoard.kicad_pcb (continued)

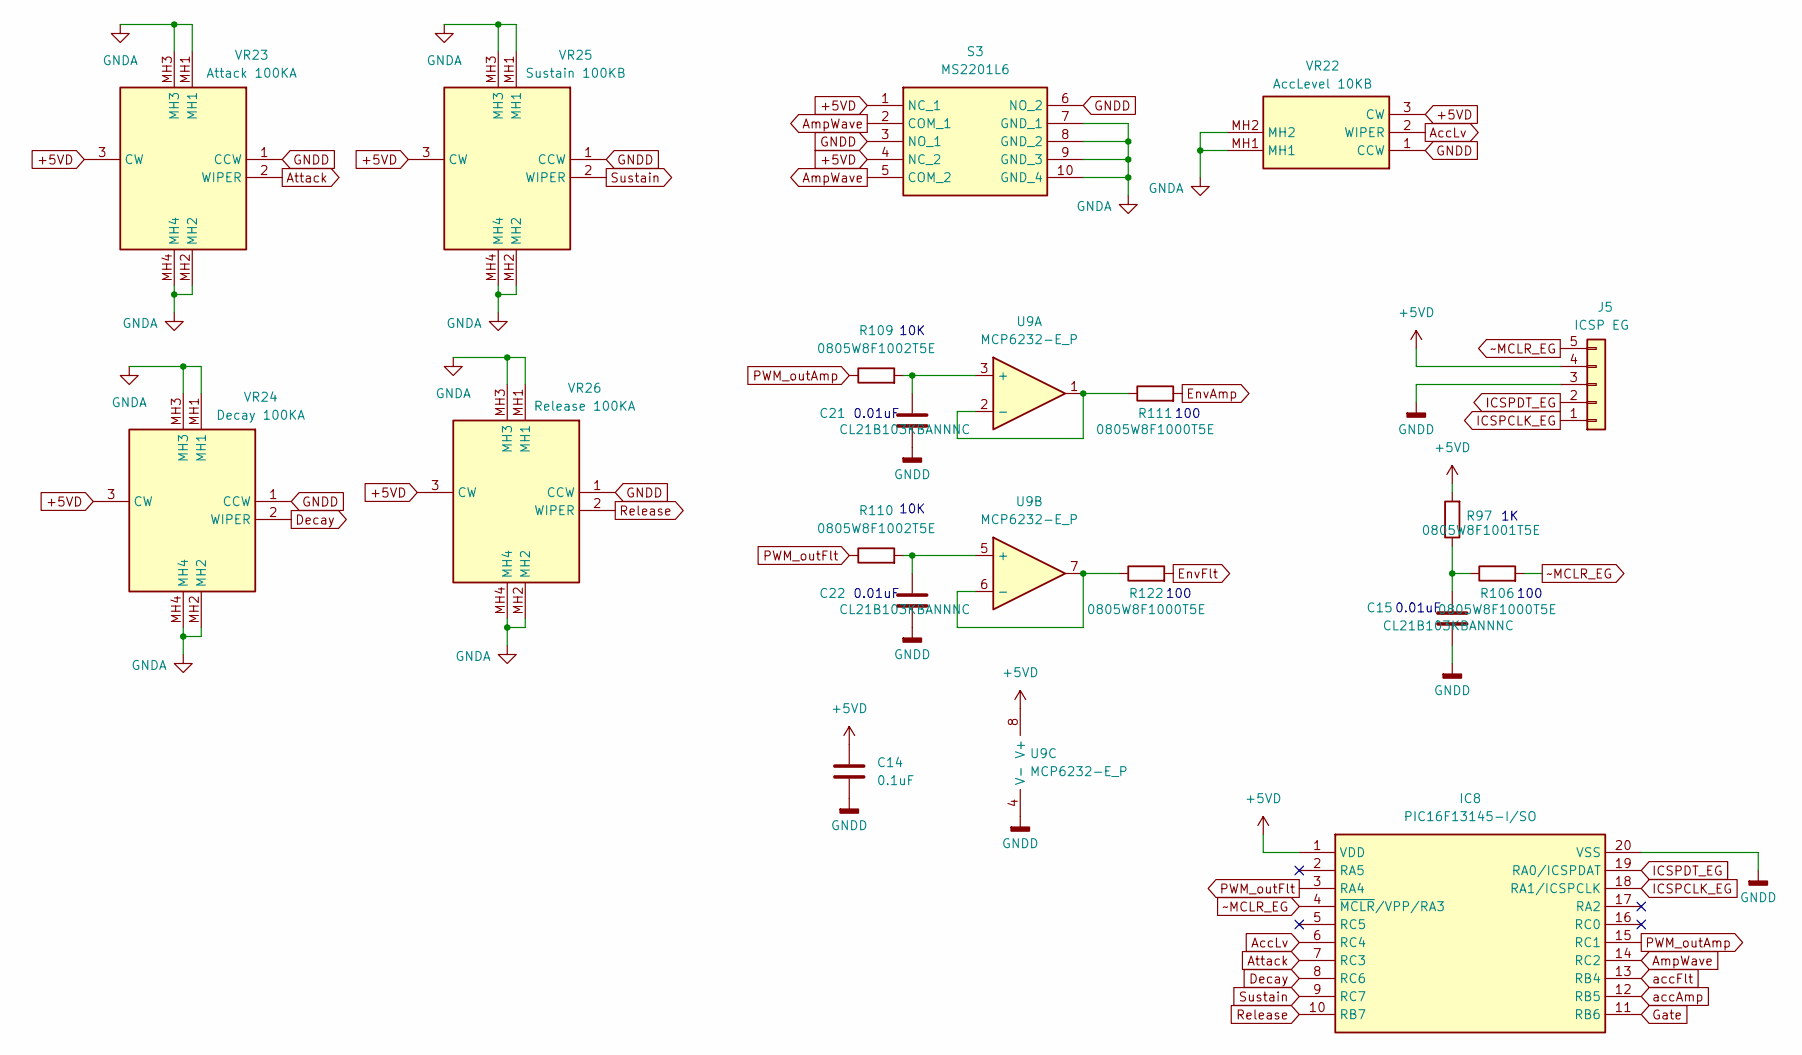
[picture p52: schematic EG.kicad_sch]

Parts:
C14: 0.1uF; C_0805_2012Metric_Pad1.18x1.45mm_HandSolder
C15, C21, C22: CL21B103KBANNNC; C_0805_2012Metric_Pad1.18x1.45mm_HandSolder
IC8: PIC16F13145-I/SO; SOIC-20W_7.5x12.8mm_P1.27mm; Manufacturer_Part_Number PIC16F13145-I/P; Mouser Part Number 579-PIC16F13145-I/P
J5: ICSP EG; PinHeader_1x05_P2.54mm_Vertical
R97: 0805W8F1001T5E; R_0805_2012Metric_Pad1.20x1.40mm_HandSolder
R106, R111, R122: 0805W8F1000T5E; R_0805_2012Metric_Pad1.20x1.40mm_HandSolder
R109, R110: 0805W8F1002T5E; R_0805_2012Metric_Pad1.20x1.40mm_HandSolder
S3: MS2201L6; Manufacturer_Part_Number MS2201L6
U9: MCP6232-E_P; SOIC-8_3.9x4.9mm_P1.27mm
VR22: AccLevel 10KB; RK09D117000B; Manufacturer_Part_Number RK09D117000B; Mouser Part Number 688-RK09D117000B
VR23: Attack 100KA; PTA20432010CIB104; Manufacturer_Part_Number PTA2043-2010CIB104; Mouser Part Number 652-PTA2432010CIB104
VR24: Decay 100KA; PTA20432010CIB104; Manufacturer_Part_Number PTA2043-2010CIB104; Mouser Part Number 652-PTA2432010CIB104
VR25: Sustain 100KB; PTA20432010CIB104; Manufacturer_Part_Number PTA2043-2010CIB104; Mouser Part Number 652-PTA2432010CIB104
VR26: Release 100KA; PTA20432010CIB104; Manufacturer_Part_Number PTA2043-2010CIB104; Mouser Part Number 652-PTA2432010CIB104

Connections:
+5VD: C14.1, IC8.1 (VDD), J5.4, R97.2, S3.1 (NC_1), S3.4 (NC_2), U9.8 (V+), VR22.3 (CW), VR23.3 (CW), VR24.3 (CW), VR25.3 (CW), VR26.3 (CW); also elsewhere on the board
AccLv: IC8.6 (RC4), VR22.2 (WIPER)
AmpWave: IC8.14 (RC2), S3.2 (COM_1), S3.5 (COM_2)
Attack: IC8.7 (RC3), VR23.2 (WIPER)
Decay: IC8.8 (RC6), VR24.2 (WIPER)
EnvAmp: R111.2; also elsewhere on the board
EnvFlt: R122.2; also elsewhere on the board
GNDA: S3.7 (GND_1), S3.8 (GND_2), S3.9 (GND_3), S3.10 (GND_4), VR22.MH1, VR22.MH2, VR23.MH1, VR23.MH2, VR23.MH3, VR23.MH4, VR24.MH1, VR24.MH2, VR24.MH3, VR24.MH4, VR25.MH1, VR25.MH2, VR25.MH3, VR25.MH4, VR26.MH1, VR26.MH2, VR26.MH3, VR26.MH4; also elsewhere on the board
GNDD: C14.2, C15.2, C21.2, C22.2, IC8.20 (VSS), J5.3, S3.3 (NO_1), S3.6 (NO_2), U9.4 (V-), VR22.1 (CCW), VR23.1 (CCW), VR24.1 (CCW), VR25.1 (CCW), VR26.1 (CCW); also elsewhere on the board
Gate: IC8.11 (RB6); also elsewhere on the board
ICSPCLK_EG: IC8.18 (RA1/ICSPCLK), J5.1
ICSPDT_EG: IC8.19 (RA0/ICSPDAT), J5.2
unnamed: C15.1, R97.1, R106.1
unnamed: C21.1, R109.2, U9.3 (+)
unnamed: R111.1, U9.1, U9.2 (-)
unnamed: C22.1, R110.2, U9.5 (+)
unnamed: R122.1, U9.6 (-), U9.7
PWM_outAmp: IC8.15 (RC1), R109.1
PWM_outFlt: IC8.3 (RA4), R110.1
Release: IC8.10 (RB7), VR26.2 (WIPER)
Sustain: IC8.9 (RC7), VR25.2 (WIPER)
accAmp: IC8.12 (RB5); also elsewhere on the board
accFlt: IC8.13 (RB4); also elsewhere on the board
~MCLR_EG: IC8.4 (~MCLR/VPP/RA3), J5.5, R106.2

Notes on the sheet:
0.01uF
100
10K

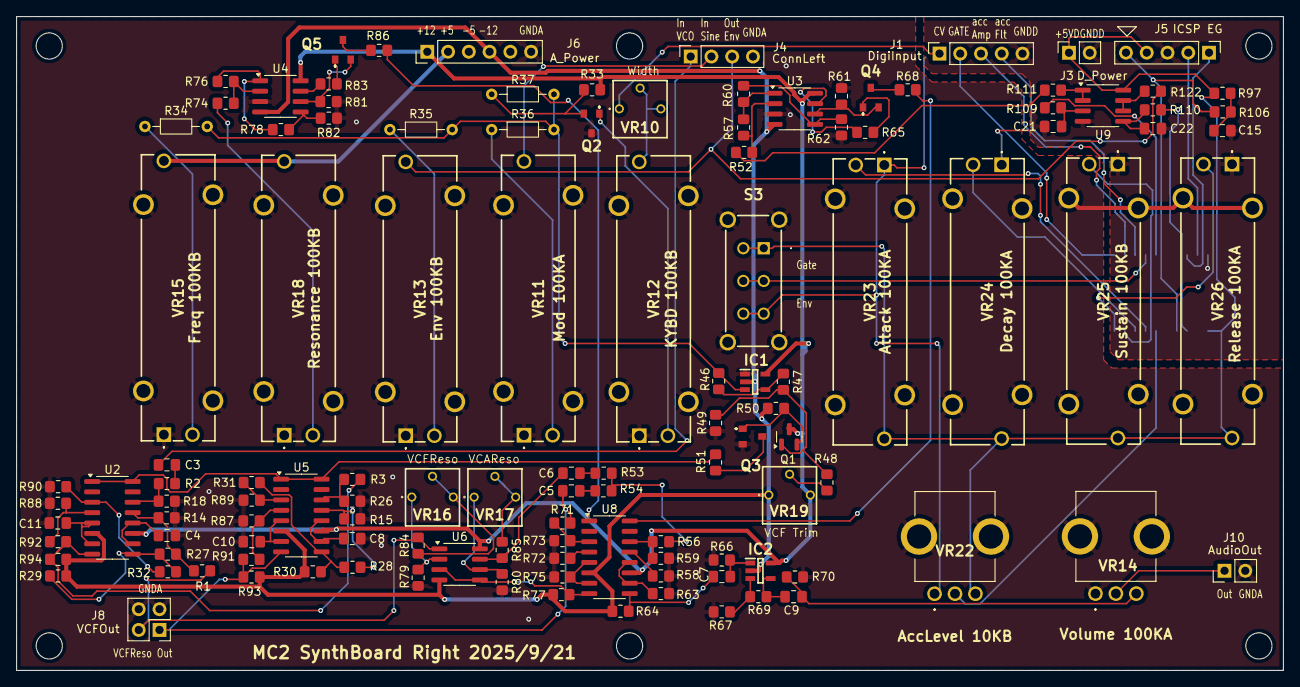
[picture p53: board SynthBoard.kicad_pcb from above]

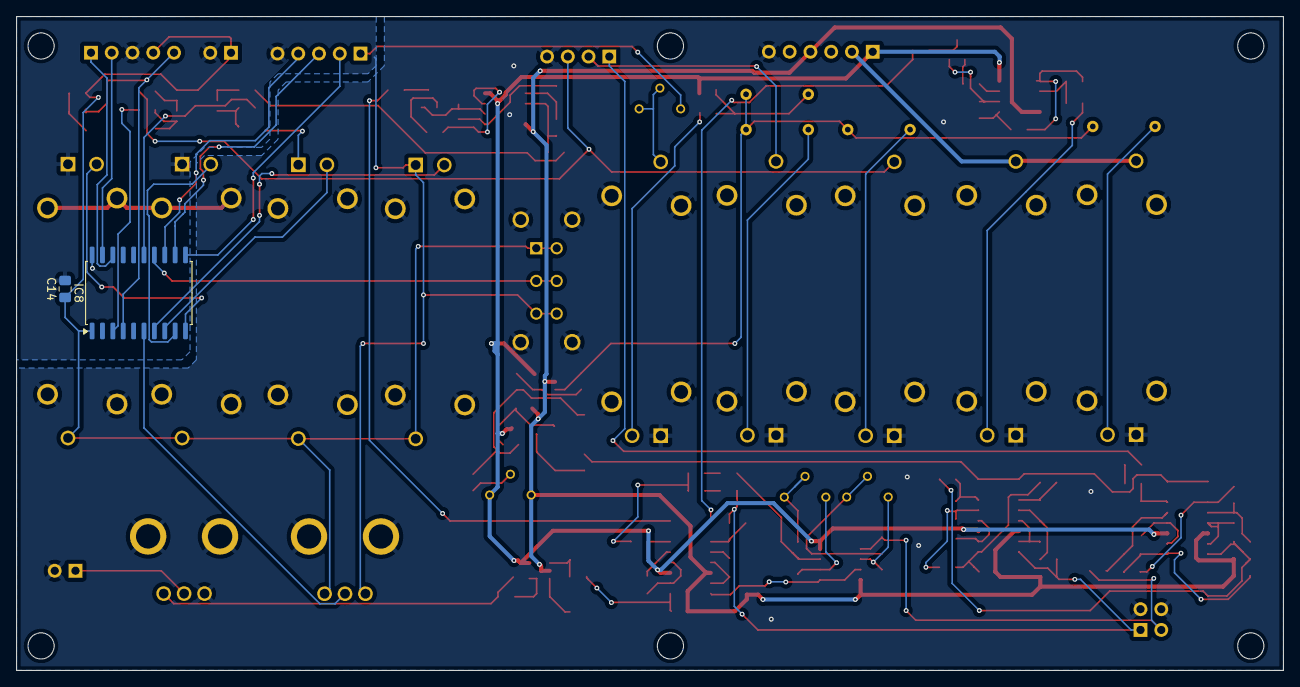
[picture p54: board SynthBoard.kicad_pcb from below]

Board: 2 copper layers, 155.0 x 80.0 mm, 123 parts (2 on the bottom side), 99 nets.
