wakimizufu/MC2/SynthBoard_Rotary/EGBoard/EGBoard.kicad_pcb

## KiCad design SynthBoard_Rotary/EGBoard/EGBoard.kicad_pcb (2026-02-22)

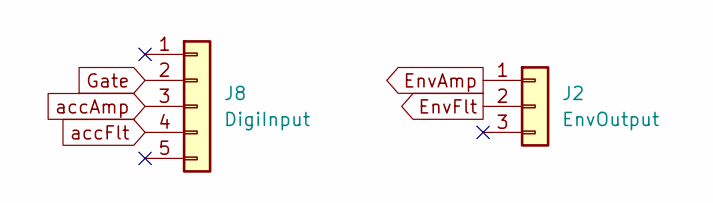
[picture p55: schematic Connect.kicad_sch]

Parts:
J2: EnvOutput; PinSocket_1x03_P2.54mm_Vertical
J8: DigiInput; PinSocket_1x05_P2.54mm_Vertical

Connections:
EnvAmp: J2.1; also elsewhere on the board
EnvFlt: J2.2; also elsewhere on the board
Gate: J8.2; also elsewhere on the board
accAmp: J8.3; also elsewhere on the board
accFlt: J8.4; also elsewhere on the board

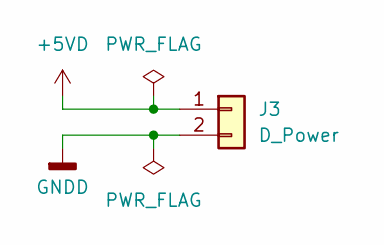
[picture p56: schematic Power.kicad_sch]

Parts:
J3: D_Power; PinSocket_1x02_P2.54mm_Vertical

Connections:
+5VD: J3.1; also elsewhere on the board
GNDD: J3.2; also elsewhere on the board

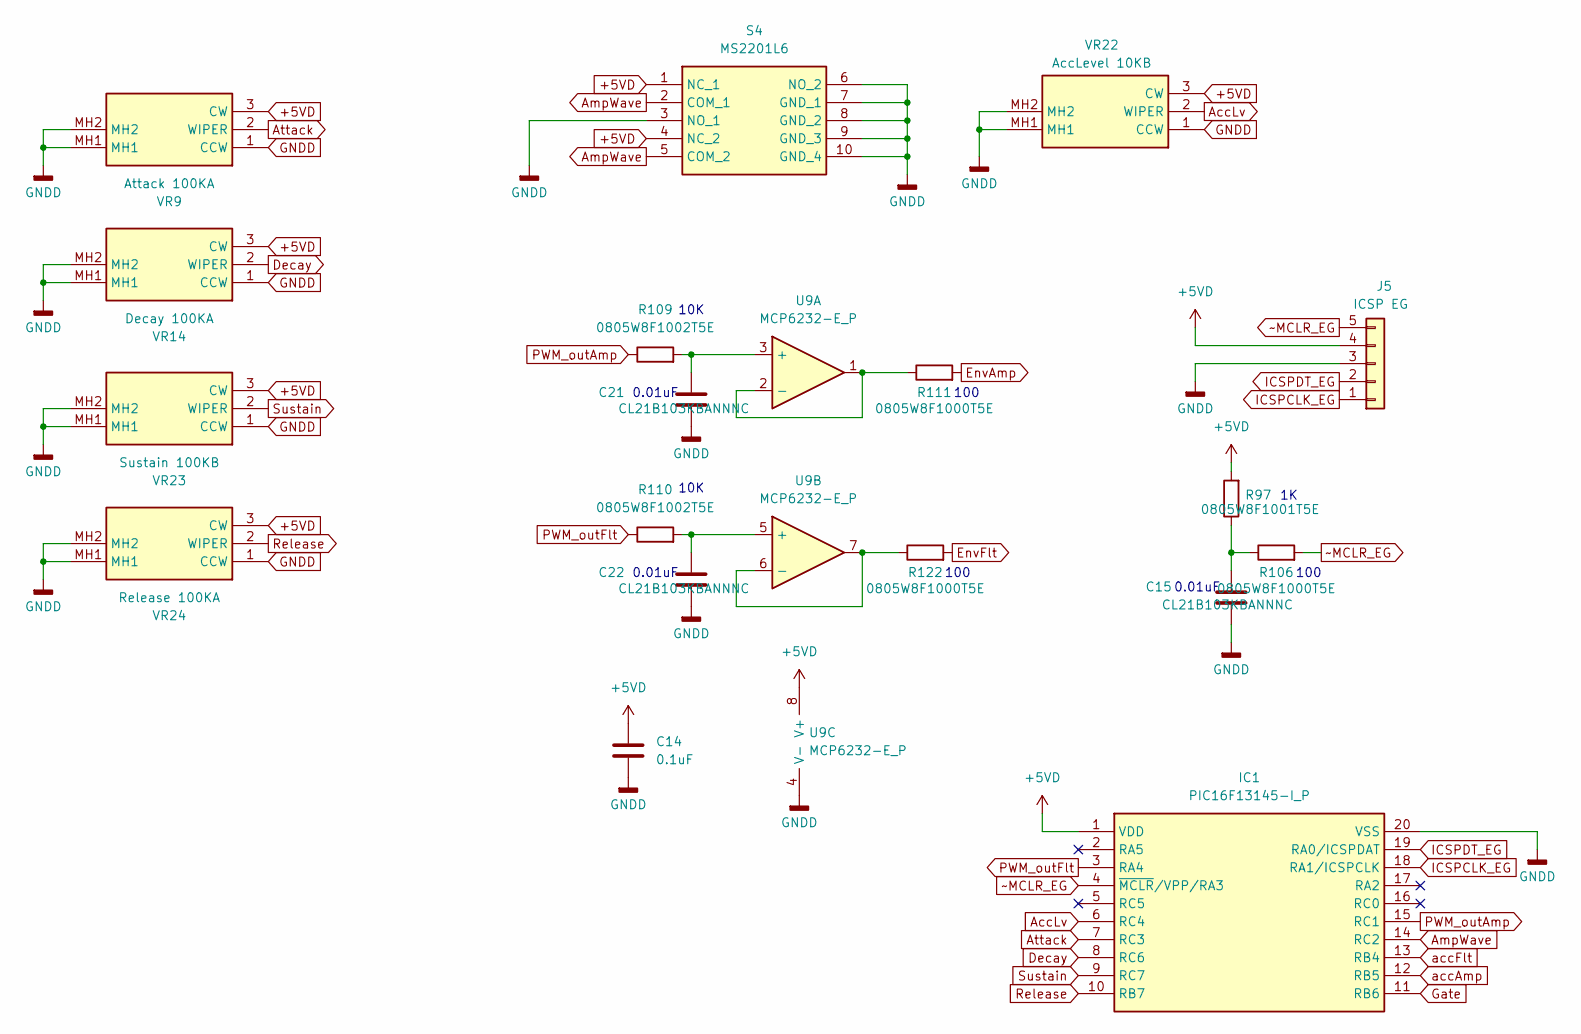
[picture p57: schematic EG.kicad_sch]

Parts:
C14: 0.1uF; C_0805_2012Metric_Pad1.18x1.45mm_HandSolder
C15, C21, C22: CL21B103KBANNNC; C_0805_2012Metric_Pad1.18x1.45mm_HandSolder
IC1: PIC16F13145-I_P; DIP794W56P254L2591H533Q20N; Manufacturer_Part_Number PIC16F13145-I/P; Mouser Part Number 579-PIC16F13145-I/P
J5: ICSP EG; PinHeader_1x05_P2.54mm_Vertical
R97: 0805W8F1001T5E; R_0805_2012Metric_Pad1.20x1.40mm_HandSolder
R106, R111, R122: 0805W8F1000T5E; R_0805_2012Metric_Pad1.20x1.40mm_HandSolder
R109, R110: 0805W8F1002T5E; R_0805_2012Metric_Pad1.20x1.40mm_HandSolder
S4: MS2201L6; Manufacturer_Part_Number MS2201L6
U9: MCP6232-E_P; SOIC-8_3.9x4.9mm_P1.27mm
VR9: Attack 100KA; RK09D117000B; Manufacturer_Part_Number RK09D117000B; Mouser Part Number 688-RK09D117000B
VR14: Decay 100KA; RK09D117000B; Manufacturer_Part_Number RK09D117000B; Mouser Part Number 688-RK09D117000B
VR22: AccLevel 10KB; RK09D117000B; Manufacturer_Part_Number RK09D117000B; Mouser Part Number 688-RK09D117000B
VR23: Sustain 100KB; RK09D117000B; Manufacturer_Part_Number RK09D117000B; Mouser Part Number 688-RK09D117000B
VR24: Release 100KA; RK09D117000B; Manufacturer_Part_Number RK09D117000B; Mouser Part Number 688-RK09D117000B

Connections:
+5VD: C14.1, IC1.1 (VDD), J5.4, R97.2, S4.1 (NC_1), S4.4 (NC_2), U9.8 (V+), VR9.3 (CW), VR14.3 (CW), VR22.3 (CW), VR23.3 (CW), VR24.3 (CW); also elsewhere on the board
AccLv: IC1.6 (RC4), VR22.2 (WIPER)
AmpWave: IC1.14 (RC2), S4.2 (COM_1), S4.5 (COM_2)
Attack: IC1.7 (RC3), VR9.2 (WIPER)
Decay: IC1.8 (RC6), VR14.2 (WIPER)
EnvAmp: R111.2; also elsewhere on the board
EnvFlt: R122.2; also elsewhere on the board
GNDD: C14.2, C15.2, C21.2, C22.2, IC1.20 (VSS), J5.3, S4.3 (NO_1), S4.6 (NO_2), S4.7 (GND_1), S4.8 (GND_2), S4.9 (GND_3), S4.10 (GND_4), U9.4 (V-), VR9.1 (CCW), VR9.MH1, VR9.MH2, VR14.1 (CCW), VR14.MH1, VR14.MH2, VR22.1 (CCW), VR22.MH1, VR22.MH2, VR23.1 (CCW), VR23.MH1, VR23.MH2, VR24.1 (CCW), VR24.MH1, VR24.MH2; also elsewhere on the board
Gate: IC1.11 (RB6); also elsewhere on the board
ICSPCLK_EG: IC1.18 (RA1/ICSPCLK), J5.1
ICSPDT_EG: IC1.19 (RA0/ICSPDAT), J5.2
unnamed: C15.1, R97.1, R106.1
unnamed: C21.1, R109.2, U9.3 (+)
unnamed: R111.1, U9.1, U9.2 (-)
unnamed: C22.1, R110.2, U9.5 (+)
unnamed: R122.1, U9.6 (-), U9.7
PWM_outAmp: IC1.15 (RC1), R109.1
PWM_outFlt: IC1.3 (RA4), R110.1
Release: IC1.10 (RB7), VR24.2 (WIPER)
Sustain: IC1.9 (RC7), VR23.2 (WIPER)
accAmp: IC1.12 (RB5); also elsewhere on the board
accFlt: IC1.13 (RB4); also elsewhere on the board
~MCLR_EG: IC1.4 (~MCLR/VPP/RA3), J5.5, R106.2

Notes on the sheet:
0.01uF
100
10K

Board: 2 copper layers, 22 parts (0 on the bottom side), 23 nets, no tracks yet.
