wakimizufu/MC2/VCOSeparate/VCOSeparate.kicad_pcb

## KiCad design VCOSeparate/VCOSeparate.kicad_pcb (2025-08-31, an earlier design)

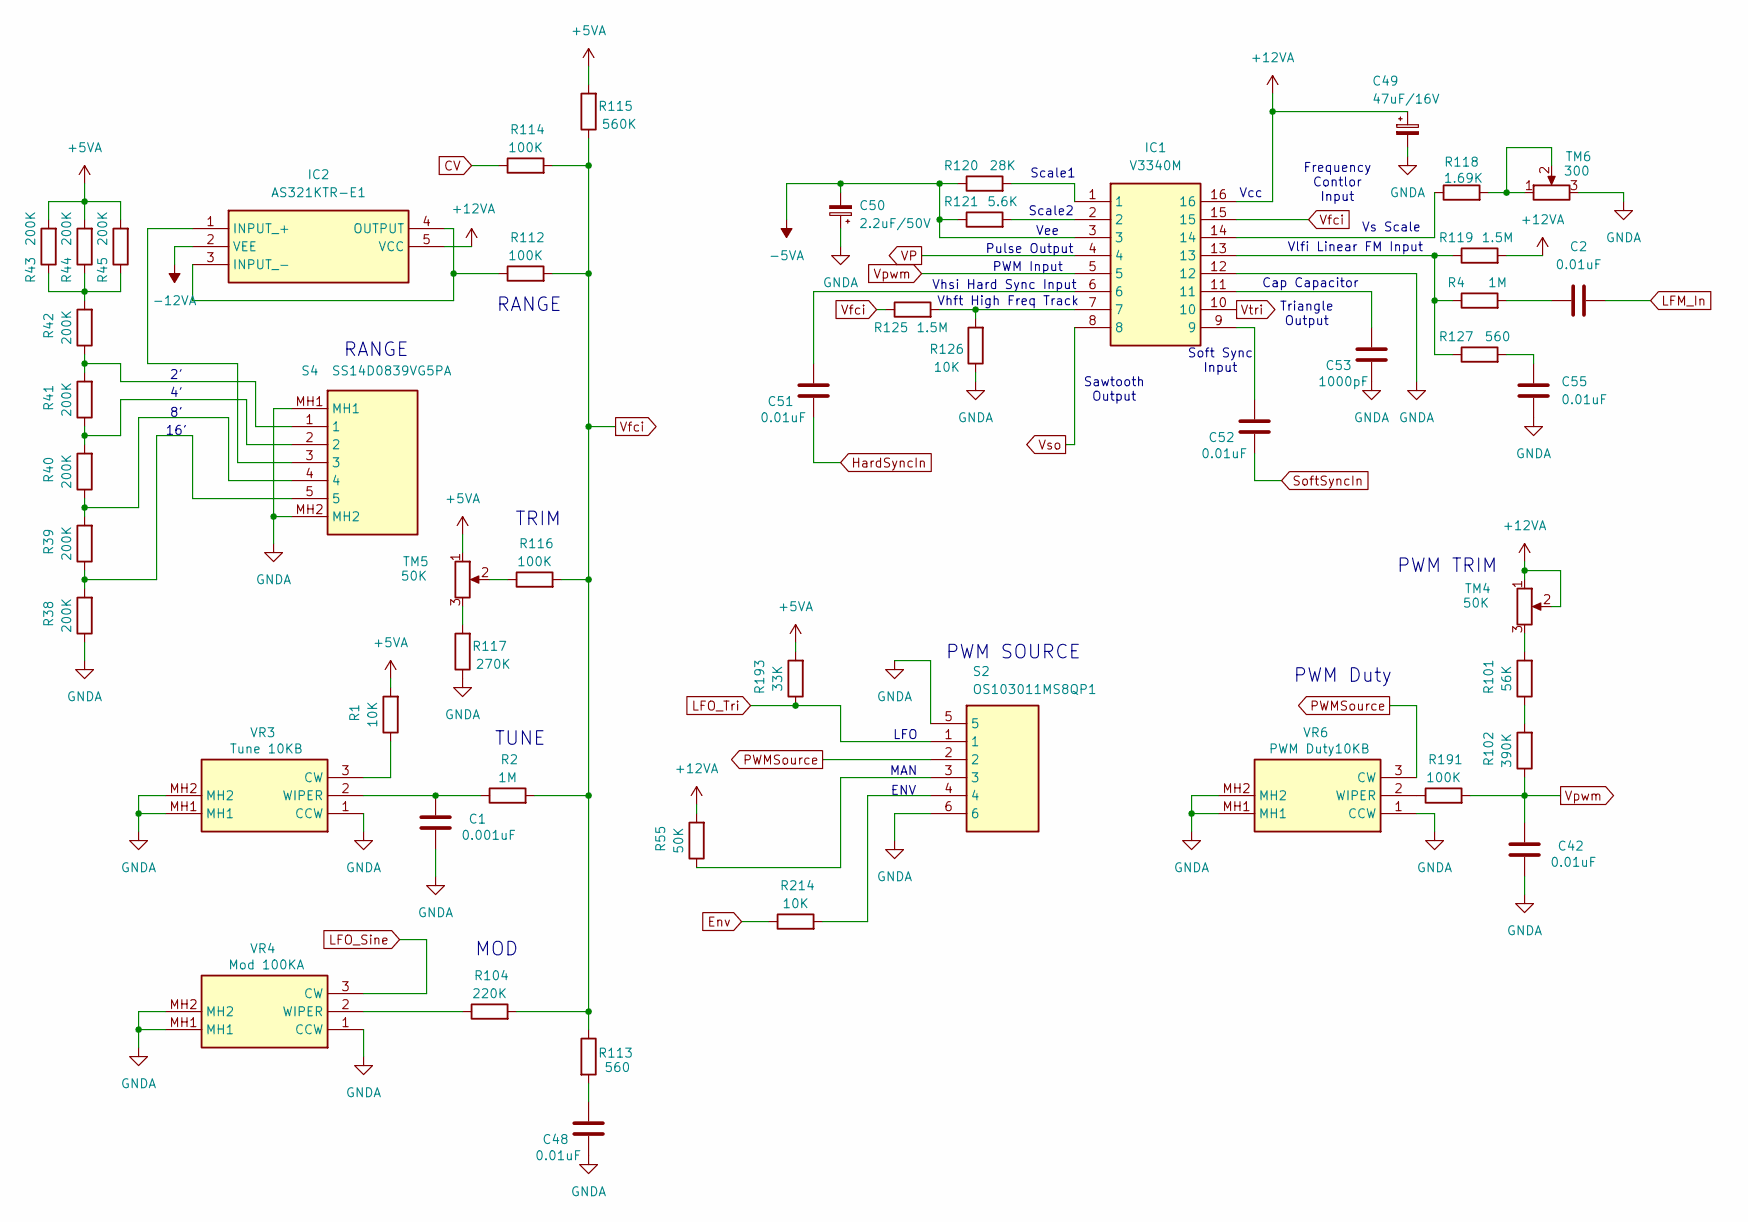
[picture p58: schematic VCO.kicad_sch]

Parts:
C1: 0.001uF; C_Disc_D5.0mm_W2.5mm_P2.50mm
C2, C42, C48, C51, C52, C55: 0.01uF; C_Disc_D5.0mm_W2.5mm_P2.50mm
C49: 47uF/16V; CP_Radial_D5.0mm_P2.50mm
C50: 2.2uF/50V; CP_Radial_D5.0mm_P2.50mm
C53: 1000pF; C_Disc_D5.0mm_W2.5mm_P2.50mm
IC1: V3340M; DIP794W56P260L1905H432Q16N; Manufacturer_Part_Number V3340M
IC2: AS321KTR-E1; SOT95P282X145-5N; Manufacturer_Part_Number AS321KTR-E1; Mouser Part Number 621-AS321KTR-E1
R1, R126, R214: 10K; R_Axial_DIN0207_L6.3mm_D2.5mm_P2.54mm_Vertical
R2, R4: 1M; R_Axial_DIN0207_L6.3mm_D2.5mm_P2.54mm_Vertical
R38, R39, R40, R41, R42, R43, R44, R45: 200K; R_Axial_DIN0207_L6.3mm_D2.5mm_P2.54mm_Vertical
R55: 50K; R_Axial_DIN0207_L6.3mm_D2.5mm_P2.54mm_Vertical
R101: 56K; R_Axial_DIN0207_L6.3mm_D2.5mm_P2.54mm_Vertical
R102: 390K; R_Axial_DIN0207_L6.3mm_D2.5mm_P2.54mm_Vertical
R104: 220K; R_Axial_DIN0207_L6.3mm_D2.5mm_P2.54mm_Vertical
R112, R114, R116, R191: 100K; R_Axial_DIN0207_L6.3mm_D2.5mm_P2.54mm_Vertical
R113, R127: 560; R_Axial_DIN0207_L6.3mm_D2.5mm_P2.54mm_Vertical
R115: 560K; R_Axial_DIN0207_L6.3mm_D2.5mm_P2.54mm_Vertical
R117: 270K; R_Axial_DIN0207_L6.3mm_D2.5mm_P2.54mm_Vertical
R118: 1.69K; R_Axial_DIN0207_L6.3mm_D2.5mm_P2.54mm_Vertical
R119, R125: 1.5M; R_Axial_DIN0207_L6.3mm_D2.5mm_P2.54mm_Vertical
R120: 28K; R_Axial_DIN0207_L6.3mm_D2.5mm_P2.54mm_Vertical
R121: 5.6K; R_Axial_DIN0207_L6.3mm_D2.5mm_P2.54mm_Vertical
R193: 33K; R_Axial_DIN0207_L6.3mm_D2.5mm_P2.54mm_Vertical
S2: OS103011MS8QP1; Manufacturer_Part_Number OS103011MS8QP1; Mouser Part Number 611-OS103011MS8QP1
S4: SS14D0839VG5PA; Manufacturer_Part_Number SS14D0839VG5PA; Mouser Part Number 611-SS-14D0839-VG5PA
TM4, TM5: 50K; Potentiometer_Bourns_3386P_Vertical
TM6: 300; Potentiometer_Bourns_3386P_Vertical
VR3: Tune 10KB; RK09D117000B; Manufacturer_Part_Number RK09D117000B; Mouser Part Number 688-RK09D117000B
VR4: Mod 100KA; RK09D117000B; Manufacturer_Part_Number RK09D117000B; Mouser Part Number 688-RK09D117000B
VR6: PWM Duty10KB; RK09D117000B; Manufacturer_Part_Number RK09D117000B; Mouser Part Number 688-RK09D117000B

Connections:
+5VA: R1.2, R43.2, R44.2, R45.2, R115.2, R193.2, TM5.1; also elsewhere on the board
+12VA: C49.1, IC1.16, IC2.5 (VCC), R55.2, R119.2, TM4.1, TM4.2; also elsewhere on the board
-5VA: C50.2, IC1.3, R120.1, R121.1; also elsewhere on the board
-12VA: IC2.2 (VEE); also elsewhere on the board
CV: R114.1; also elsewhere on the board
Env: R214.1; also elsewhere on the board
GNDA: C1.1, C42.1, C48.1, C49.2, C50.1, C53.1, C55.1, IC1.12, R38.1, R117.1, R126.1, S2.5, S2.6, S4.MH1, S4.MH2, TM6.3, VR3.1 (CCW), VR3.MH1, VR3.MH2, VR4.1 (CCW), VR4.MH1, VR4.MH2, VR6.1 (CCW), VR6.MH1, VR6.MH2; also elsewhere on the board
HardSyncIn: C51.1; also elsewhere on the board
LFM_In: C2.1; also elsewhere on the board
LFO_Sine: VR4.3 (CW); also elsewhere on the board
LFO_Tri: R193.1, S2.1; also elsewhere on the board
unnamed: C2.2, R4.2
unnamed: C48.2, R113.2
unnamed: C51.2, IC1.6
unnamed: C52.2, IC1.9
unnamed: C53.2, IC1.11
unnamed: C55.2, R127.2
unnamed: IC1.1, R120.2
unnamed: IC1.2, R121.2
unnamed: IC1.7, R125.2, R126.2
unnamed: IC1.13, R4.1, R119.1, R127.1
unnamed: IC1.14, R118.1
unnamed: IC2.1 (INPUT_+), S4.3
unnamed: IC2.3 (INPUT_-), IC2.4 (OUTPUT), R112.1
unnamed: R38.2, R39.1, S4.5
unnamed: R39.2, R40.1, S4.4
unnamed: R40.2, R41.1, S4.2
unnamed: R41.2, R42.1, S4.1
unnamed: R42.2, R43.1, R44.1, R45.1
unnamed: R55.1, S2.3
unnamed: R101.1, R102.2
unnamed: R101.2, TM4.3
unnamed: R116.1, TM5.2
unnamed: R117.2, TM5.3
unnamed: R118.2, TM6.1, TM6.2
unnamed: R214.2, S2.4
unnamed: R1.1, VR3.3 (CW)
unnamed: C1.2, R2.1, VR3.2 (WIPER)
unnamed: R104.1, VR4.2 (WIPER)
unnamed: R191.1, VR6.2 (WIPER)
PWMSource: S2.2, VR6.3 (CW)
SoftSyncIn: C52.1; also elsewhere on the board
VP: IC1.4; also elsewhere on the board
Vfci: IC1.15, R2.2, R104.2, R112.2, R113.1, R114.2, R115.1, R116.2, R125.1
Vpwm: C42.2, IC1.5, R102.1, R191.2
Vso: IC1.8; also elsewhere on the board
Vtri: IC1.10; also elsewhere on the board

Notes on the sheet:
Vhft High Freq Track
LFO
TRIM
MOD
Vee
MAN
Sawtooth Output
PWM Input
RANGE
Vcc
PWM SOURCE
Vhsi Hard Sync Input
PWM TRIM
Vlfi Linear FM Input
16'
Pulse Output
Vs Scale
Scale1
Scale2
Triangle Output
Cap Capacitor
PWM Duty
Frequency Contlor Input
Soft Sync Input
TUNE
ENV

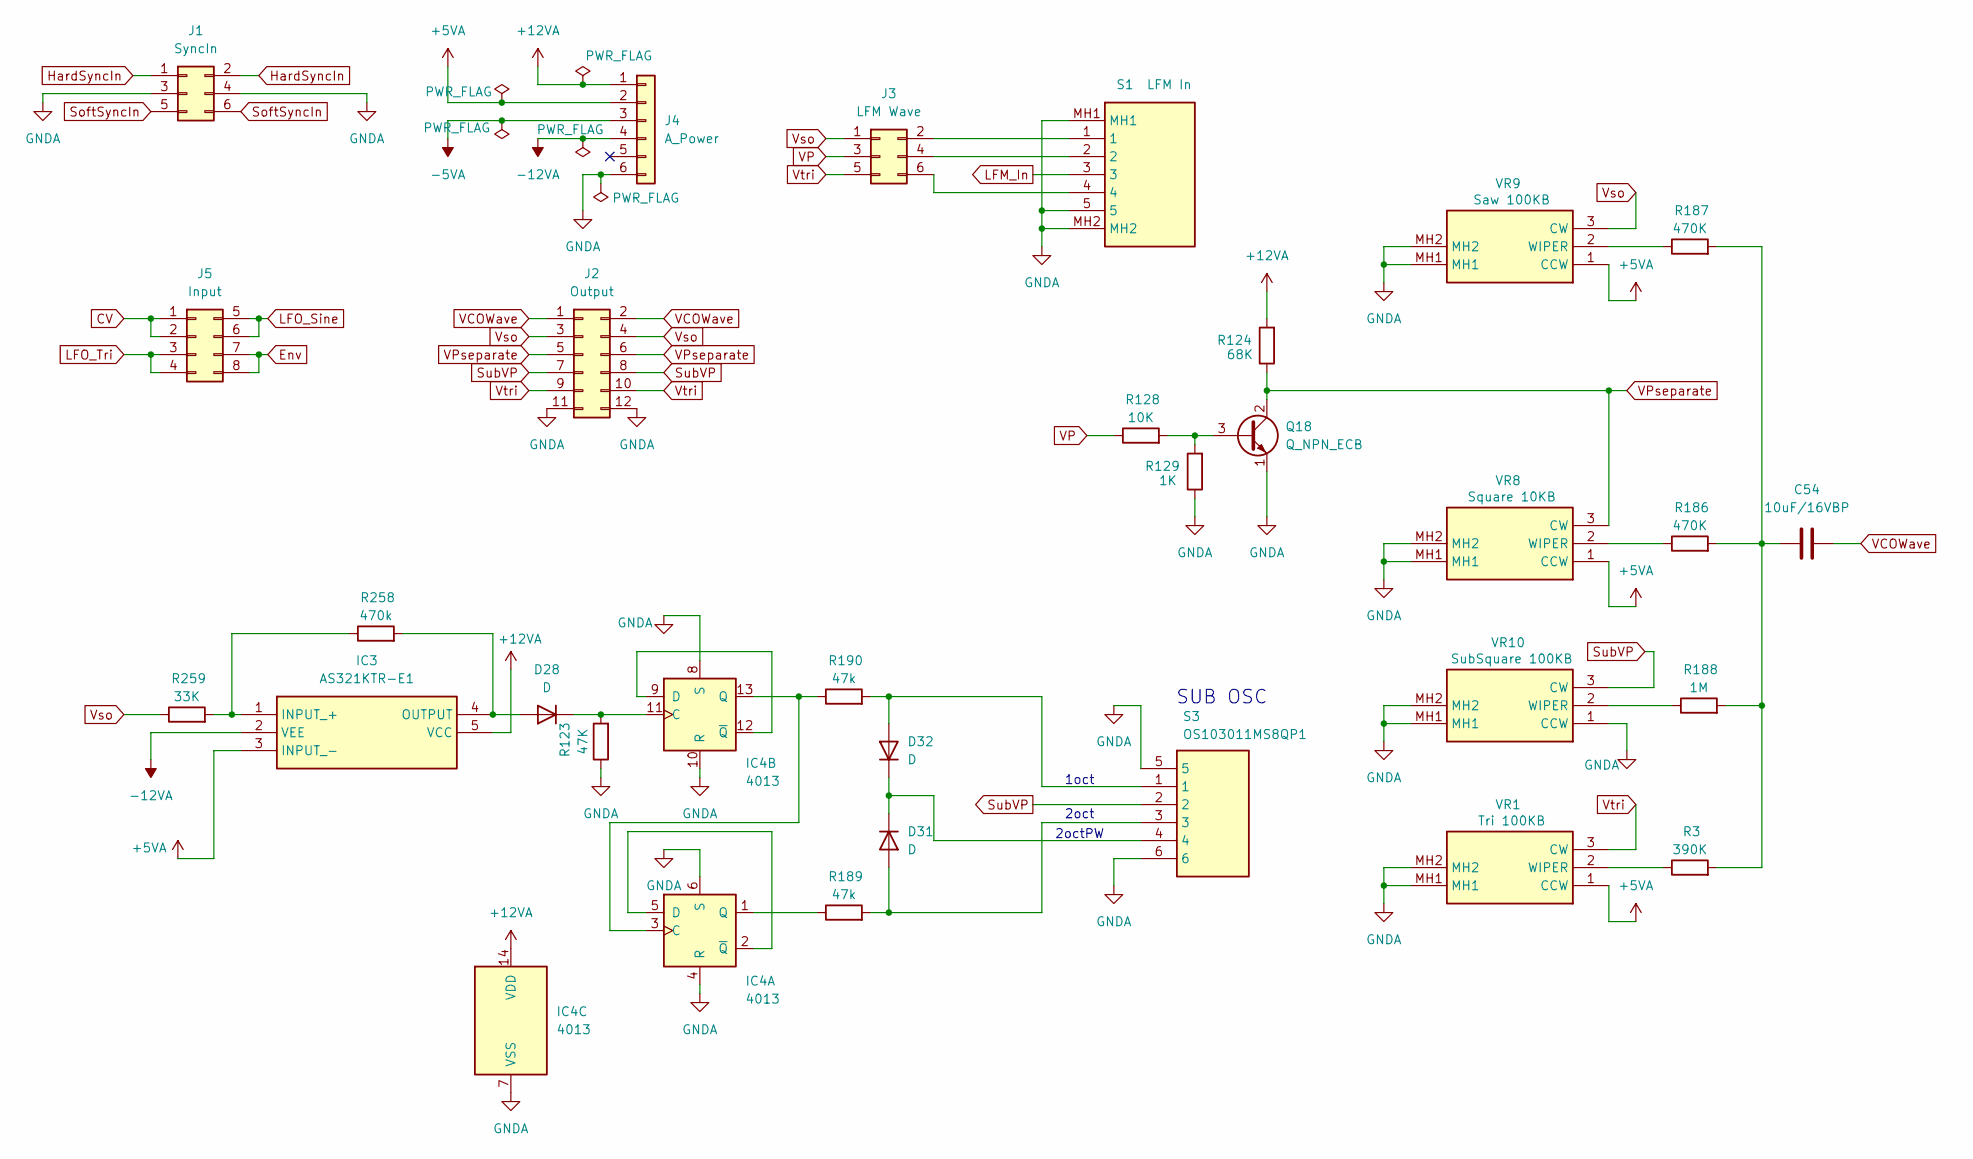
[picture p59: schematic Waveform.kicad_sch]

Parts:
C54: 10uF/16VBP; C_Radial_D6.3mm_H7.0mm_P2.50mm
D28, D31, D32: D; D_DO-15_P2.54mm_Vertical_AnodeUp
IC3: AS321KTR-E1; SOT95P282X145-5N; Manufacturer_Part_Number AS321KTR-E1; Mouser Part Number 621-AS321KTR-E1
IC4: 4013; DIP-14_W7.62mm_LongPads
J1: SyncIn; PinSocket_2x03_P2.54mm_Vertical
J2: Output; PinSocket_2x06_P2.54mm_Vertical
J3: LFM Wave; PinSocket_2x03_P2.54mm_Vertical
J4: A_Power; PinHeader_1x06_P2.54mm_Vertical
J5: Input; PinSocket_2x04_P2.54mm_Vertical
Q18: Q_NPN_ECB; TO-92_HandSolder
R3: 390K; R_Axial_DIN0207_L6.3mm_D2.5mm_P2.54mm_Vertical
R123: 47K; R_Axial_DIN0207_L6.3mm_D2.5mm_P2.54mm_Vertical
R124: 68K; R_Axial_DIN0207_L6.3mm_D2.5mm_P2.54mm_Vertical
R128: 10K; R_Axial_DIN0207_L6.3mm_D2.5mm_P2.54mm_Vertical
R129: 1K; R_Axial_DIN0207_L6.3mm_D2.5mm_P2.54mm_Vertical
R186, R187: 470K; R_Axial_DIN0207_L6.3mm_D2.5mm_P2.54mm_Vertical
R188: 1M; R_Axial_DIN0207_L6.3mm_D2.5mm_P2.54mm_Vertical
R189, R190: 47k; R_Axial_DIN0207_L6.3mm_D2.5mm_P2.54mm_Vertical
R258: 470k; R_Axial_DIN0207_L6.3mm_D2.5mm_P2.54mm_Vertical
R259: 33K; R_Axial_DIN0207_L6.3mm_D2.5mm_P2.54mm_Vertical
S1: LFM In; SS14D0839VG5PA; Manufacturer_Part_Number SS14D0839VG5PA; Mouser Part Number 611-SS-14D0839-VG5PA
S3: OS103011MS8QP1; Manufacturer_Part_Number OS103011MS8QP1; Mouser Part Number 611-OS103011MS8QP1
VR1: Tri 100KB; RK09D117000B; Manufacturer_Part_Number RK09D117000B; Mouser Part Number 688-RK09D117000B
VR8: Square 10KB; RK09D117000B; Manufacturer_Part_Number RK09D117000B; Mouser Part Number 688-RK09D117000B
VR9: Saw 100KB; RK09D117000B; Manufacturer_Part_Number RK09D117000B; Mouser Part Number 688-RK09D117000B
VR10: SubSquare 100KB; RK09D117000B; Manufacturer_Part_Number RK09D117000B; Mouser Part Number 688-RK09D117000B

Connections:
+5VA: IC3.3 (INPUT_-), J4.2, VR1.1 (CCW), VR8.1 (CCW), VR9.1 (CCW); also elsewhere on the board
+12VA: IC3.5 (VCC), IC4.14 (VDD), J4.1, R124.2; also elsewhere on the board
-5VA: J4.3; also elsewhere on the board
-12VA: IC3.2 (VEE), J4.4; also elsewhere on the board
CV: J5.1, J5.2; also elsewhere on the board
Env: J5.7, J5.8; also elsewhere on the board
GNDA: IC4.4 (R), IC4.6 (S), IC4.7 (VSS), IC4.8 (S), IC4.10 (R), J1.3, J1.4, J2.11, J2.12, J4.6, Q18.1 (E), R123.1, R129.1, S1.5, S1.MH1, S1.MH2, S3.5, S3.6, VR1.MH1, VR1.MH2, VR8.MH1, VR8.MH2, VR9.MH1, VR9.MH2, VR10.1 (CCW), VR10.MH1, VR10.MH2; also elsewhere on the board
HardSyncIn: J1.1, J1.2; also elsewhere on the board
LFM_In: S1.3; also elsewhere on the board
LFO_Sine: J5.5, J5.6; also elsewhere on the board
LFO_Tri: J5.3, J5.4; also elsewhere on the board
unnamed: C54.1, R3.2, R186.2, R187.2, R188.2
unnamed: D28.2 (A), IC3.4 (OUTPUT), R258.2
unnamed: D28.1 (K), IC4.11 (C), R123.2
unnamed: D31.2 (A), R189.2, S3.3
unnamed: D31.1 (K), D32.1 (K), S3.4
unnamed: D32.2 (A), R190.2, S3.1
unnamed: IC3.1 (INPUT_+), R258.1, R259.2
unnamed: IC4.3 (C), IC4.13 (Q), R190.1
unnamed: IC4.2 (~Q), IC4.5 (D)
unnamed: IC4.1 (Q), R189.1
unnamed: IC4.9 (D), IC4.12 (~Q)
unnamed: J3.2, S1.1
unnamed: J3.4, S1.2
unnamed: J3.6, S1.4
unnamed: Q18.3 (B), R128.2, R129.2
unnamed: R3.1, VR1.2 (WIPER)
unnamed: R186.1, VR8.2 (WIPER)
unnamed: R187.1, VR9.2 (WIPER)
unnamed: R188.1, VR10.2 (WIPER)
SoftSyncIn: J1.5, J1.6; also elsewhere on the board
SubVP: J2.7, J2.8, S3.2, VR10.3 (CW)
VCOWave: C54.2, J2.1, J2.2
VP: J3.3, R128.1; also elsewhere on the board
VPseparate: J2.5, J2.6, Q18.2 (C), R124.1, VR8.3 (CW)
Vso: J2.3, J2.4, J3.1, R259.1, VR9.3 (CW); also elsewhere on the board
Vtri: J2.9, J2.10, J3.5, VR1.3 (CW); also elsewhere on the board

Notes on the sheet:
1oct
2octPW
SUB OSC
2oct

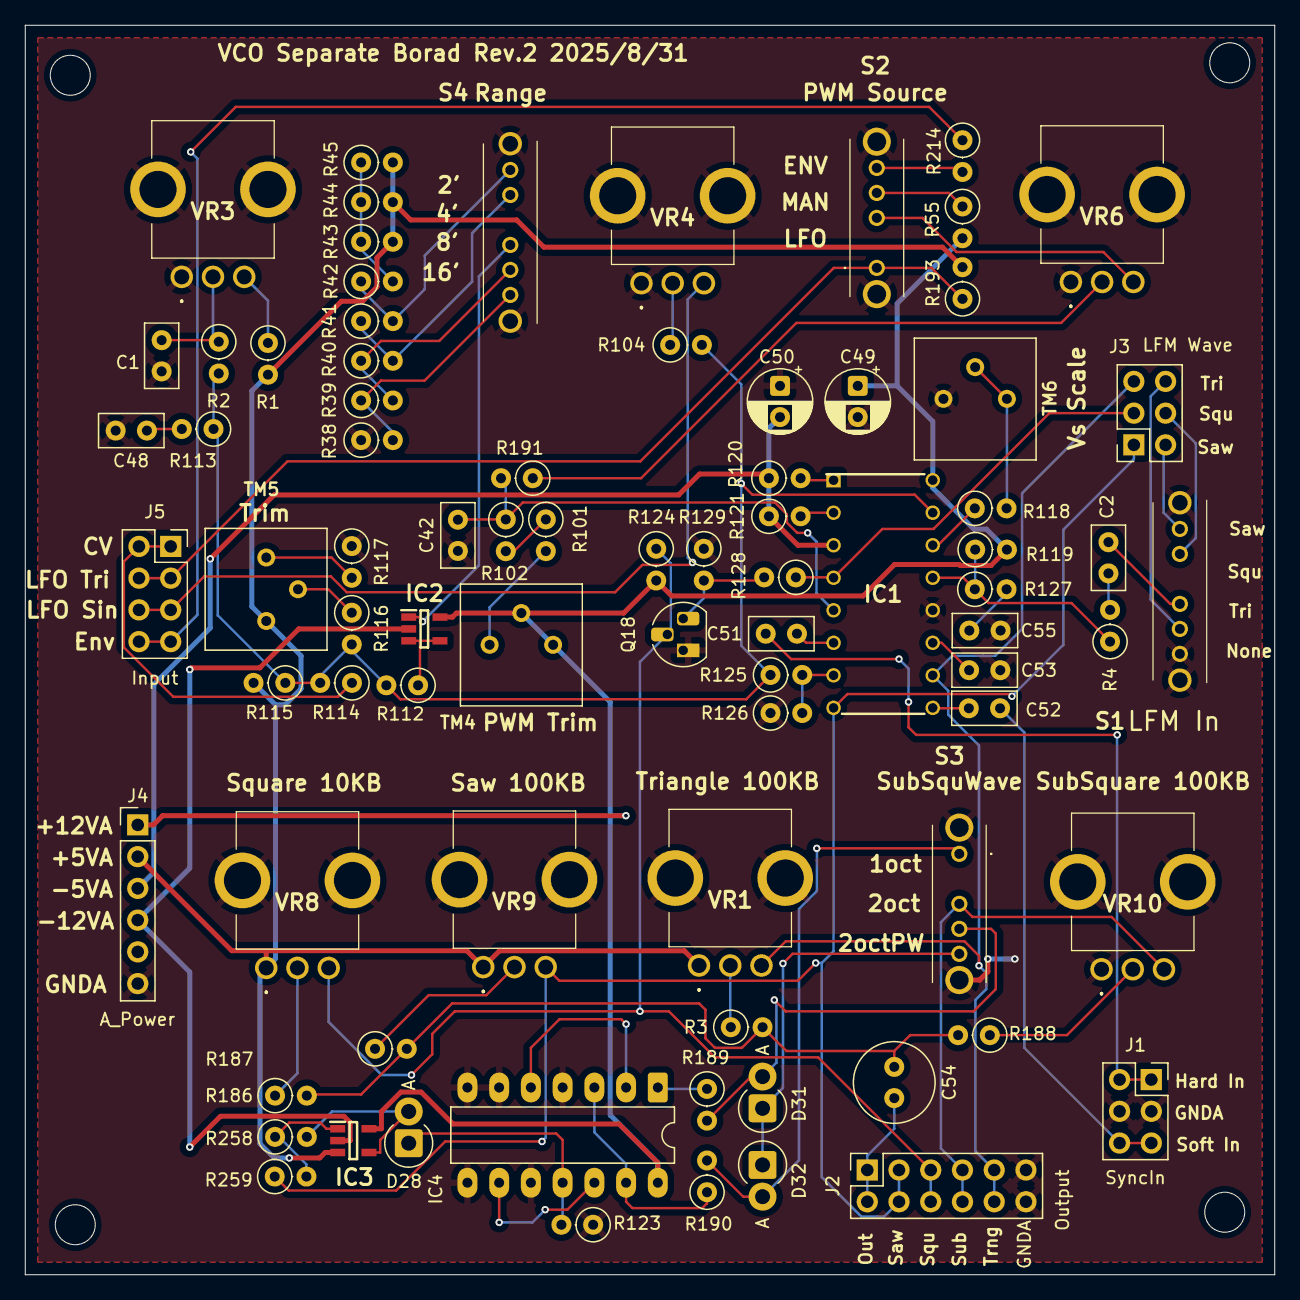
[picture p60: board VCOSeparate/VCOSeparate.kicad_pcb from above]

Board: 2 copper layers, 100.0 x 100.0 mm, 81 parts (0 on the bottom side), 69 nets.
