wakimizufu/MC2/debugVCASeparate/debugVCASeparate.kicad_pcb

## KiCad design debugVCASeparate/debugVCASeparate.kicad_pcb (2025-08-31)

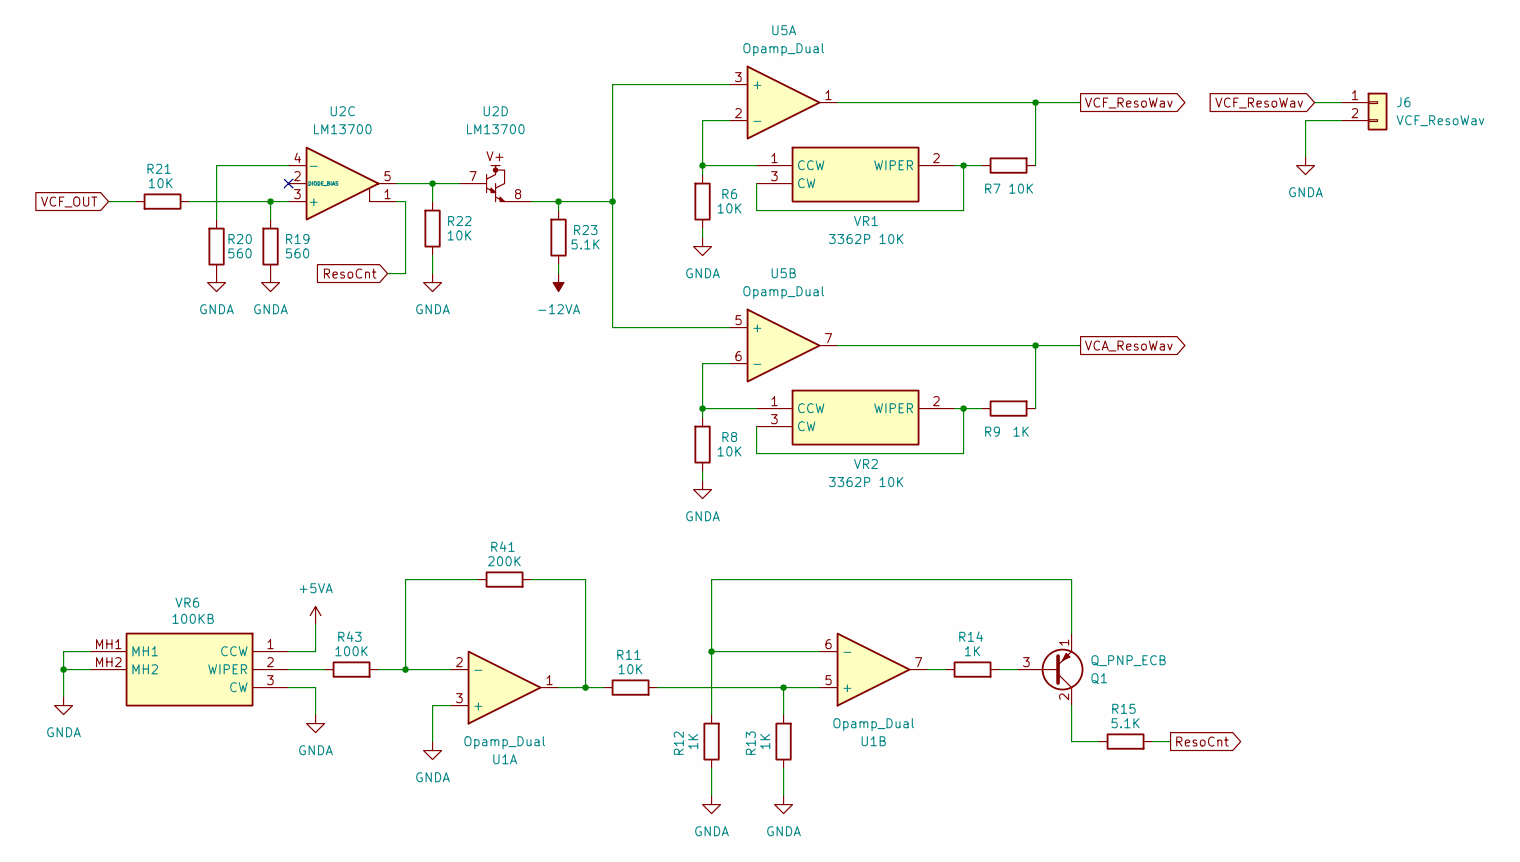
[picture p61: schematic VCF.kicad_sch]

Parts:
J6: VCF_ResoWav; PinSocket_1x02_P2.54mm_Vertical
Q1: Q_PNP_ECB; TO-92_HandSolder
R6, R7, R8, R11, R21, R22: 10K; R_Axial_DIN0204_L3.6mm_D1.6mm_P7.62mm_Horizontal
R9, R12, R13, R14: 1K; R_Axial_DIN0204_L3.6mm_D1.6mm_P7.62mm_Horizontal
R15, R23: 5.1K; R_Axial_DIN0204_L3.6mm_D1.6mm_P7.62mm_Horizontal
R19, R20: 560; R_Axial_DIN0204_L3.6mm_D1.6mm_P7.62mm_Horizontal
R41: 200K; R_Axial_DIN0204_L3.6mm_D1.6mm_P7.62mm_Horizontal
R43: 100K; R_Axial_DIN0204_L3.6mm_D1.6mm_P7.62mm_Horizontal
U1: Opamp_Dual; DIP-8_W7.62mm_LongPads
U2: LM13700; DIP-16_W7.62mm_LongPads
U5: Opamp_Dual; DIP-8_W7.62mm_Socket_LongPads
VR1, VR2: 3362P 10K; 3362P_1; Manufacturer_Part_Number 3362P-1-103LF; Mouser Part Number 652-3362P-1-103LF
VR6: 100KB; RK09D117000B; Manufacturer_Part_Number RK09D117000B; Mouser Part Number 688-RK09D117000B

Connections:
+5VA: VR6.1 (CCW); also elsewhere on the board
-12VA: R23.1; also elsewhere on the board
GNDA: J6.2, R6.1, R8.1, R12.1, R13.1, R19.1, R20.1, R22.1, U1.3 (+), VR6.3 (CW), VR6.MH1, VR6.MH2; also elsewhere on the board
unnamed: Q1.3 (B), R14.2
unnamed: Q1.2 (C), R15.1
unnamed: Q1.1 (E), R12.2, U1.6 (-)
unnamed: R11.1, R41.2, U1.1
unnamed: R14.1, U1.7
unnamed: R22.2, U2.5, U2.7
unnamed: R41.1, R43.2, U1.2 (-)
unnamed: R11.2, R13.2, U1.5 (+)
unnamed: R19.2, R21.1, U2.3 (+)
unnamed: R20.2, U2.4 (-)
unnamed: R23.2, U2.8, U5.3 (+), U5.5 (+)
unnamed: R6.2, U5.2 (-), VR1.1 (CCW)
unnamed: R8.2, U5.6 (-), VR2.1 (CCW)
unnamed: R7.1, VR1.2 (WIPER), VR1.3 (CW)
unnamed: R9.1, VR2.2 (WIPER), VR2.3 (CW)
unnamed: R43.1, VR6.2 (WIPER)
ResoCnt: R15.2, U2.1
VCA_ResoWav: R9.2, U5.7; also elsewhere on the board
VCF_OUT: R21.2; also elsewhere on the board
VCF_ResoWav: J6.1, R7.2, U5.1
