wakimizufu/MC2/debugVCASeparate/debugVCASeparate.kicad_pcb

## KiCad design debugVCASeparate/debugVCASeparate.kicad_pcb (continued)

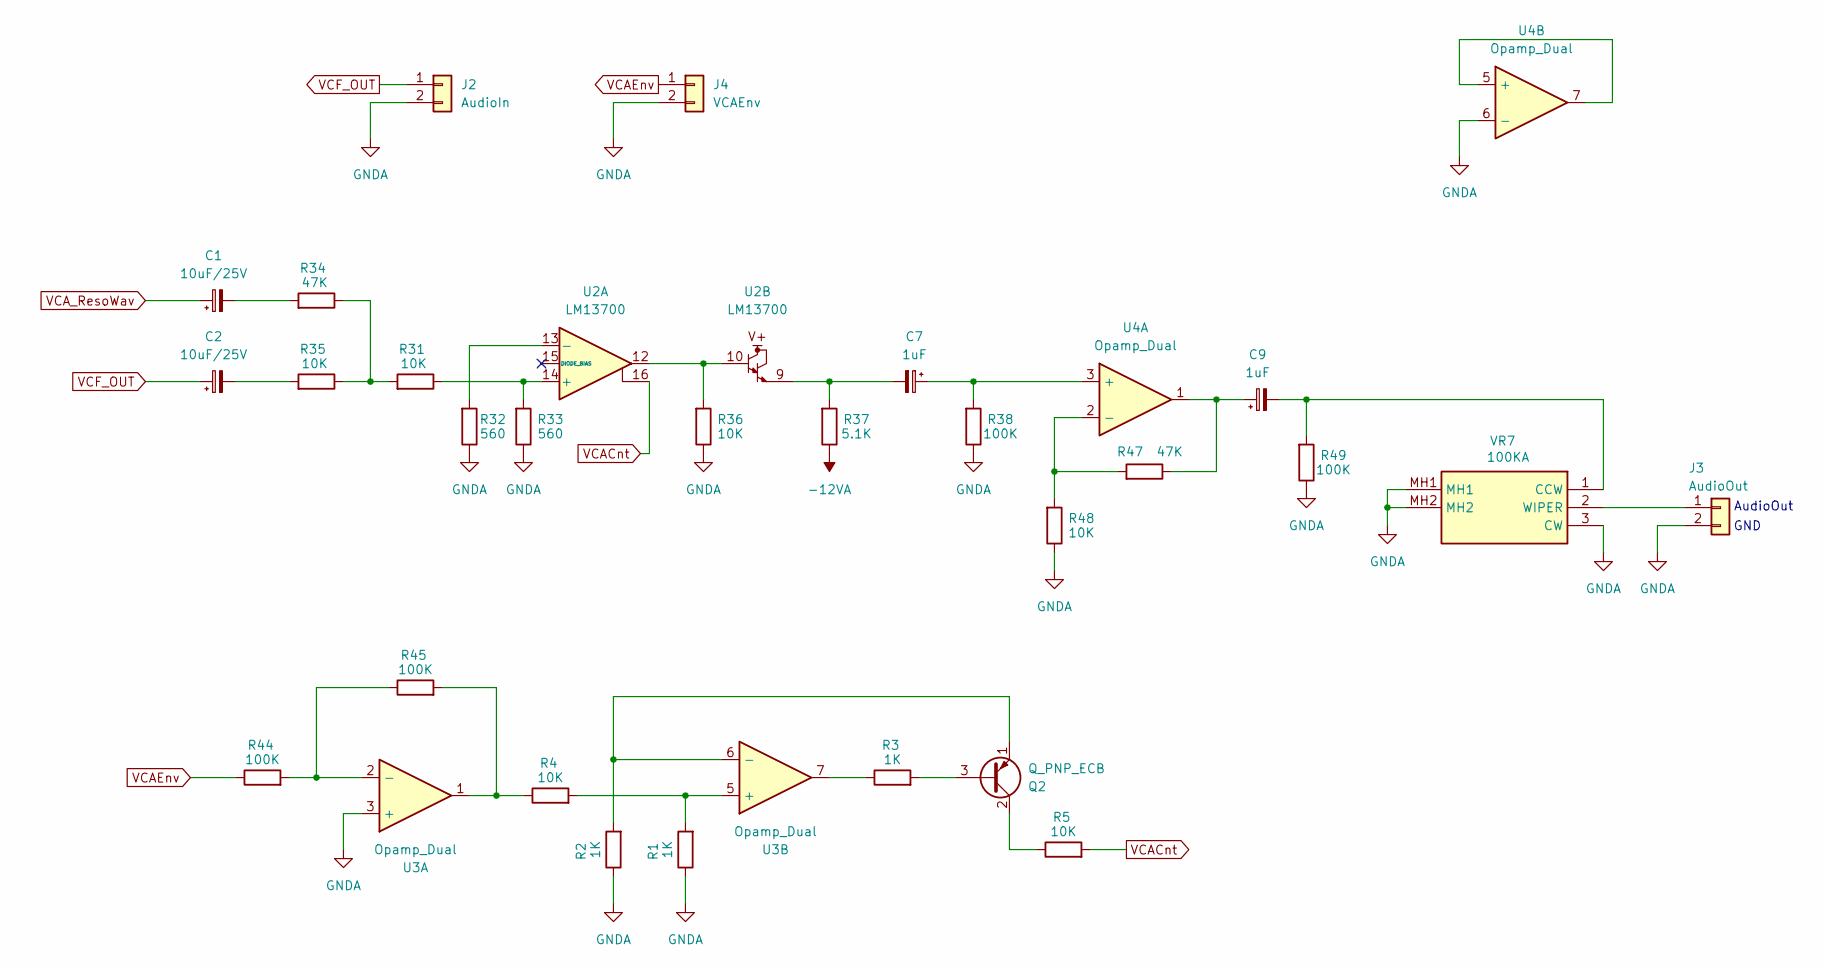
[picture p62: schematic VCA.kicad_sch]

Parts:
C1, C2: 10uF/25V; CP_Radial_D5.0mm_P2.50mm
C7, C9: 1uF; CP_Radial_D5.0mm_P2.50mm
J2: AudioIn; PinSocket_1x02_P2.54mm_Vertical
J3: AudioOut; PinHeader_1x02_P2.54mm_Vertical
J4: VCAEnv; PinSocket_1x02_P2.54mm_Vertical
Q2: Q_PNP_ECB; TO-92_HandSolder
R1, R2, R3: 1K; R_Axial_DIN0204_L3.6mm_D1.6mm_P7.62mm_Horizontal
R4, R5, R31, R35, R36, R48: 10K; R_Axial_DIN0204_L3.6mm_D1.6mm_P7.62mm_Horizontal
R32, R33: 560; R_Axial_DIN0204_L3.6mm_D1.6mm_P7.62mm_Horizontal
R34, R47: 47K; R_Axial_DIN0204_L3.6mm_D1.6mm_P7.62mm_Horizontal
R37: 5.1K; R_Axial_DIN0204_L3.6mm_D1.6mm_P7.62mm_Horizontal
R38, R44, R45, R49: 100K; R_Axial_DIN0204_L3.6mm_D1.6mm_P7.62mm_Horizontal
U2: LM13700; DIP-16_W7.62mm_LongPads
U3: Opamp_Dual; DIP-8_W7.62mm_LongPads
U4: Opamp_Dual; DIP-8_W7.62mm_Socket_LongPads
VR7: 100KA; RK09D117000B; Manufacturer_Part_Number RK09D117000B; Mouser Part Number 688-RK09D117000B

Connections:
-12VA: R37.1; also elsewhere on the board
GNDA: J2.2, J3.2, J4.2, R1.1, R2.1, R32.1, R33.1, R36.1, R38.1, R48.1, R49.1, U3.3 (+), U4.6 (-), VR7.3 (CW), VR7.MH1, VR7.MH2; also elsewhere on the board
unnamed: C1.2, R34.2
unnamed: C2.2, R35.2
unnamed: C7.2, R37.2, U2.9
unnamed: C9.1, R47.1, U4.1
unnamed: J3.1, VR7.2 (WIPER)
unnamed: Q2.3 (B), R3.2
unnamed: Q2.2 (C), R5.1
unnamed: Q2.1 (E), R2.2, U3.6 (-)
unnamed: R3.1, U3.7
unnamed: R4.1, R45.2, U3.1
unnamed: R31.2, R34.1, R35.1
unnamed: R36.2, U2.10, U2.12
unnamed: R31.1, R33.2, U2.14 (+)
unnamed: R32.2, U2.13 (-)
unnamed: R44.2, R45.1, U3.2 (-)
unnamed: R1.2, R4.2, U3.5 (+)
unnamed: C7.1, R38.2, U4.3 (+)
unnamed: R47.2, R48.2, U4.2 (-)
unnamed: U4.5 (+), U4.7
unnamed: C9.2, R49.2, VR7.1 (CCW)
VCACnt: R5.2, U2.16
VCAEnv: J4.1, R44.1
VCA_ResoWav: C1.1; also elsewhere on the board
VCF_OUT: C2.1, J2.1; also elsewhere on the board

Notes on the sheet:
GND
AudioOut

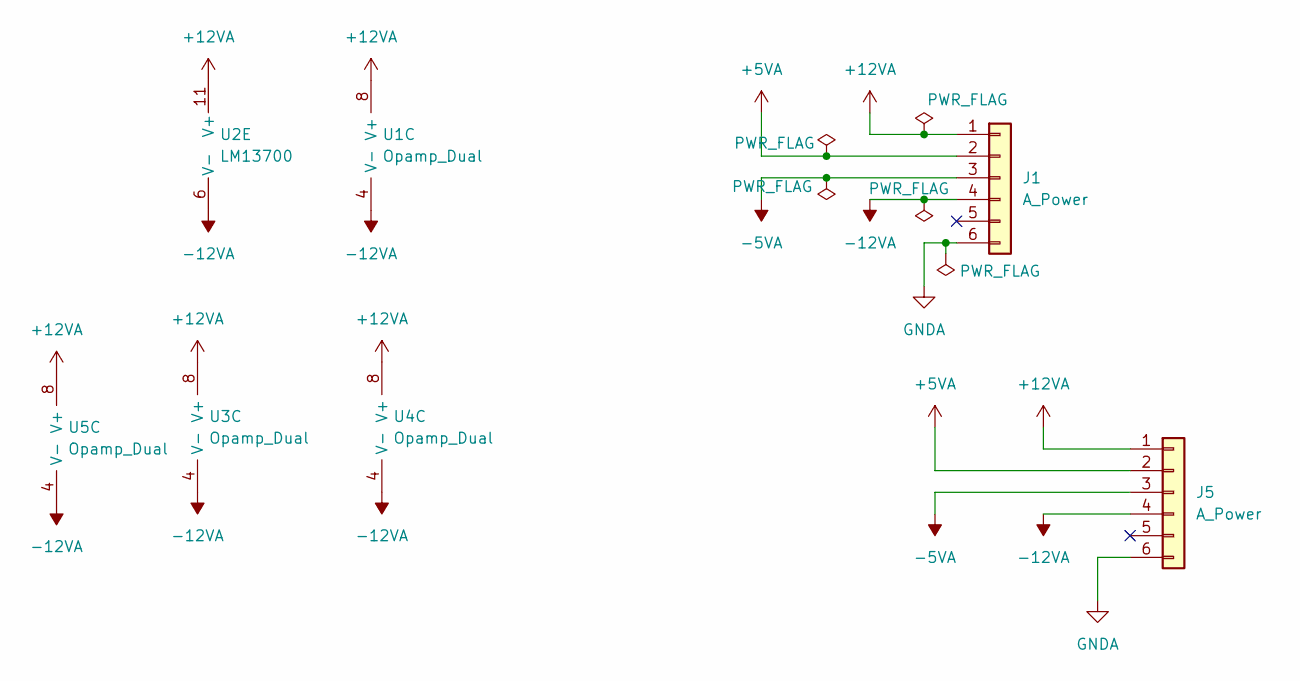
[picture p63: schematic VCF_VCA_Power.kicad_sch]

Parts:
J1, J5: A_Power; PinHeader_1x06_P2.54mm_Vertical
U1, U3: Opamp_Dual; DIP-8_W7.62mm_LongPads
U2: LM13700; DIP-16_W7.62mm_LongPads
U4, U5: Opamp_Dual; DIP-8_W7.62mm_Socket_LongPads

Connections:
+5VA: J1.2, J5.2; also elsewhere on the board
+12VA: J1.1, J5.1, U1.8 (V+), U2.11 (V+), U3.8 (V+), U4.8 (V+), U5.8 (V+)
-5VA: J1.3, J5.3
-12VA: J1.4, J5.4, U1.4 (V-), U2.6 (V-), U3.4 (V-), U4.4 (V-), U5.4 (V-); also elsewhere on the board
GNDA: J1.6, J5.6; also elsewhere on the board

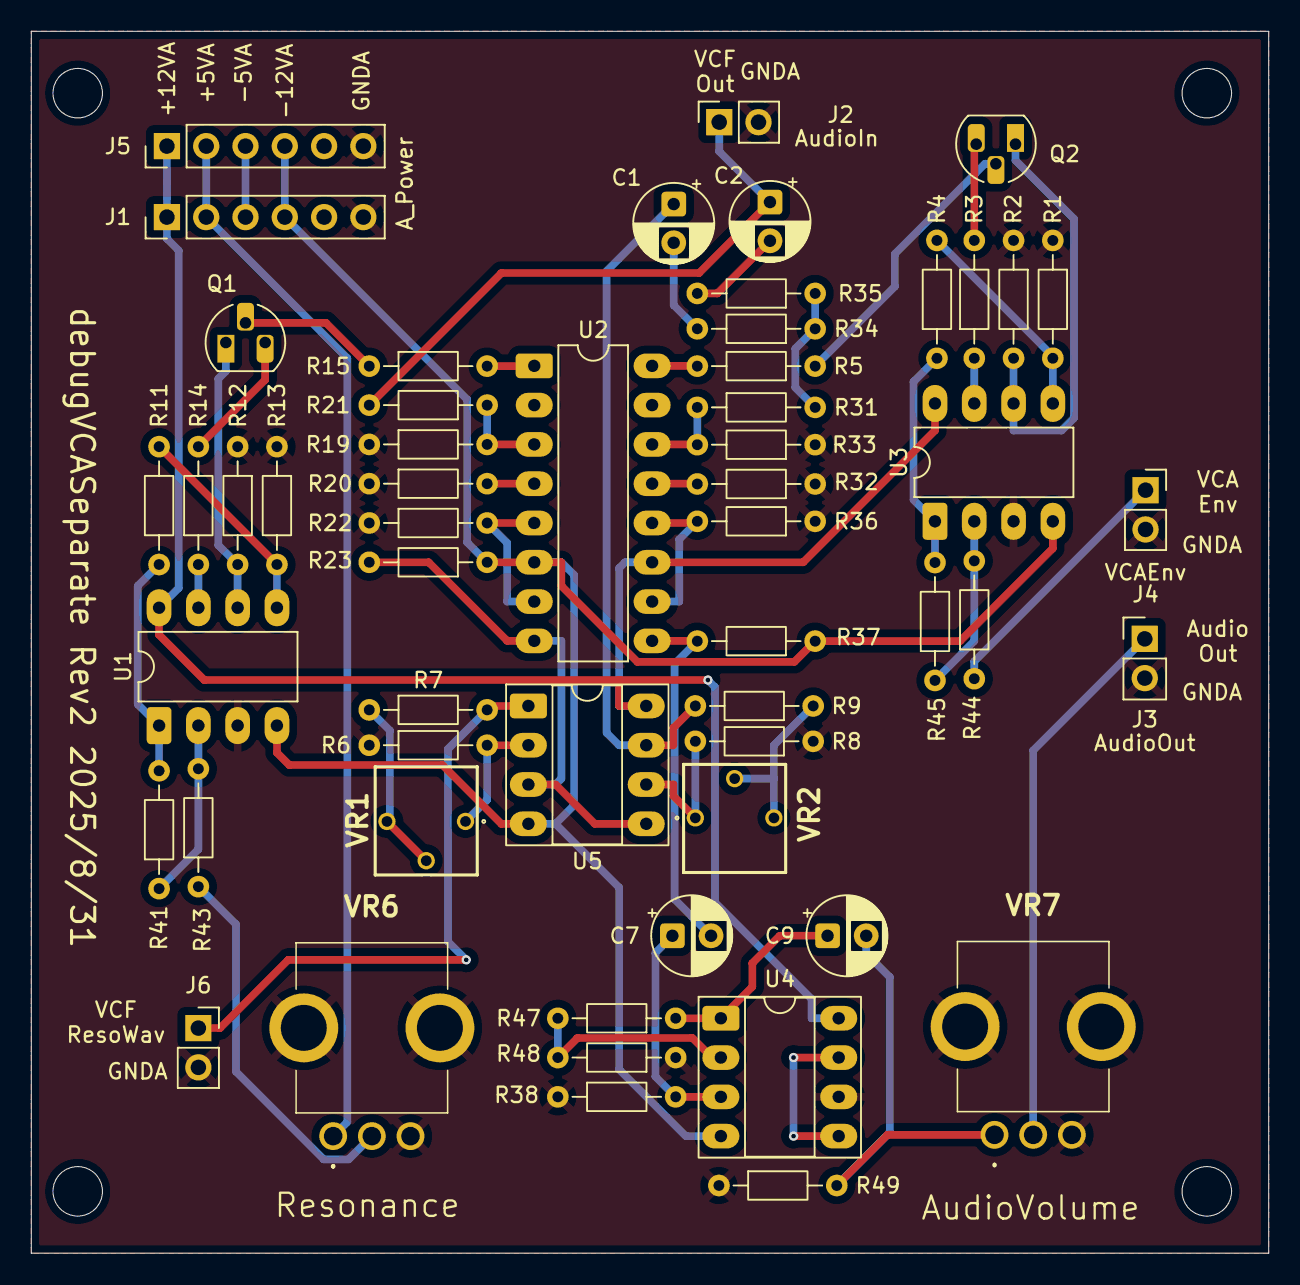
[picture p64: board debugVCASeparate.kicad_pcb from above]

Board: 2 copper layers, 80.0 x 79.0 mm, 55 parts (0 on the bottom side), 47 nets.
