wakimizufu/MC2/debugVCFSeparate/debugVCFSeparate.kicad_pcb

## KiCad design debugVCFSeparate/debugVCFSeparate.kicad_pcb (2025-08-31)

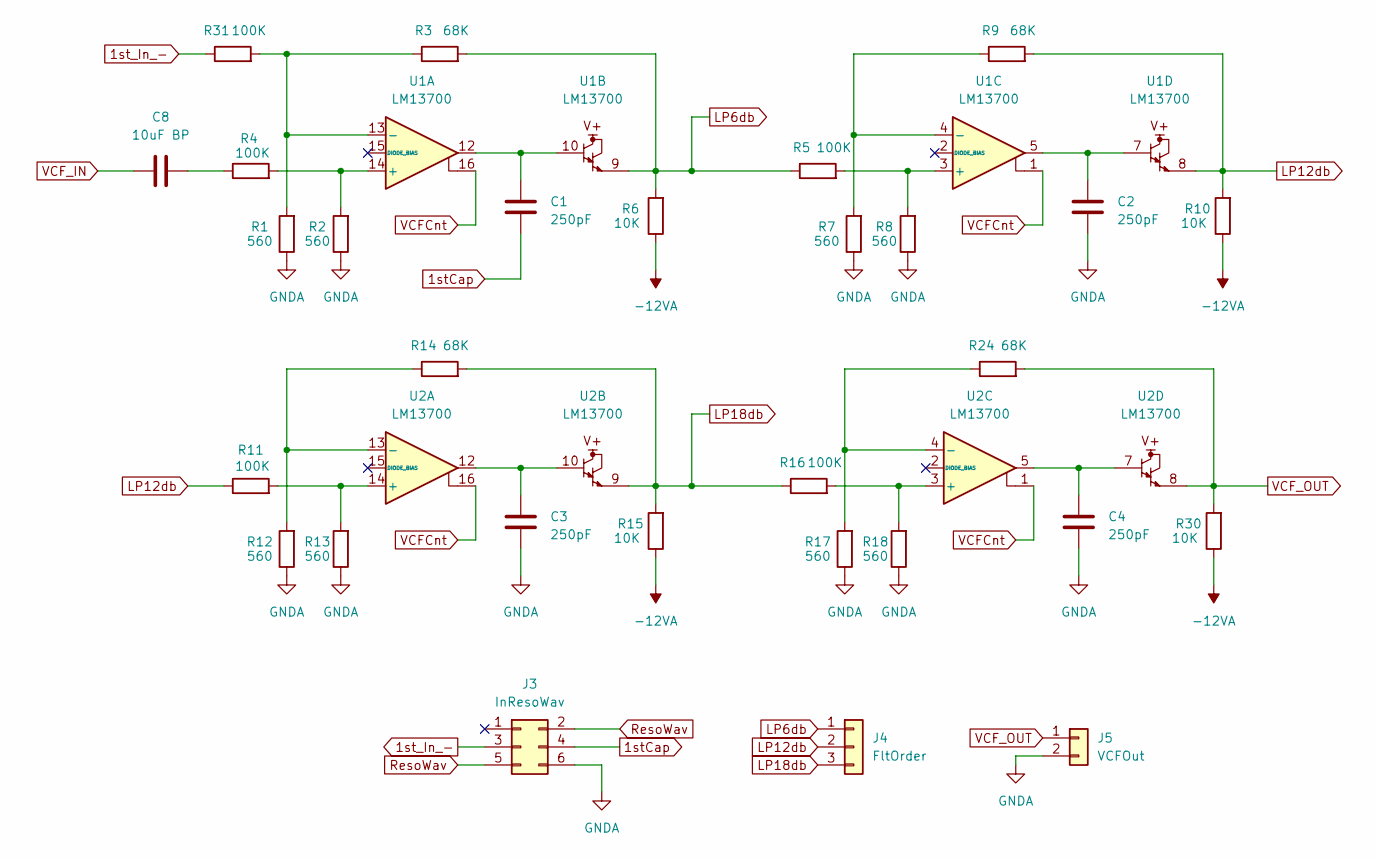
[picture p65: schematic VCF.kicad_sch]

Parts:
C1, C2, C3, C4: 250pF; C_Disc_D4.7mm_W2.5mm_P5.00mm
C8: 10uF BP; C_Radial_D5.0mm_H5.0mm_P2.00mm
J3: InResoWav; PinHeader_2x03_P2.54mm_Vertical
J4: FltOrder; PinSocket_1x03_P2.54mm_Vertical
J5: VCFOut; PinHeader_1x02_P2.54mm_Vertical
R1, R2, R7, R8, R12, R13, R17, R18: 560; R_Axial_DIN0204_L3.6mm_D1.6mm_P7.62mm_Horizontal
R3, R9, R14, R24: 68K; R_Axial_DIN0204_L3.6mm_D1.6mm_P7.62mm_Horizontal
R4, R5, R11, R16, R31: 100K; R_Axial_DIN0204_L3.6mm_D1.6mm_P7.62mm_Horizontal
R6, R10, R15, R30: 10K; R_Axial_DIN0204_L3.6mm_D1.6mm_P7.62mm_Horizontal
U1, U2: LM13700; DIP-16_W7.62mm_Socket_LongPads

Connections:
1stCap: C1.2, J3.4
1st_In_-: J3.3, R31.1
-12VA: R6.1, R10.1, R15.1, R30.1; also elsewhere on the board
GNDA: C2.2, C3.2, C4.2, J3.6, J5.2, R1.1, R2.1, R7.1, R8.1, R12.1, R13.1, R17.1, R18.1; also elsewhere on the board
LP6db: J4.1, R3.2, R5.1, R6.2, U1.9
LP12db: J4.2, R9.2, R10.2, R11.1, U1.8
LP18db: J4.3, R14.2, R15.2, R16.1, U2.9
unnamed: C1.1, U1.10, U1.12
unnamed: C2.1, U1.5, U1.7
unnamed: C3.1, U2.10, U2.12
unnamed: C4.1, U2.5, U2.7
unnamed: C8.2, R4.1
unnamed: R2.2, R4.2, U1.14 (+)
unnamed: R1.2, R3.1, R31.2, U1.13 (-)
unnamed: R5.2, R8.2, U1.3 (+)
unnamed: R7.2, R9.1, U1.4 (-)
unnamed: R11.2, R13.2, U2.14 (+)
unnamed: R12.2, R14.1, U2.13 (-)
unnamed: R16.2, R18.2, U2.3 (+)
unnamed: R17.2, R24.1, U2.4 (-)
ResoWav: J3.2, J3.5; also elsewhere on the board
VCFCnt: U1.1, U1.16, U2.1, U2.16; also elsewhere on the board
VCF_IN: C8.1; also elsewhere on the board
VCF_OUT: J5.1, R24.2, R30.2, U2.8

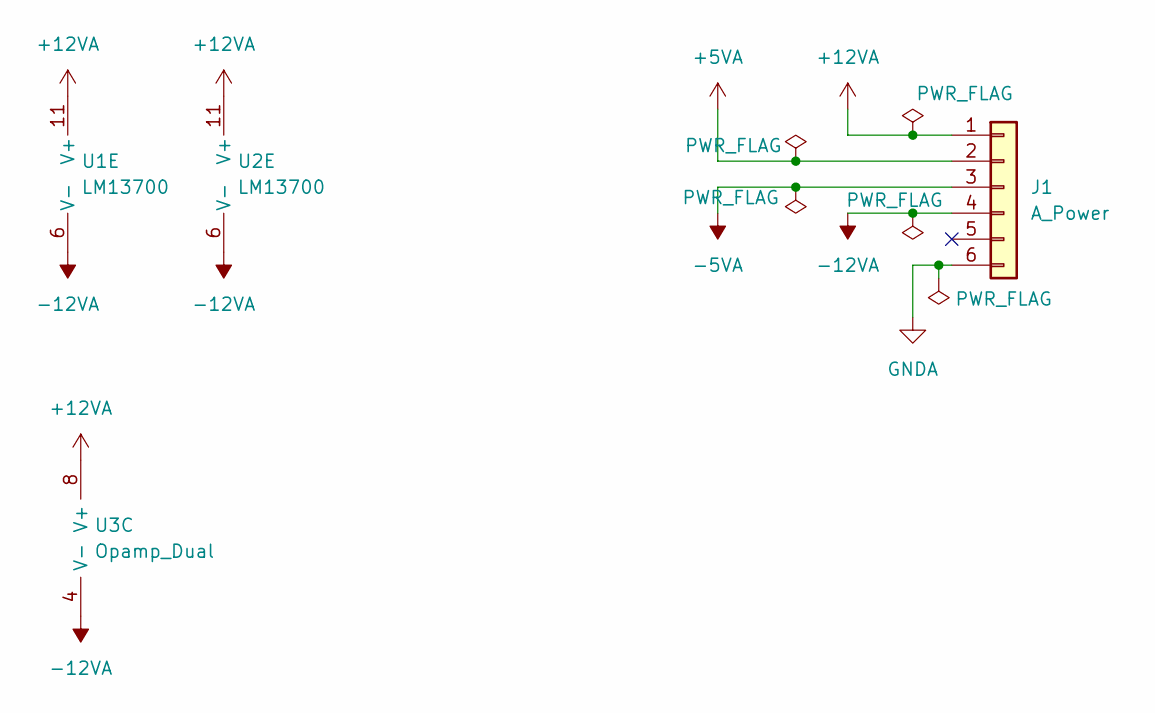
[picture p66: schematic VCF_VCA_Power.kicad_sch]

Parts:
J1: A_Power; PinHeader_1x06_P2.54mm_Vertical
U1, U2: LM13700; DIP-16_W7.62mm_Socket_LongPads
U3: Opamp_Dual; DIP-8_W7.62mm_Socket_LongPads

Connections:
+5VA: J1.2; also elsewhere on the board
+12VA: J1.1, U1.11 (V+), U2.11 (V+), U3.8 (V+); also elsewhere on the board
-5VA: J1.3
-12VA: J1.4, U1.6 (V-), U2.6 (V-), U3.4 (V-); also elsewhere on the board
GNDA: J1.6; also elsewhere on the board

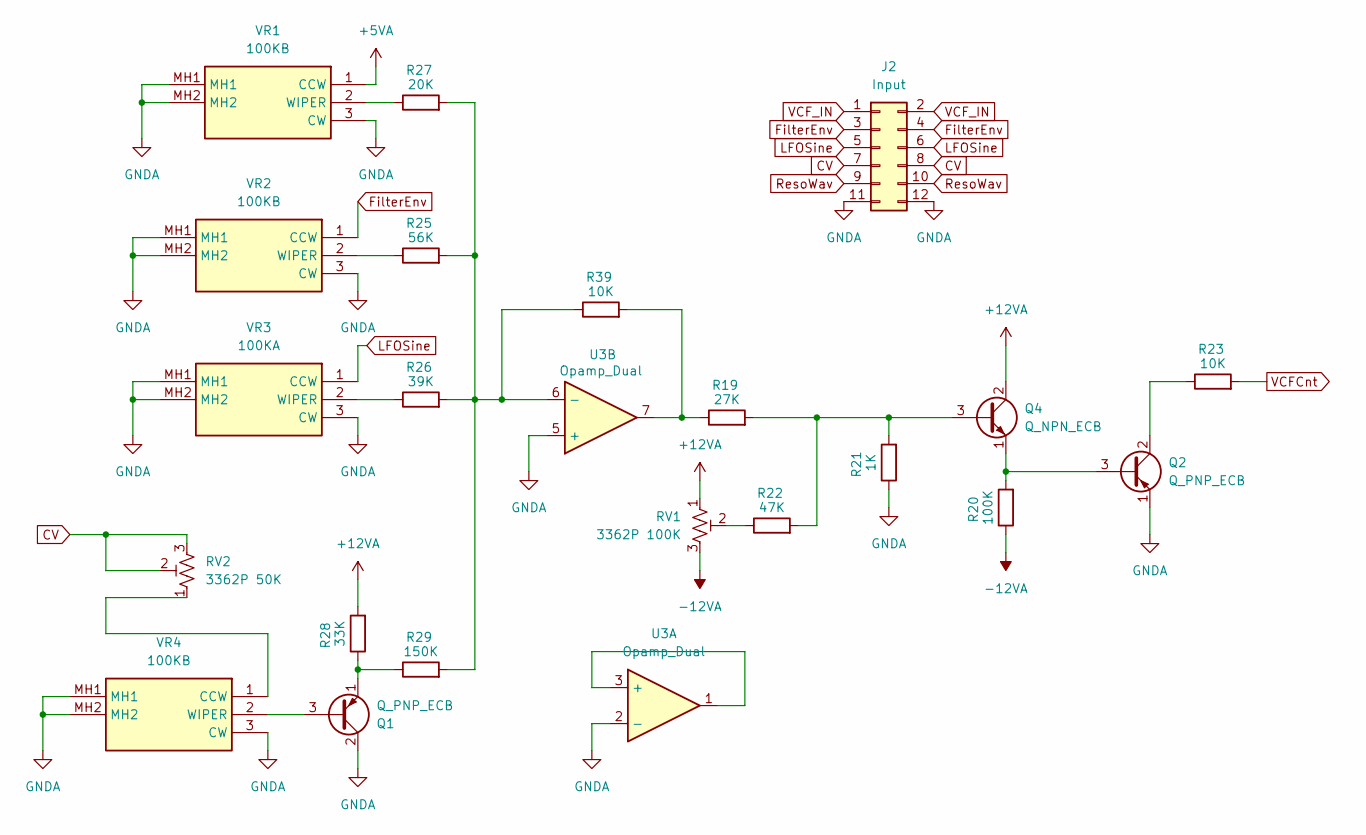
[picture p67: schematic CVMixer.kicad_sch]

Parts:
J2: Input; PinSocket_2x06_P2.54mm_Vertical
Q1, Q2: Q_PNP_ECB; TO-92_HandSolder
Q4: Q_NPN_ECB; TO-92_HandSolder
R19: 27K; R_Axial_DIN0204_L3.6mm_D1.6mm_P7.62mm_Horizontal
R20: 100K; R_Axial_DIN0204_L3.6mm_D1.6mm_P7.62mm_Horizontal
R21: 1K; R_Axial_DIN0204_L3.6mm_D1.6mm_P7.62mm_Horizontal
R22: 47K; R_Axial_DIN0204_L3.6mm_D1.6mm_P7.62mm_Horizontal
R23, R39: 10K; R_Axial_DIN0204_L3.6mm_D1.6mm_P7.62mm_Horizontal
R25: 56K; R_Axial_DIN0204_L3.6mm_D1.6mm_P7.62mm_Horizontal
R26: 39K; R_Axial_DIN0204_L3.6mm_D1.6mm_P7.62mm_Horizontal
R27: 20K; R_Axial_DIN0204_L3.6mm_D1.6mm_P7.62mm_Horizontal
R28: 33K; R_Axial_DIN0204_L3.6mm_D1.6mm_P7.62mm_Horizontal
R29: 150K; R_Axial_DIN0204_L3.6mm_D1.6mm_P7.62mm_Horizontal
RV1: 3362P 100K; Potentiometer_Bourns_3386P_Vertical
RV2: 3362P 50K; Potentiometer_Bourns_3386P_Vertical
U3: Opamp_Dual; DIP-8_W7.62mm_Socket_LongPads
VR1, VR2, VR4: 100KB; RK09D117000B; Manufacturer_Part_Number RK09D117000B; Mouser Part Number 688-RK09D117000B
VR3: 100KA; RK09D117000B; Manufacturer_Part_Number RK09D117000B; Mouser Part Number 688-RK09D117000B

Connections:
+5VA: VR1.1 (CCW); also elsewhere on the board
+12VA: Q4.2 (C), R28.2, RV1.1; also elsewhere on the board
-12VA: R20.1, RV1.3; also elsewhere on the board
CV: J2.7, J2.8, RV2.2, RV2.3
FilterEnv: J2.3, J2.4, VR2.1 (CCW)
GNDA: J2.11, J2.12, Q1.2 (C), Q2.1 (E), R21.1, U3.2 (-), U3.5 (+), VR1.3 (CW), VR1.MH1, VR1.MH2, VR2.3 (CW), VR2.MH1, VR2.MH2, VR3.3 (CW), VR3.MH1, VR3.MH2, VR4.3 (CW), VR4.MH1, VR4.MH2; also elsewhere on the board
LFOSine: J2.5, J2.6, VR3.1 (CCW)
unnamed: Q1.3 (B), VR4.2 (WIPER)
unnamed: Q1.1 (E), R28.1, R29.1
unnamed: Q2.3 (B), Q4.1 (E), R20.2
unnamed: Q2.2 (C), R23.1
unnamed: Q4.3 (B), R19.2, R21.2, R22.2
unnamed: R19.1, R39.2, U3.7
unnamed: R22.1, RV1.2
unnamed: U3.1, U3.3 (+)
unnamed: R25.2, R26.2, R27.2, R29.2, R39.1, U3.6 (-)
unnamed: R27.1, VR1.2 (WIPER)
unnamed: R25.1, VR2.2 (WIPER)
unnamed: R26.1, VR3.2 (WIPER)
unnamed: RV2.1, VR4.1 (CCW)
ResoWav: J2.9, J2.10; also elsewhere on the board
VCFCnt: R23.2; also elsewhere on the board
VCF_IN: J2.1, J2.2; also elsewhere on the board

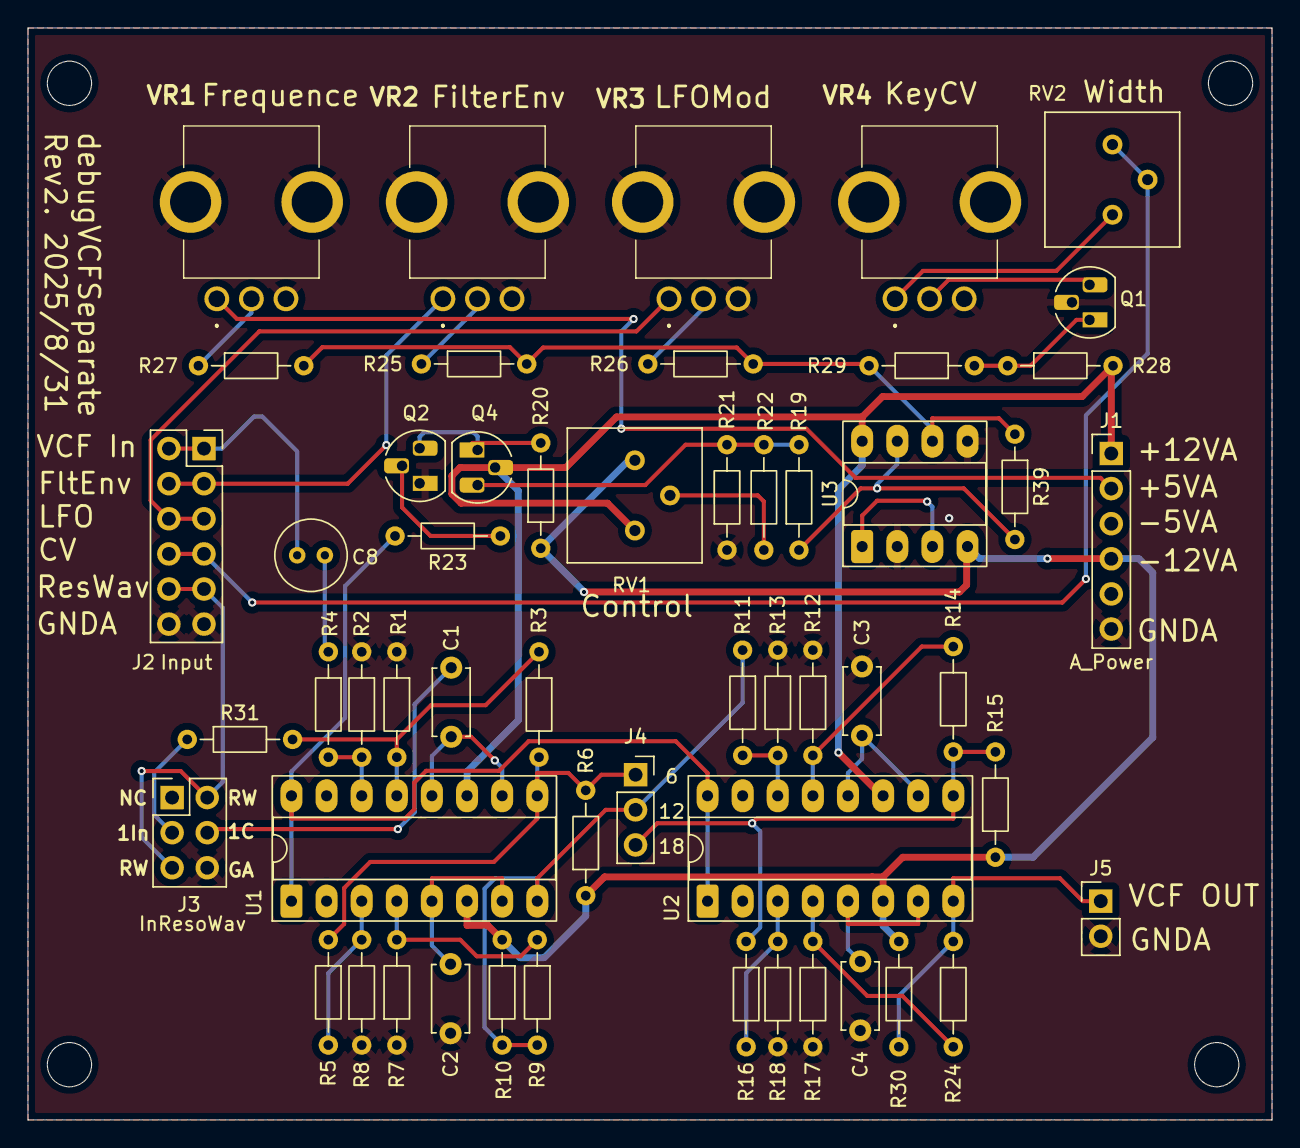
[picture p68: board debugVCFSeparate.kicad_pcb from above]

Board: 2 copper layers, 90.0 x 79.0 mm, 54 parts (0 on the bottom side), 42 nets.
