wakimizufu/MC2/VCFSeparate/VCFSeparate.kicad_pcb

## KiCad design VCFSeparate/VCFSeparate.kicad_pcb (2025-08-16)

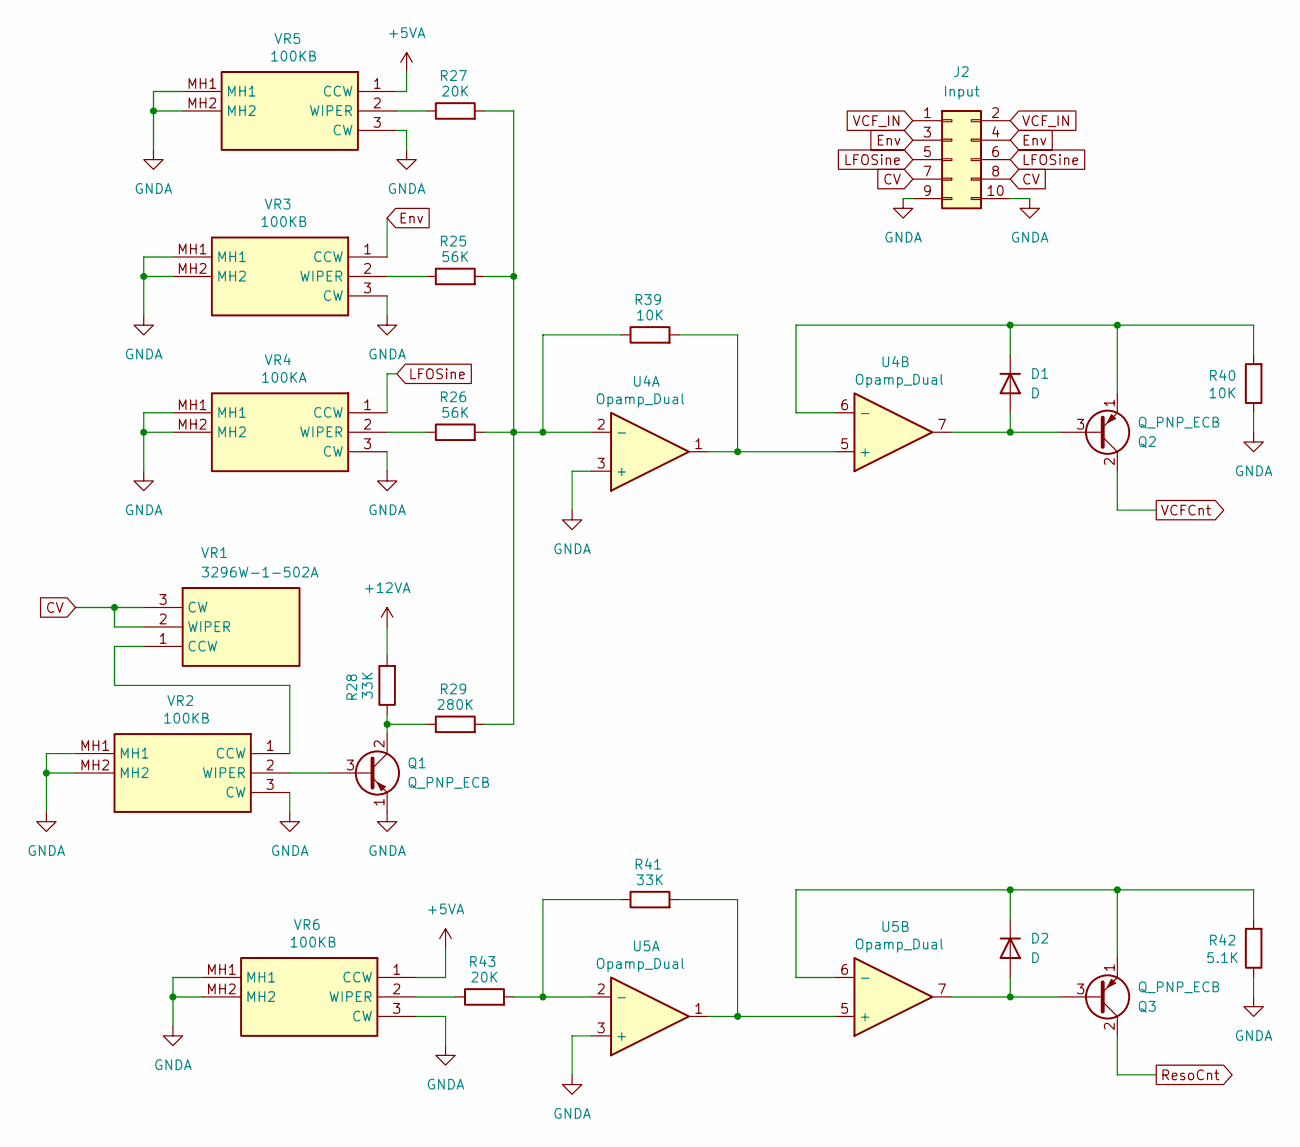
[picture p69: schematic CVMixer.kicad_sch]

Parts:
D1, D2: D; D_DO-35_SOD27_P2.54mm_Vertical_AnodeUp
J2: Input; PinSocket_2x05_P2.54mm_Vertical
Q1, Q2, Q3: Q_PNP_ECB; TO-92_HandSolder
R25, R26: 56K; R_Axial_DIN0204_L3.6mm_D1.6mm_P2.54mm_Vertical
R27, R43: 20K; R_Axial_DIN0204_L3.6mm_D1.6mm_P2.54mm_Vertical
R28, R41: 33K; R_Axial_DIN0204_L3.6mm_D1.6mm_P2.54mm_Vertical
R29: 280K; R_Axial_DIN0204_L3.6mm_D1.6mm_P2.54mm_Vertical
R39, R40: 10K; R_Axial_DIN0204_L3.6mm_D1.6mm_P2.54mm_Vertical
R42: 5.1K; R_Axial_DIN0204_L3.6mm_D1.6mm_P2.54mm_Vertical
U4, U5: Opamp_Dual; SO-8_3.9x4.9mm_P1.27mm
VR1: 3296W-1-502A; 3296W1502A; Manufacturer_Part_Number 3296W-1-502A; Mouser Part Number 652-3296W-1-502A
VR2, VR3, VR5, VR6: 100KB; RK09D117000B; Manufacturer_Part_Number RK09D117000B; Mouser Part Number 688-RK09D117000B
VR4: 100KA; RK09D117000B; Manufacturer_Part_Number RK09D117000B; Mouser Part Number 688-RK09D117000B

Connections:
+5VA: VR5.1 (CCW), VR6.1 (CCW); also elsewhere on the board
+12VA: R28.2; also elsewhere on the board
CV: J2.7, J2.8, VR1.2 (WIPER), VR1.3 (CW)
FilterEnv: J2.3, J2.4, VR3.1 (CCW)
LFOSine: J2.5, J2.6, VR4.1 (CCW)
unnamed: D1.2 (A), Q2.3 (B), U4.7
unnamed: D1.1 (K), Q2.1 (E), R40.2, U4.6 (-)
unnamed: D2.2 (A), Q3.3 (B), U5.7
unnamed: D2.1 (K), Q3.1 (E), R42.2, U5.6 (-)
unnamed: Q1.3 (B), VR2.2 (WIPER)
unnamed: Q1.2 (C), R28.1, R29.1
unnamed: R25.2, R26.2, R27.2, R29.2, R39.1, U4.2 (-)
unnamed: R39.2, U4.1, U4.5 (+)
unnamed: R41.1, R43.2, U5.2 (-)
unnamed: R41.2, U5.1, U5.5 (+)
unnamed: VR1.1 (CCW), VR2.1 (CCW)
unnamed: R25.1, VR3.2 (WIPER)
unnamed: R26.1, VR4.2 (WIPER)
unnamed: R27.1, VR5.2 (WIPER)
unnamed: R43.1, VR6.2 (WIPER)
ResoCnt: Q3.2 (C); also elsewhere on the board
VCFCnt: Q2.2 (C); also elsewhere on the board
VCF_IN: J2.1, J2.2; also elsewhere on the board

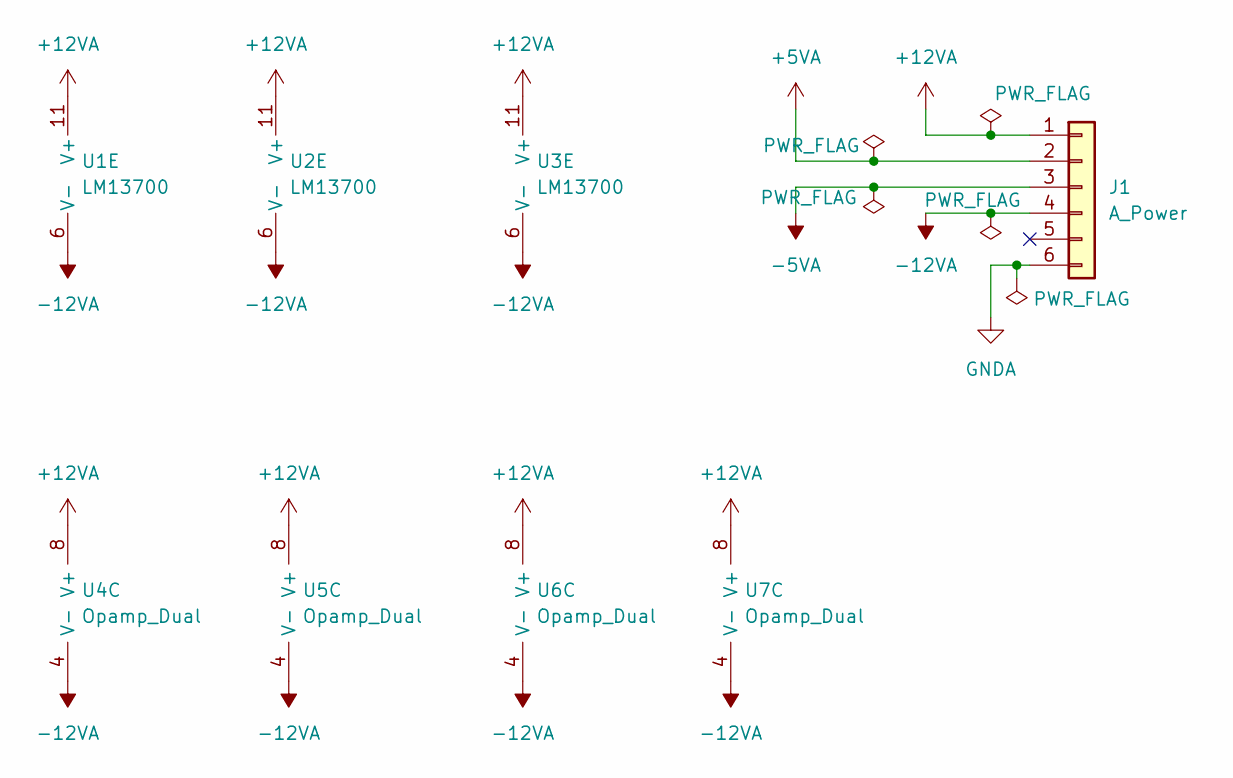
[picture p70: schematic VCF_VCA_Power.kicad_sch]

Parts:
J1: A_Power; PinHeader_1x06_P2.54mm_Vertical
U1, U3: LM13700; SOIC-16_3.9x9.9mm_P1.27mm
U2: LM13700
U4, U5, U6, U7: Opamp_Dual; SO-8_3.9x4.9mm_P1.27mm

Connections:
+5VA: J1.2; also elsewhere on the board
+12VA: J1.1, U1.11 (V+), U2.11 (V+), U3.11 (V+), U4.8 (V+), U5.8 (V+), U6.8 (V+), U7.8 (V+); also elsewhere on the board
-5VA: J1.3
-12VA: J1.4, U1.6 (V-), U2.6 (V-), U3.6 (V-), U4.4 (V-), U5.4 (V-), U6.4 (V-), U7.4 (V-); also elsewhere on the board

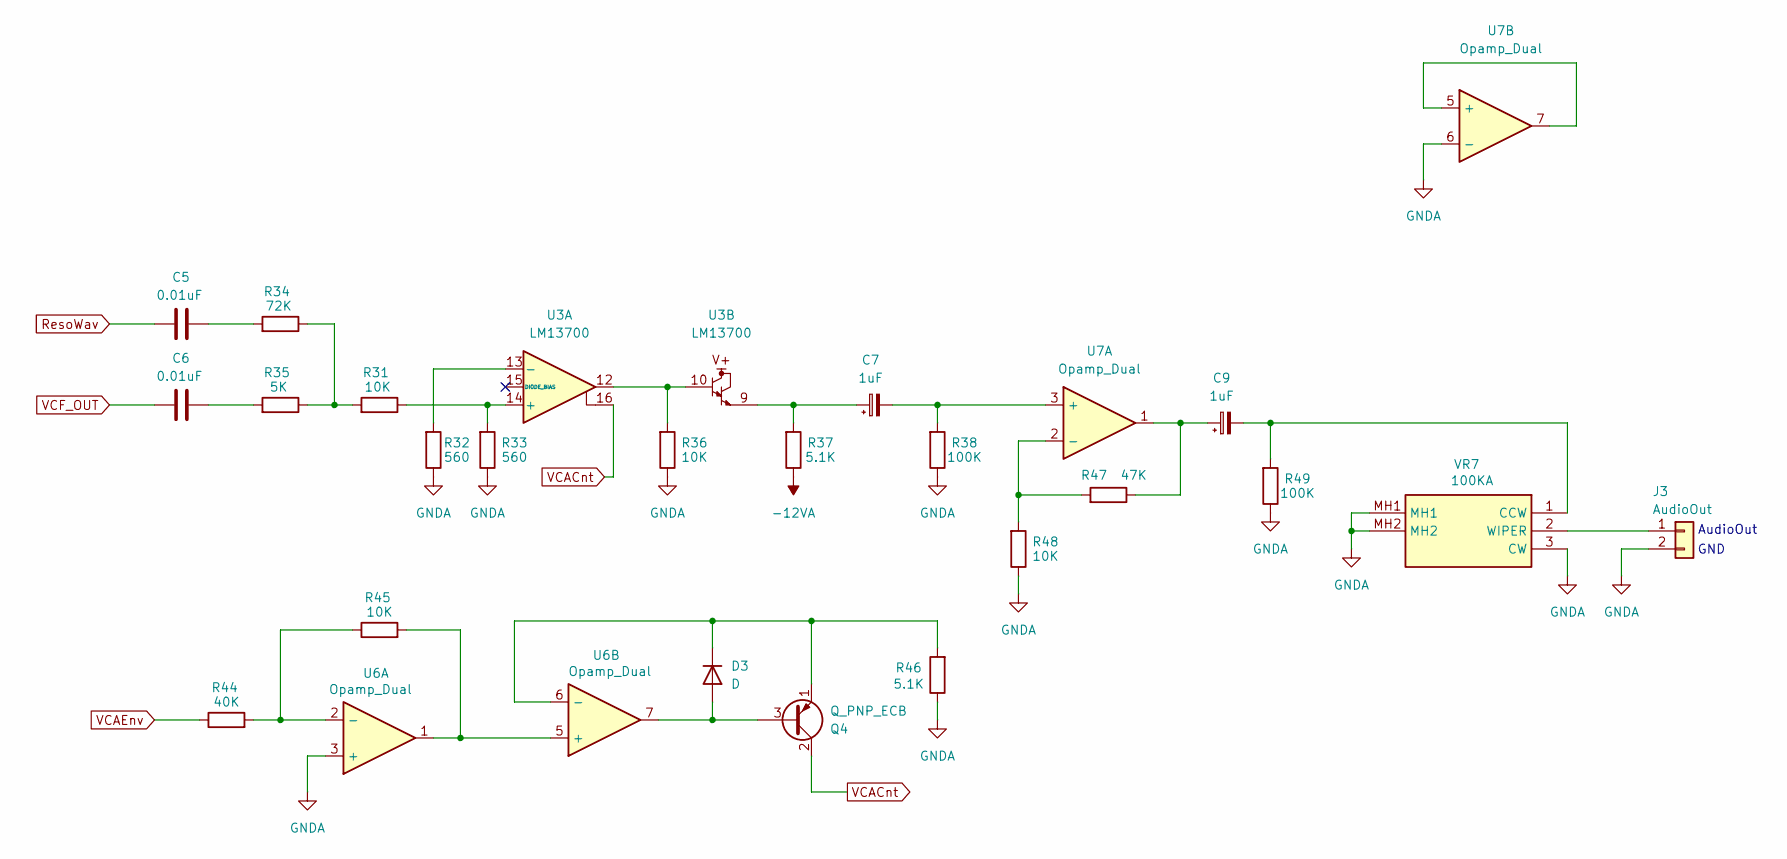
[picture p71: schematic VCA.kicad_sch]

Parts:
C5, C6: 0.01uF; C_Disc_D3.4mm_W2.1mm_P2.50mm
C7, C9: 1uF; CP_Radial_D5.0mm_P2.50mm
D3: D; D_DO-35_SOD27_P2.54mm_Vertical_AnodeUp
J3: AudioOut; PinHeader_1x02_P2.54mm_Vertical
Q4: Q_PNP_ECB; TO-92_HandSolder
R31, R36, R45, R48: 10K; R_Axial_DIN0204_L3.6mm_D1.6mm_P2.54mm_Vertical
R32, R33: 560; R_Axial_DIN0204_L3.6mm_D1.6mm_P2.54mm_Vertical
R34: 72K; R_Axial_DIN0204_L3.6mm_D1.6mm_P2.54mm_Vertical
R35: 5K; R_Axial_DIN0204_L3.6mm_D1.6mm_P2.54mm_Vertical
R37, R46: 5.1K; R_Axial_DIN0204_L3.6mm_D1.6mm_P2.54mm_Vertical
R38, R49: 100K; R_Axial_DIN0204_L3.6mm_D1.6mm_P2.54mm_Vertical
R44: 40K; R_Axial_DIN0204_L3.6mm_D1.6mm_P2.54mm_Vertical
R47: 47K; R_Axial_DIN0204_L3.6mm_D1.6mm_P2.54mm_Vertical
U3: LM13700; SOIC-16_3.9x9.9mm_P1.27mm
U6, U7: Opamp_Dual; SO-8_3.9x4.9mm_P1.27mm
VR7: 100KA; RK09D117000B; Manufacturer_Part_Number RK09D117000B; Mouser Part Number 688-RK09D117000B

Connections:
-12VA: R37.1; also elsewhere on the board
unnamed: C5.2, R34.2
unnamed: C6.2, R35.2
unnamed: C7.1, R37.2, U3.9
unnamed: C9.1, R47.1, U7.1
unnamed: D3.2 (A), Q4.3 (B), U6.7
unnamed: D3.1 (K), Q4.1 (E), R46.2, U6.6 (-)
unnamed: J3.1, VR7.2 (WIPER)
unnamed: R31.2, R34.1, R35.1
unnamed: R36.2, U3.10, U3.12
unnamed: R31.1, R33.2, U3.14 (+)
unnamed: R32.2, U3.13 (-)
unnamed: R44.2, R45.1, U6.2 (-)
unnamed: R45.2, U6.1, U6.5 (+)
unnamed: C7.2, R38.2, U7.3 (+)
unnamed: R47.2, R48.2, U7.2 (-)
unnamed: U7.5 (+), U7.7
unnamed: C9.2, R49.2, VR7.1 (CCW)
ResoWav: C5.1; also elsewhere on the board
VCACnt: Q4.2 (C), U3.16
VCF_OUT: C6.1; also elsewhere on the board

Notes on the sheet:
GND
AudioOut

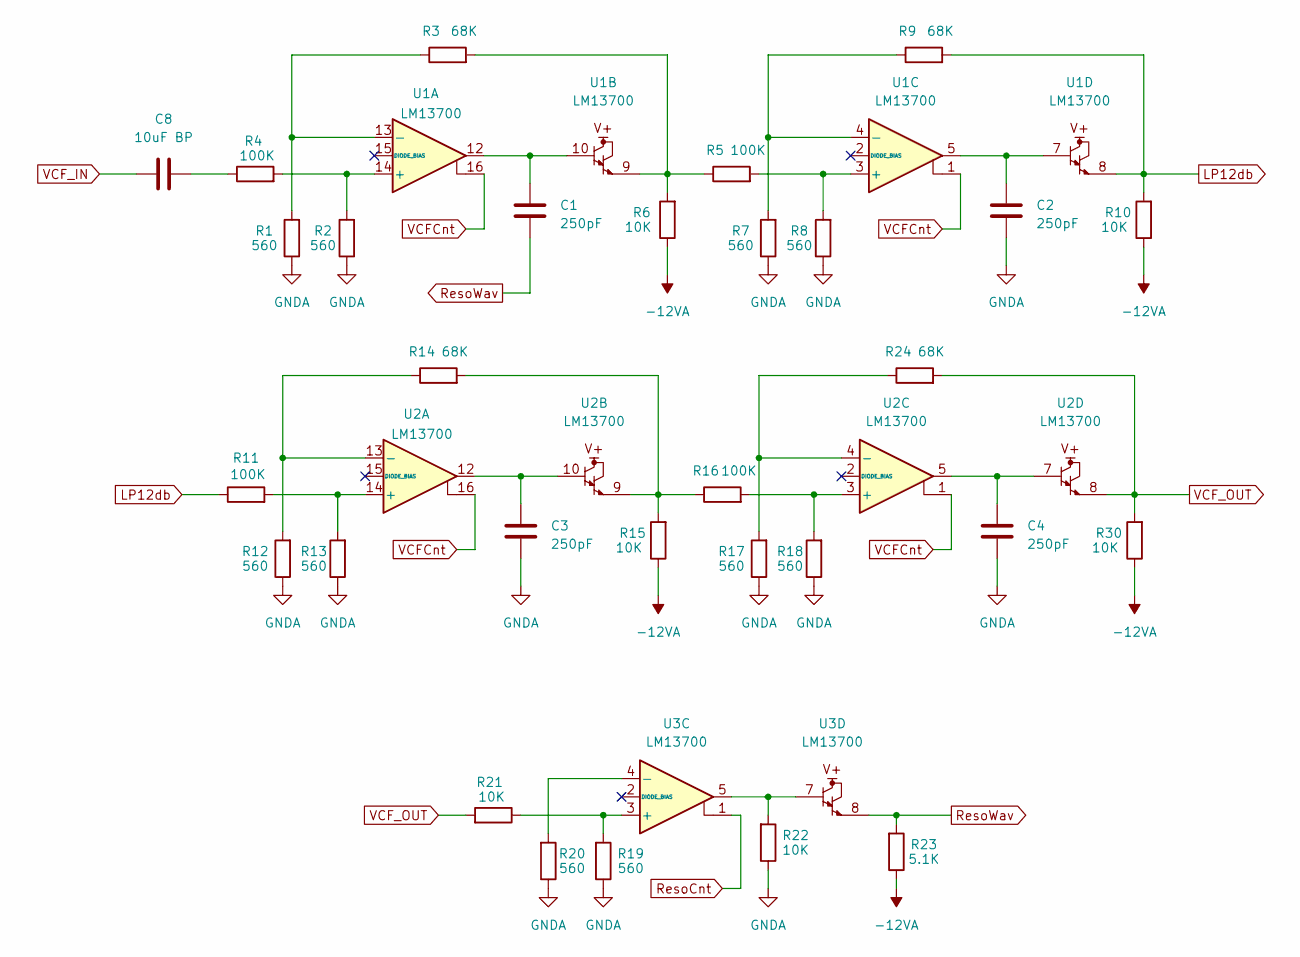
[picture p72: schematic VCF.kicad_sch]

Parts:
C1, C2, C3, C4: 250pF; C_Disc_D3.4mm_W2.1mm_P2.50mm
C8: 10uF BP; C_Radial_D5.0mm_H5.0mm_P2.00mm
R1, R2, R7, R8, R12, R13, R17, R18, R19, R20: 560; R_Axial_DIN0204_L3.6mm_D1.6mm_P2.54mm_Vertical
R3, R9, R14, R24: 68K; R_Axial_DIN0204_L3.6mm_D1.6mm_P2.54mm_Vertical
R4, R5, R11, R16: 100K; R_Axial_DIN0204_L3.6mm_D1.6mm_P2.54mm_Vertical
R6, R10, R15, R21, R22, R30: 10K; R_Axial_DIN0204_L3.6mm_D1.6mm_P2.54mm_Vertical
R23: 5.1K; R_Axial_DIN0204_L3.6mm_D1.6mm_P2.54mm_Vertical
U1, U3: LM13700; SOIC-16_3.9x9.9mm_P1.27mm
U2: LM13700

Connections:
-12VA: R6.1, R10.1, R15.1, R23.1, R30.1; also elsewhere on the board
LP12db: R9.2, R10.2, R11.1, U1.8
unnamed: C1.1, U1.10, U1.12
unnamed: C2.1, U1.5, U1.7
unnamed: C3.1, U2.10, U2.12
unnamed: C4.1, U2.5, U2.7
unnamed: C8.2, R4.1
unnamed: R3.2, R5.1, R6.2, U1.9
unnamed: R14.2, R15.2, R16.1, U2.9
unnamed: R22.2, U3.5, U3.7
unnamed: R2.2, R4.2, U1.14 (+)
unnamed: R1.2, R3.1, U1.13 (-)
unnamed: R5.2, R8.2, U1.3 (+)
unnamed: R7.2, R9.1, U1.4 (-)
unnamed: R11.2, R13.2, U2.14 (+)
unnamed: R12.2, R14.1, U2.13 (-)
unnamed: R16.2, R18.2, U2.3 (+)
unnamed: R17.2, R24.1, U2.4 (-)
unnamed: R19.2, R21.1, U3.3 (+)
unnamed: R20.2, U3.4 (-)
ResoCnt: U3.1; also elsewhere on the board
ResoWav: C1.2, R23.2, U3.8; also elsewhere on the board
VCFCnt: U1.1, U1.16, U2.1, U2.16; also elsewhere on the board
VCF_IN: C8.1; also elsewhere on the board
VCF_OUT: R21.2, R24.2, R30.2, U2.8; also elsewhere on the board

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
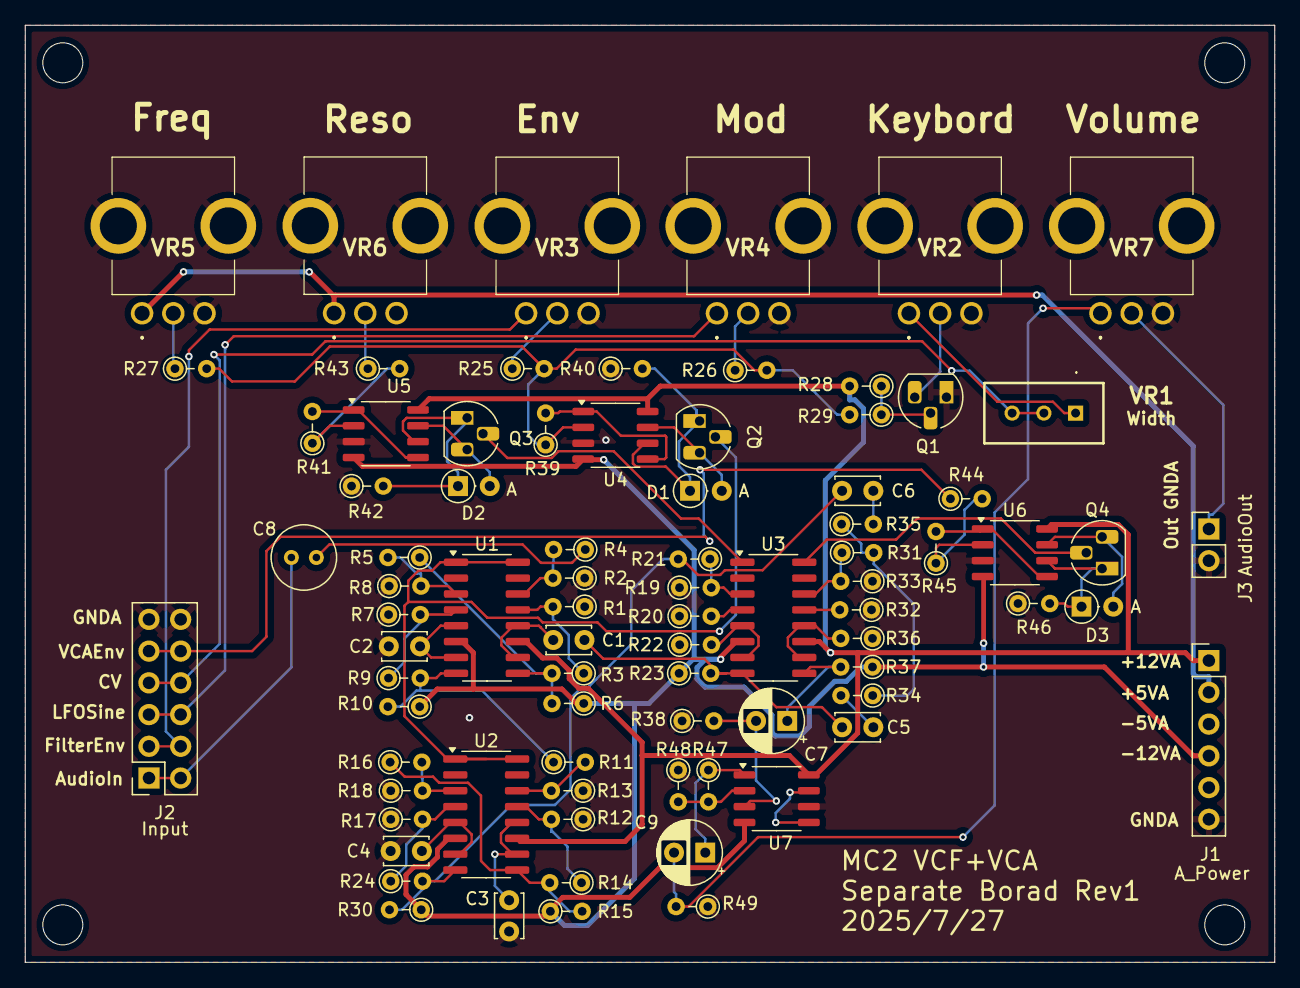
[picture p73: board VCFSeparate.kicad_pcb from above]

Board: 2 copper layers, 100.0 x 75.0 mm, 82 parts (0 on the bottom side), 65 nets.
