wakimizufu/MC2/LFOSeparate/LFOSeparate.kicad_pcb

## KiCad design LFOSeparate/LFOSeparate.kicad_pcb (2025-08-16)

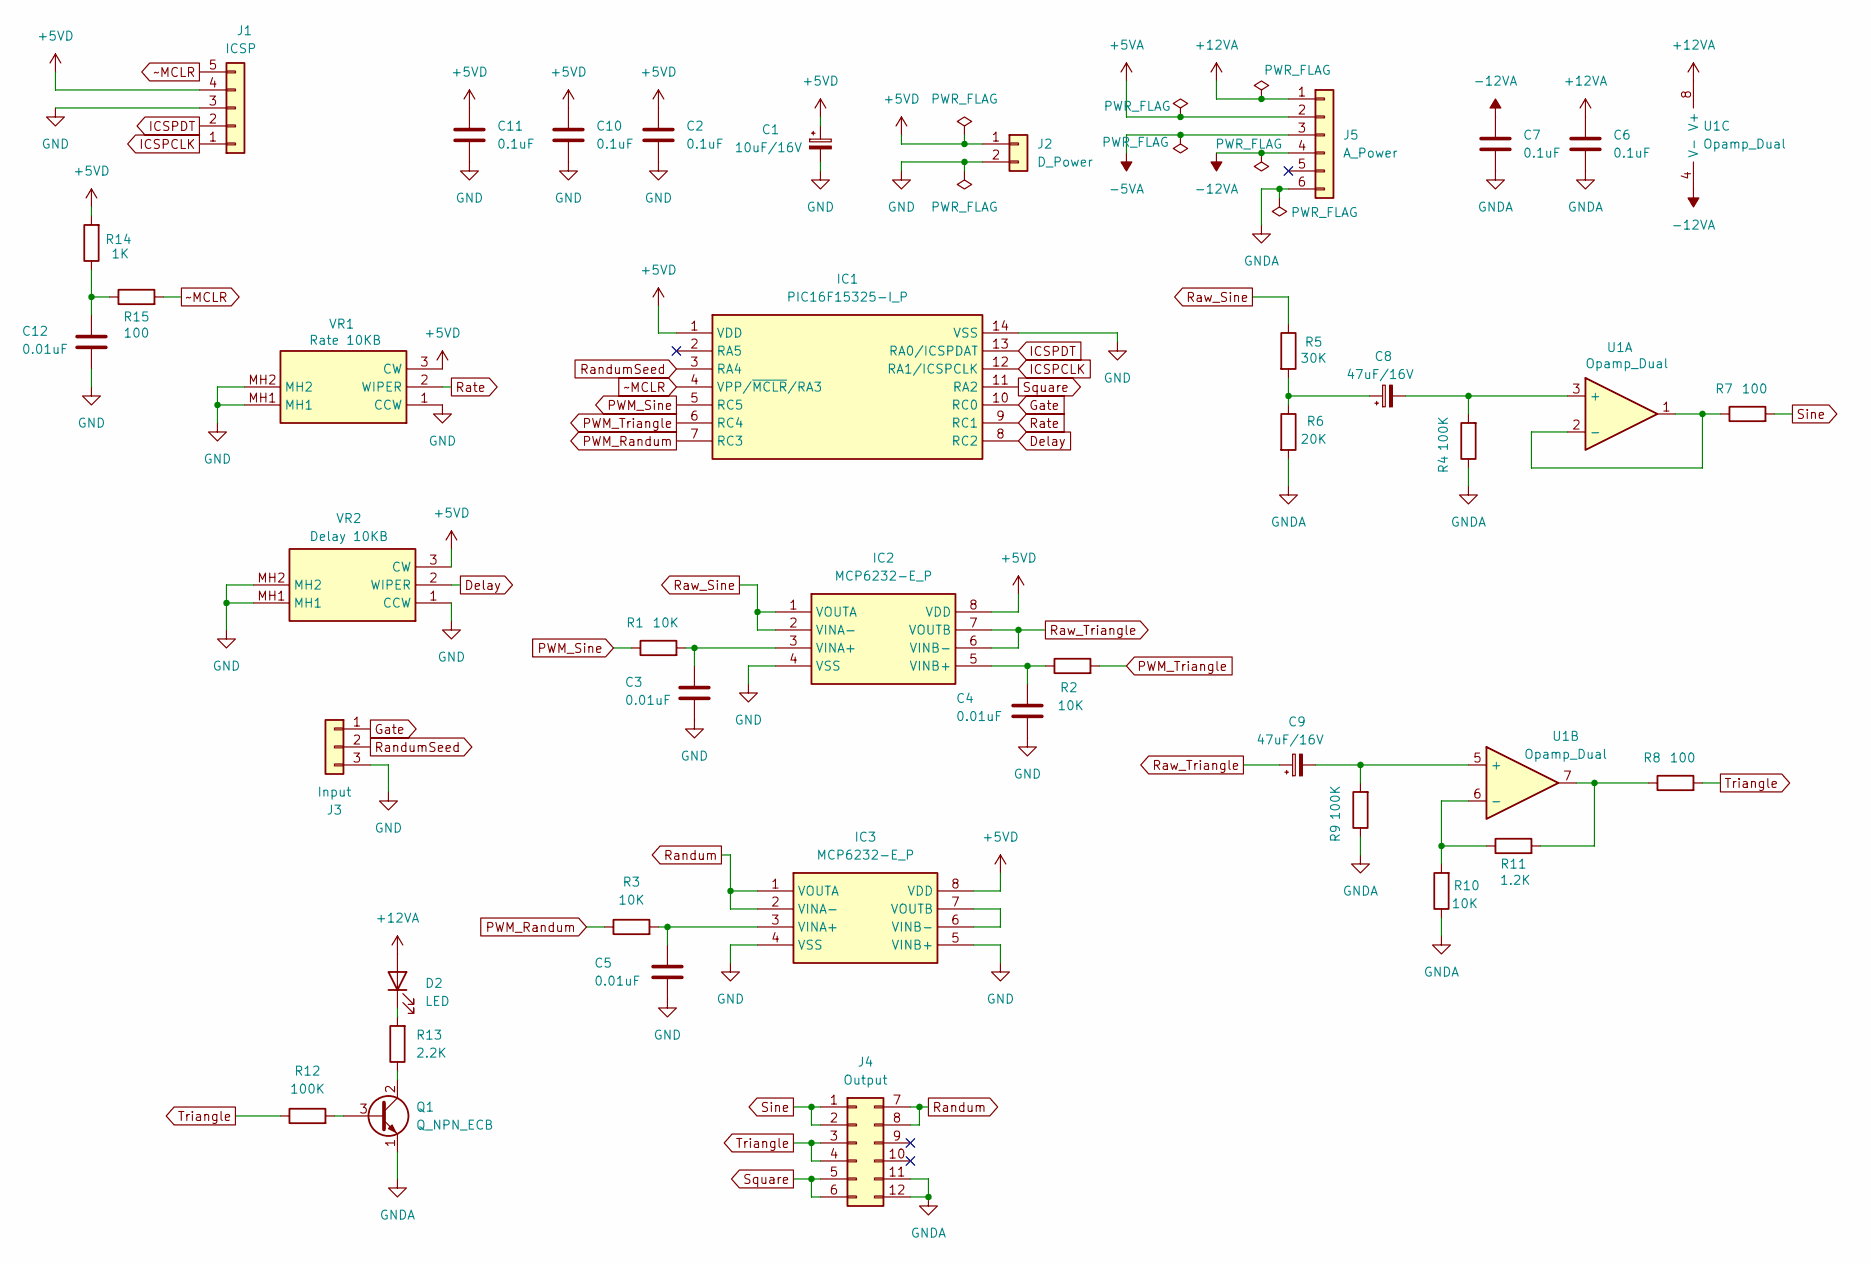
[picture p74: schematic LFOSeparate.kicad_sch]

Parts:
C1: 10uF/16V; CP_Radial_D5.0mm_P2.50mm
C2, C6, C7, C10, C11: 0.1uF; C_0805_2012Metric_Pad1.18x1.45mm_HandSolder
C3, C4, C5, C12: 0.01uF; C_Disc_D3.4mm_W2.1mm_P2.50mm
C8, C9: 47uF/16V; CP_Radial_D5.0mm_P2.50mm
D2: LED; LED_D5.0mm_FlatTop
IC1: PIC16F15325-I_P; DIP-14_W7.62mm_LongPads; Manufacturer_Part_Number PIC16F15325-I/P; Mouser Part Number 579-PIC16F15325-I/P
IC2, IC3: MCP6232-E_P; DIP-8_W7.62mm_LongPads; Manufacturer_Part_Number MCP6232-E/P; Mouser Part Number 579-MCP6232-E/P
J1: ICSP; PinHeader_1x05_P2.54mm_Horizontal
J2: D_Power; PinSocket_1x02_P2.54mm_Vertical
J3: Input; PinSocket_1x03_P2.54mm_Vertical
J4: Output; PinSocket_2x06_P2.54mm_Vertical
J5: A_Power; PinHeader_1x06_P2.54mm_Vertical
Q1: Q_NPN_ECB; TO-92_HandSolder
R1, R2, R3, R10: 10K; R_Axial_DIN0204_L3.6mm_D1.6mm_P2.54mm_Vertical
R4, R9, R12: 100K; R_Axial_DIN0204_L3.6mm_D1.6mm_P2.54mm_Vertical
R5: 30K; R_Axial_DIN0204_L3.6mm_D1.6mm_P2.54mm_Vertical
R6: 20K; R_Axial_DIN0204_L3.6mm_D1.6mm_P2.54mm_Vertical
R7, R8, R15: 100; R_Axial_DIN0204_L3.6mm_D1.6mm_P2.54mm_Vertical
R11: 1.2K; R_Axial_DIN0204_L3.6mm_D1.6mm_P2.54mm_Vertical
R13: 2.2K; R_Axial_DIN0204_L3.6mm_D1.6mm_P2.54mm_Vertical
R14: 1K; R_Axial_DIN0204_L3.6mm_D1.6mm_P2.54mm_Vertical
U1: Opamp_Dual; DIP-8_W7.62mm_LongPads
VR1: Rate 10KB; RK09D117000B; Manufacturer_Part_Number RK09D117000B; Mouser Part Number 688-RK09D117000B
VR2: Delay 10KB; RK09D117000B; Manufacturer_Part_Number RK09D117000B; Mouser Part Number 688-RK09D117000B

Connections:
+5VA: J5.2
+5VD: C1.1, C2.1, C10.1, C11.1, IC1.1 (VDD), IC2.8 (VDD), IC3.8 (VDD), J1.4, J2.1, R14.2, VR1.3 (CW), VR2.3 (CW)
+12VA: C6.1, D2.2 (A), J5.1, U1.8 (V+)
-5VA: J5.3
-12VA: C7.1, J5.4, U1.4 (V-)
Delay: IC1.8 (RC2), VR2.2 (WIPER)
GND: C1.2, C2.2, C3.2, C4.2, C5.2, C10.2, C11.2, C12.2, IC1.14 (VSS), IC2.4 (VSS), IC3.4 (VSS), IC3.5 (VINB+), J1.3, J2.2, J3.3, VR1.1 (CCW), VR1.MH1, VR1.MH2, VR2.1 (CCW), VR2.MH1, VR2.MH2
GNDA: C6.2, C7.2, J4.11, J4.12, J5.6, Q1.1 (E), R4.1, R6.2, R9.1, R10.1
Gate: IC1.10 (RC0), J3.1
ICSPCLK: IC1.12 (RA1/ICSPCLK), J1.1
ICSPDT: IC1.13 (RA0/ICSPDAT), J1.2
unnamed: C8.1, R5.2, R6.1
unnamed: C12.1, R14.1, R15.1
unnamed: D2.1 (K), R13.2
unnamed: C3.1, IC2.3 (VINA+), R1.2
unnamed: C4.1, IC2.5 (VINB+), R2.1
unnamed: C5.1, IC3.3 (VINA+), R3.2
unnamed: IC3.6 (VINB-), IC3.7 (VOUTB)
unnamed: Q1.3 (B), R12.2
unnamed: Q1.2 (C), R13.1
unnamed: R8.1, R11.2, U1.7
unnamed: C8.2, R4.2, U1.3 (+)
unnamed: R7.1, U1.1, U1.2 (-)
unnamed: C9.2, R9.2, U1.5 (+)
unnamed: R10.2, R11.1, U1.6 (-)
PWM_Randum: IC1.7 (RC3), R3.1
PWM_Sine: IC1.5 (RC5), R1.1
PWM_Triangle: IC1.6 (RC4), R2.2
Randum: IC3.1 (VOUTA), IC3.2 (VINA-), J4.7, J4.8
RandumSeed: IC1.3 (RA4), J3.2
Rate: IC1.9 (RC1), VR1.2 (WIPER)
Raw_Sine: IC2.1 (VOUTA), IC2.2 (VINA-), R5.1
Raw_Triangle: C9.1, IC2.6 (VINB-), IC2.7 (VOUTB)
Sine: J4.1, J4.2, R7.2
Square: IC1.11 (RA2), J4.5, J4.6
Triangle: J4.3, J4.4, R8.2, R12.1
~MCLR: IC1.4 (VPP/~MCLR/RA3), J1.5, R15.2

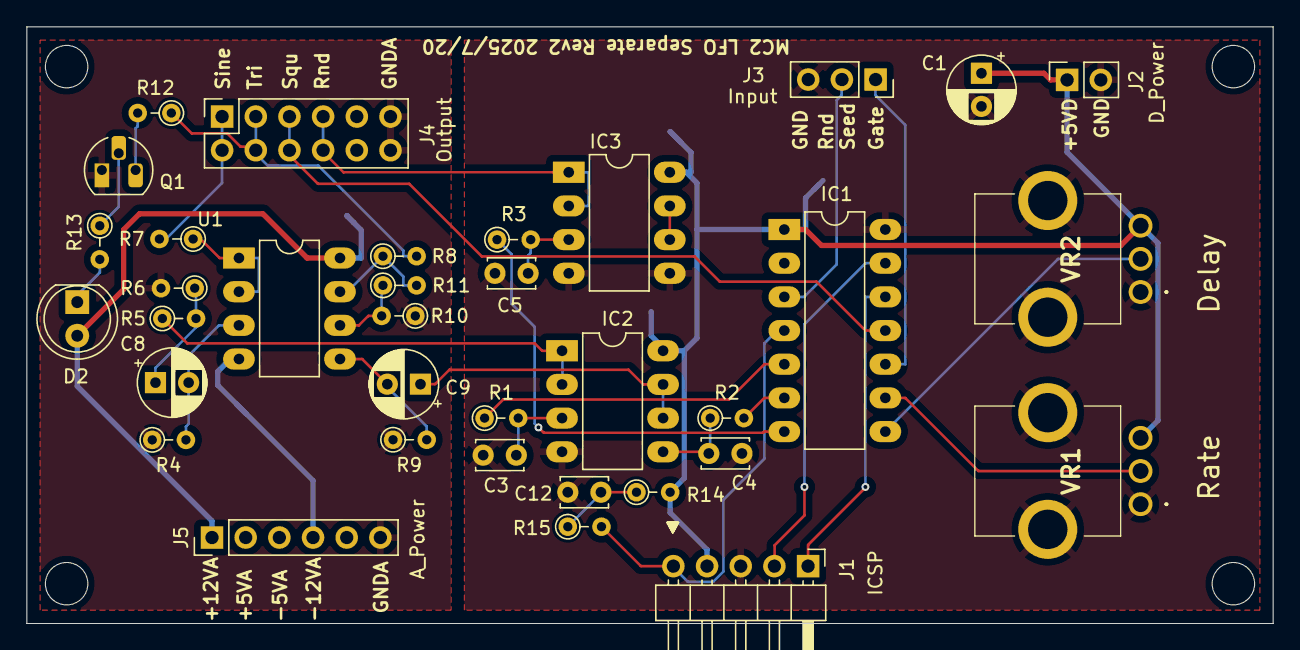
[picture p75: board LFOSeparate.kicad_pcb from above]

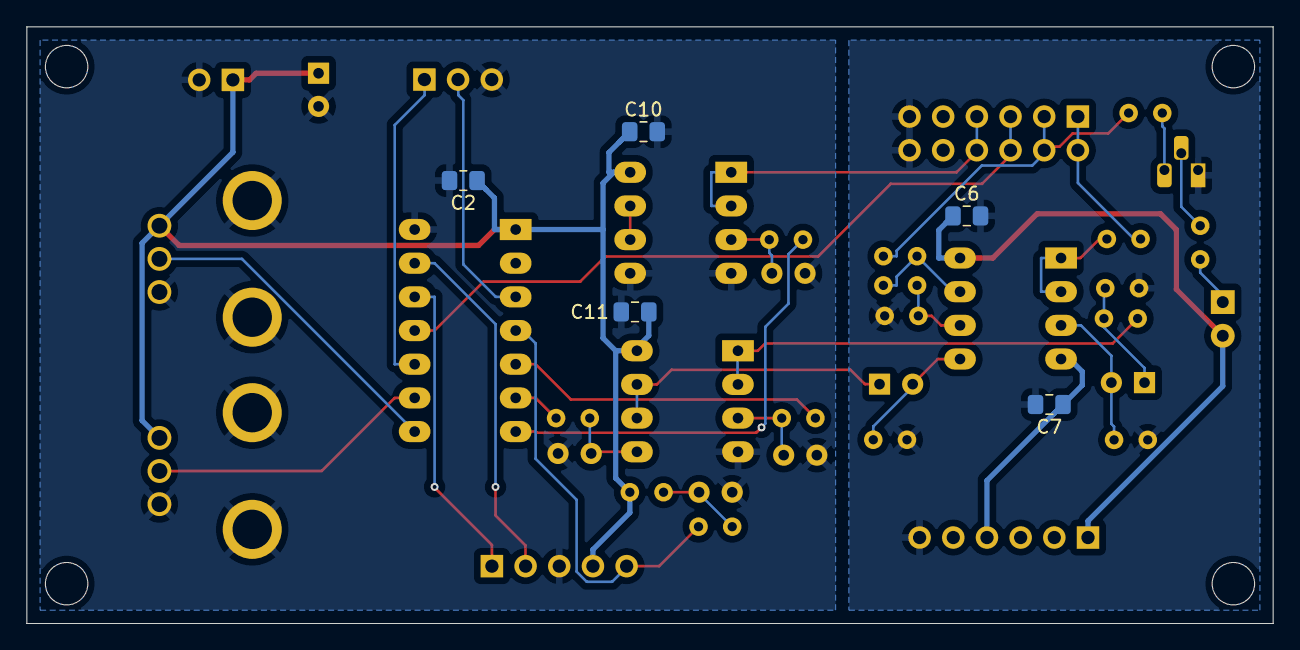
[picture p76: board LFOSeparate.kicad_pcb from below]

Board: 2 copper layers, 94.0 x 45.0 mm, 40 parts (5 on the bottom side), 35 nets.
