wakimizufu/MC2/EGSeparate/EGSeparate.kicad_pcb

## KiCad design EGSeparate/EGSeparate.kicad_pcb (2025-07-21)

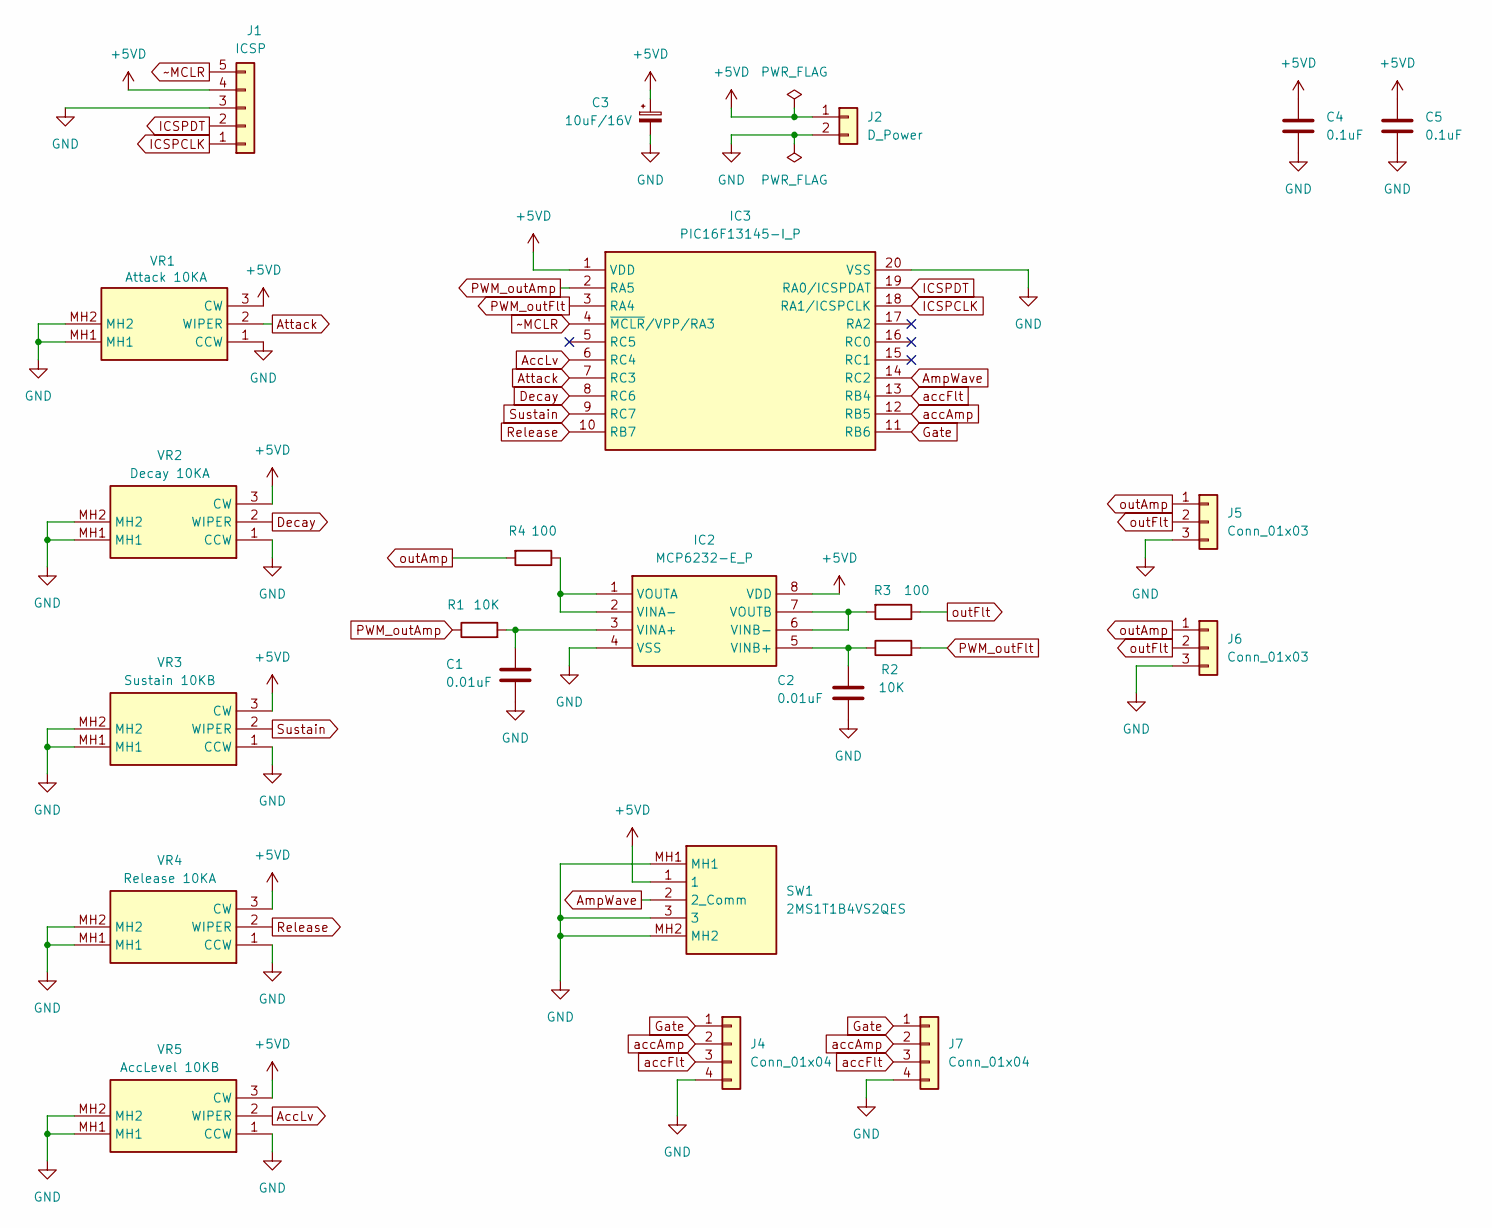
[picture p77: schematic EGSeparate.kicad_sch]

Parts:
C1, C2: 0.01uF; C_Disc_D3.4mm_W2.1mm_P2.50mm
C3: 10uF/16V; CP_Radial_D5.0mm_P2.50mm
C4, C5: 0.1uF; C_0805_2012Metric_Pad1.18x1.45mm_HandSolder
IC2: MCP6232-E_P; DIP781W56P254L950H533Q8N; Manufacturer_Part_Number MCP6232-E/P; Mouser Part Number 579-MCP6232-E/P
IC3: PIC16F13145-I_P; DIP794W56P254L2591H533Q20N; Manufacturer_Part_Number PIC16F13145-I/P; Mouser Part Number 579-PIC16F13145-I/P
J1: ICSP; PinHeader_1x05_P2.54mm_Horizontal
J2: D_Power; PinSocket_1x02_P2.54mm_Vertical
J4, J7: Conn_01x04; PinHeader_1x04_P2.54mm_Vertical
J5: Conn_01x03; PinHeader_1x03_P2.54mm_Vertical
J6: Conn_01x03; PinSocket_1x03_P2.54mm_Vertical
R1, R2: 10K; R_Axial_DIN0204_L3.6mm_D1.6mm_P2.54mm_Vertical
R3, R4: 100; R_Axial_DIN0204_L3.6mm_D1.6mm_P2.54mm_Vertical
SW1: 2MS1T1B4VS2QES; Manufacturer_Part_Number 2MS1T1B4VS2QES; Mouser Part Number N/A
VR1: Attack 10KA; RK09D117000B; Manufacturer_Part_Number RK09D117000B; Mouser Part Number 688-RK09D117000B
VR2: Decay 10KA; RK09D117000B; Manufacturer_Part_Number RK09D117000B; Mouser Part Number 688-RK09D117000B
VR3: Sustain 10KB; RK09D117000B; Manufacturer_Part_Number RK09D117000B; Mouser Part Number 688-RK09D117000B
VR4: Release 10KA; RK09D117000B; Manufacturer_Part_Number RK09D117000B; Mouser Part Number 688-RK09D117000B
VR5: AccLevel 10KB; RK09D117000B; Manufacturer_Part_Number RK09D117000B; Mouser Part Number 688-RK09D117000B

Connections:
+5VD: C3.1, C4.1, C5.1, IC2.8 (VDD), IC3.1 (VDD), J1.4, J2.1, SW1.1, VR1.3 (CW), VR2.3 (CW), VR3.3 (CW), VR4.3 (CW), VR5.3 (CW); also elsewhere on the board
AccLv: IC3.6 (RC4), VR5.2 (WIPER)
AmpWave: IC3.14 (RC2), SW1.2 (2_Comm)
Attack: IC3.7 (RC3), VR1.2 (WIPER)
Decay: IC3.8 (RC6), VR2.2 (WIPER)
GND: C1.2, C2.2, C3.2, C4.2, C5.2, IC2.4 (VSS), IC3.20 (VSS), J1.3, J2.2, J4.4, J5.3, J6.3, J7.4, SW1.3, SW1.MH1, SW1.MH2, VR1.1 (CCW), VR1.MH1, VR1.MH2, VR2.1 (CCW), VR2.MH1, VR2.MH2, VR3.1 (CCW), VR3.MH1, VR3.MH2, VR4.1 (CCW), VR4.MH1, VR4.MH2, VR5.1 (CCW), VR5.MH1, VR5.MH2; also elsewhere on the board
Gate: IC3.11 (RB6), J4.1, J7.1
ICSPCLK: IC3.18 (RA1/ICSPCLK), J1.1
ICSPDT: IC3.19 (RA0/ICSPDAT), J1.2
unnamed: C1.1, IC2.3 (VINA+), R1.2
unnamed: IC2.1 (VOUTA), IC2.2 (VINA-), R4.1
unnamed: C2.1, IC2.5 (VINB+), R2.1
unnamed: IC2.6 (VINB-), IC2.7 (VOUTB), R3.2
PWM_outAmp: IC3.2 (RA5), IC3.15 (RC1), R1.1
PWM_outFlt: IC3.3 (RA4), R2.2
Release: IC3.10 (RB7), VR4.2 (WIPER)
Sustain: IC3.9 (RC7), VR3.2 (WIPER)
accAmp: IC3.12 (RB5), J4.2, J7.2
accFlt: IC3.13 (RB4), J4.3, J7.3
outAmp: J5.1, J6.1, R4.2
outFlt: J5.2, J6.2, R3.1
~MCLR: IC3.4 (~MCLR/VPP/RA3), J1.5; also elsewhere on the board

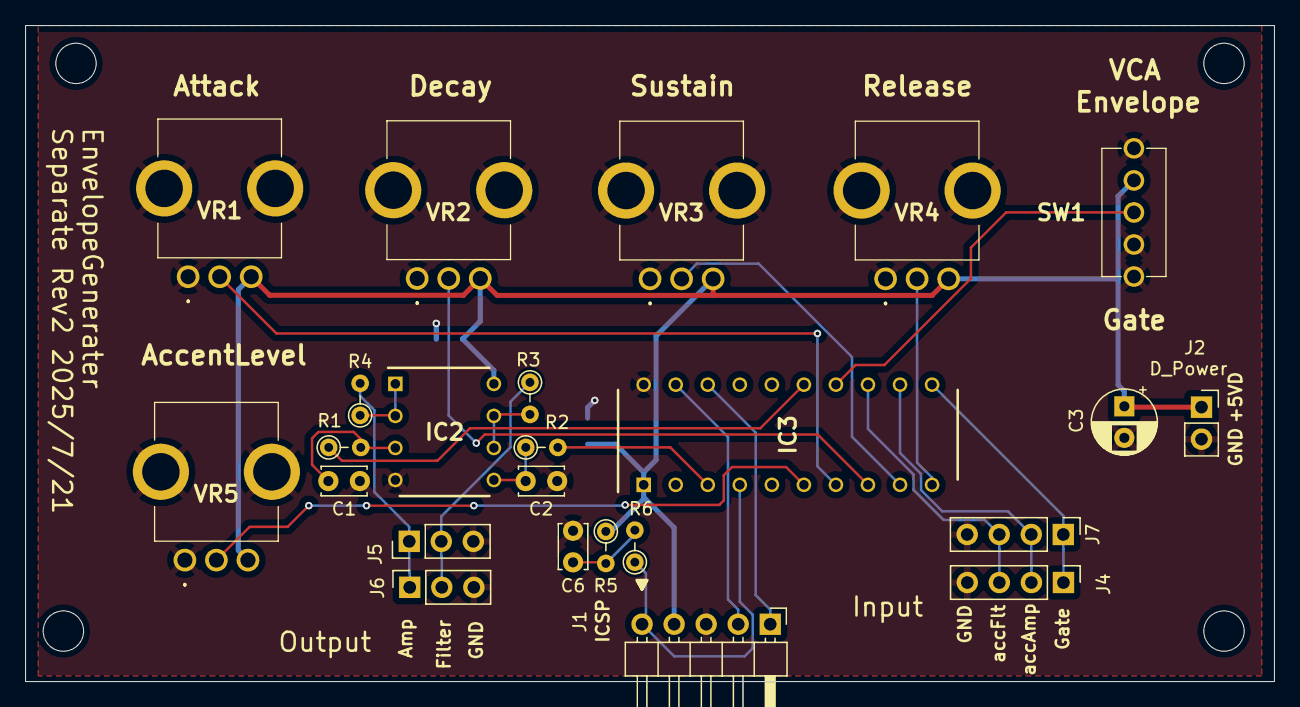
[picture p78: board EGSeparate.kicad_pcb from above]

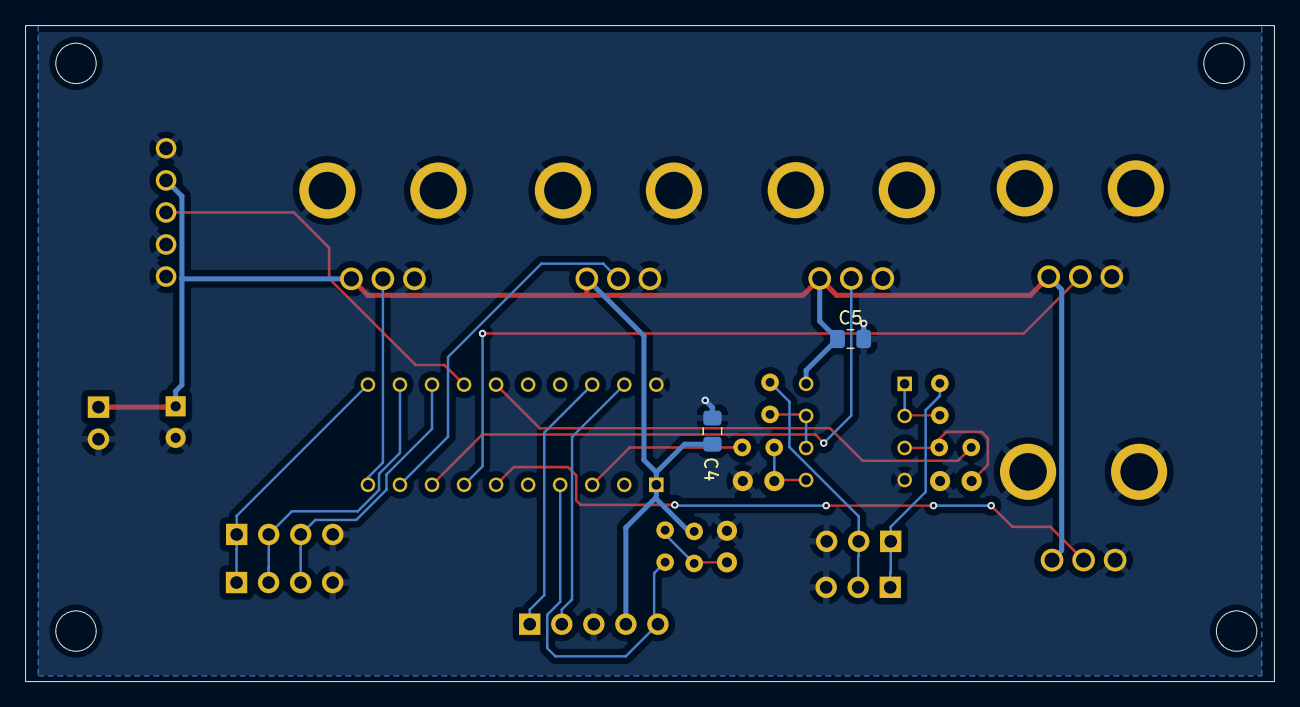
[picture p79: board EGSeparate.kicad_pcb from below]

Board: 2 copper layers, 99.0 x 52.0 mm, 26 parts (2 on the bottom side), 23 nets.

Other parts of the board:
C6: 0.01uF; C_Disc_D3.4mm_W2.1mm_P2.50mm
R5: 1K; R_Axial_DIN0204_L3.6mm_D1.6mm_P2.54mm_Vertical
R6: 100; R_Axial_DIN0204_L3.6mm_D1.6mm_P2.54mm_Vertical

Their connections:
+5VD: R5.1; also elsewhere on the board
GND: C6.2; also elsewhere on the board
unnamed: C6.1, R5.2, R6.2
~MCLR: R6.1; also elsewhere on the board
