wakimizufu/MC2/PowerSeparate/PowerSeparate.kicad_pcb

## KiCad design PowerSeparate/PowerSeparate.kicad_pcb (2025-07-20)

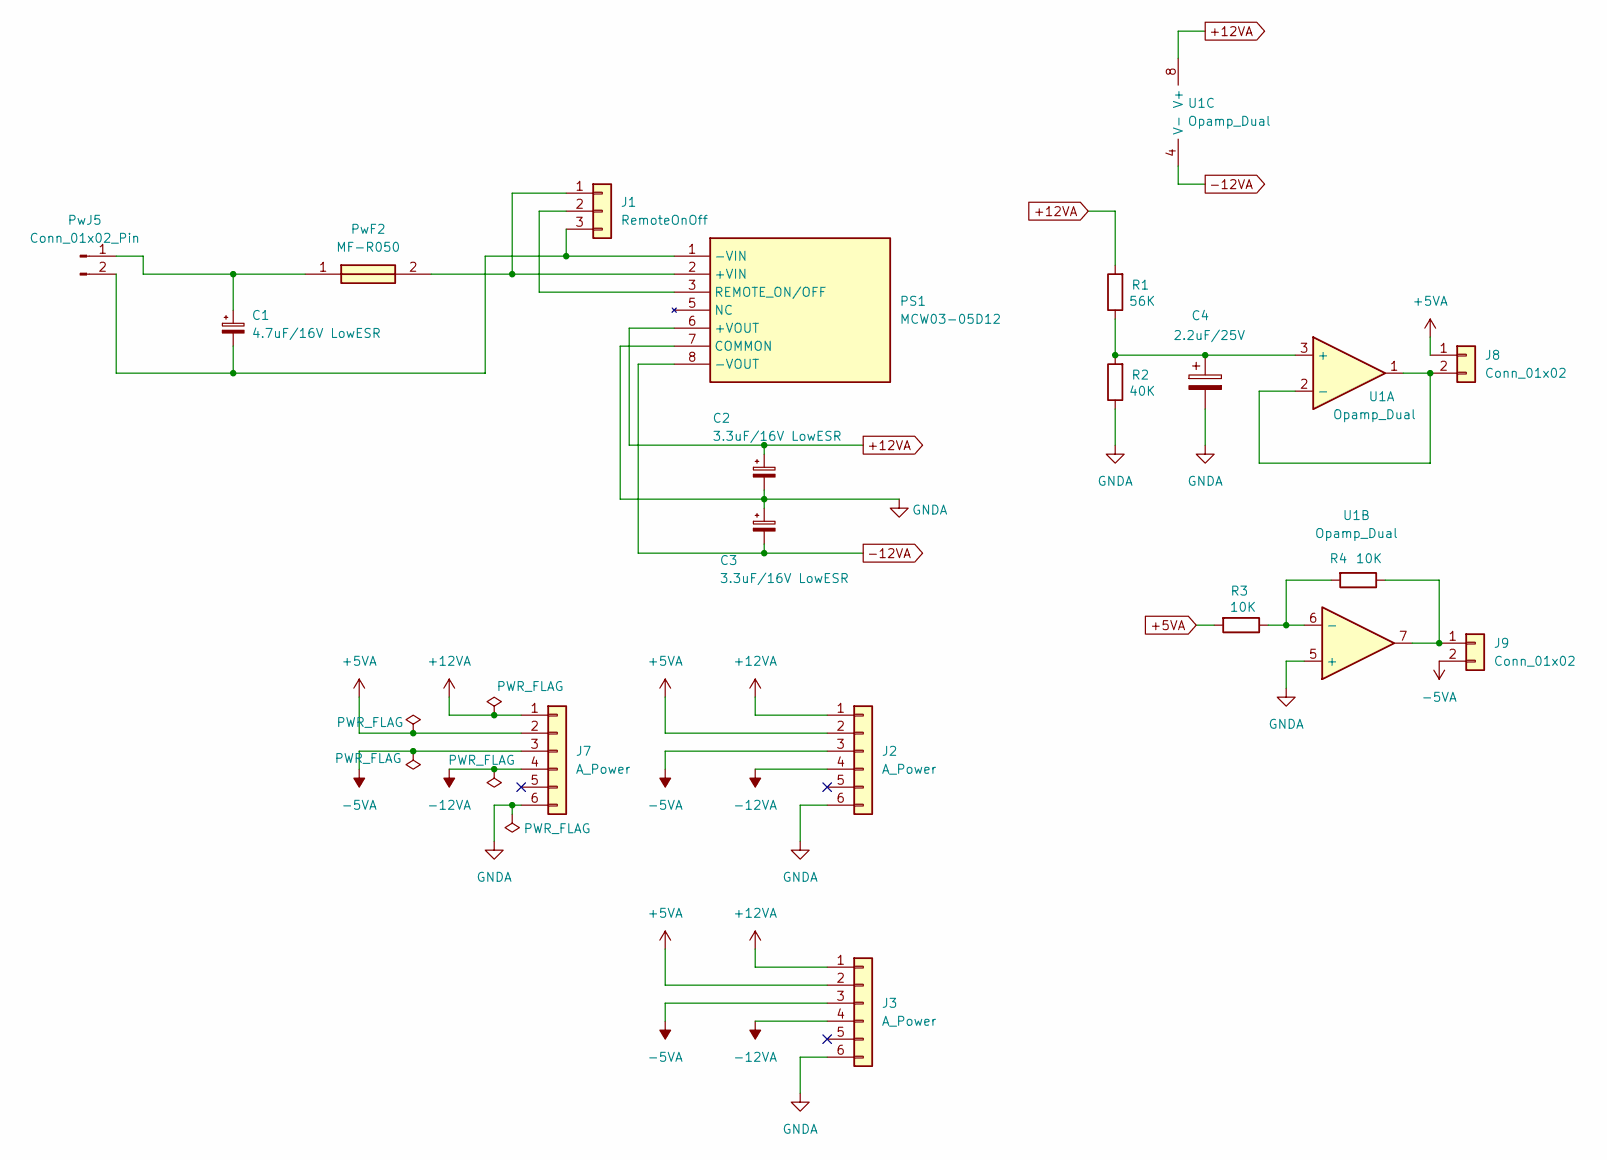
[picture p80: schematic analog_MCW03-05D12.kicad_sch]

Parts:
C1: 4.7uF/16V LowESR; CP_Radial_D5.0mm_P2.50mm
C2, C3: 3.3uF/16V LowESR; CP_Radial_D5.0mm_P2.50mm
C4: 2.2uF/25V; CP_Radial_D5.0mm_P2.50mm
J1: RemoteOnOff; PinSocket_1x03_P2.54mm_Vertical
J2, J3, J7: A_Power; PinHeader_1x06_P2.54mm_Vertical
J8, J9: Conn_01x02; PinHeader_1x02_P2.54mm_Vertical
PS1: MCW03-05D12; MCW0305D12; Manufacturer_Part_Number MCW03-05D12
PwF2: MF-R050; MFR050; Manufacturer_Part_Number MF-R050; Mouser Part Number 652-MFR050
PwJ5: Conn_01x02_Pin; PinHeader_1x02_P2.54mm_Vertical
R1: 56K; R_Axial_DIN0207_L6.3mm_D2.5mm_P2.54mm_Vertical
R2: 40K; R_Axial_DIN0207_L6.3mm_D2.5mm_P2.54mm_Vertical
R3, R4: 10K; R_Axial_DIN0207_L6.3mm_D2.5mm_P2.54mm_Vertical
U1: Opamp_Dual; SOIC-8_3.9x4.9mm_P1.27mm

Connections:
+5VA: J2.2, J3.2, J7.2, J8.1, R3.2
+12VA: C2.1, J2.1, J3.1, J7.1, PS1.6 (+VOUT), R1.2, U1.8 (V+)
-5VA: J2.3, J3.3, J7.3, J9.2
-12VA: C3.2, J2.4, J3.4, J7.4, PS1.8 (-VOUT), U1.4 (V-)
GNDA: C2.2, C3.1, C4.2, J2.6, J3.6, J7.6, PS1.7 (COMMON), R2.1, U1.5 (+)
unnamed: J1.1, PS1.2 (+VIN), PwF2.2
unnamed: J1.2, PS1.3 (REMOTE_ON/OFF)
unnamed: C1.2, J1.3, PS1.1 (-VIN), PwJ5.2
unnamed: J8.2, U1.1, U1.2 (-)
unnamed: J9.1, R4.1, U1.7
unnamed: C1.1, PwF2.1, PwJ5.1
unnamed: C4.1, R1.1, R2.2, U1.3 (+)
unnamed: R3.1, R4.2, U1.6 (-)

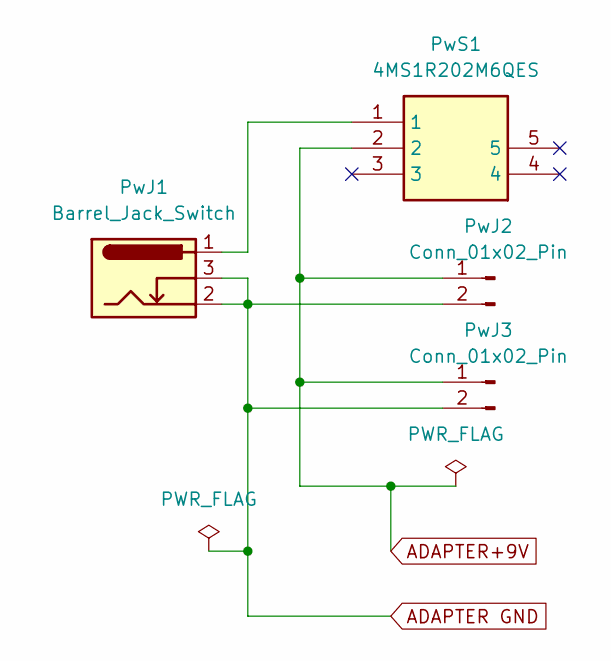
[picture p81: schematic DCInput.kicad_sch]

Parts:
PwJ1: Barrel_Jack_Switch; BarrelJack_Horizontal
PwJ2, PwJ3: Conn_01x02_Pin; PinHeader_1x02_P2.54mm_Vertical
PwS1: 4MS1R202M6QES; Manufacturer_Part_Number 4MS1R202M6QES

Connections:
ADAPTER GND: PwJ1.2, PwJ1.3, PwJ2.2, PwJ3.2
ADAPTER+9V: PwJ2.1, PwJ3.1, PwS1.2
unnamed: PwJ1.1, PwS1.1

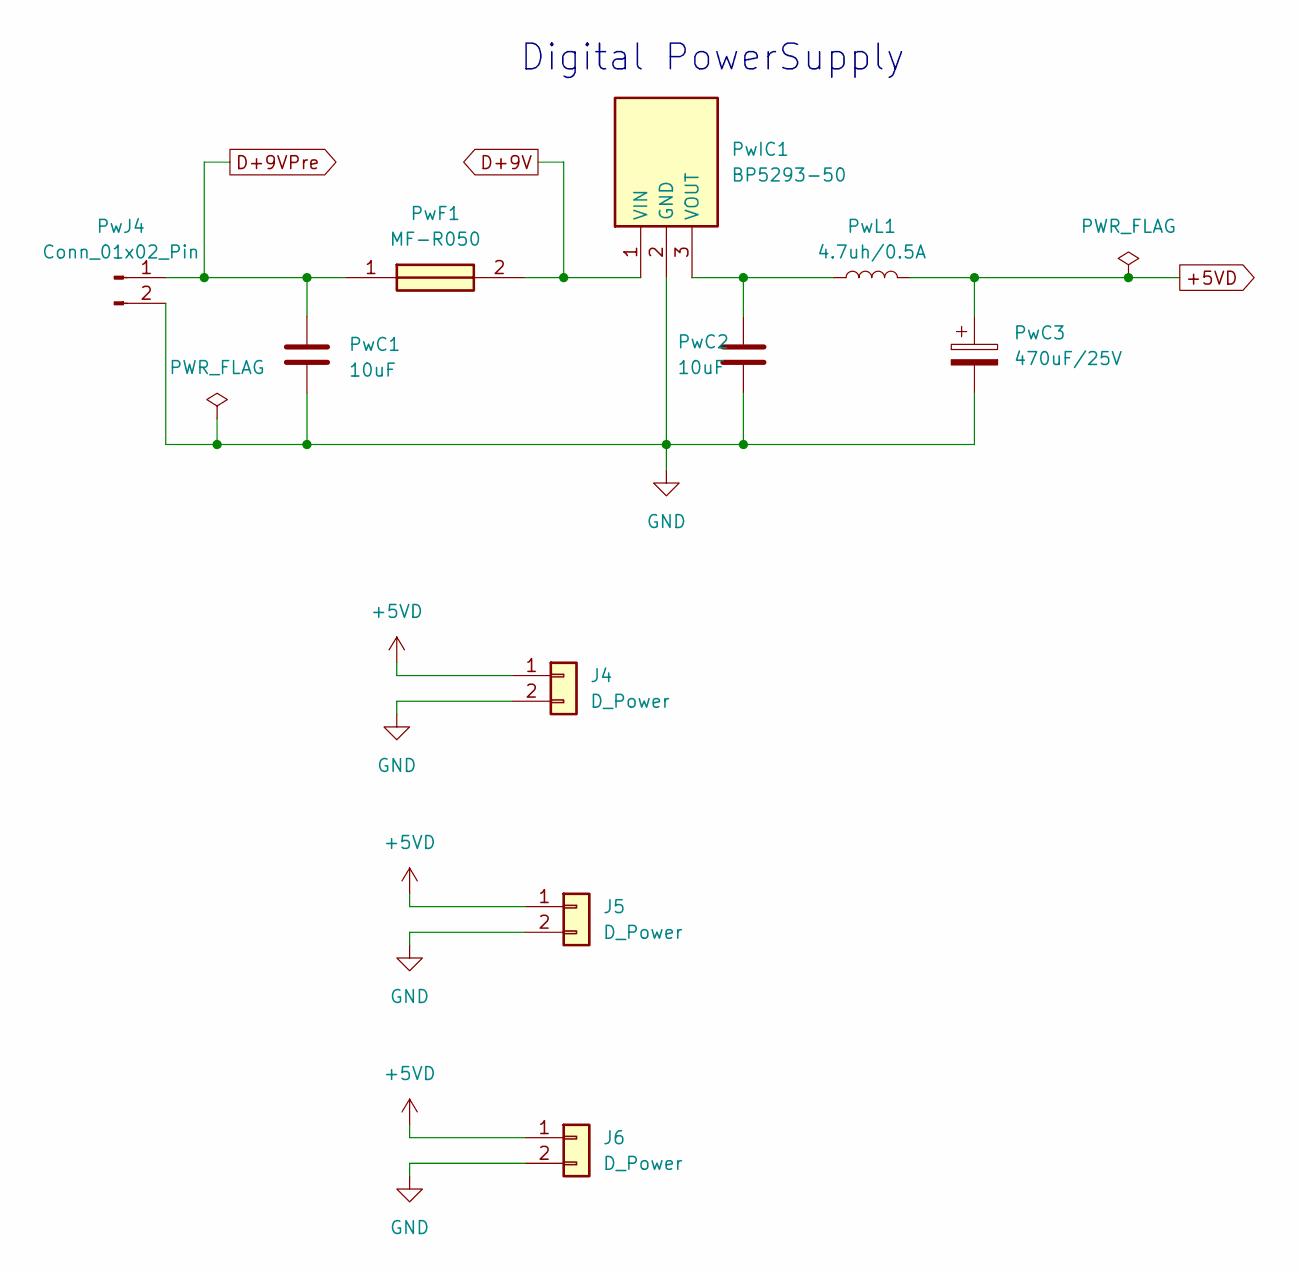
[picture p82: schematic Digital.kicad_sch]

Parts:
J4, J5, J6: D_Power; PinSocket_1x02_P2.54mm_Vertical
PwC1, PwC2: 10uF; C_Disc_D5.1mm_W3.2mm_P5.00mm
PwC3: 470uF/25V; CP_Radial_D5.0mm_P2.50mm
PwF1: MF-R050; MFR050; Manufacturer_Part_Number MF-R050; Mouser Part Number 652-MFR050
PwIC1: BP5293-50; TO254P570X1700X1780-3P; Manufacturer_Part_Number BP5293-50; Mouser Part Number 755-BP5293-50
PwJ4: Conn_01x02_Pin; PinHeader_1x02_P2.54mm_Vertical
PwL1: 4.7uh/0.5A; R_Axial_DIN0207_L6.3mm_D2.5mm_P7.62mm_Horizontal

Connections:
+5VD: J4.1, J5.1, J6.1, PwC3.1, PwL1.2
D+9V: PwF1.2, PwIC1.1 (VIN)
D+9VPre: PwC1.1, PwF1.1, PwJ4.1
GND: J4.2, J5.2, J6.2, PwC1.2, PwC2.2, PwC3.2, PwIC1.2 (GND), PwJ4.2
unnamed: PwC2.1, PwIC1.3 (VOUT), PwL1.1

Notes on the sheet:
Digital PowerSupply

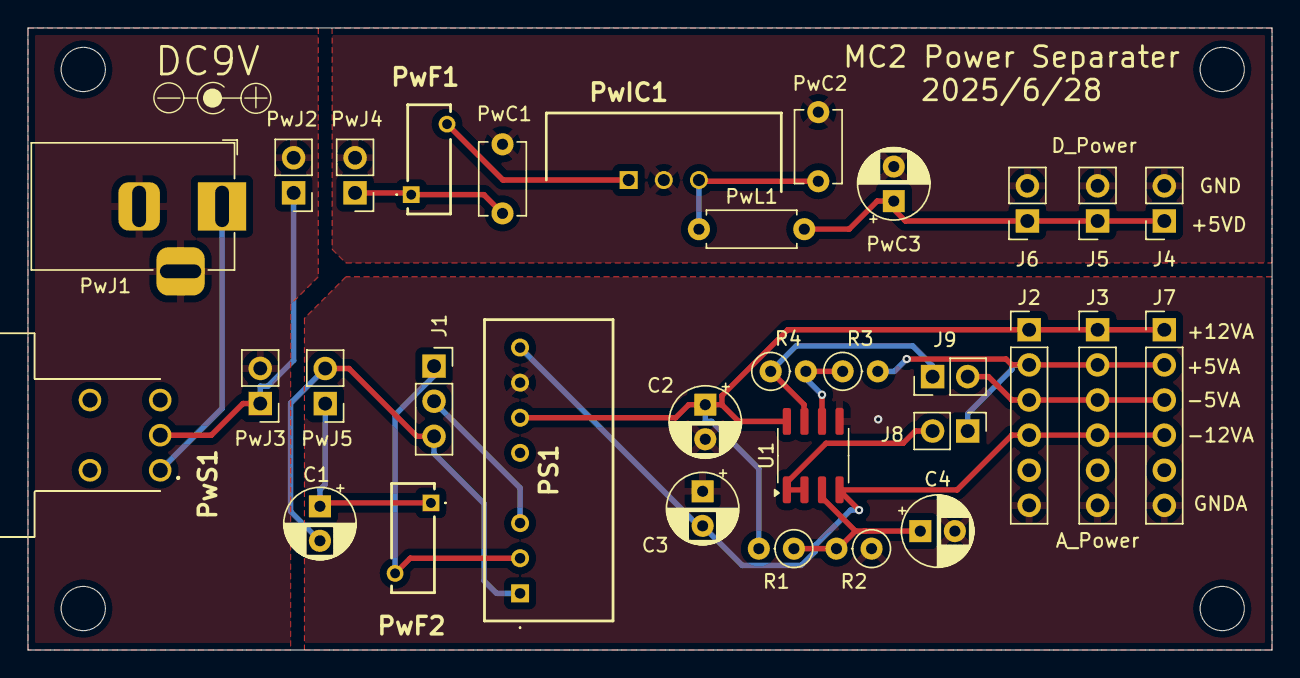
[picture p83: board PowerSeparate.kicad_pcb from above]

Board: 2 copper layers, 90.0 x 45.0 mm, 32 parts (0 on the bottom side), 21 nets.
