wakimizufu/MC2/NJM2374A_Invert/NJM2374A_Invert.kicad_pcb

## KiCad design NJM2374A_Invert/NJM2374A_Invert.kicad_pcb (2025-06-29)

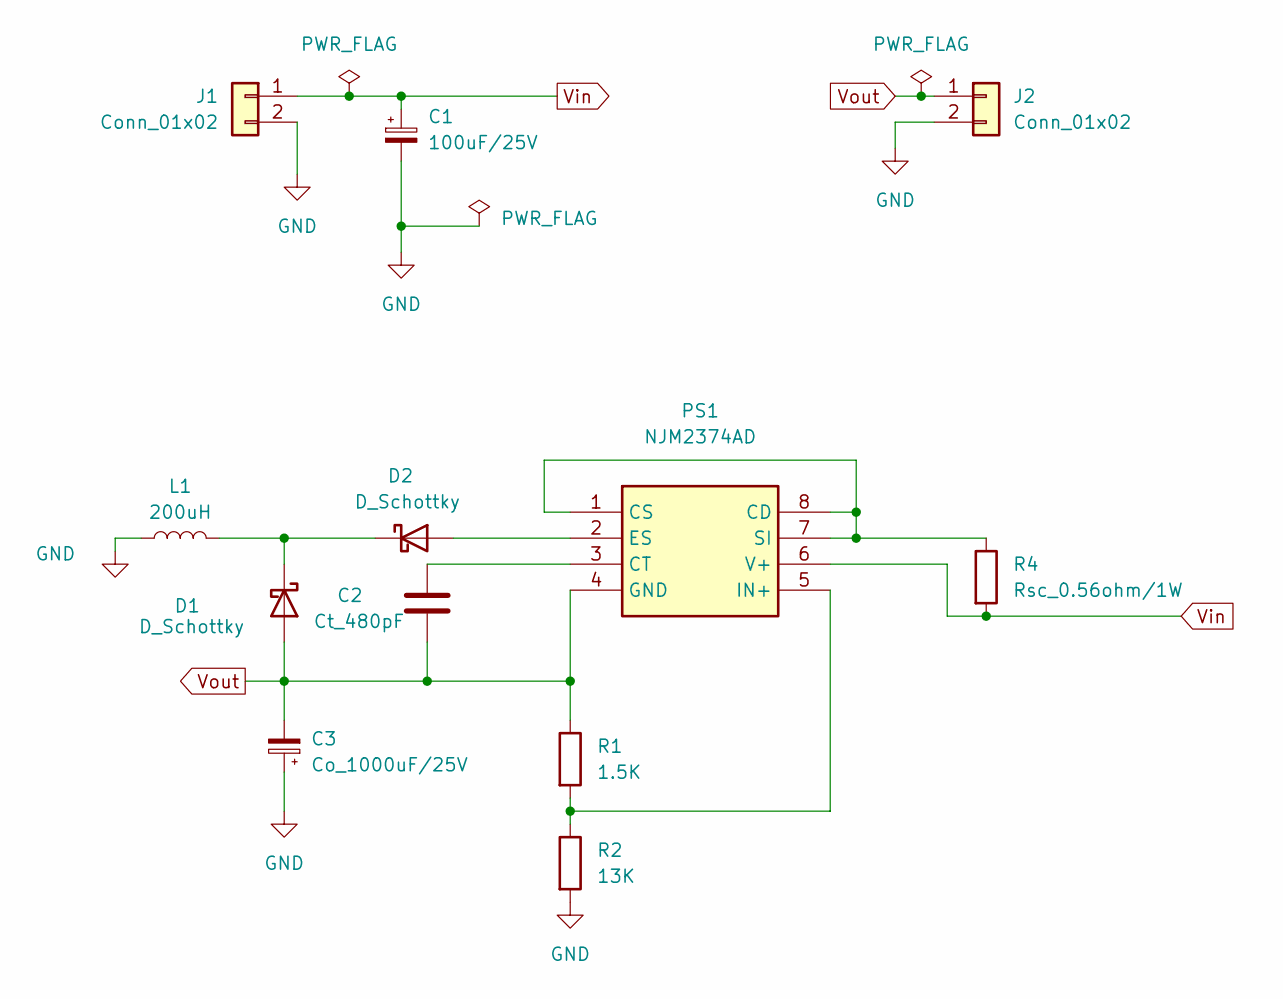
[picture p84: schematic NJM2374A_Invert.kicad_sch]

Parts:
C1: 100uF/25V; CP_Radial_D5.0mm_P2.50mm
C2: Ct_480pF; C_Disc_D7.5mm_W2.5mm_P5.00mm
C3: Co_1000uF/25V; CP_Radial_D5.0mm_P2.50mm
D1, D2: D_Schottky; D_DO-41_SOD81_P7.62mm_Horizontal
J1, J2: Conn_01x02; PinHeader_1x02_P2.54mm_Vertical
L1: 200uH; L_Radial_D9.5mm_P5.00mm_Fastron_07HVP
PS1: NJM2374AD; DIP762W56P254L880H425Q8N; Manufacturer_Part_Number NJM2374AD; Mouser Part Number 513-NJM2374AD
R1: 1.5K; R_Axial_DIN0207_L6.3mm_D2.5mm_P10.16mm_Horizontal
R2: 13K; R_Axial_DIN0207_L6.3mm_D2.5mm_P10.16mm_Horizontal
R4: Rsc_0.56ohm/1W; R_Axial_DIN0309_L9.0mm_D3.2mm_P12.70mm_Horizontal

Connections:
GND: C1.2, C3.1, J1.2, J2.2, L1.1, R2.2
unnamed: D1.1 (K), D2.1 (K), L1.2
unnamed: D2.2 (A), PS1.2 (ES)
unnamed: PS1.1 (CS), PS1.7 (SI), PS1.8 (CD), R4.1
unnamed: C2.2, PS1.3 (CT)
unnamed: PS1.5 (IN+), R1.2, R2.1
Vin: C1.1, J1.1, PS1.6 (V+), R4.2
Vout: C2.1, C3.2, D1.2 (A), J2.1, PS1.4 (GND), R1.1

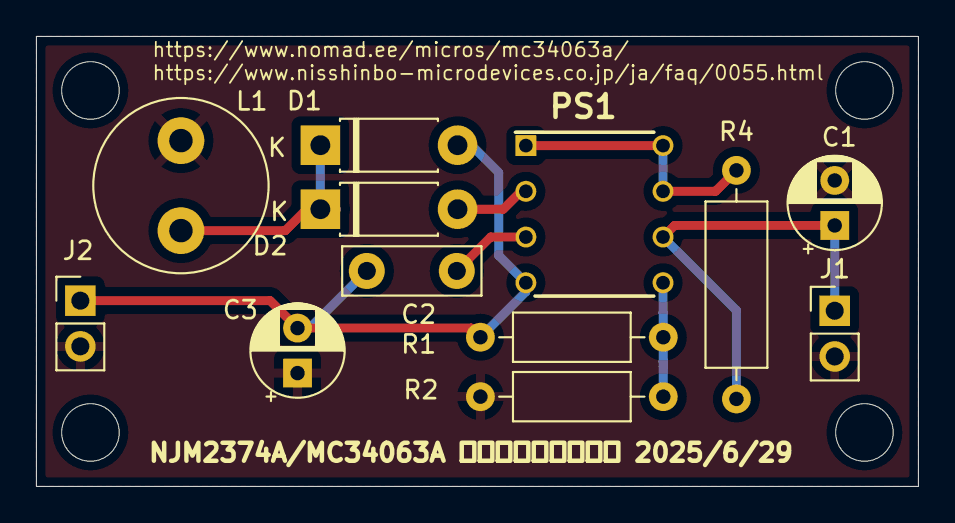
[picture p85: board NJM2374A_Invert.kicad_pcb from above]

Board: 2 copper layers, 49.0 x 25.0 mm, 12 parts (0 on the bottom side), 8 nets.
