wakimizufu/MC2/NJM2374A_Combi/NJM2374A_Combi.kicad_pcb

## KiCad design NJM2374A_Combi/NJM2374A_Combi.kicad_pcb (2025-06-29)

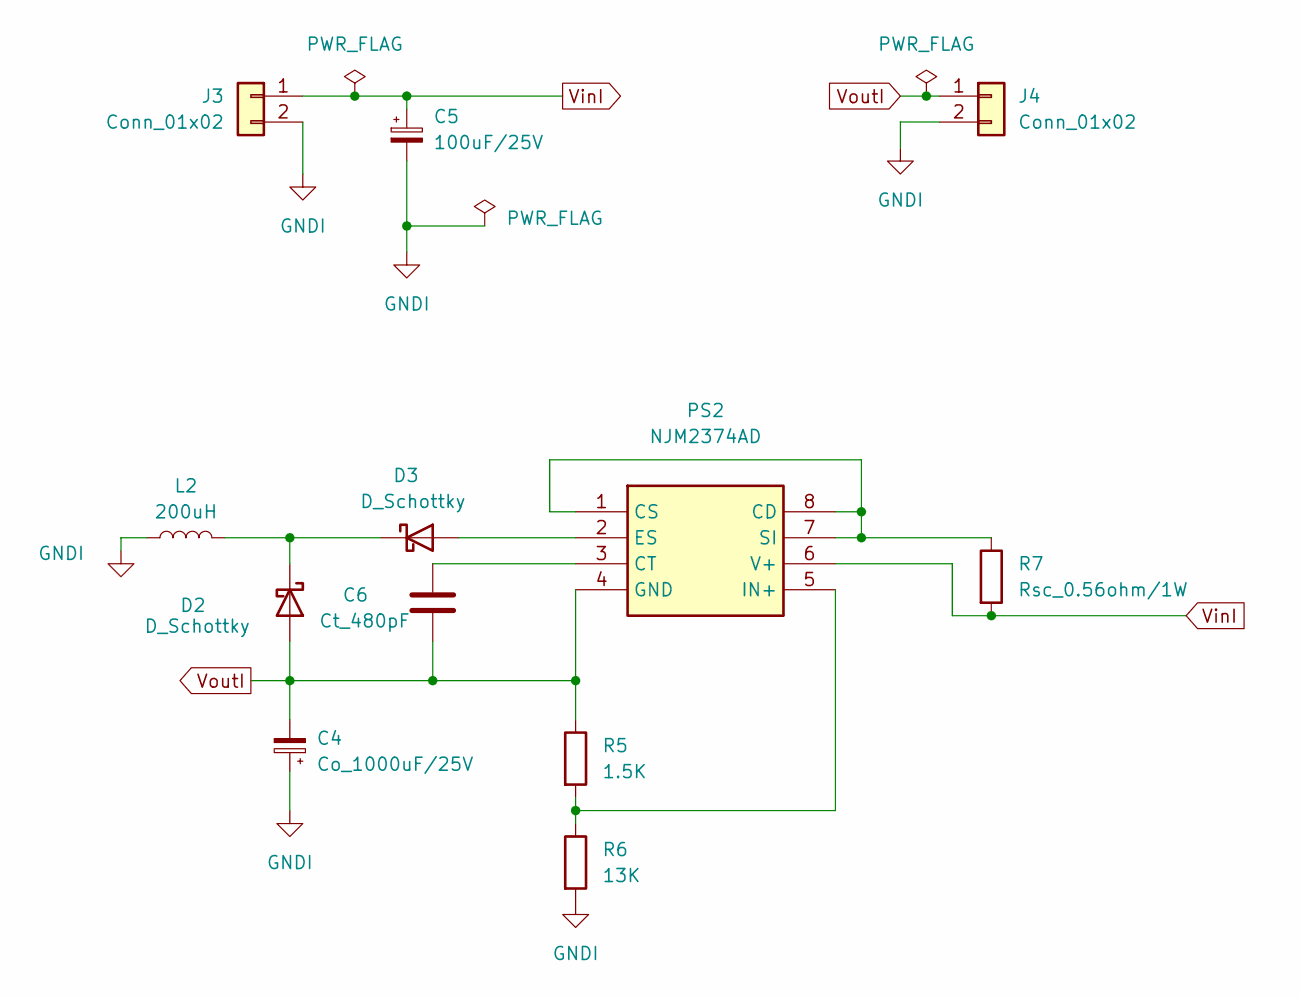
[picture p86: schematic Invert.kicad_sch]

Parts:
C4: Co_1000uF/25V; CP_Radial_D5.0mm_P2.50mm
C5: 100uF/25V; CP_Radial_D5.0mm_P2.50mm
C6: Ct_480pF; C_Disc_D7.5mm_W2.5mm_P5.00mm
D2, D3: D_Schottky; D_DO-41_SOD81_P7.62mm_Horizontal
J3, J4: Conn_01x02; PinHeader_1x02_P2.54mm_Vertical
L2: 200uH; L_Radial_D9.5mm_P5.00mm_Fastron_07HVP
PS2: NJM2374AD; DIP762W56P254L880H425Q8N; Manufacturer_Part_Number NJM2374AD; Mouser Part Number 513-NJM2374AD
R5: 1.5K; R_Axial_DIN0207_L6.3mm_D2.5mm_P10.16mm_Horizontal
R6: 13K; R_Axial_DIN0207_L6.3mm_D2.5mm_P10.16mm_Horizontal
R7: Rsc_0.56ohm/1W; R_Axial_DIN0309_L9.0mm_D3.2mm_P12.70mm_Horizontal

Connections:
GNDI: C4.1, C5.2, J3.2, J4.2, L2.1, R6.2
unnamed: D2.1 (K), D3.1 (K), L2.2
unnamed: D3.2 (A), PS2.2 (ES)
unnamed: PS2.1 (CS), PS2.7 (SI), PS2.8 (CD), R7.1
unnamed: C6.2, PS2.3 (CT)
unnamed: PS2.5 (IN+), R5.2, R6.1
VinI: C5.1, J3.1, PS2.6 (V+), R7.2
VoutI: C4.2, C6.1, D2.2 (A), J4.1, PS2.4 (GND), R5.1
