wakimizufu/MC2/NJM2374A_Combi/NJM2374A_Combi.kicad_pcb

## KiCad design NJM2374A_Combi/NJM2374A_Combi.kicad_pcb (continued)

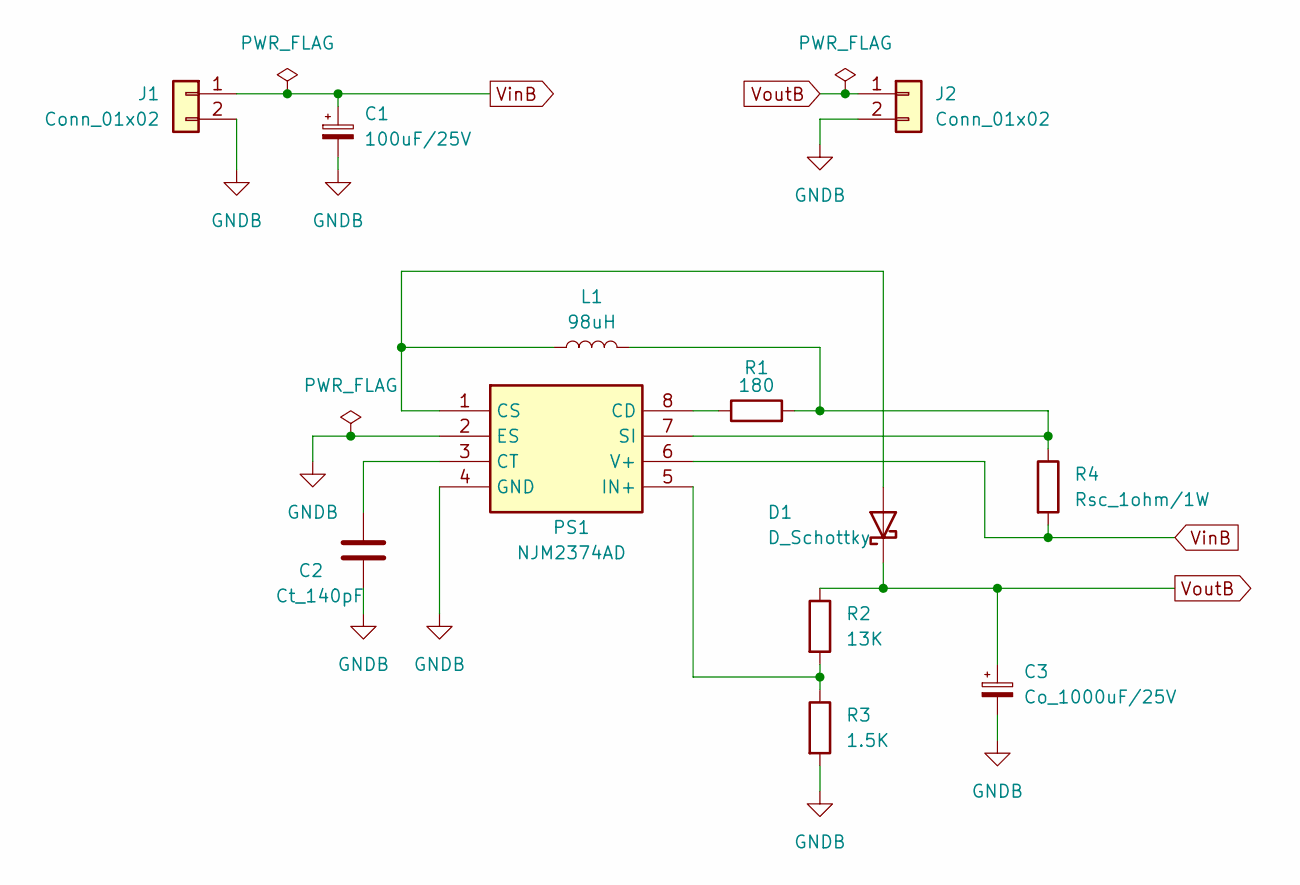
[picture p87: schematic Boost.kicad_sch]

Parts:
C1: 100uF/25V; CP_Radial_D5.0mm_P2.50mm
C2: Ct_140pF; C_Disc_D7.5mm_W2.5mm_P5.00mm
C3: Co_1000uF/25V; CP_Radial_D5.0mm_P2.50mm
D1: D_Schottky; D_DO-41_SOD81_P7.62mm_Horizontal
J1, J2: Conn_01x02; PinHeader_1x02_P2.54mm_Vertical
L1: 98uH; L_Radial_D9.5mm_P5.00mm_Fastron_07HVP
PS1: NJM2374AD; DIP-8_W7.62mm_LongPads; Manufacturer_Part_Number NJM2374AD; Mouser Part Number 513-NJM2374AD
R1: 180; R_Axial_DIN0207_L6.3mm_D2.5mm_P10.16mm_Horizontal
R2: 13K; R_Axial_DIN0207_L6.3mm_D2.5mm_P10.16mm_Horizontal
R3: 1.5K; R_Axial_DIN0207_L6.3mm_D2.5mm_P10.16mm_Horizontal
R4: Rsc_1ohm/1W; R_Axial_DIN0309_L9.0mm_D3.2mm_P12.70mm_Horizontal

Connections:
GNDB: C1.2, C2.1, C3.2, J1.2, J2.2, PS1.2 (ES), PS1.4 (GND), R3.2
unnamed: D1.2 (A), L1.1, PS1.1 (CS)
unnamed: PS1.8 (CD), R1.1
unnamed: C2.2, PS1.3 (CT)
unnamed: PS1.5 (IN+), R2.2, R3.1
unnamed: L1.2, PS1.7 (SI), R1.2, R4.1
VinB: C1.1, J1.1, PS1.6 (V+), R4.2
VoutB: C3.1, D1.1 (K), J2.1, R2.1

Board: 2 copper layers, 24 parts (0 on the bottom side), 16 nets, no tracks yet.
