wakimizufu/MC2/LFO_MC2.X/main.c

 /*
 * MAIN Generated Driver File
 * 
 * @file main.c
 * 
 * @defgroup main MAIN
 * 
 * @brief This is the generated driver implementation file for the MAIN driver.
 *
 * @version MAIN Driver Version 1.0.2
 *
 * @version Package Version: 3.1.2
*/

/*
? [2025] Microchip Technology Inc. and its subsidiaries.

    Subject to your compliance with these terms, you may use Microchip 
    software and any derivatives exclusively with Microchip products. 
    You are responsible for complying with 3rd party license terms  
    applicable to your use of 3rd party software (including open source  
    software) that may accompany Microchip software. SOFTWARE IS ?AS IS.? 
    NO WARRANTIES, WHETHER EXPRESS, IMPLIED OR STATUTORY, APPLY TO THIS 
    SOFTWARE, INCLUDING ANY IMPLIED WARRANTIES OF NON-INFRINGEMENT,  
    MERCHANTABILITY, OR FITNESS FOR A PARTICULAR PURPOSE. IN NO EVENT 
    WILL MICROCHIP BE LIABLE FOR ANY INDIRECT, SPECIAL, PUNITIVE, 
    INCIDENTAL OR CONSEQUENTIAL LOSS, DAMAGE, COST OR EXPENSE OF ANY 
    KIND WHATSOEVER RELATED TO THE SOFTWARE, HOWEVER CAUSED, EVEN IF 
    MICROCHIP HAS BEEN ADVISED OF THE POSSIBILITY OR THE DAMAGES ARE 
    FORESEEABLE. TO THE FULLEST EXTENT ALLOWED BY LAW, MICROCHIP?S 
    TOTAL LIABILITY ON ALL CLAIMS RELATED TO THE SOFTWARE WILL NOT 
    EXCEED AMOUNT OF FEES, IF ANY, YOU PAID DIRECTLY TO MICROCHIP FOR 
    THIS SOFTWARE.
*/
#include "mcc_generated_files/system/system.h"
#include "mcc_generated_files/system/system.h"
#include <stdbool.h>
#include <stdlib.h>

/*
    Main application
*/
//変数
_Bool onTMR1; 

//LFO サイン波テーブル
# define SINE_CURVE_LENGTH 256
const unsigned int sineTbl[SINE_CURVE_LENGTH] = {
512,524,536,548,560,576,588,600,612,624,636,648,660,672,684,696,708,
716,728,740,752,764,772,784,796,804,816,824,836,844,852,864,872,880,
888,896,904,912,920,928,936,940,948,952,960,964,972,976,980,984,992,
996,1000,1000,1004,1008,1012,1012,1016,1016,1016,1020,1020,1020,1020,1020,1020,1020,
1016,1016,1016,1012,1012,1008,1004,1000,1000,996,992,984,980,976,972,964,960,
952,948,940,936,928,920,912,904,896,888,880,872,864,852,844,836,824,
816,804,796,784,772,764,752,740,728,716,708,696,684,672,660,648,636,
624,612,600,588,576,560,548,536,524,512,500,488,476,464,448,436,424,
412,400,388,376,364,352,340,328,316,308,296,284,272,260,252,240,228,
220,208,200,188,180,172,160,152,144,136,128,120,112,104,96,88,84,
76,72,64,60,52,48,44,40,32,28,24,24,20,16,12,12,8,
8,8,4,4,4,4,4,4,4,8,8,8,12,12,16,20,24,
24,28,32,40,44,48,52,60,64,72,76,84,88,96,104,112,120,
128,136,144,152,160,172,180,188,200,208,220,228,240,252,260,272,284,
296,308,316,328,340,352,364,376,388,400,412,424,436,448,464,476,488,500};

//ADC変換タイミング(単位:2msec)
#define ADC_CONVERT_TIME 100 

//ADC 8bitに対するLFOステップ周波数(単位:Hz))
#define LFO_STEP_TIME 0.117 

//LFO関連
//DDS駆動周波数
#define DDS_CLOCK 4000

double fout;
double tuningWord;               //double tuningWord = (pow(2, 32) * fout) / clock;
uint16_t LFODEtm = 0;           //LFOディレイタイム 0ms:0-1.25s:2047
uint16_t LFODelayCount = 0;     //LFOディレイタイム用カウント
uint16_t LFORndSeed = 0;     //ランダムシード(0-1023)

//ADC ステータス
enum ADC_ST {
    TmLFO,    //LFO周波数
    DeLFO,    //LFOディレイタイム
    RndSe,    //ランダムシード
    TmATK,    //アタックタイム
    TmDCY,    //ディケイタイム
    LvSUS,    //サスティンレベル
    TmREL     //リリースタイム
};
enum ADC_ST adc_ST = TmLFO;  //現在のADCステータス

    __uint24 accmulator = 0;
    __uint24 count;
    __uint24 updateRandum = 0;
	unsigned int dacval;
    
// 関数プロトタイプ
void MyTMR1_ISR(void);
void onEdgeGate_ISR(void);
void cnvADC(void);

// 2000Hz=0.5ms タイマー割込み
void MyTMR1_ISR(void){
    onTMR1 = true;
}

// GATE 入力割込み
void onEdgeGate_ISR(void){
    
    _Bool envGate = Gate_GetValue();
    
    if ( envGate ){
        LFODelayCount = LFODEtm;     //LFOディレイタイム用カウント
    } else if (!envGate) {
    }
}

//ADCコンバータ⇒各変数を更新
void cnvADC(){
	//ADC_StartConversion();
/*
	switch ( adc_ST ) {
		case TmLFO:    //LFO周波数
			ADC_GetConversion(Rate); //ADC_CHANNEL_ANA0
			break;
		case DeLFO:    //LFOディレイタイム
			ADC_GetConversion(Delay); //ADC_CHANNEL_ANA1
			break;
		case RndSe:    //ランダムシード
			ADC_GetConversion(LFORndSeed); //ADC_CHANNEL_ANA1
			break;
		default:
			break;
	}
*/


    
	switch ( adc_ST ) {
		case TmLFO:    //LFO周波数
			fout = ( (ADC_GetConversion(Rate)>>2) * LFO_STEP_TIME) + LFO_STEP_TIME;
			tuningWord = 0x01000000 * fout / DDS_CLOCK;
            adc_ST	=	DeLFO;
			break;
		case DeLFO:    //LFOディレイタイム
            LFODEtm = ADC_GetConversion(Decay)<<1;     //LFOディレイタイム 0ms:0-1.25s:2047
         	adc_ST	= RndSe;   
            break;
		case RndSe:    //ランダムシード
            LFORndSeed = ADC_GetConversion(RndSeed);     //ランダムシード 0-1023
         	adc_ST	= TmLFO;   
            break;
		default:
			break;
	}
}

int main(void)
{
    SYSTEM_Initialize();
  
Square_SetDigitalOutput();
Square_SetDigitalMode();
Square_SetPushPull();

                          
    onTMR1 = false;
    TMR1_OverflowCallbackRegister(MyTMR1_ISR);
    TMR1_Start();

    Gate_SetInterruptHandler(onEdgeGate_ISR);

    // Enable the Global Interrupts 
    INTERRUPT_GlobalInterruptEnable(); 

    // Enable the Peripheral Interrupts 
    INTERRUPT_PeripheralInterruptEnable(); 

    unsigned int onLFORate = ADC_CONVERT_TIME;
    //ADC_SelectChannel(Rate); //ADC_CHANNEL_ANA0
    //ADC_StartConversion();


    
    while(1)
    {
        // 2000Hz=0.5ms タイマー割込み
        if (onTMR1){
            
            //サイン波テーブルから取得
            count = accmulator >> 16;
            dacval = sineTbl[count];

            //サイン波 RC5->PWM5:PWM5OUT
            if ( 0 == LFODelayCount){
                PWM5_LoadDutyValue(dacval);
            } else if ( 0 != LFODelayCount){
                PWM5_LoadDutyValue(511);
                LFODelayCount--;
            }
            
            //三角波 RC4->PWM4:PWM4OUT
             if (count<=0x3F){
                dacval = 0x1FF + ( ( 0x00003F & count) <<3);
            } else if (count<=0x7F){
                dacval = 0x3FF - ( ( 0x00003F & count) <<3);
            } else if (count<=0xBF){
                dacval = 0x1FF - ( ( 0x00003F & count) <<3);
            } else if (count<=0xFF){
                dacval = ( ( 0x00003F & count) <<3);
            }
            PWM4_LoadDutyValue(dacval);

            //方形波
             if  (count<=0x7F){
                Test_SetHigh();
             } else {
                Test_SetLow();
             }

            //ランダム RC3->PWM3:PWM3OUT
             updateRandum = updateRandum + count;
             if ( updateRandum > 0xFF ){
                 updateRandum = updateRandum - 0xFF;

                srand(LFORndSeed);
                dacval=(rand() % 1022) + 1;
                PWM3_LoadDutyValue(dacval);
             }
            
            //加算累積器へ加算
            accmulator += tuningWord;
   
            onLFORate--;            
            onTMR1 = false;
        }
        
        //ADCコンバータ⇒各変数を更新
        if (0 == onLFORate){
           cnvADC();
           onLFORate=ADC_CONVERT_TIME;
        }
    }    
}
