wakimizufu/MC2/(commit log)

2025-06-10 MC2
    この時点のファイルを登録
    [EGSeparate.kicad_pcb, EGSeparate.kicad_sch, LFOSeparate.kicad_pcb, LFOSeparate.kicad_sch, VCO.kicad_sch, VCOSeparate.kicad_pcb, VCOSeparate.kicad_sch, Waveform.kicad_sch]
2025-06-10 LFOSeparate
    アートワーク作成中
    [LFOSeparate.kicad_pcb, LFOSeparate.kicad_sch]
2025-06-11 LFOSeparate
    LFOSeparateは配線完了
    EGSeparateは回路図作成中
    [EGSeparate.kicad_sch, LFOSeparate.kicad_pcb, LFOSeparate.kicad_sch]
2025-06-12 EGSeparate
    配線完了 シルク未記入
    [EGSeparate.kicad_pcb, EGSeparate.kicad_sch]
2025-06-13 EGSeparate
    シルクスクリーンに説明文を追記
    [EGSeparate.kicad_pcb, EGSeparate.kicad_sch]
2025-06-15 MC2
    アクセントレベルを追加したEGACCを登録
    回路全般部品配置済
    [EGSeparate.kicad_pcb, EGSeparate.kicad_sch, LFOSeparate.kicad_pcb, LFOSeparate.kicad_sch, VCO.kicad_sch, VCOSeparate.kicad_pcb, Waveform.kicad_sch]
2025-06-16 VCFSeparater
    回路図作成中
    [VCA.kicad_sch, VCF.kicad_sch, VCFSeparate.kicad_pcb, VCFSeparate.kicad_sch, VCF_VCA_Power.kicad_sch]
2025-06-17 VCFSeparate
    レゾナンスVCAを追加
    コントローラー系を作成中
    [VCA.kicad_sch, VCF.kicad_sch, VCF_VCA_Power.kicad_sch]
2025-06-25 MC2
    VCO,VCF+VCA,Powerを登録
    [CVMixer.kicad_sch, DCInput.kicad_sch, Digital.kicad_sch, PowerSeparate.kicad_pcb, PowerSeparate.kicad_sch, VCA.kicad_sch, VCF.kicad_sch, VCFSeparate.kicad_pcb]
2025-06-29 MC2
    ガーバーデータ出力
    BOMファイル出力
    NJM2374A関連プロジェクトを作成
    PowerSeparateが完了
    [Boost.kicad_sch, Digital.kicad_sch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]
2025-07-20 MC2
    基板製造依頼～Power.LFO検証完了まで
    [DCInput.kicad_sch, Digital.kicad_sch, EGSeparate.kicad_pcb, EGSeparate.kicad_sch, LFOSeparate.kicad_pcb, LFOSeparate.kicad_sch, PowerSeparate.kicad_pcb, PowerSeparate.kicad_sch]
2025-07-20 LFOSeparate
    プログラムと回路のデバッグ後の修正を反映
    [LFOSeparate.kicad_pcb, LFOSeparate.kicad_sch]
2025-07-21 EGACC MC2
    プログラムと回路デバッグ後の修正を反映
    [EGSeparate.kicad_pcb]
2025-07-21 EGSeparater
    ~MCLRのリセット回路を追加
    [EGSeparate.kicad_sch]
2025-08-16 MC2
    ここまででFIXした内容
    [CVMixer.kicad_sch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]
2025-08-31 MC2
    デバッグ一通り完了して動作出来た
    [CVMixer.kicad_sch, VCA.kicad_sch, VCF.kicad_sch, VCF_VCA_Power.kicad_sch, VCO.kicad_sch, VCOSeparate.kicad_pcb, Waveform.kicad_sch, debugVCASeparate.kicad_pcb]
2025-09-07 MC2
    SynthBoard LFO+VCO とりあえずdebug状態を組み合わせた
    [LFO.kicad_sch, Power.kicad_sch, SynthBoard.kicad_pcb, SynthBoard.kicad_sch, VCO_3340.kicad_sch, VCO_waveform.kicad_sch]
2025-09-09 SynthBoard
    部品をSMDにしてVCO+LFOを配置した
    [LFO.kicad_sch, Power.kicad_sch, SynthBoard.kicad_pcb, SynthBoard.kicad_sch, VCO_3340.kicad_sch, VCO_waveform.kicad_sch]
2025-09-14 SynthBoard
    アナログのみ一通り設置 デジタルはなし
    [EG.kicad_sch, ResoVCA.kicad_sch, SynthBoard.kicad_pcb, SynthBoard.kicad_sch, VCA.kicad_sch, VCF.kicad_sch, VCF_CVMix.kicad_sch, VCO_3340.kicad_sch]
2025-09-14 SynthBorad
    デジタルも配置した
    [Connect.kicad_sch, EG.kicad_sch, LFO.kicad_sch, LFO_Digital.kicad_sch, Power.kicad_sch, ResoVCA.kicad_sch, SynthBoard.kicad_pcb, SynthBoard.kicad_sch]
2025-09-15 SynthBoard_Left
    部品配置まで SWの極性確認待ちとする
    [Connect.kicad_sch, EG.kicad_sch, LFO.kicad_sch, LFO_Digital.kicad_sch, Power.kicad_sch, ResoVCA.kicad_sch, SynthBoard.kicad_pcb, SynthBoard.kicad_sch]
2025-09-15 SynthBoard
    Rightを配置済
    Leftの配線ミスを修正
    [Connect.kicad_sch, EG.kicad_sch, LFO.kicad_sch, LFO_Digital.kicad_sch, Power.kicad_sch, ResoVCA.kicad_sch, SynthBoard.kicad_pcb, SynthBoard.kicad_sch]
2025-09-15 SynthBoard Right
    配線ミスを修正
    [Connect.kicad_sch, EG.kicad_sch, ResoVCA.kicad_sch, SynthBoard.kicad_pcb, VCA.kicad_sch, VCF_CVMix.kicad_sch]
2025-09-21 SynthBoard_Left
    JLCPCBでBasic部品に置き換えた
    [LFO.kicad_sch, LFO_Digital.kicad_sch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]
2025-09-21 SynthBoard Right
    Basic部品で更新まで
    [EG.kicad_sch, ResoVCA.kicad_sch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]
2025-10-02 EGACC_MC2
    対数カーブの最大値(711)に合わせて修正
2025-10-04 EGACC_MC2
    通常時の対数カーブの開始位置が間違ってたので修正
    ADRの時間指定が間違ってたので修正
    アクセントの計算が間違ってたので修正
    一先ず仕様は満たしたはず
    [main.c]
2025-10-05 LFO MC2
    Delay時間の指定ミスを修正
    一通り仕様を満たせるように修正完了
    [main.c]
2026-02-22 MC2
    まとめて登録
    [Connect.kicad_sch, EG.kicad_sch, EGBoard.kicad_pcb, EGBoard.kicad_sch, EG_POT.kicad_sch, LFO.kicad_sch, LFO_Digital.kicad_sch, LFO_POT.kicad_sch]
2026-02-22 MC2 Synth-Board Rotary
    V0.2
    U10:PIn4 -12Vに接続
    IC4:Pin12,13 デフォルト12でジャンパーパッドを追加
    R86:三角波をS2に未接続だったのを修正
    S2,S3:スイッチ動作を上下入れ替え
    VR9:右に2.5mm移動に伴い周辺回路の配置を変更
    冗長な配線を修正
    ビアを打った
    [EG_POT.kicad_sch, LFO_POT.kicad_sch, VCF.kicad_sch, VCO.kicad_sch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]
2026-03-14 PowerAndJack
    一通り作成済
    [DigitalPower.kicad_sch, Jack.kicad_sch, Power.kicad_sch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]
